Ji-Shawn/Bird-detection-classification-tracking/board/evidence/readme.md

# 当前版本上板证据

当前 SSD95 集成固件的整机实测日志尚待采集和核对。本目录保留采集要求；随包的离线测试、构建报告及模型资产哈希不能代替冷启动、实时采集、机械跟随和 SD 存图实测。本轮没有连接板卡或写入物理 SD 卡。

使用 [board/firmware/](../firmware/) 中的发布固件时，记录这套文件的指纹；使用自己重建的固件时，单独标识新版本。上板操作见[运行说明](../readme.md)，记录步骤见[复现第 9 节](../../reproduce.md)。

## 需要一起保存的记录

补交当前版本证据时，需要一起保存：

1. 测试时间、板卡型号、摄像头转接板版本、电源和 SD 卡信息；设备序列号可脱敏。
2. 实际使用的 BOOT、两核 ELF、bitstream、模型及输入文件的 SHA256。不要仅写“最新版”。
3. 运行命令、冷启动次数、每次运行时长、完整日志和异常记录。
4. 同一输入的实际输出与参考输出，包括比较口径、容差和未通过项；实际输出不能直接复制期望值。
5. 识别、实时预览、声音寻向、按键、SD 写图分别采用什么成功标准。没有编码器时，不把 PWM 指令变化写成实际机械速度。

运行时的临时日志通常位于 `build/out/board/`，默认不进入 Git。用于交付的结果应审核后选入本目录，以小写文件名保存，并在说明中注明它对应的固件版本和测试条件。
