Ji-Shawn/Bird-detection-classification-tracking/report/skill_extraction.md

# 技能包提炼过程与验证边界

**技能包提炼过程：从哪些失败或观察中总结、如何验证有效、边界如何确定。**

本技能包把历史排障记录整理为另一支团队可以使用的检查方法、提示词、记录模板和报告检查脚本。提炼的结果不是一份“所有项目必须照做”的硬件口诀：同一条历史经验必须先拆成观察、解释和适用条件，再决定保留、改写或不采纳。当前技能入口为 [skill/readme.md](../skill/readme.md)，使用入口为 [skill.md](../skill/zynq_pl_accel/skill.md)。

本次整理日期为 2026-11-03。报告审查脚本的 **16 项行为测试已实际通过**；随包历史实现报告重新检查后仍为 **`review_required`，30 项待审查**。这两项结果验证了已覆盖的报告检查行为，没有重新验证历史 HLS、RTL、DMA、计时器或板卡实验。本文不把旧文中的“数百次”“全部通过”“分钟级定位”等叙述改写为本轮统计结果。

当前随包证据包括用户补充材料、发布回执、发布版实现报告及最终检查结果。旧模型板测和独立 CRC 原型只保留方法回顾，不提供旧实验工程或重跑入口，也不计入当前系统验收。

## 1. 先说明材料来自哪里，以及能证明什么

### 1.1 历史材料与当前材料

| 代号 | 材料 | 本文如何使用 |
| --- | --- | --- |
| H1 | [历史技能提炼原文](../data/collaboration_sources/agent_skill_extraction.md)，原文件《技能包提炼过程.md》 | 保留当时提出的规则、失败描述和适用边界；逐条检查是否存在过度概括。引用章节号对应原文。 |
| H2 | [历史协作原文](../data/collaboration_sources/agent_collaboration.md)，原文件《大模型协作记录.md》 | 核对提示词摘要、模型动作、自我纠错和路线变化。原文自述协作期为 2026-09-24 至 09-27，并注明后续延续。 |
| H3 | [Word 补充材料提取正文](../data/collaboration_sources/docx_text.md)，P001–P066 | 与两份 Markdown 分别核对，不能视为同一稿。P040–P041 明确分层验证；P042 新增 CRC 原型的方法复用；P058–P060 明确反对过强结论，并区分历史 HLS 与现役实现。P 编号是提取定位符，不是 Word 页码。 |
| H4 | [历史交接摘录](../data/collaboration_sources/handover_excerpts.md)及[来源清单](../data/collaboration_sources/provenance.json) | 继续追查早期摘要是否遗漏撤回、特判和未完成项。摘录带原文件行号；交接中的叙述仍按叙述证据处理，不能自动升级为独立实测。 |
| A1 | [2026-10-27 timing 报告](../build/reports/pl_timing.rpt)、[CDC 报告](../build/reports/pl_cdc.rpt)及同目录 utilization、methodology、DRC | 直接核对报告里的数值、覆盖和告警；不能证明这些问题已经完成对象级处置。 |
| A2 | [协作报告](llm_collaboration.md)第 5 章的历史模型案例 | 回顾当时模型支线的比较口径；原运行日志不随最终包提供，按历史叙述使用，不能代替当前整机、冷启动或实时融合实测。 |
| A3 | [SSD95 发布修订回执](../build/receipts/release_validation.json)及[设计说明](../src/design.md) | 确认 0.95 是照片记录资格的 SSD 分数门槛，区别于准确率和追踪门槛。这是较晚需求，不属于 H1/H2 的早期实验。 |
| V1 | [技能自检回执](../sim/results/skill_selftest_20261103.json)和[完整自检输出](../sim/results/skill_selftest_20261103.txt) | 核对 Python 版本、命令、脚本哈希、16 项测试结果、零跳过以及未访问硬件的范围声明。 |
| V2 | [对历史报告的实际检查结果](../skill/zynq_pl_accel/examples/published_report_review.json) | 包含五份输入报告的路径、SHA256、元数据、指标和 30 项 findings；不是新的 Vivado 实现结果。 |
| V3 | [本轮完整离线检查回执](../sim/results/offline_checks_runner_new_full_20261103.json)、[37 项原生测试回执](../sim/results/native_gcc13_new_full_20261103.json) | 核对本轮已运行的交付检查和存图逻辑验证；其中确定性模型输入、模拟板卡接口、主机文件系统不能证明现场模型准确率或物理设备表现。 |

H1/H2 是当时的总结文档，包含对提示词和实验的转述，并非逐轮原始会话、全部波形和所有实验日志。两份文档出现相同数字，不能按两次独立实验累计。原文保留的错误结论属于历史记录，现行使用时以本报告的取舍和技能正文为准。

H3 的措辞更审慎，本文采纳其“现象—证据—措施—验证—边界”结构、分层验收和原型范围说明。H3 P063 中的黄金文件、DDR 地址、位宽和版本自动检查是完善方向；当前技能并未因此拥有这些全部自动化能力。H3 P066 所说“未修改原技能手册”描述该 Word 材料自身的范围；本轮则确实重写了比赛包中的技能，二者不能混为一份操作记录。

HLS 经验在本文作为早期开发历史出现。当前交付的神经网络计算引擎源码位于 `src/pl/capture_and_inference/hardware/`，参见[现役硬件导览](../src/pl/readme.md)；正式系统构建读取 `src/pl/structural/`。不能据历史 HLS 的循环限制断言当前全部部署模块采用 HLS，也不能将旧阶段号当作当前仓库必须恢复的根目录。

### 1.2 证据等级的使用方法

| 等级 | 定义 | 本文允许的表述 |
| --- | --- | --- |
| E0：待验证建议 | 只有新的检查方案或解释，尚无对应运行证据 | “应检查”“需要补测”，不写“已证明有效”。 |
| E1：历史叙述 | H1/H2 记载了实验和结论，本轮未获得足以复核该因果判断的完整原始材料 | “历史文档记载”，不写“本轮复现”。 |
| E2：可核对原始制品 | 可读取原始报告、日志或回执，并说明来源、对象和时间 | 可以复核其中明确记录的事实；不能扩大到未覆盖的版本、输入或环境。 |
| E3：本轮离线可重复验证 | 有本轮命令、输入身份、退出码和结果，可在对应环境再次执行 | 可报告所覆盖的软件、解析器或构建行为；必须写清是否涉及仿真、实现或硬件。 |
| E4：本轮对应对象的物理实测 | 当前待验版本与实际板卡、输入、输出和运行条件形成完整记录 | 本文的技能提炼与自检没有此项证据；不能用 E1/E2 历史材料补成 E4。 |

等级用于避免混淆来源，并非“等级越高就能证明任何事情”。例如，E3 的解析器测试不能解决 E2 报告里的 CDC 拓扑问题；带来源的历史板测日志仍然只支持其当时版本。

## 2. 18 项经验的选择、改写与不采纳

为便于定位，表内采用以下实际技能文件缩写：

- **C**：[历史案例与边界](../skill/zynq_pl_accel/references/casebook.md)。
- **N**：[数值与数据通路排障](../skill/zynq_pl_accel/references/numerical_debug.md)。
- **R**：[报告检查工作流](../skill/zynq_pl_accel/references/report_review.md)。
- **I**：[报告检查脚本](../skill/zynq_pl_accel/scripts/inspect_reports.py)；**S**：[行为测试脚本](../skill/zynq_pl_accel/scripts/test_inspect_reports.py)。
- **T**：[模型任务提示词](../skill/zynq_pl_accel/assets/task_prompt.md)；**V**：[验证记录模板](../skill/zynq_pl_accel/assets/validation_record.md)；**F**：[告警处置模板](../skill/zynq_pl_accel/assets/finding_disposition.md)。

表中的“落点”表示已经交付的通用方法所在文件，不表示这些文件包含完整的历史实验或自动检查了该行的一切风险。明确不采纳的专门断言没有另做成自动执行规则。

| 编号、历史来源与取舍 | 形成的现行规则 | 历史验证及等级 | 本轮实际核对或验证 | 适用范围与失效条件 | 实际技能落点 |
| --- | --- | --- | --- | --- | --- |
| 01 黄金对拍与零比较假绿。H1 §1、§3；C §4 保留旧手册的读取失败案例。**保留验证纪律，改写“任何情况只认逐字节零差异”。** | 先确认输入/参考成功读入、长度和比较数量正确，再按预先确定的数值契约比较。整数位精确目标可要求逐字节一致；其他目标必须明确误差规则，不能看到结果后放宽。 | H1 叙述单层及回归零差异；旧手册记载路径、文件读取和计数器问题，属 E1，不能仅凭总结确证所有历史比较器正确。 | 已交付 N 的读取、数量和参考独立性检查；V3 的比较器自检可核对。没有重跑旧 RTL 黄金文件读取故障。 | 适用于有独立参考的数值验证；参考与 actual 是同一份拷贝、比较数为零、参考来源不明时不得通过。 | N 步骤 1–3、6–7；T、V。 |
| 02 量化与延迟契约。H1 §2.3。**保留契约核对，不照搬舍入、零点或“201 拍”。** | 分别说明 dtype、布局、scale/zp、padding、舍入、饱和、尾块和流式延迟；用最小边界输入定位偏移。 | 原文记载 409600 B 对拍、逐层修正和特定 DW 延迟契约，属 E1；本文没有新增该组原始波形。 | 逐项纳入 N 和 V；本轮没有重做当时的 DW/PW 实验，也没有把这些常量用于报告解析器。 | 只适用于契约相同的算子和参考；更换量化域、stride、布局或流式结构必须重定契约。 | N 步骤 3、5–6；V。 |
| 03 “结构三定律”“流循环不许 PIPELINE”。H1 §2.2；H2 自我纠错 2、3。**撤回普遍禁令。** | 对当前工具与控制协议检查握手、状态保存、帧初始化和反压；纯计算或含流操作都不能仅凭类别宣布安全或不安全。检查实际综合行为，而非只看 pragma 文本。 | 原文先有流水失败，后有 B2' 通过，且承认环境污染归因；属 E1。它已足以要求收窄旧规则，但不足以推出所有流循环必失败。 | C §5 与技能入口明确删除统一禁用策略；N 给出单帧、连续帧、随机反压和尾块用例。未启动 HLS。 | 适用于流式模块排障；单帧恒定 TREADY 通过不能支持停顿/跨帧结论，换工具版本须重验。 | C §5；N 步骤 5、症状实验；T。 |
| 04 “cosim 绿就排除引擎”。H1 §2.4；H2 自我纠错 2；H3 P058。**不采纳二分判官。** | 记录仿真实际覆盖的输入、初始化、握手和运行长度；通过说明这些用例下的行为，既不能排除其他引擎问题，也不能直接归罪 harness。 | H1 已记录判官结论被推翻；H4 v2 原行 260–261 又撤回了板状态异常时的 S2MM 结构归因。均为 E1，不能选取早期 ILA 解释作已定根因。 | N 明确要求先验证测试平台有效性，再比对仿真与板卡条件；本轮无新的 cosim。 | 适用于仿真与实物不一致的排障；缺测试平台或覆盖信息时只能列待确认项。 | N“RTL 仿真全通过而板上不对”；V 的验证层级。 |
| 05 “WHS<0.05 ns 确定性错误”。H1 §2.4；H2 自我纠错 4。**不采纳固定物理失效阈值。** | 报告中的负余量/失败端点按实际结果判定；附加裕量策略须有任务依据。正余量不替代覆盖、环境与功能检查。 | “+0.017 ns 与错误同时出现”是 E1 的相关性叙述，缺少能排除其他变量的完整证据，不能写成已证明根因。 | A1 为 WHS=+0.005 ns；I 不按 0.05 判失败，S 明确测试该行为；报告仍因独立待审查项为 `review_required`。E2+E3。 | 适用于报告判读；不能反向声称该 +0.005 ns 构建已证实板上稳定，也不能跳过器件/接口约束审查。 | C §6；R 第二层；I、S。 |
| 06 “未约束表空就全绿”“单钟域免查 CDC”。H1 §2.4，结合 C §7 的旧手册表述。**改写。** | 从当前实现建立时钟和覆盖清单；区分内部未约束端点、I/O delay、例外与跨域对象，逐项处置。 | H1 记载早期未约束表为空，属 E1；A1 直接显示当前多时钟和实际 CDC 条目，属 E2。 | I 提取 no_input_delay=7、no_output_delay=11、partial_input_delay=4，以及 CDC Unsafe=1、Unknown=1；S 覆盖缺字段和 Unsafe。 | 当前实现报告有效时适用；只有摘要不能批准同步器拓扑或路径豁免。新时钟/接口/约束需新报告。 | C §1、§7；R；I、S、F。 |
| 07 “批处理自动连线绝无 stub”。H1 §2.1。**不采纳无风险保证。** | 不以 GUI 或脚本来源替代结果审查；对怀疑的连接检查当前生成 HDL、实际位宽、常量连接与设计预期。 | 原文记载手工断线生成常量连接、清理后捕获问题，属 E1；没有覆盖所有批处理路径的实验。 | 仅把“核对实际对象而非相信操作方式”纳入通用排障；未生成新 BD，也未声称当前工程存在 stub。 | 适用于连接或集成异常；缺生成产物时不能定位某条桩网，更不能只靠 GUI 截图放行。 | N 步骤 1、4；V；具体 stub 自动检查未交付。 |
| 08 DMA 寄存器与 64 位流。H1 §2.1、§2.5；H2 自我纠错 5。**保留实例核对，去掉通用常量与“永远”。** | 核对当前实例的存储器接口、流口位宽、长度、TLAST、状态和驱动契约；参数文本还须与生成连接一致。 | 原文记载只改 MM 宽后的补零及修正，属 E1；其中寄存器值和模式结论不能当作所有实例的通行证。 | C §8、N 步骤 4 提供检查清单；本轮没有写 DMA 寄存器或运行当时的 64 位改造。 | 适用于已明确模式、IP 版本和地址映射的实例；迁移 SG/simple、位宽或 IP 版本时须重新核对。 | C §8；N 步骤 4；V。 |
| 09 timer“永久禁区”与固定 tick。H1 §2.4、§2.5。**不采纳永久禁令，也不授予任意访问许可。** | 计时器的访问和标定按当前软件、配置及已验证入口处理；记录时钟、分频、计数回绕、测量区段和标定依据。 | 原文将寄存器写入与后续异常联系，称 POR 恢复；又记载本板 PMCCNTR 标定。属 E1，不能证明寄存器本身对所有用途永久有害，也不能把历史 tick 换算值直接用于新配置。 | C §6、§8 删除永久禁区迁移规则，N 要求计时方法和标定；本轮未访问计时器。 | 当前任务已明确计时配置时适用；换时钟、计数配置或计时范围后不能沿用旧换算值。 | C §6、§8；N“如何报告效果”；V。 |
| 10 JTAG 启动、DAP 恢复、收尾停 A9。H1 §2.1、§2.4。**保留状态管理，限制操作序列。** | 先识别当前固件/PS 初始化配对和运行状态，再使用当前验证入口；故障状态应先保存。文档不自动授权复位、下载或写外设。 | 原文声称固定顺序减少 wedge、某恢复链可救回，属 E1；没有本轮重复次数或通用成功率。 | C §8 和技能入口将具体步骤交还当前 board 工具；本轮技能脚本仅读文件，V1 明确未访问板卡。 | 仅对已确认的板卡、启动方式和脚本适用；SD/QSPI、不同软件或正在运行的应用不能照抄旧 JTAG 顺序。 | C §8；skill.md 执行约束；T、V。 |
| 11 “旧 bit 也错”与 DDR 数据污染。H2 排障 1–2、自我纠错 1；H1 §2.4。**保留判别实验，去掉“干净流程就可信”。** | 新旧版本对照前，同时确认输入、权重、缓存可见性、地址生命周期与初始化。失败位置随机不等于已经排除逻辑问题。 | 原文记载旧 bit 同错、DDR 字节异常、重灌后 62/62，通过情况属 E1；不能仅据摘要证明唯一根因。 | N 把“新旧固件都错”转成首个核对实验，V 记录环境；没有重新灌 DDR，也未复演历史事故。 | 适用于输入驻留内存或复用状态的流程；只有磁盘文件哈希不能证明运行时 DDR 内容相同。 | N 步骤 1、4、症状实验；C §8；V。 |
| 12 “ILA 只能作线索，不能作证据”。H1 §2.4；H2 自我纠错 2。**改写证据范围。** | 保存带 ILA 构建身份、探针、触发条件、波形及运行上下文；波形可作为该构建实际观测的证据。不能未经验证推到另一份不带 ILA 的构建。 | H1 记载“加 ILA 病就好”，H2 又引用 ILA 分析停收，均属 E1；二者说明需要记录观测条件，不支持否定所有 ILA 证据。 | 本轮没有采集波形；仅通过 V 的对象/环境/原始日志字段约束跨构建推断。不存在已交付的 ILA 自动诊断器。 | 能获得可追溯波形时适用；缺 bit/探针/触发信息时只能保留不完整观察，不能完成无 ILA 发布版验收。 | V；T；N 步骤 1、7。 |
| 13 “多维数组绝对不能推断存储”“1R1W 唯一安全”。H1 §2.5；H2 自我纠错 6。**不采纳语言级绝对结论。** | 对当前数组写法、访问端口、同步方式和工具设置做小规模综合对照，检查实际推断与资源；不只根据维数定论。 | 704K/1037/22K LUT 目前为两份摘要的 E1 叙述，未附对应原始综合报告。H4 v3 原行 91–94 对 339 DSP 的早期归因另有修正，不能沿用原说法。 | I 能读取当前完整顶层资源并检查显式预算，但没有综合任何数组变体；预算/顶层测试属 E3，不证明存储推断规则。 | 适用于资源异常定位；换访问模式、器件或工具后需重新综合。预算通过不等于 RAM 结构和功能正确。 | R 第二层；I 的显式预算；V 的单变量对照。 |
| 14 旧 IP、错误路径与“本机能跑”。H1 §2.2 export 陈旧产物；C §2–3。**保留身份与迁移检查，不照抄删除目录命令。** | 记录来源与输出身份，确认构建消费的是预期文件；从干净导出目录执行声明的检查，并记录编译器版本。 | H1 记载测到旧 IP，属 E1；C 记载 2026-11-02 缺协议向量/旧路径和 GCC 声明差异发现。 | V3 可核对当前修复后的检查；技能固定报告测试新增 SHA256 条件，复制到其他项目不会强套本工程资源数字。没有重新运行历史 HLS 导出。 | 适用于重构、打包、升级工具；只有时间戳或开发目录成功不够。危险清理操作须先确认具体对象。 | C §2–3；N 步骤 1；S 的发布样本身份判断；V。 |
| 15 “62/62 是唯一门禁”。H1 §3；H2 §3。**不采纳固定数量与唯一门禁。** | 根据任务分别列功能、数值、资源/时序、接口、启动与物理运行标准；历史 62 项仅证明其当时定义的用例。top1 相同与全输出相同必须分开。 | H4 v3 原行 73–74 记载 L24 允许 1 字节 tie；v5 原行 544 明示跳过 stem 和该特例。H1/H2 的“零差异”不能覆盖这些限定。A2 的非零差异及 SSD 比较仅作历史案例叙述，不是当前可复跑结果。 | V1 的 16 项与 V3 的原生/主机/比较器检查分开计数和解释；没有把离线通过作为整机发布签核。 | 适用于所有验收记录；测试数量不说明覆盖充分，跳过或零比较不能充成功项，特判须披露并说明依据。 | skill.md 证据层级；N；R 第四层；V。 |
| 16 固定“FSM 税”、性能预估与跨模型复用。H1 §2.5；H2 性能 7–10、工程组织 17–18。**保留实测驱动决策，拒绝迁移固定速度。** | 先记录测量区段、输入、预热、次数、统计和标定；预估写预估。结构相似或为复用而设计，不等于当前实现已经复用。 | ~17 拍/拍、~2.6 拍/拍、338→40–70 ms 等来自 E1 观察或预估。H2 本身曾明确否定“当前已复用”。A2 仅回顾特定历史分段计时，按 E1 使用。 | N、T、V 要求性能定义；本轮没有测新的时延、吞吐或复用效果，不将历史分段计时写成端到端帧率。 | 同一计时定义和环境下才可比较；模型、时钟、输入、传输或统计方法变更须重新标注。 | N“如何报告效果”；T 性能示例；V。 |
| 17 “95% 分数就是 95% 准确率”。来源为较晚的 A3，而非 H1/H2。**明确不采纳。** | 将判定门槛、单次模型分数、数据集准确率和物理表现分别报告；拍照资格以对应生产逻辑为准。 | A3 记载 SSD 分数≥0.95、追踪分数>0.5，且明示未板测，属 E2；不是准确率测量。 | V3 的 37 项原生测试含 5 项 FatFs 集成，证明给定确定性输入下的已测规则与写入流程，未使用标注测试集测准确率。 | 适用于模型结果和门槛展示；固定参考样本通过、高分或 top1 一致都不能推导总体准确率。 | N 使用前提；R 第四层；V 的指标与结论范围。 |
| 18 报告检查器也会假绿。来源为本轮独立审阅，见第 4 节。**新增并实际验证。** | 缺证据与未知格式返回 `incomplete`；表内不能只挑能识别的行。成功用例、破坏用例、真实样本与迁移用例分别验证。 | 无对应早期硬件实验；本轮先观察到真实解析缺陷，再形成规则，不伪装为历史经验。 | 合法 Info 后附未知 `Critical Warning` 原被忽略；修复后独立反例退出 3，新增 1 项含 3 个子例；16 项全通过，真实示例仍 30 项且 JSON 一致。E3。 | 仅对已支持的英文摘要格式；未知版本、空 CDC 摘要和未覆盖格式仍需人工适配，不自动放行。 | I、S；R 已验证效果；skill/readme.md 状态表。 |

## 3. 关键案例：如何把一次事故变成有边界的方法

### 3.1 流水失败：先撤回错误归因，再形成验证流程

H2 同时保留了“流水化后挂起”和后来的 B2' 通过记录。这是有价值的自我纠错材料，因为它没有把失败历史删掉。但“纯计算循环可流水、流操作不可流水”仍然超出这些有限实验所能证明的范围：原文没有给出所有流循环结构、初始化方式、连续帧和反压条件的穷举证据。本文因此没有把更窄的绝对禁令当作最后答案。

还需继续追到 H4：v2 原行 253–259 曾根据 ILA 将 S2MM 永久停收解释为结构问题，但原行 260–261 明确说明这些观测发生在板状态异常期，并撤回了当时归因。本文保留“观察到停收”和“后来撤回解释”两部分，不将前者包装为本轮已经确认的 DMA 或流流水根因；其后续“边际时序”解释也仍按第 3.2 节的证据边界处理。

提炼后的任务从“把 PIPELINE 都删掉”改成“明确一次握手接受了什么、哪些状态随之推进、停顿和帧切换如何保持契约”。对应的验证设计是单帧、连续帧、随机反压和末块用例，分别记录比较数量、次序和数值。它们是后续硬件任务需要执行的方案，不是本次已经执行的实验。方法已进入 N，旧错误归因仍保留在 H1/H2 和 C §5，便于后来者看到边界如何形成。

同理，原文“失败位置随机漂移，所以不是结构性 bug”的推断也应收窄。随机现象可以提高环境、状态或输入问题的调查优先级，不能仅凭随机性排除逻辑错误。合适的结果是一个区分假设的实验，而不是立刻确定唯一根因。

### 3.2 WHS=+0.017 ns：将因果结论降回待验证假设

H2 自我纠错 4 将确定性错误归因为边际 hold，并进一步提出 0.05 ns 门槛。现有原文没有提供足以独立复核的完整配对构建、路径、约束、运行条件和控制变量记录。因此本文只保留“应调查时序及实现变化”的动机，不接受“已排除逻辑、一定由 hold 导致”的结论。

当前可读的 A1 报告给出了另一组事实：WNS=+0.128 ns、WHS=+0.005 ns，内部未约束端点为 0，但仍有 7 个 no_input_delay、11 个 no_output_delay 和 4 个 partial_input_delay；CDC 仍有 Unsafe/Unknown 项。由这些事实可以得出“摘要数值为正，覆盖与跨域仍待审查”，不能得出“硬件一定错”，也不能得出“整机已经稳健”。

这一修正已经落成可运行反例：S 中 `test_positive_small_hold_is_not_an_invented_failure` 使用人工最小摘要，确认 +0.005 ns 不会仅因旧经验阈值被判失败；`test_positive_wns_does_not_hide_missing_constraints` 确认正 WNS 不掩盖缺失输入约束。人工摘要用于验证软件判定，A1 用于说明真实待办，两者不混用。

### 3.3 ILA、cosim 与数组推断：工具结果要绑定具体对象

三类旧结论的共同问题是把某个工具结果推广到工具本身：cosim 通过就排除引擎、加 ILA 后行为变化就否定 ILA 证据、某组数组推断失败就否定所有多维数组。这些结论均不进入现行技能的自动执行规则。

可复用的方法是绑定对象。仿真结果绑定测试平台和覆盖输入；ILA 波形绑定实际下载的带探针构建、触发和运行条件；综合结果绑定具体写法、访问模式、器件和工具设置。随后用对照实验判断差异。本次没有补做这三类硬件实验，所以其工程效果仍属于 E1 的历史记载，现行交付是 T/V 中要求记录对象、条件、原始输出及反例的方法。

### 3.4 62/62、top1 和 95%：三个数字回答不同问题

“62/62”描述一组历史测试的数量及其结果；“top1=11”描述一个输入的最高分索引；“0.95”是照片记录逻辑使用的 SSD 分数门槛。这些数字不能相互替代。

H4 v3 原行 73–74 披露 L24 存在 1 字节 tie，并由当时程序作 `bad<=1` 特判；v5 原行 544 又明确 62/62 沿用包含“跳过 stem”和该舍入特例的历史判定。这类结果应表述为“按当时判据通过”，不能重新整理成“所有层都执行、所有字节零差异”。本报告没有审定该特判适用于当前所有模型，迁移时必须重新定义并验证。

例如，A2 回顾的旧音频实验同时出现相同的 top1 和非零的逐字节比较差异。它用于说明两类判据的区别，旧日志不随最终包提供，不能把这个历史案例当作当前模型的数值验收。实际使用时，应保存完整输出及比较程序的判据，而不是只摘取分类索引。

SSD95 则是生产规则验证：当前 37 项原生测试包含阈值边界、资格状态和文件写入相关场景，其中 5 项执行 FatFs 集成。回执明确是确定性输入且未访问物理板卡；它们不能报告鸟类识别准确率。要回答准确率，需要另行定义有标签的评估数据、统计口径和真实评估结果；本文没有这份新增实测。

### 3.5 资源异常：检查后续更正，不能停在第一份总结

H2 性能主线第 10 项保留了 339 DSP 超编和共享 MAC 池的阶段性记录。H4 v2 原行 223–226 曾把额外 DSP 归因于组合加法链；v3 原行 91–94 改为记录操作数被扩为 32 位、每个相应乘法使用两个 DSP48，并记载窄位宽共享池后为 DSP 35、LUT 23K、BRAM 50。本文以此说明归因发生过变化，不将早期解释写入最终规则。

这些资源数字仍来自交接叙述，本轮没有重新获得并运行那几套原始综合对照。704K/1037/22K LUT 的数组案例也不能因为出现在 H1 和 H2 两处就变成独立复核。可迁移的规则是先检查实际操作数位宽、访问模式和综合映射，再设计对照；“多维数组不能推断”“整字 1R1W 是唯一安全形态”均不作为通用结论。

### 3.6 用户材料中的 CRC 方法迁移案例

[H3 的 P042](../data/collaboration_sources/docx_text.md)记载：后续 CRC 原型复用了黄金数据对拍、随机反压和独立资源评估方法，完成 3042 个数据包校验。本文按 **E1 历史叙述**引用这项材料；3042 是供稿中的包数，不是本轮仿真次数、视频帧数或板卡运行次数。最终包不包含该独立原型的实验工程、日志或向量重建入口，因此不把它列作当前随包可重跑的 E2/E3 实证。

这个案例保留的价值是说明“方法可以跨模块迁移”，而不是把原工程的参数和结论直接搬到新模块。结合 H3 P040–P041，可以形成下列后续验证要求：

| 可迁移的方法 | 新模块使用时需要补齐的验证 |
| --- | --- |
| 黄金数据对拍 | 说明参考算法、输入身份与比较范围，保留错误数及不匹配位置；不能以被测输出自行生成期望值 |
| 随机反压 | 检查停顿期间数据和状态是否保持，记录握手接受数量与结束条件；持续就绪场景不能代替反压测试 |
| 独立资源评估 | 将原型资源与整机接口、缓存、跨域及控制开销分别核算；综合通过不能代替完整实现和板测 |
| 分层验收 | 软件参考、RTL 仿真、综合、时序和物理运行分别出结论；某一层通过不补足其他层的缺项 |

这些是从供稿提炼的使用要求，不是对该 CRC 原型新增的测试结果。本轮没有把它集成到当前系统，也没有据此确认网络稳定性、帧率或板上性能。当前可直接执行、具有最终回执的技能验证是下一节的报告检查器与反例测试。

## 4. 本轮技能自身的验证：从 15 项通过到发现漏行

### 4.1 第一轮通过并不意味着检查器没有缺陷

最初的报告检查器已有 15 项测试，包括正余量、负余量、缺报告、缺覆盖、截断、非有限值、零检查端点、资源预算、设计名混用、CDC Unsafe、退出码和真实报告等情况。独立审阅随后构造了更具体的反例：同一 CDC 表先放一行合法 Info，再附一行不支持的严重级别。

```text
Info  clk_a  clk_b  Safely Timed  None  1  1  0  0  0
Critical Warning  clk_a  clk_b  User Ignored  False Path  1  0  1  0  0
```

旧实现只选择以已知 `Critical`、`Warning`、`Info` 加连续空格开头的行。第二行的 `Critical Warning` 没有命中这个筛选条件，整行被跳过；第一行又足以满足“至少解析到一行”。于是存在问题的输入得到 `screen_pass`。这个缺陷说明，“已经有反例测试”仍不等于“所有假绿路径已覆盖”。

### 4.2 修复并验证没有改变原有真实结果

修复后的 I 先匹配完整 CDC 表头，再读取数据区域；空行和分隔线可以略过，其余行必须符合已支持的列结构、严重级别和数字格式。任何未知行均产生带行号的 `incomplete`，不再通过“只读认识的行”得到绿色结论。对未知 `Critical Warning` 返回未完成，而不是擅自映射为另一个已支持严重级别。

新增的 `test_unknown_cdc_row_after_valid_info_is_incomplete` 含三个子例：未知组合严重级别、带缩进的未知严重级别和截断数据行。三个子例均在一行合法 Info 后追加异常，检查状态为 `incomplete`、退出码为 3、CDC 指标未被当作完整结果保留，并检查有明确 CDC 错误。它是 **1 个 unittest 测试方法、3 个子例**，因此总计为 **16 项**，不把子例混算为 18 项。

独立构造的原反例也用修复后脚本重新执行，结果为 `incomplete`，退出码 3，错误为 `Unsupported CDC row at line 8`。该次临时输出仅用于现场定位；持久交付的回归入口是 S 中的上述测试，不能依赖临时目录才能重现。

随后对 A1 的五份真实历史报告重新检查，输出与 V2 的 JSON 完全一致，仍为 `review_required`、30 项 findings。这个回归证明该修复保留了已知真实样本的原有提取结果；它没有关闭这 30 项审查任务。

### 4.3 迁移到另一项目时，不把旧工程资源数当成门槛

独立审阅还指出：如果另一支团队复制技能，目标项目也有 `build/reports/`，固定样本测试不应强制新项目等于 LUT 43722、DSP 164。当前 S 会先根据 V2 记录的各报告 SHA256 识别是否是原始发布样本。缺失或身份不同则明确跳过该固定样本断言，通用人工反例继续运行；新项目的报告应另用 I 审查。

这里“跳过”不是新项目通过，也不是本项目回归通过。当前原项目的 V1 记录为 16 项、0 跳过；迁移项目若跳过固定样本，测试输出必须如实保留 skip，不能把原项目数字用于新项目宣传。

### 4.4 可复制的验证命令与已归档结果

在仓库根目录、已安装 Python 的终端执行：

```powershell
python -B -X utf8 skill/zynq_pl_accel/scripts/test_inspect_reports.py
python -B -X utf8 skill/zynq_pl_accel/scripts/inspect_reports.py --reports build/reports --prefix pl_ --output build/out/skill_review.json
```

若按根目录复现文档创建了虚拟环境，可把命令开头的 `python` 替换为 `.\.venv\Scripts\python.exe`。第一条预期为 16 项测试通过、退出码 0；第二条对当前随包历史报告预期为 `review_required`、30 项、退出码 2。后者表示保留人工审查事项，并非要求使用者删除告警后再试。

V1 实际记录 Python 3.12.5、16 项、0 跳过、返回码 0，并保存 I/S 的 SHA256。时间为 UTC 2026-11-02 17:19，对应北京时间 2026-11-03 01:19；文件名中的日期按本地整理日期理解。回执同时明确 `board_accessed=false`、`physical_sd_card_accessed=false`、`vivado_started=false`。本报告引用这一回执，不另造硬件测试次数。

## 5. 提炼生命周期：如何让下一次反例进入技能

| 阶段 | 具体工作与产物 | 进入下一阶段的条件 |
| --- | --- | --- |
| 1. 收集 | 保存原失败输入、实际输出、命令、版本和操作者记录；原总结只作来源索引 | 能区分原始观察与作者解释；缺项先标明。 |
| 2. 拆分 | 将一句结论拆为“看到什么、怀疑什么、已经排除什么、还缺什么” | 不再用通过字样、单次 top1 或数值阈值代替因果证据。 |
| 3. 分级 | 标 E0–E4，标日期和对象；相同摘要不重复计作独立实验 | 每个声称的效果都能指到相应材料；不足的结论降级。 |
| 4. 选择 | 保留有用观察；改写可迁移方法；不采纳没有依据的普遍禁令 | 规则包含前提、成功判据、失效条件，不迁移未确认常量。 |
| 5. 最小验证 | 先跑原失败用例，再加最接近的通过例与破坏例；改变一个关键因素 | 缺文件、零比较、未知格式和错误值能按预期失败，不因放宽门槛获得通过。 |
| 6. 固化 | 简短入口放 skill.md；步骤放 references；重复机械工作进 scripts；记录结构进 assets | 新团队不依赖原开发机私有路径、未随包脚本或旧会话才能开始。 |
| 7. 独立审阅 | 让未参与实现的人按文档使用，尝试未知输入和新目录 | 实际反馈进入缺陷记录。本轮未知 CDC 行与固定样本迁移问题来自此环节。 |
| 8. 发布与再修订 | 更新测试、示例、文档和回执，保留旧误判及反例，不篡改旧实验日期 | 已知样本回归一致；新规则的边界和未覆盖项公开。发现新反例后回到第 2 阶段。 |

这种生命周期的有效性以实际缺陷闭环评价。本轮可以证明的是：独立审阅发现了一条原测试遗漏的假绿路径，修复后反例失败、已知样本不变、测试和说明同步更新。至于“节省几小时”“陌生团队必然一次成功”，目前没有对照记录或独立团队统计，不给出量化收益。

## 6. 当前交付的可复用能力与未测边界

已经可以直接使用的部分包括：以五份报告为输入的确定性摘要检查；有状态和退出码的结果 JSON；包含破坏输入的自检；数值排障检查顺序；给模型的具体任务模板；实验和告警的记录模板。这些文件不依赖安装某个智能体，普通读者也能按 [复现文档](../reproduce.md) 使用。文件保持小写英文；如果代理框架要求大写技能入口，只在仓库外的个人副本适配名称，不改变比赛包命名规则。

仍需明确保留以下边界：

1. **未知报告格式不放行。** 当前解析器主要验证随包英文 Vivado 2023.2 摘要。其他语言、版本、选项或没有 crossing 行的 CDC 摘要需要适配；`incomplete` 不能当作零问题。
2. **摘要无法证明来源完全配套。** 设计名一致和哈希稳定不等于五份报告必然来自同一 checkpoint。还需构建来源、源码、约束、bit/ELF 和实验记录配对。
3. **报告待办没有被模板关闭。** Unsafe、Unknown、I/O delay、方法学和 DRC 条目需要对象级证据；脚本没有全局忽略告警开关，也不能批准豁免。
4. **未新增旧硬件案例的复测。** 本次没有重跑 HLS、cosim、DDR/DAP 故障、计时器标定、ILA、数组综合或历史 62 项板测。相关经验保留其 E1/E2 身份。
5. **离线通过不推出整机效果。** 没有新增当前版本物理冷启动、长期稳定性、传感器融合、机械运动、物理 SD 卡时延或现场模型准确率结论。
6. **模板效果仍需按任务积累。** T/V/F 规定如何记录事实，未预置 PASS，也没有证明任何模型仅凭提示词即可稳定完成全部硬件任务。
7. **复用数字需重新定条件。** 0.05 ns、95.72 ns/tick、201 拍、62 项、某组资源数和性能预测都不能当作新项目默认验收常量。规则应复用检查方法和证据结构。

新团队提交一个后续案例时，至少附上原失败、原始材料、对象版本、唯一关键改动、复跑命令、实际结果、反例和适用边界。证据不足的案例可以进入历史观察区，但不能因为写成技能文档就自动升级为已验证规律。
