Ji-Shawn/Bird-detection-classification-tracking/report/compliance_review.md

# 交付规范复核与整改记录

复核日期：2026-11-03。依据为用户提供的目录、工程包、技能包及评分要求截图。复核对象是本目录中的交付内容；运行时工具缓存、`.git`、虚拟环境及 `build/out` 不属于导出的交付包。

## 1. 对照规范的结论

| 要求 | 本包提供的内容 | 复核结论与边界 |
| --- | --- | --- |
| 固定顶层框架 | `src/sim/build/board/data/skill/report`，根目录两份导航文档 | 框架保持，内部按功能而非 Mxx 阶段组织；历史代号仅用于追溯 |
| 英文小写路径 | 全包相对路径检查、清单库存核对、清单导出 ZIP | 文件名小写英文、数字、下划线/连字符，扩展名点号；`readme.md` 按小写规则处理；SD 卡上的固件要求文件名另行说明 |
| 完整设计输入 | 实际 ARM 源码及生成器、BSP/静态库、RTL/ROM、精确 IP 配置、板级约束 | 双核重编译和 PL 完整实现已实际执行；外部 Vivado/Vitis 安装不随包分发；模型训练数据/完整训练流水线不在本交付范围 |
| 仿真或验证结果 | 存图/FatFs、协议/上位机、上板工具模拟、比较器自测和原始日志 | 具体通过项见 [离线回执](../sim/results/offline_checks_20261103.json)；这些不是本轮完整 RTL 功能仿真，也不是新整机板测 |
| 可复现构建脚本 | `build_firmware.py`、`build_boot.py`、`build/pl/build_pl.tcl` | ARM/FSBL/BOOT 和 PL 已从源码构建；成功策略已进入交付脚本；生成物不自动覆盖发布固件 |
| 综合/实现与资源、时钟报告 | 原发布报告、10 月 31 日历史重建、11 月 3 日新构建 | [本轮完整报告](../build/reports/rebuild_20261103/readme.md)有综合及布局布线结果；时序门槛通过，CDC/I/O/方法学处置未全部关闭 |
| 上板运行和实测对照 | 发布固件、写卡/连接入口、10 月 2 日真实历史模型证据及 222 行逐层比较 | 历史证据有原始指纹且保留误差；**当前 SSD95 集成版的日志待用户提供并核对，不能宣称当前整机验收已完成** |
| 可复用技能包 | 范围/用法/失效条件、提示词、实验与告警模板、报告审查脚本 | [技能入口](../skill/readme.md)可独立使用；[16 项解析/反例测试](../sim/results/skill_selftest_20261103.json)和独立试用已执行；缺失/未知报告不会假绿 |
| 新手复现文档 | [reproduce.md](../reproduce.md) | 从安装、路径、环境、测试到写卡/连接/源码构建，每节给成功判据；已在新目录解压并用新 Python 环境跑通离线步骤，见[迁移回执](../sim/results/relocation_20261103.json)；硬件接法仍需与实际匹配，不猜接线 |
| 大模型协作记录 | [llm_collaboration.md](llm_collaboration.md) | 人机分工、关键决策、失败与纠正、实际验证、复用沉淀均附证据；不是完整聊天原文或虚构效率统计 |

## 2. 本轮已修复的问题

1. **缺少测试输入**：恢复原 7 个协议向量并补充 2 个 CRC 正确的异常分片，修正测试路径和库存断言；保留来源与 SHA256。
2. **新编译器声明冲突**：统一两个函数定义与头文件中的数组参数声明，原生 GCC 8.1/13.1 均通过 37 项存图测试。
3. **测试等待竞态**：等待真实组帧状态后再设置短过期窗口，避免“报文已计数但尚未组帧”导致偶发失败；针对性连续 5 次回归。
4. **只跑一部分却误读为全部通过**：增加完整离线检查入口，显式开发跳过模式标记为 `pass_partial`；最终完整运行标记为 `pass`。
5. **工具路径与链接回执**：统一 ARM/Vivado 工具查找，支持环境变量；识别链接器 map 中 `LOAD linker stubs` 的合成记录，其他输入仍严格核对。两核、FSBL 和 BOOT 实际构建并逐输入留证。
6. **成功 PL 策略藏在缓存目录**：将历史成功的 Explore/AggressiveExplore 指令加入正式构建；新增综合报告输出；在普通 Tcl 中核对按键同步器端点。
7. **生成文件污染根目录**：让 IP 生成过程在输出工作区运行；包检查忽略明确的工具缓存，ZIP 按完整清单导出，另拒绝未登记交付文件。
8. **技能陈旧和假绿边界**：移除“单钟域免查 CDC”等过度概括；未知 CDC 行返回 `incomplete`；移植自测只对哈希一致的固定样本作固定资源断言。
9. **参考值没有实际值比较入口**：增加带输入哈希和独立原始证据要求的数值比较器，检查完整 logits/检测框、缺失项和非法值。观察模板留空，避免伪装成实测。
10. **新手命令不完整**：统一虚拟环境用法，明确环境变量作用范围，修正 PowerShell 5.1 空参数传递，补齐解压后重建环境、写卡回读和版本选择说明。

## 3. 尚未关闭的事实缺口

- 当前集成版本的冷启动、持续运行、实际摄像头/HDMI/音频、机械跟随和 SD 存图日志待核验。用户已说明有日志、稍后提供路径。接收后应记录文件指纹、时间、固件与输入身份、测试条件和失败项。
- 新 PL 时序为正不等于完成工程签核。CDC 中的 1 个 Unknown、1 个 Unsafe，I/O 延时覆盖及方法学告警仍需按端点分析。没有足够板级条件时，不通过添加任意延时或 false path 使报告表面通过。
- 包内三个固定样本尚无本轮完整独立 logits/检测框输出。旧历史输入不同，不能改名复用成当前对拍。比较器自身通过不关闭此项。
- 本轮新编译 ELF/BOOT/bit 没有混入 `board/firmware`，也没有被写卡或下载；它们的硬件配对与现场验证另需完成。当前发布镜像哈希保持不变。

因此，本次交付结论是：文档、技能、构建可复现性和离线验证已显著补齐，当前版本整机实测与完整工程签核仍有明确待办。不能仅以材料存在或测试数量替代功能正确性证明。
