Ji-Shawn/Bird-detection-classification-tracking/data/collaboration_sources/agent_collaboration.md

# 大模型协作记录:提示词、模型回答、自我纠错轨迹

> 项目:音视双模态鸟类识别系统(Zynq-7020 PL 加速,MobileNetV2 int8)
> 协作期:2026-09-24 ~ 09-27(后续 session 延续,另见 v5.0 交接)
> 角色分工:**用户** = 方向决策、板子/电源等物理操作、GUI 配置、评审;
> **大模型(Kimi Code)** = 实验设计、排障、代码编写(HLS/RTL/C/Tcl)、构建执行、文档沉淀。
> 基本协议:对黄金向量逐字节对拍是铁律;每个阶段有可复现检查点;失败原地记录不删除。

## 1. 关键提示词 → 模型回答/动作对照

### 1.1 排障主线

| # | 用户提示词 | 模型动作与产出 | 结果与证据 |
|---|---|---|---|
| 1 | "读 HANDOVER_vivado_v2.0.md,继续完成项目" | 读交接与 SKILL 手册,从 §5e 未决问题 1(多瓦片 PW 挂)接手;给 main.c 加诊断快照(锁定失败瓦片/阶段/DMA 寄存器),建带 DAP 自愈的快速驱动 | 发现失败位置/瓦片**随机漂移** → 判定非确定性;L02 单瓦片 ×5 出现"挂/全错/过"混合 → 不是多瓦片特有 |
| 2 | (同上 语境) | A/B 对照:09-22 已知好 bit(m54ila)跑同层 → **同样失败** → 转向环境嫌疑;抽查 DDR 发现单字节被改(数据腐烂) | **证伪"多瓦片 bug"**:全量重灌后旧 bit 62/62 全绿。真凶 = DDR 数据腐烂 + DAP wedge 伪装 |
| 3 | "可以修改当前策略" / "修改完成策略就执行" | 授权后决定:放弃逐案排查,把引擎像素阶段回退到保守融合结构(读写算一体、全顺序、无 PIPELINE) | **62/62 零差异 + 链式 top1=11 正确**,基线 1020ms |
| 4 | "继续排查 M5.5 问题" | 逐步恢复流水化(B2':仅 MAC 循环 II=1),先建 L02 判别实验,再做 100MHz vs 降频 25MHz 的边际时序判别开关(SLCR 改分频,免重出 bit) | B2' 62/62 全绿 @100MHz,**"流水即毒"被证伪**(此前失败全是板子劣化),提速至 464ms |
| 5 | "我重新配置了 PS 端外设配置,之前配错了" | 从 GUI journal 还原修改内容(ENET/QSPI/USB MIO 引脚),确认与 PL 数据通路无关;发现 `ps7_init.tcl` 自 09-20 起是旧版,重新导出 XSA 并同步 4 处 | 新配置下回归 62/62;用户修改不涉及此前的排障结论 |

### 1.2 性能优化主线

| # | 用户提示词 | 模型动作与产出 | 结果与证据 |
|---|---|---|---|
| 6 | "继续"(性能收口) | 64 位流加宽(HWC8):引擎/驱动/BD/main.c 成套改 | 发现并修复 **DMA 流口位宽是独立参数**(只改 MM 宽 → 引擎被静默补零)——查 system.v 线宽抓到;64 位版 62/62 + top1,**345.8ms** |
| 7 | "继续" | 瓶颈分解:逐层计时 → L03 占 17.8%;requant 挪入流水(perf2) | 仅 +2%(338ms) → **真瓶颈定位 = HLS 顺序循环每像素 ~400 拍 FSM 开销**,性能墙在语言层 |
| 8 | "为什么不用 HDL 语言写 DW 和 PW 卷积层" | 分析利弊:HLS 的税(FSM 开销/流水化毒性/不可读)vs 手写 RTL 的成本(契约风险/验证平移);给出"只重写两个数据通路、契约不变"的方案与预估(338→~40-70ms) | 用户拍板 |
| 9 | "开工" | 手写 PW RTL + xsim 对拍(全部 34 层)→ DW RTL(17 层)→ 双模式 wrapper | **PW 34/34、DW 17/17 全部零差异** |
| 10 | "继续" | 集成进 BD:连拆三雷(module ref 不许 .sv / 1Mbit 单变量上限 / 异步读大数组 mux 爆炸 704K LUT) | 确立"宽字整字访问 + 1R1W"存储纪律;LUT 降到 22K 达标,**剩 DSP 超编 339>220**(两核重复布局,需共享 MAC 池) |

### 1.3 工程组织类

| # | 用户提示词 | 模型动作与产出 |
|---|---|---|
| 11 | "将相关 md 和 skill 复制到工作目录" | 复制三本交接 + SKILL.md 到 D:\Xilinx\workspace,并说明"以仓库为准还是工作区为准"的双向同步建议 |
| 12 | "是否可以删除 LED/PLL/birds_detection" | 先查证(无引用、LED 936MB 几乎全是可重建构建产物、birds_detection 是空壳),给出分级删除建议,不擅动 |
| 13 | 三篇 FPGA 实战文链接 | 提炼:未约束路径检查(当场验证本工程干净)、ILA 改变布局的读数修正、HWC8 数据格式佐证、片上乒乓特征缓存方向 |
| 14 | 三个 GitHub 链接(装 MCP/skill) | 装 vivado-mcp / vitis_mcp / xilinx-suite;处理 mcp<2 依赖隔离(独立 venv);写入用户级 mcp.json 并冒烟验证 |
| 15 | "我要新开一个会话,写好交接文档,目标是尽可能不用 HLS,全部用 HDL" | 写 HANDOVER v3.0(全 HDL 路线、资产清单、DSP 卡点与方案、上板前自查清单),更新 AGENTS.md 索引并双向同步 |
| 16 | "将 AGENTS.md 等关键 md 转移到 D:\Xilinx\workspace" | 转移 + 加迁移说明头;skill 另存到 `.kimi-code/skills/`(自动扫描位) |
| 17 | "音频网络与视觉网络部署到 fpga 是否可以复用" | 读视觉网结构(SmallBirdCNN)后给出算子对照表:基建/引擎框架 100% 可复用,缺一个 STD 3×3(恰好音频 L00 也欠);指出检测器 SSDLite 骨干 MobileNetV3 同样是 PW/DW 为主 |
| 18 | "当前状态是否是复用的" | 如实否定:demo 三模型全在 PC(torch),视觉网连量化都没做;目前是"为复用而设计、实现上未复用" |
| 19 | "总结技能包的提炼过程"(设计报告) | 按"来源失败 → 规则 → 验证方式 → 边界"四维整理全部 21+ 条,落盘 `技能包提炼过程.md` |

## 2. 自我纠错轨迹(按时间序,含原始误判与翻盘证据)

**纠错 1:"多瓦片 PW 第 2 帧挂"——误判为引擎 bug,实为环境伪装**
- 初始假设(交接文档):引擎多瓦片帧重启缺陷。
- 纠错动作:诊断快照 → 失败位置随机漂移;单瓦片 L02 连跑 5 次出现"挂/全错/过"三种结局 → 排除结构性 bug;A/B 对照旧 bit 同样失败;**抽查 DDR 抓到单字节篡改**。
- 修正结论:非引擎问题 = DDR 数据腐烂 + DAP wedge。**经验:判案第一实验永远是"已知好 bit + 新灌数据"。**

**纠错 2:"装载循环 PIPELINE off 是元凶"——抓了真凶的替身**
- 证据链:撤除 PIPELINE off 后 HLS 自动流水化 6 循环(214-376),装回仍挂 → 自首条判断正确但非主因。
- ILA 波形:引擎寄存器全对、守协议背压,**S2MM 中途永久停收**(DMASR 无错) → 引擎是受害者。
- 好/坏引擎对照捕获:beat 稀疏模式相同 → 排除 beat 稀疏;最终靠**结构回退(保守融合)通过全部回归**。**经验:cosim 绿不等于上板能跑;流时序类 bug 只有 ILA 和上板能判。**

**纠错 3:"流水化循环有毒"——被板子劣化污染的错误归因**
- Step B/B2(流水化 MAC)挂 → 暂定"流水即毒"。
- 用户断电 POR 后重测:B2' **62/62 全绿 @100MHz** → 证伪。真实规则收窄为:**流操作不可入流水循环,纯计算循环可流水**。
- **经验:环境(板子健康度)本身是变量;劣化期的所有失败归因都要 POR 后复测。**

**纠错 4:"perf 版确定性错数据是逻辑 bug"——实为边际 hold 时序**
- 现象:全流水版不挂了,但同位置确定性错(maxd=255,L01 DW 也错——而 DW 源没动)。
- 排除逻辑后查构建:该版 **WHS=+0.017ns** → 判为边际保持时间问题,与逻辑无关。
- **经验:WHS <0.05ns 的构建不可信;先看时序报告再怀疑代码。**

**纠错 5:64 位化"改 MM 宽就够"——被静默补零打脸**
- 只设 `c_m_axi_*_data_width=64`,集成后引擎 TDATA 被自动补零(`{32{1'b0},...}`),HDL 自检照不到。
- 补设流口位宽参数后,检查 system.v 线宽 [63:0] 才放行。
- **经验:集成后必须查生成网表的实际线宽,不查会死得无声无息。**

**纠错 6:手写 RTL "异步读大数组无所谓"——704K LUT 学费**
- 组合块 72 个异步读口 → 读 mux 爆炸(超编 13 倍)。
- 独立综合三个变体对照:2D 数组(1037 LUT mux)/ 1D+distributed(RAMD64E ✓)/ 宽字整字访问(最终形态)。
- **经验:每拍整字读写、1R1W 是唯一安全形态;多维 unpacked 数组不推断存储。**

## 3. 智能体工作流设计(模型侧)

```
读交接 → 恢复现场(bit/ELF/板状态核验)→ TodoList 阶段化
→ 判别实验优先(最小可复现、单变量对照)→ 后台长任务(构建/回归并行)
→ 证据链写入交接(含被推翻结论的原文与反例)→ SKILL.md 沉淀通用规则
```

关键设计点:
- **黄金回归作为唯一门禁**:62 项零差异 + 链式 top1,任何中间结论以它为准;
- **对照纪律**:A/B bit、单瓦片 vs 多瓦片、100MHz vs 降频、带不带 ILA——每次只动一个变量;
- **长任务后台化**:Vivado/HLS 构建挂后台,期间做分析、写 TB、改文档,时间并轨;
- **诊断先行**:给 main.c 加诊断快照(失败时锁定瓦片/阶段/寄存器),再开始改任何东西;
- **反例保留**:被推翻的结论不删除,标注"已被 §5g 推翻"——技能的边界靠反例划出来;
- **交接即产品**:每次 session 结束更新 HANDOVER + SKILL + 备份锚点(ELF/bit/源),下一位可直接续跑。

## 4. 协作效率观察(给后来者)

1. **用户拍板节点精准**:"可以修改策略"出现在模型连撞三面墙之后,避免了继续在错误归因上空耗——方向级授权比逐条指令高效。
2. **物理操作不可替代**:POR、GUI 配置由用户完成,模型负责把"为什么、做完后跑什么验证"说清楚,衔接顺畅。
3. **模型的弱点也在暴露**:对寄存器级细节(AXI DMA 流口位宽、SLCR 分频字段)要靠试错补齐——用户评审过一遍的方案里仍有被工具"静默行为"打脸的情况,全部靠生成网表/ILA/对拍兜底才没酿成事故。
4. **文档是协作的复利**:SKILL.md 的每条规则都来自当日事故,后续同类问题(如 DAP wedge、数据腐烂)的定位时间从数小时降到分钟级。
