Ji-Shawn/Bird-detection-classification-tracking/data/collaboration_sources/docx_text.md

# 用户提供的 Word 补充材料正文提取

原文件保留在用户桌面。本页按 document.xml 的正文顺序提取全部非空段落，包括表格单元格文字；P 编号为本次提取定位符，不是原 Word 页码。本文属于来源材料，当前采纳与修正结论见上级报告。

**P001**

技能包的提炼过程

**P002**

鸟类声视识别与双轴云台追踪系统  设计报告补充材料

**P003**

整理日期  2026年11月3日

**P004**

本项目以 Zynq PL 加速开发实战手册为技能包的主要载体，将 AX7020 开发中的失败案例、修复方法和验证步骤整理为可复用知识。提炼过程强调证据与适用边界：已验证经验用于指导后续任务，特定环境下的判断不能直接推广为通用规律。

**P005**

一 从失败和观察中提取经验

**P006**

技能包最初围绕 M1 数据通路和 M5 算子开发阶段的排障形成，随后补充 M6 手写 RTL 阶段的经验。每条经验按“现象—排查证据—原因—修复措施—验证方法—适用范围”组织，避免只保留结论而丢失判断依据。

**P007**

失败或观察

**P008**

提炼出的规则

**P009**

验证方法

**P010**

仿真显示通过，但黄金文件未正确读入，未完成有效比较。

**P011**

先验证测试平台本身，不能只看 PASS 字样。

**P012**

检查文件打开、读取数量、未知值和实际比较次数。

**P013**

DMA 内存侧改为64位，流接口仍为32位。

**P014**

内存侧与流接口位宽必须分别核对。

**P015**

检查IP参数、生成HDL与实际数据通路。

**P016**

多层测试交替出错，最终发现权重与期望数据地址重叠。

**P017**

排查时同时检查测试程序和DDR地址布局。

**P018**

检查地址区间，重灌数据，用已知正确版本对照。

**P019**

持续就绪时通过，输出停顿后出现跳字。

**P020**

反压期间必须保持流水数据和控制状态。

**P021**

加入随机反压，检查输出稳定性、顺序和数量。

**P022**

修改RTL后，构建仍可能复用旧缓存。

**P023**

源码修改不等于新逻辑已进入bit。

**P024**

核对源码特征、网表、缓存产物与构建记录。

**P025**

时序报告看似通过，但可能存在未约束路径。

**P026**

时序验收必须包含约束覆盖检查。

**P027**

同时检查setup、hold和未约束内部端点。

**P028**

这些案例将排查范围从算法和RTL扩展到测试平台、接口配置、DDR内容、构建缓存和板上状态，减少因症状相似造成的错误归因。

**P029**

二 将调试经验转化为可执行流程

**P030**

技能提炼不仅记录问题，还要说明何时使用、需要哪些输入、按什么顺序检查，以及如何判定成功。项目将重复出现的工作整理为以下流程。

**P031**

数值验证流程

**P032**

准备黄金输入、权重、偏置和期望输出；核对量化零点、符号位、舍入与字节序；逐层比较结果，记录错误数量、最大偏差和首个错误位置。避免仅凭输出“看起来合理”判断正确。

**P033**

接口与集成检查流程

**P034**

核对AXI位宽、地址映射、传输长度和包尾标志，检查生成HDL中的异常常量连接。接口参数改变后，重新确认驱动寄存器偏移和数据布局，不能默认旧软件仍兼容。

**P035**

流水线验证流程

**P036**

覆盖连续输入、随机停顿、尾部不足一组、多帧连续运行和复位。对数据与控制信号进行同步检查，确认停顿恢复后不丢字、不重复、不乱序。

**P037**

构建追溯与故障恢复流程

**P038**

将关键源码、生成网表、bit、软件与测试报告关联。故障后按当前工程已验证的恢复脚本恢复环境，重新加载数据，再用已知正确基线对照。初始化顺序和外设配置不能由早期命令片段随意拼接。

**P039**

三 技能有效性的验证方法

**P040**

有效性首先体现在能否复现原故障。修复流水线丢字后，必须保留反压场景验证；不能只运行持续就绪的简单测试。其次，需要在相同输入和配置下比较修改前后结果，尽量避免同时改变多个因素。

**P041**

验证按层级推进：先确认软件模型和黄金数据，再检查RTL仿真、综合结构与资源，随后验收整机时序，最后进行重复板测。各层测试的结论不能相互替代，局部通过不等于端到端可靠。

**P042**

后续CRC原型复用了黄金数据对拍、随机反压和独立资源评估方法，完成3042个数据包校验。这是验证方法被再次使用的实例，但只支持原型层面的结论，不能替代整机集成、网络稳定性和帧率测试。

**P043**

四 适用边界的确定

**P044**

技能包应区分可迁移原则、平台配置和特定故障经验。迁移到新板卡、工具版本或模块时，先核对成立条件，再决定哪些条目可以直接复用。

**P045**

类型

**P046**

示例

**P047**

使用边界

**P048**

可迁移的验证原则

**P049**

黄金数据对拍、随机反压、版本追溯。

**P050**

可用于其他工程，但需要适配接口、数据格式和测试覆盖。

**P051**

平台相关规则

**P052**

AX7020的PS初始化、DDR、UART和DMA配置。

**P053**

更换板卡、工具版本或外设配置后重新核验。

**P054**

特定故障经验

**P055**

某种HLS循环结构异常，或特定时序余量下发生错误。

**P056**

保留工具版本、结构和实验条件，不推广为普遍定律。

**P057**

对历史表述进行再审查

**P058**

现有手册中“cosim通过就能证明RTL无辜”一类表述过强。更准确的结论是：已覆盖的仿真场景通过，但仍不能排除真实硬件中的时序、复位和接口问题。“禁止某类循环流水化”也应限定为当时工具版本及设计结构下的规避措施，而非HLS的通用禁令。

**P059**

区分历史探索与现役实现

**P060**

手册保留早期HLS探索经验，不代表当前部署模块全部采用HLS。报告中应分别说明历史开发路线和现役实现，避免把探索阶段的工具或限制误写成当前工程事实。

**P061**

五 提炼结果与后续完善方向

**P062**

目前已形成以SKILL.md为入口的项目实战手册，覆盖数据通路、数值契约、验证方法、资源优化及故障排查。它为大模型和开发人员提供共同的检查依据，使新任务能够优先复用已知经验，减少重复试错。

**P063**

后续可将仍依赖人工执行的条目转化为黄金文件有效性检查、DDR地址重叠检查、AXI位宽核对和构建版本校验脚本，并为经验条目补充适用版本、原始证据及失效条件。这些属于完善方向，不能视为已经全部自动化。

**P064**

技能包的价值不在于规则数量，而在于每条规则都有可追溯来源、可执行检查和明确边界。新实验否定原判断时，应修订经验，避免将阶段性结论固化为不可质疑的规则。

**P065**

材料依据

**P066**

项目文件：D:/Xilinx/workspace/skills/zynq-pl-accel/SKILL.md；本次对话中的故障排查、板测反馈与CRC原型验证记录。本文为经验总结，不代表整理日重新完成整机复测，也未修改原技能手册。
