Ji-Shawn/Bird-detection-classification-tracking/skill/zynq_pl_accel/assets/finding_disposition.md

# 告警或缺项处置模板

状态：未关闭。本模板不自动批准豁免。

| 字段 | 实际记录 |
| --- | --- |
| 规则/问题编号、严重性 | 待填写 |
| 原报告路径、SHA256、日期、工具版本 | 待填写 |
| 当前源码、实现、bit/ELF 对应关系 | 待填写 |
| 起点/终点、源/目的时钟、相关端口或模块 | 待填写 |
| 原始报告内容与可定位行号 | 待填写 |
| 对象级原因分析 | 待填写；只有汇总时写“证据不足” |
| 处置选择 | 修复 / 有依据的豁免 / 继续调查 |
| 修改内容或豁免依据 | 待填写 |
| 新报告/功能验证结果 | 未执行 |
| 剩余风险和失效条件 | 待填写 |
| 审核者与日期 | 待填写 |
| 最终状态 | 未关闭 |

关闭前检查：对象与版本一致；证据足以支持具体处置；没有通过删除告警、清空测试或统一放宽约束制造通过；涉及修改时已运行必要的回归；结论限定在实际验证范围内。
