Ji-Shawn/Bird-detection-classification-tracking/skill/zynq_pl_accel/references/casebook.md

# 案例与适用边界

本文件保留项目协作中能迁移的方法，同时纠正旧手册中把局部观察写成普遍规律的表述。“历史记录”表示原开发笔记记载的观察，本次没有凭该笔记补造原始日志，也没有把这些观察当作现役整机复测。

## 1. “时序全绿”与约束覆盖是两个问题

- **来源与已观察事实**：随包 `build/reports/pl_timing.rpt` 为 2026-10-27 的发布实现报告。WNS=0.128 ns、WHS=0.005 ns；no_input_delay=7、no_output_delay=11、partial_input_delay=4。`pl_cdc.rpt` 同时存在 Unsafe/Unknown 项。
- **适用场景**：报告摘要说约束满足，但需要判断签核范围。
- **方法**：先检查报告时间、设计和分析状态，再检查 coverage、CDC、methodology、DRC，保留对象级待办。运行报告检查脚本可机械提取这些字段。
- **成功判据**：所有检查对象、例外、待审查项有据可查；结论明确区分“摘要指标满足”和“问题已处置”。
- **失效边界**：没有实际路径/网表时不能仅凭汇总给出 CDC 根因或豁免。

## 2. 目录改名后，应用能启动但完整测试仍会失败

- **来源与已观察事实**：2026-11-02 干净导出审查中，上位机帮助入口可运行，但完整 pytest 结果为 376 项通过、1 项失败；`src/pc/tests/test_protocol.py` 仍从旧相对位置找协议黄金向量，所需向量也未随包提交。
- **适用场景**：重构目录、打包交付、把开发环境迁到新机器。
- **方法**：从实际提交内容导出到全新目录，安装声明的依赖，再执行完整受影响测试。同时核对测试数据文件和路径；只修路径而不补数据不会完成修复。
- **成功判据**：新目录中的目标测试通过，且没有借用原工作区中的未提交文件。
- **失效边界**：在开发目录已有缓存或数据时通过的结果，不能单独证明交付包自包含。
- **本轮修复结果**：以本包后续 `sim/results/` 中的运行记录为准；本条保留的是发现问题时的失败结果，不把它改写为一直通过。

## 3. 新编译器暴露的接口声明差异

- **来源与已观察事实**：2026-11-02 存图测试在 MinGW GCC 8.1 下通过；GCC 13.1 在 `-Werror` 下因 `ssd_fast.c` 中指针参数与头文件数组形参写法不一致而失败。
- **适用场景**：验证脚本声称支持一般 GCC，实际仅在一个旧版本运行过。
- **方法**：保存编译器版本和完整命令，统一声明与定义，再复跑原编译器和发现问题的编译器。不要为通过而直接移除全局 `-Werror`。
- **成功判据**：目标工具版本均可编译且测试通过；说明文件写出实际验证过的版本。
- **失效边界**：两个版本通过不等于所有平台、所有版本都得到支持。

## 4. 黄金读取失败造成“零比较通过”

- **历史来源**：整理前手册记录过字符串路径带前导 NUL、黄金文件打开失败、比较计数器未初始化等测试平台问题；原始完整实验不在本技能附件中，本轮不把旧通过次数作为验收证据。
- **适用场景**：RTL 仿真异常快速结束，或更换为明显错误输入仍显示通过。
- **方法**：文件打开失败立即失败；检查读入数量和已知样本；检查输出 X/Z；结束时要求比较数量等于预期。增加一组故意损坏的参考数据，确认比较器会失败。
- **成功判据**：有效输入按预期比较；无效或缺失输入明确失败。
- **失效边界**：比较器正确不等于待测算法正确，参考结果仍需独立来源。

## 5. 流水与反压必须按实际协议验证

- **历史来源**：旧手册曾把局部失败总结为“流操作不许进 PIPELINE 循环”，也记载了停顿时计数器冻结而数据管线继续推进导致跳字的观察。
- **现行修正**：不再采用统一禁用 PIPELINE 的规则。需要查看当前控制协议、状态保存、握手、初始化、工具版本及跨帧行为，用单帧、连续帧和随机反压分别验证。
- **成功判据**：每个已接收输入与应输出结果数量、次序和数值一致，跨帧无污染；必要资源/时序指标有相应报告。
- **失效边界**：只在恒定 TREADY 或单帧用例上通过，无法支持跨帧与停顿结论；HLS 工具升级后应重跑相关用例。

## 6. 经验阈值不能代替器件约束

- **历史来源**：旧手册出现“WHS<0.05 ns 会确定性出错”表述，以及某些特定构建的计时器偏差观察。
- **现行修正**：没有将该阈值作为自动失败条件。当前随包报告 WHS=0.005 ns，只能说明当前报告的 hold 摘要值为正；板卡是否稳健需要相应实验。计时器也需按当前配置标定。
- **成功判据**：阈值来自任务要求或明确的工程裕量策略，且记录其依据；性能数字附计时方法和测试条件。
- **失效边界**：不能把一次板卡异常与某个余量值的相关性写成所有设计的因果定律。

## 7. 单时钟案例不能直接套到音视频整机

- **历史来源**：旧手册的早期 DMA/算子案例采用简化时钟结构，后来仍沿用了“本工程单钟域，免查 CDC”。
- **现行证据**：本包 `build/reports/pl_clocks.tsv` 包含摄像头、音频和多路 HDMI 时钟。`pl_cdc.rpt` 列出实际跨域关系。
- **方法与成功判据**：从本次实现报告建立时钟关系表，并逐条审查跨域结构和对应约束。写明同步器、FIFO、握手或静态信号的证据。
- **失效边界**：端口名、注释或旧框图不能证明当前实现为单时钟。

## 8. 复位、地址和 DMA 参数只按当前实例使用

- **历史来源**：旧手册包含 DAP 卡死、DDR 邮箱污染、地址区间覆盖、DMA 长度和位宽不匹配等观察。
- **方法**：复用当前已验证的 `board/tools/` 入口；实验前列出固件配对关系、活动地址区间和硬件实例配置。异常后重新确认输入与权重实际内容，并保存错误状态。
- **成功判据**：按当前实例的数据宽度、长度、TLAST、超时与缓存契约完成指定实验，记录实际输出。
- **失效边界**：不得把案例中的地址、DMA 长度上限、具体复位/下载序列或“永远禁止某寄存器”的绝对说法迁移到未确认的新系统。手册本身不授权操作板卡。

## 尚需由实际任务提供的内容

新团队应提供自己的参考生成器、数据格式、工具版本、构建/上板权限、实测环境和验收阈值。本技能不再依赖旧文中未随包提供的 `scripts/extract_golden_layers_v1.0.py`；需要抽层时应先交付并验证真实的参考生成工具，缺少时将该验证项标为未完成。
