Ji-Shawn/Bird-detection-classification-tracking/build/reports/pl_clocks.tsv

av_system_i/clk_audio/inst/clk_in1 | 10.000 | 0.000 5.000 | 1 | clk_fpga_0
av_system_i/clk_hdmi/inst/clk_in1 | 10.000 | 0.000 5.000 | 1 | clk_fpga_0
cam_pclk | 11.904 | 0.000 5.952 | 0
clk_fpga_0 | 10.000 | 0.000 5.000 | 0
clk_out1_av_system_clk_audio_0 | 10.172 | 0.000 5.086 | 1 | av_system_i/clk_audio/inst/clk_in1
clk_out1_av_system_clk_hdmi_0_1 | 8.696 | 0.000 4.348 | 1 | av_system_i/clk_hdmi/inst/clk_in1
clk_out2_av_system_clk_hdmi_0_1 | 1.739 | 0.000 0.870 | 1 | av_system_i/clk_hdmi/inst/clk_in1
clk_out3_av_system_clk_hdmi_0_1 | 6.957 | 0.000 3.478 | 1 | av_system_i/clk_hdmi/inst/clk_in1
clkfbout_av_system_clk_audio_0 | 10.000 | 0.000 5.000 | 1 | av_system_i/clk_audio/inst/clk_in1
clkfbout_av_system_clk_hdmi_0_1 | 10.000 | 0.000 5.000 | 1 | av_system_i/clk_hdmi/inst/clk_in1
