Ji-Shawn/Bird-detection-classification-tracking/build/reports/pl_pins.tsv

DDR_addr[0] | INOUT | N2 | SSTL15
DDR_addr[10] | INOUT | F5 | SSTL15
DDR_addr[11] | INOUT | G4 | SSTL15
DDR_addr[12] | INOUT | E4 | SSTL15
DDR_addr[13] | INOUT | D4 | SSTL15
DDR_addr[14] | INOUT | F4 | SSTL15
DDR_addr[1] | INOUT | K2 | SSTL15
DDR_addr[2] | INOUT | M3 | SSTL15
DDR_addr[3] | INOUT | K3 | SSTL15
DDR_addr[4] | INOUT | M4 | SSTL15
DDR_addr[5] | INOUT | L1 | SSTL15
DDR_addr[6] | INOUT | L4 | SSTL15
DDR_addr[7] | INOUT | K4 | SSTL15
DDR_addr[8] | INOUT | K1 | SSTL15
DDR_addr[9] | INOUT | J4 | SSTL15
DDR_ba[0] | INOUT | L5 | SSTL15
DDR_ba[1] | INOUT | R4 | SSTL15
DDR_ba[2] | INOUT | J5 | SSTL15
DDR_cas_n | INOUT | P5 | SSTL15
DDR_ck_n | INOUT | M2 | DIFF_SSTL15
DDR_ck_p | INOUT | L2 | DIFF_SSTL15
DDR_cke | INOUT | N3 | SSTL15
DDR_cs_n | INOUT | N1 | SSTL15
DDR_dm[0] | INOUT | A1 | SSTL15_T_DCI
DDR_dm[1] | INOUT | F1 | SSTL15_T_DCI
DDR_dm[2] | INOUT | T1 | SSTL15_T_DCI
DDR_dm[3] | INOUT | Y1 | SSTL15_T_DCI
DDR_dq[0] | INOUT | C3 | SSTL15_T_DCI
DDR_dq[10] | INOUT | G3 | SSTL15_T_DCI
DDR_dq[11] | INOUT | H3 | SSTL15_T_DCI
DDR_dq[12] | INOUT | J3 | SSTL15_T_DCI
DDR_dq[13] | INOUT | H2 | SSTL15_T_DCI
DDR_dq[14] | INOUT | H1 | SSTL15_T_DCI
DDR_dq[15] | INOUT | J1 | SSTL15_T_DCI
DDR_dq[16] | INOUT | P1 | SSTL15_T_DCI
DDR_dq[17] | INOUT | P3 | SSTL15_T_DCI
DDR_dq[18] | INOUT | R3 | SSTL15_T_DCI
DDR_dq[19] | INOUT | R1 | SSTL15_T_DCI
DDR_dq[1] | INOUT | B3 | SSTL15_T_DCI
DDR_dq[20] | INOUT | T4 | SSTL15_T_DCI
DDR_dq[21] | INOUT | U4 | SSTL15_T_DCI
DDR_dq[22] | INOUT | U2 | SSTL15_T_DCI
DDR_dq[23] | INOUT | U3 | SSTL15_T_DCI
DDR_dq[24] | INOUT | V1 | SSTL15_T_DCI
DDR_dq[25] | INOUT | Y3 | SSTL15_T_DCI
DDR_dq[26] | INOUT | W1 | SSTL15_T_DCI
DDR_dq[27] | INOUT | Y4 | SSTL15_T_DCI
DDR_dq[28] | INOUT | Y2 | SSTL15_T_DCI
DDR_dq[29] | INOUT | W3 | SSTL15_T_DCI
DDR_dq[2] | INOUT | A2 | SSTL15_T_DCI
DDR_dq[30] | INOUT | V2 | SSTL15_T_DCI
DDR_dq[31] | INOUT | V3 | SSTL15_T_DCI
DDR_dq[3] | INOUT | A4 | SSTL15_T_DCI
DDR_dq[4] | INOUT | D3 | SSTL15_T_DCI
DDR_dq[5] | INOUT | D1 | SSTL15_T_DCI
DDR_dq[6] | INOUT | C1 | SSTL15_T_DCI
DDR_dq[7] | INOUT | E1 | SSTL15_T_DCI
DDR_dq[8] | INOUT | E2 | SSTL15_T_DCI
DDR_dq[9] | INOUT | E3 | SSTL15_T_DCI
DDR_dqs_n[0] | INOUT | B2 | DIFF_SSTL15_T_DCI
DDR_dqs_n[1] | INOUT | F2 | DIFF_SSTL15_T_DCI
DDR_dqs_n[2] | INOUT | T2 | DIFF_SSTL15_T_DCI
DDR_dqs_n[3] | INOUT | W4 | DIFF_SSTL15_T_DCI
DDR_dqs_p[0] | INOUT | C2 | DIFF_SSTL15_T_DCI
DDR_dqs_p[1] | INOUT | G2 | DIFF_SSTL15_T_DCI
DDR_dqs_p[2] | INOUT | R2 | DIFF_SSTL15_T_DCI
DDR_dqs_p[3] | INOUT | W5 | DIFF_SSTL15_T_DCI
DDR_odt | INOUT | N5 | SSTL15
DDR_ras_n | INOUT | P4 | SSTL15
DDR_reset_n | INOUT | B4 | SSTL15
DDR_we_n | INOUT | M5 | SSTL15
FIXED_IO_ddr_vrn | INOUT | G5 | SSTL15_T_DCI
FIXED_IO_ddr_vrp | INOUT | H5 | SSTL15_T_DCI
FIXED_IO_mio[0] | INOUT | E6 | LVCMOS33
FIXED_IO_mio[10] | INOUT | E9 | LVCMOS33
FIXED_IO_mio[11] | INOUT | C6 | LVCMOS33
FIXED_IO_mio[12] | INOUT | D9 | LVCMOS33
FIXED_IO_mio[13] | INOUT | E8 | LVCMOS33
FIXED_IO_mio[14] | INOUT | C5 | LVCMOS33
FIXED_IO_mio[15] | INOUT | C8 | LVCMOS33
FIXED_IO_mio[16] | INOUT | A19 | HSTL_I_18
FIXED_IO_mio[17] | INOUT | E14 | HSTL_I_18
FIXED_IO_mio[18] | INOUT | B18 | HSTL_I_18
FIXED_IO_mio[19] | INOUT | D10 | HSTL_I_18
FIXED_IO_mio[1] | INOUT | A7 | LVCMOS33
FIXED_IO_mio[20] | INOUT | A17 | HSTL_I_18
FIXED_IO_mio[21] | INOUT | F14 | HSTL_I_18
FIXED_IO_mio[22] | INOUT | B17 | HSTL_I_18
FIXED_IO_mio[23] | INOUT | D11 | HSTL_I_18
FIXED_IO_mio[24] | INOUT | A16 | HSTL_I_18
FIXED_IO_mio[25] | INOUT | F15 | HSTL_I_18
FIXED_IO_mio[26] | INOUT | A15 | HSTL_I_18
FIXED_IO_mio[27] | INOUT | D13 | HSTL_I_18
FIXED_IO_mio[28] | INOUT | C16 | LVCMOS18
FIXED_IO_mio[29] | INOUT | C13 | LVCMOS18
FIXED_IO_mio[2] | INOUT | B8 | LVCMOS33
FIXED_IO_mio[30] | INOUT | C15 | LVCMOS18
FIXED_IO_mio[31] | INOUT | E16 | LVCMOS18
FIXED_IO_mio[32] | INOUT | A14 | LVCMOS18
FIXED_IO_mio[33] | INOUT | D15 | LVCMOS18
FIXED_IO_mio[34] | INOUT | A12 | LVCMOS18
FIXED_IO_mio[35] | INOUT | F12 | LVCMOS18
FIXED_IO_mio[36] | INOUT | A11 | LVCMOS18
FIXED_IO_mio[37] | INOUT | A10 | LVCMOS18
FIXED_IO_mio[38] | INOUT | E13 | LVCMOS18
FIXED_IO_mio[39] | INOUT | C18 | LVCMOS18
FIXED_IO_mio[3] | INOUT | D6 | LVCMOS33
FIXED_IO_mio[40] | INOUT | D14 | LVCMOS18
FIXED_IO_mio[41] | INOUT | C17 | LVCMOS18
FIXED_IO_mio[42] | INOUT | E12 | LVCMOS18
FIXED_IO_mio[43] | INOUT | A9 | LVCMOS18
FIXED_IO_mio[44] | INOUT | F13 | LVCMOS18
FIXED_IO_mio[45] | INOUT | B15 | LVCMOS18
FIXED_IO_mio[46] | INOUT | D16 | LVCMOS18
FIXED_IO_mio[47] | INOUT | B14 | LVCMOS18
FIXED_IO_mio[48] | INOUT | B12 | LVCMOS18
FIXED_IO_mio[49] | INOUT | C12 | LVCMOS18
FIXED_IO_mio[4] | INOUT | B7 | LVCMOS33
FIXED_IO_mio[50] | INOUT | B13 | LVCMOS18
FIXED_IO_mio[51] | INOUT | B9 | LVCMOS18
FIXED_IO_mio[52] | INOUT | C10 | HSTL_I_18
FIXED_IO_mio[53] | INOUT | C11 | HSTL_I_18
FIXED_IO_mio[5] | INOUT | A6 | LVCMOS33
FIXED_IO_mio[6] | INOUT | A5 | LVCMOS33
FIXED_IO_mio[7] | INOUT | D8 | LVCMOS33
FIXED_IO_mio[8] | INOUT | D5 | LVCMOS33
FIXED_IO_mio[9] | INOUT | B5 | LVCMOS33
FIXED_IO_ps_clk | INOUT | E7 | LVCMOS33
FIXED_IO_ps_porb | INOUT | C7 | LVCMOS33
FIXED_IO_ps_srstb | INOUT | B10 | LVCMOS18
board_keys_n[0] | IN | N15 | LVCMOS33
board_keys_n[1] | IN | N16 | LVCMOS33
board_keys_n[2] | IN | T17 | LVCMOS33
board_keys_n[3] | IN | R17 | LVCMOS33
cam_d[0] | IN | F17 | LVCMOS33
cam_d[1] | IN | F16 | LVCMOS33
cam_d[2] | IN | F20 | LVCMOS33
cam_d[3] | IN | F19 | LVCMOS33
cam_d[4] | IN | G20 | LVCMOS33
cam_d[5] | IN | G19 | LVCMOS33
cam_d[6] | IN | H18 | LVCMOS33
cam_d[7] | IN | J18 | LVCMOS33
cam_href | IN | K18 | LVCMOS33
cam_pclk | IN | K17 | LVCMOS33
cam_pwdn | OUT | M19 | LVCMOS33
cam_reset_n | OUT | J19 | LVCMOS33
cam_scl | INOUT | L20 | LVCMOS33
cam_sda | INOUT | L19 | LVCMOS33
cam_vsync | IN | M20 | LVCMOS33
enhance_led_n | OUT | M14 | LVCMOS33
hdmi_clk_n | OUT | P19 | TMDS_33
hdmi_clk_p | OUT | N18 | TMDS_33
hdmi_data_n[0] | OUT | W20 | TMDS_33
hdmi_data_n[1] | OUT | U20 | TMDS_33
hdmi_data_n[2] | OUT | P20 | TMDS_33
hdmi_data_p[0] | OUT | V20 | TMDS_33
hdmi_data_p[1] | OUT | T20 | TMDS_33
hdmi_data_p[2] | OUT | N20 | TMDS_33
hdmi_hpd | IN | Y19 | LVCMOS33
hdmi_out_en | OUT | V16 | LVCMOS33
mic_sck | OUT | W19 | LVCMOS33
mic_sd_0 | IN | R14 | LVCMOS33
mic_sd_1 | IN | P14 | LVCMOS33
mic_sd_2 | IN | Y17 | LVCMOS33
mic_sd_3 | IN | Y16 | LVCMOS33
mic_ws | OUT | W18 | LVCMOS33
servo_pan | OUT | Y14 | LVCMOS33
servo_tilt | OUT | W14 | LVCMOS33
