Ji-Shawn/Bird-detection-classification-tracking/build/readme.md

# 构建导览

本目录提供模型、ARM 双核程序、BOOT 启动镜像和 FPGA 固件的构建入口。所有命令从仓库根目录执行；安装、环境变量、成功输出和排错详见[从零复现](../reproduce.md)。模型构建使用[模型说明](../src/modeling/readme.md)中的独立环境，其余命令使用复现文档建立的环境。

```text
build/
├── readme.md              # 构建入口与输入输出
├── verify_package.py     # 校验随包文件
├── doctor.py             # 检查本机 Python/编译器/工具路径
├── run_checks.py         # 完整离线检查与结果汇总
├── export_package.py     # 按清单导出干净 ZIP
├── build_models.py       # 模型构建、数据准备、训练与评估
├── build_firmware.py     # 构建 ARM 双核程序
├── build_boot.py         # 打包 BOOT 启动镜像
├── verify_boot.py        # 启动镜像检查工具
├── boot/                 # 启动镜像打包辅助代码
├── pl/                   # FPGA 工程创建、展开与实现脚本
├── metadata/             # 当前包校验清单与来源映射
├── receipts/             # 当前发布验证、双核来源与最新 ARM/BOOT 重建回执
├── reports/              # 当前发布 PL 报告与最新源码重建报告
└── out/                  # 运行时生成的工作区与结果，不提交 Git
```

| 目标 | 命令或入口 | 输出 |
| --- | --- | --- |
| 查看模型构建用法 | `python -B build/build_models.py --help` | 三套模型的操作入口 |
| 检查模型结构与前向计算 | `python -B build/build_models.py selftest` | 离线自检结果；不下载预训练权重 |
| 校验当前包 | `python -B build/verify_package.py` | 终端中的校验结果 |
| 完整离线检查 | `python -B build/run_checks.py --host-cc <native_gcc_path>` | `build/out/checks/` |
| 重建两个 ARM 核 | `python -B build/build_firmware.py --core both` | `build/out/firmware/` |
| 用随包固件重新打包 BOOT | `python -B build/build_boot.py` | `build/out/boot/boot.bin` |
| 用刚重建的双核程序打包 BOOT | `python -B build/build_boot.py --rebuilt` | `build/out/boot/boot.bin` |
| 重建 FPGA | [pl/readme.md](pl/readme.md) | `build/out/pl/` |

ARM 构建从 `src/application/`、`src/services/`、`src/platform/` 及两个预处理驱动目录读取输入，先在 `build/out/work/` 中生成最终源码。修改源文件和功能生成器，不要只修改输出工作区中的文件。

构建入口不会自动覆盖 `board/firmware/` 中的发布固件或写 SD 卡。报告按当前发布文件和最新源码重建分别保存；使用哪套产物，就核对哪套报告和指纹。

模型源码在 `src/modeling/`，新数据处理结果、检查点和评估结果默认在 `build/out/modeling/`。训练新的 FP32 权重与生成板端 INT8 资产是不同步骤，具体配套关系见[模型部署说明](../src/modeling/deployment.md)。

## 当前清单与验证证据

| 要核对的内容 | 文件或目录 | 如何理解 |
| --- | --- | --- |
| 当前包的文件身份 | [metadata/package_manifest.json](metadata/package_manifest.json) | `verify_package.py` 使用的当前相对路径与 SHA256 清单；校验通过说明文件与清单一致。 |
| 原始源码与当前路径对应 | [metadata/source_mapping.json](metadata/source_mapping.json) | 用于追溯来源；查找现役源码仍按 `src/` 功能目录。 |
| 当前发布版本的验证与身份 | [receipts/release_validation.json](receipts/release_validation.json)、[release_manifest.json](receipts/release_manifest.json)、[release_tests.json](receipts/release_tests.json) | 对应随包 SSD95 发布固件；发布记录的 `PASS_OFFLINE_READY` 不表示完成整机板测，发布清单也不能替代当前包清单。 |
| 当前发布双核的来源 | [receipts/core0_original.json](receipts/core0_original.json)、[core1_original.json](receipts/core1_original.json) | 保留当前发布 ELF 的构建来源，文件名中的 original 表示来源对象。 |
| 当前发布 PL 的配套报告 | `reports/pl_*.rpt`、`reports/pl_pins.tsv`、`reports/pl_clocks.tsv` | 对应 `board/firmware/` 中的发布 PL；时序 WNS=+0.128 ns、WHS=+0.005 ns，仍有 CDC、I/O 覆盖等待审查项。 |
| 最新源码 PL 重建 | [reports/rebuild_20261103/readme.md](reports/rebuild_20261103/readme.md) | 本轮完整综合实现及后续 IP 生成检查；新 bitstream 未替换发布固件。 |
| 最新 ARM/BOOT 重建 | [receipts/arm_rebuild_20261103.json](receipts/arm_rebuild_20261103.json) | 双核、FSBL 与 BOOT 的构建及配套校验；使用发布 PL，没有新上板验收。 |
| 完整离线及迁移验证 | [sim/readme.md](../sim/readme.md) | 汇总当前保留的完整运行、迁移复现和专项测试范围。 |

最终设计报告见 [report/report.pdf](../report/report.pdf)，协作报告的来源材料在 [data/collaboration_sources/](../data/collaboration_sources/readme.md)，系统设计和第三方说明在 [src/design.md](../src/design.md)与[src/third_party_notices.md](../src/third_party_notices.md)。本轮测试日志位于 `sim/results/`；自行运行的新输出仍位于 `build/out/`。

2026-11-03 已用 ARM GCC 12.2.0 完整编译双核、FSBL 并重打包 BOOT，8 个分区和 388 项模型资产配对验证通过，见 [本轮 ARM 回执](receipts/arm_rebuild_20261103.json)。此结果属于构建与镜像校验，不是上板验证。

本轮亦已重新完成 PL 综合与实现，时序 WNS=+0.062 ns、WHS=+0.012 ns，记录见 [2026-11-03 PL 证据](reports/rebuild_20261103/readme.md)。新 ARM/BOOT 使用原发布 bitstream；新 PL bit 单独保存，二者没有自动组成已验收的整机新版本。
