Ji-Shawn/Bird-detection-classification-tracking/build/receipts/arm_rebuild_20261103/compiler_version.txt

arm-xilinx-eabi-gcc.exe (GCC) 12.2.0
Copyright (C) 2022 Free Software Foundation, Inc.
This is free software; see the source for copying conditions.  There is NO
warranty; not even for MERCHANTABILITY or FITNESS FOR A PARTICULAR PURPOSE.
