Ji-Shawn/Bird-detection-classification-tracking/build/receipts/arm_rebuild_20261103/core0_link_map.txt

Archive member included to satisfy reference by file (symbol)

${package_root}\build\out\work\platform\bsp_core0\lib\liblwip4.a(etharp.o)
                              ${package_root}\build\out\work\application\build\software\9.o (etharp_tmr)
${package_root}\build\out\work\platform\bsp_core0\lib\liblwip4.a(ethernet.o)
                              ${package_root}\build\out\work\platform\bsp_core0\lib\liblwip4.a(etharp.o) (ethernet_output)
${package_root}\build\out\work\platform\bsp_core0\lib\liblwip4.a(init.o)
                              ${package_root}\build\out\work\application\build\software\7.o (lwip_init)
${package_root}\build\out\work\platform\bsp_core0\lib\liblwip4.a(ip4.o)
                              ${package_root}\build\out\work\platform\bsp_core0\lib\liblwip4.a(ethernet.o) (ip4_input)
${package_root}\build\out\work\platform\bsp_core0\lib\liblwip4.a(ip4_addr.o)
                              ${package_root}\build\out\work\platform\bsp_core0\lib\liblwip4.a(etharp.o) (ip4_addr_isbroadcast_u32)
${package_root}\build\out\work\platform\bsp_core0\lib\liblwip4.a(ip4_frag.o)
                              ${package_root}\build\out\work\platform\bsp_core0\lib\liblwip4.a(ip4.o) (ip4_reass)
${package_root}\build\out\work\platform\bsp_core0\lib\liblwip4.a(memp.o)
                              ${package_root}\build\out\work\platform\bsp_core0\lib\liblwip4.a(init.o) (memp_init)
${package_root}\build\out\work\platform\bsp_core0\lib\liblwip4.a(netif.o)
                              ${package_root}\build\out\work\platform\bsp_core0\lib\liblwip4.a(init.o) (netif_init)
${package_root}\build\out\work\platform\bsp_core0\lib\liblwip4.a(pbuf.o)
                              ${package_root}\build\out\work\application\build\software\9.o (pbuf_alloc)
${package_root}\build\out\work\platform\bsp_core0\lib\liblwip4.a(stats.o)
                              ${package_root}\build\out\work\platform\bsp_core0\lib\liblwip4.a(init.o) (stats_init)
${package_root}\build\out\work\platform\bsp_core0\lib\liblwip4.a(sys_arch_raw.o)
                              ${package_root}\build\out\work\application\build\software\22.o (sys_arch_protect)
${package_root}\build\out\work\platform\bsp_core0\lib\liblwip4.a(tcp.o)
                              ${package_root}\build\out\work\platform\bsp_core0\lib\liblwip4.a(init.o) (tcp_init)
${package_root}\build\out\work\platform\bsp_core0\lib\liblwip4.a(tcp_in.o)
                              ${package_root}\build\out\work\platform\bsp_core0\lib\liblwip4.a(ip4.o) (tcp_input)
${package_root}\build\out\work\platform\bsp_core0\lib\liblwip4.a(tcp_out.o)
                              ${package_root}\build\out\work\platform\bsp_core0\lib\liblwip4.a(tcp.o) (tcp_enqueue_flags)
${package_root}\build\out\work\platform\bsp_core0\lib\liblwip4.a(timeouts.o)
                              ${package_root}\build\out\work\platform\bsp_core0\lib\liblwip4.a(tcp.o) (tcp_timer_needed)
${package_root}\build\out\work\platform\bsp_core0\lib\liblwip4.a(udp.o)
                              ${package_root}\build\out\work\platform\bsp_core0\lib\liblwip4.a(init.o) (udp_init)
${package_root}\build\out\work\platform\bsp_core0\lib\liblwip4.a(xadapter.o)
                              ${package_root}\build\out\work\application\build\software\9.o (xemac_add)
${package_root}\build\out\work\platform\bsp_core0\lib\liblwip4.a(xemacpsif.o)
                              ${package_root}\build\out\work\platform\bsp_core0\lib\liblwip4.a(xadapter.o) (xemacpsif_input)
${package_root}\build\out\work\platform\bsp_core0\lib\liblwip4.a(xemacpsif_dma.o)
                              ${package_root}\build\out\work\platform\bsp_core0\lib\liblwip4.a(xemacpsif.o) (is_tx_space_available)
${package_root}\build\out\work\platform\bsp_core0\lib\liblwip4.a(xemacpsif_hw.o)
                              ${package_root}\build\out\work\platform\bsp_core0\lib\liblwip4.a(xemacpsif.o) (xemacps_lookup_config)
${package_root}\build\out\work\platform\bsp_core0\lib\liblwip4.a(xpqueue.o)
                              ${package_root}\build\out\work\platform\bsp_core0\lib\liblwip4.a(xemacpsif.o) (pq_create_queue)
${package_root}\build\out\work\platform\bsp_core0\lib\liblwip4.a(xtopology_g.o)
                              ${package_root}\build\out\work\platform\bsp_core0\lib\liblwip4.a(xadapter.o) (xtopology_n_emacs)
${package_root}\build\out\work\platform\bsp_core0\lib\liblwip4.a(def.o)
                              ${package_root}\build\out\work\platform\bsp_core0\lib\liblwip4.a(etharp.o) (lwip_htons)
${package_root}\build\out\work\platform\bsp_core0\lib\liblwip4.a(icmp.o)
                              ${package_root}\build\out\work\platform\bsp_core0\lib\liblwip4.a(ip4.o) (icmp_input)
${package_root}\build\out\work\platform\bsp_core0\lib\liblwip4.a(inet_chksum.o)
                              ${package_root}\build\out\work\platform\bsp_core0\lib\liblwip4.a(icmp.o) (inet_chksum)
${package_root}\build\out\work\platform\bsp_core0\lib\liblwip4.a(ip.o)
                              ${package_root}\build\out\work\platform\bsp_core0\lib\liblwip4.a(ip4.o) (ip_data)
${package_root}\build\out\work\platform\bsp_core0\lib\libxil.a(xaxidma.o)
                              ${package_root}\build\out\work\application\build\software\6.o (XAxiDma_Reset)
${package_root}\build\out\work\platform\bsp_core0\lib\libxil.a(xaxidma_bdring.o)
                              ${package_root}\build\out\work\platform\bsp_core0\lib\libxil.a(xaxidma.o) (XAxiDma_BdRingStart)
${package_root}\build\out\work\platform\bsp_core0\lib\libxil.a(xaxidma_sinit.o)
                              ${package_root}\build\out\work\application\build\software\6.o (XAxiDma_LookupConfig)
${package_root}\build\out\work\platform\bsp_core0\lib\libxil.a(xaxivdma.o)
                              ${package_root}\build\out\work\application\build\software\6.o (XAxiVdma_CfgInitialize)
${package_root}\build\out\work\platform\bsp_core0\lib\libxil.a(xaxivdma_channel.o)
                              ${package_root}\build\out\work\platform\bsp_core0\lib\libxil.a(xaxivdma.o) (XAxiVdma_ChannelInit)
${package_root}\build\out\work\platform\bsp_core0\lib\libxil.a(xaxivdma_intr.o)
                              ${package_root}\build\out\work\application\build\software\6.o (XAxiVdma_IntrClear)
${package_root}\build\out\work\platform\bsp_core0\lib\libxil.a(xaxivdma_sinit.o)
                              ${package_root}\build\out\work\application\build\software\6.o (XAxiVdma_LookupConfig)
${package_root}\build\out\work\platform\bsp_core0\lib\libxil.a(xemacps_g.o)
                              ${package_root}\build\out\work\platform\bsp_core0\lib\liblwip4.a(xemacpsif_hw.o) (XEmacPs_ConfigTable)
${package_root}\build\out\work\platform\bsp_core0\lib\libxil.a(xemacps.o)
                              ${package_root}\build\out\work\platform\bsp_core0\lib\liblwip4.a(xemacpsif_hw.o) (XEmacPs_Start)
${package_root}\build\out\work\platform\bsp_core0\lib\libxil.a(xemacps_intr.o)
                              ${package_root}\build\out\work\platform\bsp_core0\lib\liblwip4.a(xemacpsif_hw.o) (XEmacPs_SetHandler)
${package_root}\build\out\work\platform\bsp_core0\lib\libxil.a(xemacps_control.o)
                              ${package_root}\build\out\work\platform\bsp_core0\lib\liblwip4.a(xemacpsif_hw.o) (XEmacPs_SetMacAddress)
${package_root}\build\out\work\platform\bsp_core0\lib\libxil.a(xemacps_bdring.o)
                              ${package_root}\build\out\work\platform\bsp_core0\lib\liblwip4.a(xemacpsif_dma.o) (XEmacPs_BdRingCreate)
${package_root}\build\out\work\platform\bsp_core0\lib\libxil.a(xgpio.o)
                              ${package_root}\build\out\work\application\build\software\8.o (XGpio_CfgInitialize)
${package_root}\build\out\work\platform\bsp_core0\lib\libxil.a(xgpio_sinit.o)
                              ${package_root}\build\out\work\application\build\software\8.o (XGpio_LookupConfig)
${package_root}\build\out\work\platform\bsp_core0\lib\libxil.a(xscugic_hw.o)
                              ${package_root}\build\out\work\application\build\software\9.o (XScuGic_DeviceInitialize)
${package_root}\build\out\work\platform\bsp_core0\lib\libxil.a(xscugic_g.o)
                              ${package_root}\build\out\work\platform\bsp_core0\lib\libxil.a(xscugic_hw.o) (XScuGic_ConfigTable)
${package_root}\build\out\work\platform\bsp_core0\lib\libxil.a(xscugic.o)
                              ${package_root}\build\out\work\platform\bsp_core0\lib\libxil.a(xscugic_hw.o) (XScuGic_GetCpuID)
${package_root}\build\out\work\platform\bsp_core0\lib\libxil.a(asm_vectors.o)
                              (_vector_table)
${package_root}\build\out\work\platform\bsp_core0\lib\libxil.a(boot.o)
                              ${package_root}\build\out\work\platform\bsp_core0\lib\libxil.a(asm_vectors.o) (_boot)
${package_root}\build\out\work\platform\bsp_core0\lib\libxil.a(outbyte.o)
                              ${package_root}\build\out\work\application\build\software\3.o (outbyte)
${package_root}\build\out\work\platform\bsp_core0\lib\libxil.a(print.o)
                              ${package_root}\build\out\work\platform\bsp_core0\lib\liblwip4.a(xadapter.o) (print)
${package_root}\build\out\work\platform\bsp_core0\lib\libxil.a(translation_table.o)
                              ${package_root}\build\out\work\platform\bsp_core0\lib\libxil.a(boot.o) (MMUTable)
${package_root}\build\out\work\platform\bsp_core0\lib\libxil.a(vectors.o)
                              ${package_root}\build\out\work\platform\bsp_core0\lib\libxil.a(asm_vectors.o) (FIQInterrupt)
${package_root}\build\out\work\platform\bsp_core0\lib\libxil.a(xil-crt0.o)
                              ${package_root}\build\out\work\platform\bsp_core0\lib\libxil.a(boot.o) (_start)
${package_root}\build\out\work\platform\bsp_core0\lib\libxil.a(xil_assert.o)
                              ${package_root}\build\out\work\platform\bsp_core0\lib\libxil.a(xaxivdma.o) (Xil_Assert)
${package_root}\build\out\work\platform\bsp_core0\lib\libxil.a(xil_cache.o)
                              ${package_root}\build\out\work\application\build\software\1.o (Xil_DCacheInvalidateRange)
${package_root}\build\out\work\platform\bsp_core0\lib\libxil.a(xil_exception.o)
                              ${package_root}\build\out\work\application\build\software\9.o (Xil_ExceptionInit)
${package_root}\build\out\work\platform\bsp_core0\lib\libxil.a(xil_mmu.o)
                              ${package_root}\build\out\work\application\build\software\7.o (Xil_SetTlbAttributes)
${package_root}\build\out\work\platform\bsp_core0\lib\libxil.a(xil_sleepcommon.o)
                              ${package_root}\build\out\work\application\build\software\8.o (usleep)
${package_root}\build\out\work\platform\bsp_core0\lib\libxil.a(xtime_l.o)
                              ${package_root}\build\out\work\platform\bsp_core0\lib\libxil.a(xil-crt0.o) (XTime_SetTime)
${package_root}\build\out\work\platform\bsp_core0\lib\libxil.a(xuartps_hw.o)
                              ${package_root}\build\out\work\platform\bsp_core0\lib\libxil.a(outbyte.o) (XUartPs_SendByte)
${package_root}\build\out\work\platform\bsp_core0\lib\libxil.a(xaxidma_g.o)
                              ${package_root}\build\out\work\platform\bsp_core0\lib\libxil.a(xaxidma_sinit.o) (XAxiDma_ConfigTable)
${package_root}\build\out\work\platform\bsp_core0\lib\libxil.a(xaxivdma_g.o)
                              ${package_root}\build\out\work\platform\bsp_core0\lib\libxil.a(xaxivdma_sinit.o) (XAxiVdma_ConfigTable)
${package_root}\build\out\work\platform\bsp_core0\lib\libxil.a(xgpio_g.o)
                              ${package_root}\build\out\work\platform\bsp_core0\lib\libxil.a(xgpio_sinit.o) (XGpio_ConfigTable)
${package_root}\build\out\work\platform\bsp_core0\lib\libxil.a(cpu_init.o)
                              ${package_root}\build\out\work\platform\bsp_core0\lib\libxil.a(xil-crt0.o) (__cpu_init)
${package_root}\build\out\work\platform\bsp_core0\lib\libxil.a(sleep.o)
                              ${package_root}\build\out\work\platform\bsp_core0\lib\libxil.a(xil_sleepcommon.o) (sleep_A9)
${package_root}\build\out\work\platform\bsp_core0\lib\libxil.a(usleep.o)
                              ${package_root}\build\out\work\platform\bsp_core0\lib\libxil.a(xil_sleepcommon.o) (usleep_A9)
${vitis_install}/gnu/aarch32/nt/gcc-arm-none-eabi/bin//../aarch32-xilinx-eabi/usr/lib/thumb/v7-a+fp/hard\libm.a(lib_a-sf_ceil.o)
                              ${package_root}\build\out\work\application\build\software\0.o (ceilf)
${vitis_install}/gnu/aarch32/nt/gcc-arm-none-eabi/bin//../aarch32-xilinx-eabi/usr/lib/thumb/v7-a+fp/hard\libm.a(lib_a-sf_exp.o)
                              ${package_root}\build\out\work\application\build\software\0.o (expf)
${vitis_install}/gnu/aarch32/nt/gcc-arm-none-eabi/bin//../aarch32-xilinx-eabi/usr/lib/thumb/v7-a+fp/hard\libm.a(lib_a-sf_floor.o)
                              ${package_root}\build\out\work\application\build\software\0.o (floorf)
${vitis_install}/gnu/aarch32/nt/gcc-arm-none-eabi/bin//../aarch32-xilinx-eabi/usr/lib/thumb/v7-a+fp/hard\libm.a(lib_a-sf_fmax.o)
                              ${package_root}\build\out\work\application\build\software\0.o (fmaxf)
${vitis_install}/gnu/aarch32/nt/gcc-arm-none-eabi/bin//../aarch32-xilinx-eabi/usr/lib/thumb/v7-a+fp/hard\libm.a(lib_a-sf_fmin.o)
                              ${package_root}\build\out\work\application\build\software\0.o (fminf)
${vitis_install}/gnu/aarch32/nt/gcc-arm-none-eabi/bin//../aarch32-xilinx-eabi/usr/lib/thumb/v7-a+fp/hard\libm.a(lib_a-sf_fpclassify.o)
                              ${vitis_install}/gnu/aarch32/nt/gcc-arm-none-eabi/bin//../aarch32-xilinx-eabi/usr/lib/thumb/v7-a+fp/hard\libm.a(lib_a-sf_fmax.o) (__fpclassifyf)
${vitis_install}/gnu/aarch32/nt/gcc-arm-none-eabi/bin//../aarch32-xilinx-eabi/usr/lib/thumb/v7-a+fp/hard\libm.a(lib_a-sf_round.o)
                              ${package_root}\build\out\work\application\build\software\15.o (roundf)
${vitis_install}/gnu/aarch32/nt/gcc-arm-none-eabi/bin//../aarch32-xilinx-eabi/usr/lib/thumb/v7-a+fp/hard\libm.a(lib_a-wf_sqrt.o)
                              ${package_root}\build\out\work\application\build\software\15.o (sqrtf)
${vitis_install}/gnu/aarch32/nt/gcc-arm-none-eabi/bin//../aarch32-xilinx-eabi/usr/lib/thumb/v7-a+fp/hard\libm.a(lib_a-ef_sqrt.o)
                              ${vitis_install}/gnu/aarch32/nt/gcc-arm-none-eabi/bin//../aarch32-xilinx-eabi/usr/lib/thumb/v7-a+fp/hard\libm.a(lib_a-wf_sqrt.o) (__ieee754_sqrtf)
${vitis_install}/gnu/aarch32/nt/gcc-arm-none-eabi/bin//../aarch32-xilinx-eabi/usr/lib/thumb/v7-a+fp/hard\libm.a(lib_a-math_errf.o)
                              ${vitis_install}/gnu/aarch32/nt/gcc-arm-none-eabi/bin//../aarch32-xilinx-eabi/usr/lib/thumb/v7-a+fp/hard\libm.a(lib_a-sf_exp.o) (__math_uflowf)
${vitis_install}/gnu/aarch32/nt/gcc-arm-none-eabi/bin//../aarch32-xilinx-eabi/usr/lib/thumb/v7-a+fp/hard\libm.a(lib_a-sf_exp2_data.o)
                              ${vitis_install}/gnu/aarch32/nt/gcc-arm-none-eabi/bin//../aarch32-xilinx-eabi/usr/lib/thumb/v7-a+fp/hard\libm.a(lib_a-sf_exp.o) (__exp2f_data)
${vitis_install}/gnu/aarch32/nt/gcc-arm-none-eabi/bin//../aarch32-xilinx-eabi/usr/lib/thumb/v7-a+fp/hard\libgcc.a(_udivsi3.o)
                              ${package_root}\build\out\work\application\build\software\10.o (__aeabi_uidiv)
${vitis_install}/gnu/aarch32/nt/gcc-arm-none-eabi/bin//../aarch32-xilinx-eabi/usr/lib/thumb/v7-a+fp/hard\libgcc.a(_divsi3.o)
                              ${package_root}\build\out\work\application\build\software\0.o (__aeabi_idiv)
${vitis_install}/gnu/aarch32/nt/gcc-arm-none-eabi/bin//../aarch32-xilinx-eabi/usr/lib/thumb/v7-a+fp/hard\libgcc.a(_dvmd_tls.o)
                              ${vitis_install}/gnu/aarch32/nt/gcc-arm-none-eabi/bin//../aarch32-xilinx-eabi/usr/lib/thumb/v7-a+fp/hard\libgcc.a(_udivsi3.o) (__aeabi_idiv0)
${vitis_install}/gnu/aarch32/nt/gcc-arm-none-eabi/bin//../aarch32-xilinx-eabi/usr/lib/thumb/v7-a+fp/hard\libgcc.a(_arm_addsubsf3.o)
                              ${package_root}\build\out\work\application\build\software\10.o (__aeabi_ul2f)
${vitis_install}/gnu/aarch32/nt/gcc-arm-none-eabi/bin//../aarch32-xilinx-eabi/usr/lib/thumb/v7-a+fp/hard\libgcc.a(_aeabi_ldivmod.o)
                              ${package_root}\build\out\work\application\build\software\10.o (__aeabi_ldivmod)
${vitis_install}/gnu/aarch32/nt/gcc-arm-none-eabi/bin//../aarch32-xilinx-eabi/usr/lib/thumb/v7-a+fp/hard\libgcc.a(_aeabi_uldivmod.o)
                              ${package_root}\build\out\work\application\build\software\4.o (__aeabi_uldivmod)
${vitis_install}/gnu/aarch32/nt/gcc-arm-none-eabi/bin//../aarch32-xilinx-eabi/usr/lib/thumb/v7-a+fp/hard\libgcc.a(_udivmoddi4.o)
                              ${vitis_install}/gnu/aarch32/nt/gcc-arm-none-eabi/bin//../aarch32-xilinx-eabi/usr/lib/thumb/v7-a+fp/hard\libgcc.a(_aeabi_ldivmod.o) (__udivmoddi4)
${vitis_install}/gnu/aarch32/nt/gcc-arm-none-eabi/bin//../aarch32-xilinx-eabi/usr/lib/thumb/v7-a+fp/hard\libc.a(lib_a-ctype_.o)
                              ${package_root}\build\out\work\application\build\software\3.o (_ctype_)
${vitis_install}/gnu/aarch32/nt/gcc-arm-none-eabi/bin//../aarch32-xilinx-eabi/usr/lib/thumb/v7-a+fp/hard\libc.a(lib_a-errno.o)
                              ${vitis_install}/gnu/aarch32/nt/gcc-arm-none-eabi/bin//../aarch32-xilinx-eabi/usr/lib/thumb/v7-a+fp/hard\libm.a(lib_a-wf_sqrt.o) (__errno)
${vitis_install}/gnu/aarch32/nt/gcc-arm-none-eabi/bin//../aarch32-xilinx-eabi/usr/lib/thumb/v7-a+fp/hard\libc.a(lib_a-exit.o)
                              ${package_root}\build\out\work\platform\bsp_core0\lib\libxil.a(xil-crt0.o) (exit)
${vitis_install}/gnu/aarch32/nt/gcc-arm-none-eabi/bin//../aarch32-xilinx-eabi/usr/lib/thumb/v7-a+fp/hard\libc.a(lib_a-fini.o)
                              ${package_root}\build\out\work\platform\bsp_core0\lib\libxil.a(xil-crt0.o) (__libc_fini_array)
${vitis_install}/gnu/aarch32/nt/gcc-arm-none-eabi/bin//../aarch32-xilinx-eabi/usr/lib/thumb/v7-a+fp/hard\libc.a(lib_a-impure.o)
                              ${vitis_install}/gnu/aarch32/nt/gcc-arm-none-eabi/bin//../aarch32-xilinx-eabi/usr/lib/thumb/v7-a+fp/hard\libc.a(lib_a-exit.o) (_global_impure_ptr)
${vitis_install}/gnu/aarch32/nt/gcc-arm-none-eabi/bin//../aarch32-xilinx-eabi/usr/lib/thumb/v7-a+fp/hard\libc.a(lib_a-init.o)
                              ${package_root}\build\out\work\platform\bsp_core0\lib\libxil.a(xil-crt0.o) (__libc_init_array)
${vitis_install}/gnu/aarch32/nt/gcc-arm-none-eabi/bin//../aarch32-xilinx-eabi/usr/lib/thumb/v7-a+fp/hard\libc.a(lib_a-malloc.o)
                              ${package_root}\build\out\work\application\build\software\0.o (malloc)
${vitis_install}/gnu/aarch32/nt/gcc-arm-none-eabi/bin//../aarch32-xilinx-eabi/usr/lib/thumb/v7-a+fp/hard\libc.a(lib_a-mallocr.o)
                              ${vitis_install}/gnu/aarch32/nt/gcc-arm-none-eabi/bin//../aarch32-xilinx-eabi/usr/lib/thumb/v7-a+fp/hard\libc.a(lib_a-malloc.o) (_malloc_r)
${vitis_install}/gnu/aarch32/nt/gcc-arm-none-eabi/bin//../aarch32-xilinx-eabi/usr/lib/thumb/v7-a+fp/hard\libc.a(lib_a-memcmp.o)
                              ${package_root}\build\out\work\application\build\software\10.o (memcmp)
${vitis_install}/gnu/aarch32/nt/gcc-arm-none-eabi/bin//../aarch32-xilinx-eabi/usr/lib/thumb/v7-a+fp/hard\libc.a(lib_a-memcpy.o)
                              ${package_root}\build\out\work\application\build\software\0.o (memcpy)
${vitis_install}/gnu/aarch32/nt/gcc-arm-none-eabi/bin//../aarch32-xilinx-eabi/usr/lib/thumb/v7-a+fp/hard\libc.a(lib_a-memmove.o)
                              ${package_root}\build\out\work\application\build\software\10.o (memmove)
${vitis_install}/gnu/aarch32/nt/gcc-arm-none-eabi/bin//../aarch32-xilinx-eabi/usr/lib/thumb/v7-a+fp/hard\libc.a(lib_a-memset.o)
                              ${package_root}\build\out\work\application\build\software\3.o (memset)
${vitis_install}/gnu/aarch32/nt/gcc-arm-none-eabi/bin//../aarch32-xilinx-eabi/usr/lib/thumb/v7-a+fp/hard\libc.a(lib_a-mlock.o)
                              ${vitis_install}/gnu/aarch32/nt/gcc-arm-none-eabi/bin//../aarch32-xilinx-eabi/usr/lib/thumb/v7-a+fp/hard\libc.a(lib_a-mallocr.o) (__malloc_lock)
${vitis_install}/gnu/aarch32/nt/gcc-arm-none-eabi/bin//../aarch32-xilinx-eabi/usr/lib/thumb/v7-a+fp/hard\libc.a(lib_a-puts.o)
                              ${package_root}\build\out\work\platform\bsp_core0\lib\liblwip4.a(xemacpsif.o) (puts)
${vitis_install}/gnu/aarch32/nt/gcc-arm-none-eabi/bin//../aarch32-xilinx-eabi/usr/lib/thumb/v7-a+fp/hard\libc.a(lib_a-qsort.o)
                              ${package_root}\build\out\work\application\build\software\18.o (qsort)
${vitis_install}/gnu/aarch32/nt/gcc-arm-none-eabi/bin//../aarch32-xilinx-eabi/usr/lib/thumb/v7-a+fp/hard\libc.a(lib_a-sbrkr.o)
                              ${vitis_install}/gnu/aarch32/nt/gcc-arm-none-eabi/bin//../aarch32-xilinx-eabi/usr/lib/thumb/v7-a+fp/hard\libc.a(lib_a-mallocr.o) (_sbrk_r)
${vitis_install}/gnu/aarch32/nt/gcc-arm-none-eabi/bin//../aarch32-xilinx-eabi/usr/lib/thumb/v7-a+fp/hard\libc.a(lib_a-snprintf.o)
                              ${package_root}\build\out\work\application\build\software\33.o (snprintf)
${vitis_install}/gnu/aarch32/nt/gcc-arm-none-eabi/bin//../aarch32-xilinx-eabi/usr/lib/thumb/v7-a+fp/hard\libc.a(lib_a-strcmp.o)
                              ${package_root}\build\out\work\application\build\software\26.o (strcmp)
${vitis_install}/gnu/aarch32/nt/gcc-arm-none-eabi/bin//../aarch32-xilinx-eabi/usr/lib/thumb/v7-a+fp/hard\libc.a(lib_a-strlen.o)
                              ${package_root}\build\out\work\application\build\software\3.o (strlen)
${vitis_install}/gnu/aarch32/nt/gcc-arm-none-eabi/bin//../aarch32-xilinx-eabi/usr/lib/thumb/v7-a+fp/hard\libc.a(lib_a-strncmp.o)
                              ${package_root}\build\out\work\platform\bsp_core0\lib\liblwip4.a(def.o) (strncmp)
${vitis_install}/gnu/aarch32/nt/gcc-arm-none-eabi/bin//../aarch32-xilinx-eabi/usr/lib/thumb/v7-a+fp/hard\libc.a(lib_a-svfprintf.o)
                              ${vitis_install}/gnu/aarch32/nt/gcc-arm-none-eabi/bin//../aarch32-xilinx-eabi/usr/lib/thumb/v7-a+fp/hard\libc.a(lib_a-snprintf.o) (_svfprintf_r)
${vitis_install}/gnu/aarch32/nt/gcc-arm-none-eabi/bin//../aarch32-xilinx-eabi/usr/lib/thumb/v7-a+fp/hard\libc.a(lib_a-__call_atexit.o)
                              ${vitis_install}/gnu/aarch32/nt/gcc-arm-none-eabi/bin//../aarch32-xilinx-eabi/usr/lib/thumb/v7-a+fp/hard\libc.a(lib_a-exit.o) (__call_exitprocs)
${vitis_install}/gnu/aarch32/nt/gcc-arm-none-eabi/bin//../aarch32-xilinx-eabi/usr/lib/thumb/v7-a+fp/hard\libc.a(lib_a-dtoa.o)
                              ${vitis_install}/gnu/aarch32/nt/gcc-arm-none-eabi/bin//../aarch32-xilinx-eabi/usr/lib/thumb/v7-a+fp/hard\libc.a(lib_a-svfprintf.o) (_dtoa_r)
${vitis_install}/gnu/aarch32/nt/gcc-arm-none-eabi/bin//../aarch32-xilinx-eabi/usr/lib/thumb/v7-a+fp/hard\libc.a(lib_a-findfp.o)
                              ${vitis_install}/gnu/aarch32/nt/gcc-arm-none-eabi/bin//../aarch32-xilinx-eabi/usr/lib/thumb/v7-a+fp/hard\libc.a(lib_a-puts.o) (__sinit)
${vitis_install}/gnu/aarch32/nt/gcc-arm-none-eabi/bin//../aarch32-xilinx-eabi/usr/lib/thumb/v7-a+fp/hard\libc.a(lib_a-freer.o)
                              ${vitis_install}/gnu/aarch32/nt/gcc-arm-none-eabi/bin//../aarch32-xilinx-eabi/usr/lib/thumb/v7-a+fp/hard\libc.a(lib_a-malloc.o) (_free_r)
${vitis_install}/gnu/aarch32/nt/gcc-arm-none-eabi/bin//../aarch32-xilinx-eabi/usr/lib/thumb/v7-a+fp/hard\libc.a(lib_a-fvwrite.o)
                              ${vitis_install}/gnu/aarch32/nt/gcc-arm-none-eabi/bin//../aarch32-xilinx-eabi/usr/lib/thumb/v7-a+fp/hard\libc.a(lib_a-puts.o) (__sfvwrite_r)
${vitis_install}/gnu/aarch32/nt/gcc-arm-none-eabi/bin//../aarch32-xilinx-eabi/usr/lib/thumb/v7-a+fp/hard\libc.a(lib_a-fwalk.o)
                              ${vitis_install}/gnu/aarch32/nt/gcc-arm-none-eabi/bin//../aarch32-xilinx-eabi/usr/lib/thumb/v7-a+fp/hard\libc.a(lib_a-findfp.o) (_fwalk)
${vitis_install}/gnu/aarch32/nt/gcc-arm-none-eabi/bin//../aarch32-xilinx-eabi/usr/lib/thumb/v7-a+fp/hard\libc.a(lib_a-localeconv.o)
                              ${vitis_install}/gnu/aarch32/nt/gcc-arm-none-eabi/bin//../aarch32-xilinx-eabi/usr/lib/thumb/v7-a+fp/hard\libc.a(lib_a-svfprintf.o) (_localeconv_r)
${vitis_install}/gnu/aarch32/nt/gcc-arm-none-eabi/bin//../aarch32-xilinx-eabi/usr/lib/thumb/v7-a+fp/hard\libc.a(lib_a-locale.o)
                              ${vitis_install}/gnu/aarch32/nt/gcc-arm-none-eabi/bin//../aarch32-xilinx-eabi/usr/lib/thumb/v7-a+fp/hard\libc.a(lib_a-localeconv.o) (__global_locale)
${vitis_install}/gnu/aarch32/nt/gcc-arm-none-eabi/bin//../aarch32-xilinx-eabi/usr/lib/thumb/v7-a+fp/hard\libc.a(lib_a-mbtowc_r.o)
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
                              ${vitis_install}/gnu/aarch32/nt/gcc-arm-none-eabi/bin//../aarch32-xilinx-eabi/usr/lib/thumb/v7-a+fp/hard\libc.a(lib_a-makebuf.o) (_isatty_r)
${vitis_install}/gnu/aarch32/nt/gcc-arm-none-eabi/bin//../aarch32-xilinx-eabi/usr/lib/thumb/v7-a+fp/hard\libc.a(lib_a-signal.o)
                              ${vitis_install}/gnu/aarch32/nt/gcc-arm-none-eabi/bin//../aarch32-xilinx-eabi/usr/lib/thumb/v7-a+fp/hard\libc.a(lib_a-abort.o) (raise)
${vitis_install}/gnu/aarch32/nt/gcc-arm-none-eabi/bin//../aarch32-xilinx-eabi/usr/lib/thumb/v7-a+fp/hard\libc.a(lib_a-signalr.o)
                              ${vitis_install}/gnu/aarch32/nt/gcc-arm-none-eabi/bin//../aarch32-xilinx-eabi/usr/lib/thumb/v7-a+fp/hard\libc.a(lib_a-signal.o) (_kill_r)
${vitis_install}/gnu/aarch32/nt/gcc-arm-none-eabi/bin//../aarch32-xilinx-eabi/usr/lib/thumb/v7-a+fp/hard\libc.a(lib_a-wbuf.o)
                              ${vitis_install}/gnu/aarch32/nt/gcc-arm-none-eabi/bin//../aarch32-xilinx-eabi/usr/lib/thumb/v7-a+fp/hard\libc.a(lib_a-fputwc.o) (__swbuf_r)
${vitis_install}/gnu/aarch32/nt/gcc-arm-none-eabi/bin//../aarch32-xilinx-eabi/usr/lib/thumb/v7-a+fp/hard\libc.a(lib_a-wcrtomb.o)
                              ${vitis_install}/gnu/aarch32/nt/gcc-arm-none-eabi/bin//../aarch32-xilinx-eabi/usr/lib/thumb/v7-a+fp/hard\libc.a(lib_a-fputwc.o) (_wcrtomb_r)
${package_root}\build\out\work\platform\bsp_core0\lib\libxil.a(_exit.o)
                              ${vitis_install}/gnu/aarch32/nt/gcc-arm-none-eabi/bin//../aarch32-xilinx-eabi/usr/lib/thumb/v7-a+fp/hard\libc.a(lib_a-exit.o) (_exit)
${package_root}\build\out\work\platform\bsp_core0\lib\libxil.a(_sbrk.o)
                              ${vitis_install}/gnu/aarch32/nt/gcc-arm-none-eabi/bin//../aarch32-xilinx-eabi/usr/lib/thumb/v7-a+fp/hard\libc.a(lib_a-sbrkr.o) (_sbrk)
${package_root}\build\out\work\platform\bsp_core0\lib\libxil.a(close.o)
                              ${vitis_install}/gnu/aarch32/nt/gcc-arm-none-eabi/bin//../aarch32-xilinx-eabi/usr/lib/thumb/v7-a+fp/hard\libc.a(lib_a-closer.o) (_close)
${package_root}\build\out\work\platform\bsp_core0\lib\libxil.a(fstat.o)
                              ${vitis_install}/gnu/aarch32/nt/gcc-arm-none-eabi/bin//../aarch32-xilinx-eabi/usr/lib/thumb/v7-a+fp/hard\libc.a(lib_a-fstatr.o) (_fstat)
${package_root}\build\out\work\platform\bsp_core0\lib\libxil.a(getpid.o)
                              ${vitis_install}/gnu/aarch32/nt/gcc-arm-none-eabi/bin//../aarch32-xilinx-eabi/usr/lib/thumb/v7-a+fp/hard\libc.a(lib_a-signalr.o) (_getpid)
${package_root}\build\out\work\platform\bsp_core0\lib\libxil.a(isatty.o)
                              ${vitis_install}/gnu/aarch32/nt/gcc-arm-none-eabi/bin//../aarch32-xilinx-eabi/usr/lib/thumb/v7-a+fp/hard\libc.a(lib_a-isattyr.o) (_isatty)
${package_root}\build\out\work\platform\bsp_core0\lib\libxil.a(kill.o)
                              ${vitis_install}/gnu/aarch32/nt/gcc-arm-none-eabi/bin//../aarch32-xilinx-eabi/usr/lib/thumb/v7-a+fp/hard\libc.a(lib_a-signalr.o) (_kill)
${package_root}\build\out\work\platform\bsp_core0\lib\libxil.a(lseek.o)
                              ${vitis_install}/gnu/aarch32/nt/gcc-arm-none-eabi/bin//../aarch32-xilinx-eabi/usr/lib/thumb/v7-a+fp/hard\libc.a(lib_a-lseekr.o) (_lseek)
${package_root}\build\out\work\platform\bsp_core0\lib\libxil.a(read.o)
                              ${vitis_install}/gnu/aarch32/nt/gcc-arm-none-eabi/bin//../aarch32-xilinx-eabi/usr/lib/thumb/v7-a+fp/hard\libc.a(lib_a-readr.o) (_read)
${package_root}\build\out\work\platform\bsp_core0\lib\libxil.a(write.o)
                              ${vitis_install}/gnu/aarch32/nt/gcc-arm-none-eabi/bin//../aarch32-xilinx-eabi/usr/lib/thumb/v7-a+fp/hard\libc.a(lib_a-writer.o) (_write)
${package_root}\build\out\work\platform\bsp_core0\lib\libxil.a(inbyte.o)
                              ${package_root}\build\out\work\platform\bsp_core0\lib\libxil.a(read.o) (inbyte)

Allocating common symbols
Common symbol       size              file

netif_list          0x4               ${package_root}\build\out\work\platform\bsp_core0\lib\liblwip4.a(netif.o)
ip_data             0x18              ${package_root}\build\out\work\platform\bsp_core0\lib\liblwip4.a(ip.o)
tcp_active_pcbs_changed
                    0x1               ${package_root}\build\out\work\platform\bsp_core0\lib\liblwip4.a(tcp.o)
tcp_active_pcbs     0x4               ${package_root}\build\out\work\platform\bsp_core0\lib\liblwip4.a(tcp.o)
udp_pcbs            0x4               ${package_root}\build\out\work\platform\bsp_core0\lib\liblwip4.a(udp.o)
memp_memory_ARP_QUEUE_base
                    0x7bf             ${package_root}\build\out\work\platform\bsp_core0\lib\liblwip4.a(memp.o)
tcp_ticks           0x4               ${package_root}\build\out\work\platform\bsp_core0\lib\liblwip4.a(tcp.o)
tcp_listen_pcbs     0x4               ${package_root}\build\out\work\platform\bsp_core0\lib\liblwip4.a(tcp.o)
memp_memory_TCP_SEG_base
                    0x403f            ${package_root}\build\out\work\platform\bsp_core0\lib\liblwip4.a(memp.o)
bd_space            0x100000          ${package_root}\build\out\work\platform\bsp_core0\lib\liblwip4.a(xemacpsif_dma.o)
UndefinedExceptionAddr
                    0x4               ${package_root}\build\out\work\platform\bsp_core0\lib\libxil.a(xil_exception.o)
memp_memory_PBUF_POOL_base
                    0x7003f           ${package_root}\build\out\work\platform\bsp_core0\lib\liblwip4.a(memp.o)
mac_config          0x4               ${package_root}\build\out\work\platform\bsp_core0\lib\liblwip4.a(xemacpsif.o)
memp_memory_FRAG_PBUF_base
                    0x403f            ${package_root}\build\out\work\platform\bsp_core0\lib\liblwip4.a(memp.o)
NetIf               0x4               ${package_root}\build\out\work\platform\bsp_core0\lib\liblwip4.a(xemacpsif.o)
tcp_input_pcb       0x4               ${package_root}\build\out\work\platform\bsp_core0\lib\liblwip4.a(tcp_in.o)
PrefetchAbortAddr   0x4               ${package_root}\build\out\work\platform\bsp_core0\lib\libxil.a(xil_exception.o)
memp_memory_PBUF_base
                    0x43f             ${package_root}\build\out\work\platform\bsp_core0\lib\liblwip4.a(memp.o)
tcp_bound_pcbs      0x4               ${package_root}\build\out\work\platform\bsp_core0\lib\liblwip4.a(tcp.o)
pq_queue            0x8018            ${package_root}\build\out\work\platform\bsp_core0\lib\liblwip4.a(xpqueue.o)
memp_memory_TCP_PCB_LISTEN_base
                    0x23f             ${package_root}\build\out\work\platform\bsp_core0\lib\liblwip4.a(memp.o)
DataAbortAddr       0x4               ${package_root}\build\out\work\platform\bsp_core0\lib\libxil.a(xil_exception.o)
memp_memory_REASSDATA_base
                    0x17f             ${package_root}\build\out\work\platform\bsp_core0\lib\liblwip4.a(memp.o)
Xil_AssertStatus    0x4               ${package_root}\build\out\work\platform\bsp_core0\lib\libxil.a(xil_assert.o)
memp_memory_UDP_PCB_base
                    0x13f             ${package_root}\build\out\work\platform\bsp_core0\lib\liblwip4.a(memp.o)
pbuf_free_ooseq_pending
                    0x1               ${package_root}\build\out\work\platform\bsp_core0\lib\liblwip4.a(pbuf.o)
tcp_tw_pcbs         0x4               ${package_root}\build\out\work\platform\bsp_core0\lib\liblwip4.a(tcp.o)
lwip_stats          0xe0              ${package_root}\build\out\work\platform\bsp_core0\lib\liblwip4.a(stats.o)
netif_default       0x4               ${package_root}\build\out\work\platform\bsp_core0\lib\liblwip4.a(netif.o)
memp_memory_TCP_PCB_base
                    0x183f            ${package_root}\build\out\work\platform\bsp_core0\lib\liblwip4.a(memp.o)
phyaddrforemac      0x4               ${package_root}\build\out\work\platform\bsp_core0\lib\liblwip4.a(xadapter.o)

Discarded input sections

 .text          0x0000000000000000        0x0 ${vitis_install}/gnu/aarch32/nt/gcc-arm-none-eabi/bin//../aarch32-xilinx-eabi/usr/lib/thumb/v7-a+fp/hard/crti.o
 .data          0x0000000000000000        0x0 ${vitis_install}/gnu/aarch32/nt/gcc-arm-none-eabi/bin//../aarch32-xilinx-eabi/usr/lib/thumb/v7-a+fp/hard/crti.o
 .bss           0x0000000000000000        0x0 ${vitis_install}/gnu/aarch32/nt/gcc-arm-none-eabi/bin//../aarch32-xilinx-eabi/usr/lib/thumb/v7-a+fp/hard/crti.o
 .data          0x0000000000000000        0x4 ${vitis_install}/gnu/aarch32/nt/gcc-arm-none-eabi/bin//../aarch32-xilinx-eabi/usr/lib/thumb/v7-a+fp/hard/crtbegin.o
 .rodata        0x0000000000000000       0x24 ${vitis_install}/gnu/aarch32/nt/gcc-arm-none-eabi/bin//../aarch32-xilinx-eabi/usr/lib/thumb/v7-a+fp/hard/crtbegin.o
 .text          0x0000000000000000        0x0 ${package_root}\build\out\work\application\build\software\0.o
 .data          0x0000000000000000        0x0 ${package_root}\build\out\work\application\build\software\0.o
 .bss           0x0000000000000000        0x0 ${package_root}\build\out\work\application\build\software\0.o
 .text.fusion_quant_audio
                0x0000000000000000       0xa8 ${package_root}\build\out\work\application\build\software\0.o
 .text.fusion_image_inputs
                0x0000000000000000       0x70 ${package_root}\build\out\work\application\build\software\0.o
 .text          0x0000000000000000        0x0 ${package_root}\build\out\work\application\build\software\1.o
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
 .data          0x0000000000000000        0x0 ${vitis_install}/gnu/aarch32/nt/gcc-arm-none-eabi/bin//../aarch32-xilinx-eabi/usr/lib/thumb/v7-a+fp/hard/crtend.o
 .bss           0x0000000000000000        0x0 ${vitis_install}/gnu/aarch32/nt/gcc-arm-none-eabi/bin//../aarch32-xilinx-eabi/usr/lib/thumb/v7-a+fp/hard/crtend.o
 .rodata        0x0000000000000000       0x24 ${vitis_install}/gnu/aarch32/nt/gcc-arm-none-eabi/bin//../aarch32-xilinx-eabi/usr/lib/thumb/v7-a+fp/hard/crtend.o
 .eh_frame      0x0000000000000000        0x4 ${vitis_install}/gnu/aarch32/nt/gcc-arm-none-eabi/bin//../aarch32-xilinx-eabi/usr/lib/thumb/v7-a+fp/hard/crtend.o
 .text          0x0000000000000000        0x0 ${vitis_install}/gnu/aarch32/nt/gcc-arm-none-eabi/bin//../aarch32-xilinx-eabi/usr/lib/thumb/v7-a+fp/hard/crtn.o
 .data          0x0000000000000000        0x0 ${vitis_install}/gnu/aarch32/nt/gcc-arm-none-eabi/bin//../aarch32-xilinx-eabi/usr/lib/thumb/v7-a+fp/hard/crtn.o
 .bss           0x0000000000000000        0x0 ${vitis_install}/gnu/aarch32/nt/gcc-arm-none-eabi/bin//../aarch32-xilinx-eabi/usr/lib/thumb/v7-a+fp/hard/crtn.o

Memory Configuration

Name             Origin             Length             Attributes
ps7_ddr_0        0x0000000000100000 0x0000000007f00000
ps7_ram_0        0x0000000000000000 0x0000000000030000
ps7_ram_1        0x00000000ffff0000 0x000000000000fe00
*default*        0x0000000000000000 0xffffffffffffffff

Linker script and memory map

LOAD ${vitis_install}/gnu/aarch32/nt/gcc-arm-none-eabi/bin//../aarch32-xilinx-eabi/usr/lib/thumb/v7-a+fp/hard/crti.o
LOAD ${vitis_install}/gnu/aarch32/nt/gcc-arm-none-eabi/bin//../aarch32-xilinx-eabi/usr/lib/thumb/v7-a+fp/hard/crtbegin.o
LOAD ${package_root}\build\out\work\application\build\software\0.o
LOAD ${package_root}\build\out\work\application\build\software\1.o
LOAD ${package_root}\build\out\work\application\build\software\2.o
LOAD ${package_root}\build\out\work\application\build\software\3.o
LOAD ${package_root}\build\out\work\application\build\software\4.o
LOAD ${package_root}\build\out\work\application\build\software\5.o
LOAD ${package_root}\build\out\work\application\build\software\6.o
LOAD ${package_root}\build\out\work\application\build\software\7.o
LOAD ${package_root}\build\out\work\application\build\software\8.o
LOAD ${package_root}\build\out\work\application\build\software\9.o
LOAD ${package_root}\build\out\work\application\build\software\10.o
LOAD ${package_root}\build\out\work\application\build\software\11.o
LOAD ${package_root}\build\out\work\application\build\software\12.o
LOAD ${package_root}\build\out\work\application\build\software\13.o
LOAD ${package_root}\build\out\work\application\build\software\14.o
LOAD ${package_root}\build\out\work\application\build\software\15.o
LOAD ${package_root}\build\out\work\application\build\software\16.o
LOAD ${package_root}\build\out\work\application\build\software\17.o
LOAD ${package_root}\build\out\work\application\build\software\18.o
LOAD ${package_root}\build\out\work\application\build\software\19.o
LOAD ${package_root}\build\out\work\application\build\software\20.o
LOAD ${package_root}\build\out\work\application\build\software\21.o
LOAD ${package_root}\build\out\work\application\build\software\22.o
LOAD ${package_root}\build\out\work\application\build\software\23.o
LOAD ${package_root}\build\out\work\application\build\software\24.o
LOAD ${package_root}\build\out\work\application\build\software\25.o
LOAD ${package_root}\build\out\work\application\build\software\26.o
LOAD ${package_root}\build\out\work\application\build\software\27.o
LOAD ${package_root}\build\out\work\application\build\software\28.o
LOAD ${package_root}\build\out\work\application\build\software\29.o
LOAD ${package_root}\build\out\work\application\build\software\30.o
LOAD ${package_root}\build\out\work\application\build\software\31.o
LOAD ${package_root}\build\out\work\application\build\software\32.o
LOAD ${package_root}\build\out\work\application\build\software\33.o
LOAD ${package_root}\build\out\work\application\build\software\34.o
                0x0000000000020000                _STACK_SIZE = 0x20000
                0x0000000000200000                _HEAP_SIZE = 0x200000
                0x0000000000020000                _STACK_SIZE = DEFINED (_STACK_SIZE)?_STACK_SIZE:0x2000
                0x0000000000200000                _HEAP_SIZE = DEFINED (_HEAP_SIZE)?_HEAP_SIZE:0x2000
                0x0000000000000400                _ABORT_STACK_SIZE = DEFINED (_ABORT_STACK_SIZE)?_ABORT_STACK_SIZE:0x400
                0x0000000000000800                _SUPERVISOR_STACK_SIZE = DEFINED (_SUPERVISOR_STACK_SIZE)?_SUPERVISOR_STACK_SIZE:0x800
                0x0000000000000400                _IRQ_STACK_SIZE = DEFINED (_IRQ_STACK_SIZE)?_IRQ_STACK_SIZE:0x400
                0x0000000000000400                _FIQ_STACK_SIZE = DEFINED (_FIQ_STACK_SIZE)?_FIQ_STACK_SIZE:0x400
                0x0000000000000400                _UNDEF_STACK_SIZE = DEFINED (_UNDEF_STACK_SIZE)?_UNDEF_STACK_SIZE:0x400

.text           0x0000000000100000    0x4a5aa
 *(.vectors)
 .vectors       0x0000000000100000      0x12c ${package_root}\build\out\work\platform\bsp_core0\lib\libxil.a(asm_vectors.o)
                0x0000000000100000                _vector_table
 *(.boot)
 .boot          0x000000000010012c      0x3b0 ${package_root}\build\out\work\platform\bsp_core0\lib\libxil.a(boot.o)
                0x000000000010012c                _prestart
                0x000000000010012c                _boot
 *(.text)
 .text          0x00000000001004dc       0xa8 ${vitis_install}/gnu/aarch32/nt/gcc-arm-none-eabi/bin//../aarch32-xilinx-eabi/usr/lib/thumb/v7-a+fp/hard/crtbegin.o
 .text          0x0000000000100584      0xca4 ${package_root}\build\out\work\platform\bsp_core0\lib\liblwip4.a(etharp.o)
                0x0000000000100958                etharp_tmr
                0x0000000000100a5c                etharp_cleanup_netif
                0x0000000000100ab8                etharp_find_addr
                0x0000000000100b24                etharp_get_entry
                0x0000000000100b8c                etharp_input
                0x0000000000100d98                etharp_query
                0x0000000000101050                etharp_output
                0x00000000001011e4                etharp_request
 .text          0x0000000000101228      0x1cc ${package_root}\build\out\work\platform\bsp_core0\lib\liblwip4.a(ethernet.o)
                0x0000000000101228                ethernet_input
                0x0000000000101368                ethernet_output
 .text          0x00000000001013f4       0x20 ${package_root}\build\out\work\platform\bsp_core0\lib\liblwip4.a(init.o)
                0x00000000001013f4                lwip_init
 .text          0x0000000000101414      0x628 ${package_root}\build\out\work\platform\bsp_core0\lib\liblwip4.a(ip4.o)
                0x0000000000101414                ip4_route
                0x00000000001014cc                ip4_input
                0x0000000000101820                ip4_output_if_src
                0x0000000000101964                ip4_output_if
                0x00000000001019a8                ip4_output
 .text          0x0000000000101a3c      0x40c ${package_root}\build\out\work\platform\bsp_core0\lib\liblwip4.a(ip4_addr.o)
                0x0000000000101a3c                ip4_addr_isbroadcast_u32
                0x0000000000101a94                ip4_addr_netmask_valid
                0x0000000000101ae4                ip4addr_aton
                0x0000000000101cf0                ipaddr_addr
                0x0000000000101d14                ip4addr_ntoa_r
                0x0000000000101e38                ip4addr_ntoa
 .text          0x0000000000101e48      0xa20 ${package_root}\build\out\work\platform\bsp_core0\lib\liblwip4.a(ip4_frag.o)
                0x0000000000102040                ip_reass_tmr
                0x0000000000102098                ip4_reass
                0x00000000001025e4                ip4_frag
 .text          0x0000000000102868      0x244 ${package_root}\build\out\work\platform\bsp_core0\lib\liblwip4.a(memp.o)
                0x00000000001028d8                memp_init_pool
                0x0000000000102934                memp_init
                0x00000000001029d4                memp_malloc_pool
                0x00000000001029e4                memp_malloc
                0x0000000000102a0c                memp_free_pool
                0x0000000000102a50                memp_free
 .text          0x0000000000102aac      0x3b0 ${package_root}\build\out\work\platform\bsp_core0\lib\liblwip4.a(netif.o)
                0x0000000000102ac0                netif_init
                0x0000000000102ac4                netif_input
                0x0000000000102ad8                netif_find
                0x0000000000102b48                netif_set_ipaddr
                0x0000000000102bec                netif_set_addr
                0x0000000000102c54                netif_add
                0x0000000000102cd4                netif_set_gw
                0x0000000000102ce4                netif_set_netmask
                0x0000000000102cf4                netif_set_default
                0x0000000000102d04                netif_set_up
                0x0000000000102d30                netif_set_down
                0x0000000000102d50                netif_remove
                0x0000000000102e1c                netif_set_link_up
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
                0x0000000000108e40                eth_link_detect
 .text          0x0000000000108f84      0x38c ${package_root}\build\out\work\platform\bsp_core0\lib\liblwip4.a(xemacpsif.o)
                0x000000000010903c                xemacpsif_input
                0x00000000001090fc                HandleEmacPsError
                0x0000000000109194                HandleTxErrors
                0x00000000001091e4                xemacpsif_init
                0x0000000000109304                xemacpsif_resetrx_on_no_rxdata
 .text          0x0000000000109310      0xb88 ${package_root}\build\out\work\platform\bsp_core0\lib\liblwip4.a(xemacpsif_dma.o)
                0x0000000000109310                is_tx_space_available
                0x0000000000109318                process_sent_bds
                0x00000000001093ec                emacps_send_handler
                0x0000000000109404                emacps_sgsend
                0x0000000000109640                setup_rx_bds
                0x000000000010978c                clean_dma_txdescs
                0x00000000001097e0                init_dma
                0x0000000000109bc0                resetrx_on_no_rxdata
                0x0000000000109c0c                emacps_recv_handler
                0x0000000000109d3c                free_txrx_pbufs
                0x0000000000109d98                free_onlytx_pbufs
                0x0000000000109dd8                reset_dma
                0x0000000000109e38                emac_disable_intr
                0x0000000000109e68                emac_enable_intr
 .text          0x0000000000109e98      0x3d0 ${package_root}\build\out\work\platform\bsp_core0\lib\liblwip4.a(xemacpsif_hw.o)
                0x0000000000109e98                emacps_error_handler
                0x0000000000109f74                xemacps_lookup_config
                0x0000000000109f90                init_emacps
                0x000000000010a168                init_emacps_on_error
                0x000000000010a1ec                setup_isr
                0x000000000010a244                start_emacps
                0x000000000010a248                restart_emacps_transmitter
 .text          0x000000000010a268      0x104 ${package_root}\build\out\work\platform\bsp_core0\lib\liblwip4.a(xpqueue.o)
                0x000000000010a268                pq_create_queue
                0x000000000010a2cc                pq_enqueue
                0x000000000010a31c                pq_dequeue
                0x000000000010a360                pq_qlength
 .text          0x000000000010a36c      0x204 ${package_root}\build\out\work\platform\bsp_core0\lib\liblwip4.a(def.o)
                0x000000000010a36c                lwip_htons
                0x000000000010a378                lwip_htonl
                0x000000000010a380                lwip_strnstr
                0x000000000010a40c                lwip_stricmp
                0x000000000010a484                lwip_strnicmp
                0x000000000010a4e0                lwip_itoa
 .text          0x000000000010a570      0x388 ${package_root}\build\out\work\platform\bsp_core0\lib\liblwip4.a(icmp.o)
                0x000000000010a674                icmp_input
                0x000000000010a8d8                icmp_dest_unreach
                0x000000000010a8e8                icmp_time_exceeded
 .text          0x000000000010a8f8      0x3b8 ${package_root}\build\out\work\platform\bsp_core0\lib\liblwip4.a(inet_chksum.o)
                0x000000000010a8f8                lwip_standard_chksum
                0x000000000010aa3c                inet_chksum_pseudo
                0x000000000010ab14                ip_chksum_pseudo
                0x000000000010ab18                inet_chksum_pseudo_partial
                0x000000000010ac18                ip_chksum_pseudo_partial
                0x000000000010ac1c                inet_chksum
                0x000000000010ac30                inet_chksum_pbuf
 .text          0x000000000010acb0      0x830 ${package_root}\build\out\work\platform\bsp_core0\lib\libxil.a(xaxidma.o)
                0x000000000010acb0                XAxiDma_Reset
                0x000000000010adb0                XAxiDma_ResetIsDone
                0x000000000010adfc                XAxiDma_CfgInitialize
                0x000000000010b030                XAxiDma_Pause
                0x000000000010b0dc                XAxiDma_Resume
                0x000000000010b304                XAxiDma_Busy
                0x000000000010b320                XAxiDma_SelectKeyHole
                0x000000000010b348                XAxiDma_SelectCyclicMode
                0x000000000010b370                XAxiDma_SimpleTransfer
 .text          0x000000000010b4e0      0xd10 ${package_root}\build\out\work\platform\bsp_core0\lib\libxil.a(xaxidma_bdring.o)
                0x000000000010b4e0                XAxiDma_UpdateBdRingCDesc
                0x000000000010b654                XAxiDma_BdRingCreate
                0x000000000010b7ec                XAxiDma_BdRingClone
                0x000000000010b8f0                XAxiDma_StartBdRingHw
                0x000000000010ba1c                XAxiDma_BdRingStart
                0x000000000010ba3c                XAxiDma_BdRingSetCoalesce
                0x000000000010ba88                XAxiDma_BdRingGetCoalesce
                0x000000000010baa4                XAxiDma_BdRingAlloc
                0x000000000010bb28                XAxiDma_BdRingUnAlloc
                0x000000000010bbdc                XAxiDma_BdRingToHw
                0x000000000010be04                XAxiDma_BdRingFromHw
                0x000000000010bf20                XAxiDma_BdRingFree
                0x000000000010bfb4                XAxiDma_BdRingCheck
                0x000000000010c138                XAxiDma_BdRingDumpRegs
 .text          0x000000000010c1f0       0x38 ${package_root}\build\out\work\platform\bsp_core0\lib\libxil.a(xaxidma_sinit.o)
                0x000000000010c1f0                XAxiDma_LookupConfig
                0x000000000010c20c                XAxiDma_LookupConfigBaseAddr
 .text          0x000000000010c228      0xc74 ${package_root}\build\out\work\platform\bsp_core0\lib\libxil.a(xaxivdma.o)
                0x000000000010c228                XAxiVdma_GetChannel
                0x000000000010c248                XAxiVdma_CfgInitialize
                0x000000000010c5a0                XAxiVdma_Reset
                0x000000000010c5d0                XAxiVdma_ResetNotDone
                0x000000000010c5fc                XAxiVdma_IsBusy
                0x000000000010c634                XAxiVdma_CurrFrameStore
                0x000000000010c65c                XAxiVdma_GetVersion
                0x000000000010c668                XAxiVdma_GetStatus
                0x000000000010c6a0                XAxiVdma_SetLineBufThreshold
                0x000000000010c720                XAxiVdma_FsyncSrcSelect
                0x000000000010c7bc                XAxiVdma_GenLockSourceSelect
                0x000000000010c890                XAxiVdma_StartParking
                0x000000000010c914                XAxiVdma_StopParking
                0x000000000010c944                XAxiVdma_StartFrmCntEnable
                0x000000000010c978                XAxiVdma_SetBdAddrs
                0x000000000010c9d8                XAxiVdma_StartWriteFrame
                0x000000000010c9f4                XAxiVdma_StartReadFrame
                0x000000000010ca10                XAxiVdma_DmaConfig
                0x000000000010ca54                XAxiVdma_DmaSetBufferAddr
                0x000000000010ca9c                XAxiVdma_DmaStart
                0x000000000010cadc                XAxiVdma_DmaStop
                0x000000000010cb0c                XAxiVdma_DmaRegisterDump
                0x000000000010cb3c                XAxiVdma_SetFrameCounter
                0x000000000010cc44                XAxiVdma_GetFrameCounter
                0x000000000010cd5c                XAxiVdma_SetFrmStore
                0x000000000010cdd0                XAxiVdma_GetFrmStore
                0x000000000010ce0c                XAxiVdma_GetDmaChannelErrors
                0x000000000010ce4c                XAxiVdma_ClearDmaChannelErrors
 .text          0x000000000010ce9c      0xa18 ${package_root}\build\out\work\platform\bsp_core0\lib\libxil.a(xaxivdma_channel.o)
                0x000000000010d2b8                XAxiVdma_ChannelInit
                0x000000000010d350                XAxiVdma_ChannelResetNotDone
                0x000000000010d360                XAxiVdma_ChannelReset
                0x000000000010d370                XAxiVdma_ChannelIsRunning
                0x000000000010d38c                XAxiVdma_ChannelIsBusy
                0x000000000010d3ac                XAxiVdma_ChannelErrors
                0x000000000010d3bc                XAxiVdma_ClearChannelErrors
                0x000000000010d3d0                XAxiVdma_ChannelGetStatus
                0x000000000010d3dc                XAxiVdma_ChannelStartParking
                0x000000000010d410                XAxiVdma_ChannelStopParking
                0x000000000010d424                XAxiVdma_ChannelStartFrmCntEnable
                0x000000000010d438                XAxiVdma_ChannelSetBdAddrs
                0x000000000010d4f8                XAxiVdma_ChannelConfig
                0x000000000010d510                XAxiVdma_ChannelSetBufferAddr
                0x000000000010d660                XAxiVdma_ChannelStartTransfer
                0x000000000010d6f4                XAxiVdma_ChannelStart
                0x000000000010d70c                XAxiVdma_ChannelStop
                0x000000000010d734                XAxiVdma_ChannelRegisterDump
                0x000000000010d7a0                XAxiVdma_ChannelSetFrmCnt
                0x000000000010d800                XAxiVdma_ChannelGetFrmCnt
                0x000000000010d840                XAxiVdma_ChannelEnableIntr
                0x000000000010d85c                XAxiVdma_ChannelDisableIntr
                0x000000000010d884                XAxiVdma_ChannelGetPendingIntr
                0x000000000010d894                XAxiVdma_ChannelIntrClear
                0x000000000010d8a4                XAxiVdma_ChannelGetEnabledIntr
 .text          0x000000000010d8b4      0x2c4 ${package_root}\build\out\work\platform\bsp_core0\lib\libxil.a(xaxivdma_intr.o)
                0x000000000010d8b4                XAxiVdma_IntrEnable
                0x000000000010d8dc                XAxiVdma_IntrDisable
                0x000000000010d904                XAxiVdma_IntrGetPending
                0x000000000010d930                XAxiVdma_IntrClear
                0x000000000010d958                XAxiVdma_MaskS2MMErrIntr
                0x000000000010d9a8                XAxiVdma_ReadIntrHandler
                0x000000000010da34                XAxiVdma_WriteIntrHandler
                0x000000000010dabc                XAxiVdma_SetCallBack
 .text          0x000000000010db78       0x1c ${package_root}\build\out\work\platform\bsp_core0\lib\libxil.a(xaxivdma_sinit.o)
                0x000000000010db78                XAxiVdma_LookupConfig
 .text          0x000000000010db94      0x558 ${package_root}\build\out\work\platform\bsp_core0\lib\libxil.a(xemacps.o)
                0x000000000010db94                XEmacPs_StubHandler
                0x000000000010dbbc                XEmacPs_Start
                0x000000000010dd04                XEmacPs_Stop
                0x000000000010dd94                XEmacPs_SetQueuePtr
                0x000000000010de3c                XEmacPs_Reset
                0x000000000010e040                XEmacPs_CfgInitialize
 .text          0x000000000010e0ec      0x2b0 ${package_root}\build\out\work\platform\bsp_core0\lib\libxil.a(xemacps_intr.o)
                0x000000000010e0ec                XEmacPs_SetHandler
                0x000000000010e1ec                XEmacPs_IntrHandler
 .text          0x000000000010e39c      0xf60 ${package_root}\build\out\work\platform\bsp_core0\lib\libxil.a(xemacps_control.o)
                0x000000000010e39c                XEmacPs_SetMacAddress
                0x000000000010e4b4                XEmacPs_GetMacAddress
                0x000000000010e5c0                XEmacPs_SetHash
                0x000000000010e72c                XEmacPs_DeleteHash
                0x000000000010e898                XEmacPs_ClearHash
                0x000000000010e918                XEmacPs_GetHash
                0x000000000010e9c4                XEmacPs_SetTypeIdCheck
                0x000000000010ea88                XEmacPs_SetOptions
                0x000000000010ec20                XEmacPs_ClearOptions
                0x000000000010edb4                XEmacPs_GetOptions
                0x000000000010ee34                XEmacPs_SendPausePacket
                0x000000000010eee0                XEmacPs_GetOperatingSpeed
                0x000000000010ef80                XEmacPs_SetOperatingSpeed
                0x000000000010f058                XEmacPs_SetMdioDivisor
                0x000000000010f104                XEmacPs_PhyRead
                0x000000000010f1ac                XEmacPs_PhyWrite
                0x000000000010f24c                XEmacPs_DMABLengthUpdate
 .text          0x000000000010f2fc      0x83c ${package_root}\build\out\work\platform\bsp_core0\lib\libxil.a(xemacps_bdring.o)
                0x000000000010f2fc                XEmacPs_BdRingCreate
                0x000000000010f41c                XEmacPs_BdRingClone
                0x000000000010f4f4                XEmacPs_BdRingAlloc
                0x000000000010f56c                XEmacPs_BdRingUnAlloc
                0x000000000010f65c                XEmacPs_BdRingToHw
                0x000000000010f708                XEmacPs_BdRingFromHwTx
                0x000000000010f814                XEmacPs_BdRingFromHwRx
                0x000000000010f8fc                XEmacPs_BdRingFree
                0x000000000010f984                XEmacPs_BdRingCheck
                0x000000000010fb20                XEmacPs_BdRingPtrReset
 .text          0x000000000010fb38      0x36c ${package_root}\build\out\work\platform\bsp_core0\lib\libxil.a(xgpio.o)
                0x000000000010fb38                XGpio_CfgInitialize
                0x000000000010fba4                XGpio_SetDataDirection
                0x000000000010fc60                XGpio_GetDataDirection
                0x000000000010fd28                XGpio_DiscreteRead
                0x000000000010fdec                XGpio_DiscreteWrite
 .text          0x000000000010fea4       0x94 ${package_root}\build\out\work\platform\bsp_core0\lib\libxil.a(xgpio_sinit.o)
                0x000000000010fea4                XGpio_LookupConfig
                0x000000000010fec0                XGpio_Initialize
 .text          0x000000000010ff38      0x398 ${package_root}\build\out\work\platform\bsp_core0\lib\libxil.a(xscugic_hw.o)
                0x000000000010ff38                XScuGic_DeviceInitialize
                0x0000000000110018                XScuGic_DeviceInterruptHandler
                0x0000000000110068                XScuGic_RegisterHandler
                0x000000000011009c                XScuGic_SetPriTrigTypeByDistAddr
                0x0000000000110174                XScuGic_GetPriTrigTypeByDistAddr
                0x000000000011023c                XScuGic_InterruptUnmapFromCpuByDistAddr
                0x00000000001102a4                XScuGic_UnmapAllInterruptsFromCpuByDistAddr
 .text          0x00000000001102d0      0xafc ${package_root}\build\out\work\platform\bsp_core0\lib\libxil.a(xscugic.o)
                0x0000000000110320                XScuGic_Connect
                0x00000000001103f8                XScuGic_Disconnect
                0x00000000001104c4                XScuGic_Enable
                0x000000000011057c                XScuGic_Disable
                0x0000000000110634                XScuGic_SoftwareIntr
                0x0000000000110720                XScuGic_SetPriorityTriggerType
                0x0000000000110858                XScuGic_GetPriorityTriggerType
                0x0000000000110984                XScuGic_InterruptMaptoCpu
                0x00000000001109c4                XScuGic_InterruptUnmapFromCpu
                0x0000000000110a34                XScuGic_UnmapAllInterruptsFromCpu
                0x0000000000110ab0                XScuGic_Stop
                0x0000000000110b8c                XScuGic_CfgInitialize
                0x0000000000110d6c                XScuGic_SetCpuID
                0x0000000000110dbc                XScuGic_GetCpuID
 .text          0x0000000000110dcc       0x10 ${package_root}\build\out\work\platform\bsp_core0\lib\libxil.a(outbyte.o)
                0x0000000000110dcc                outbyte
 .text          0x0000000000110ddc       0x28 ${package_root}\build\out\work\platform\bsp_core0\lib\libxil.a(print.o)
                0x0000000000110ddc                print
 .text          0x0000000000110e04       0x78 ${package_root}\build\out\work\platform\bsp_core0\lib\libxil.a(vectors.o)
                0x0000000000110e04                FIQInterrupt
                0x0000000000110e18                IRQInterrupt
                0x0000000000110e2c                UndefinedException
                0x0000000000110e40                SWInterrupt
                0x0000000000110e54                DataAbortInterrupt
                0x0000000000110e68                PrefetchAbortInterrupt
 .text          0x0000000000110e7c       0x78 ${package_root}\build\out\work\platform\bsp_core0\lib\libxil.a(xil-crt0.o)
                0x0000000000110e90                _start
 .text          0x0000000000110ef4       0x70 ${package_root}\build\out\work\platform\bsp_core0\lib\libxil.a(xil_assert.o)
                0x0000000000110ef4                Xil_Assert
                0x0000000000110f50                Xil_AssertSetCallback
                0x0000000000110f60                XNullHandler
 .text          0x0000000000110f64      0x994 ${package_root}\build\out\work\platform\bsp_core0\lib\libxil.a(xil_cache.o)
                0x0000000000110fb8                Xil_DCacheInvalidateLine
                0x0000000000110ff0                Xil_DCacheInvalidateRange
                0x00000000001110d8                Xil_DCacheFlushLine
                0x0000000000111124                Xil_DCacheFlushRange
                0x0000000000111178                Xil_DCacheStoreLine
                0x00000000001111b0                Xil_ICacheDisable
                0x00000000001111e8                Xil_ICacheInvalidateLine
                0x0000000000111220                Xil_ICacheInvalidateRange
                0x0000000000111278                Xil_L1DCacheInvalidate
                0x0000000000111330                Xil_L1DCacheEnable
                0x0000000000111350                Xil_L1DCacheInvalidateLine
                0x0000000000111368                Xil_L1DCacheInvalidateRange
                0x00000000001113b0                Xil_L1DCacheFlush
                0x0000000000111440                Xil_L1DCacheDisable
                0x0000000000111458                Xil_DCacheFlush
                0x00000000001114b4                Xil_DCacheDisable
                0x00000000001114e4                Xil_L1DCacheFlushLine
                0x00000000001114fc                Xil_L1DCacheFlushRange
                0x0000000000111544                Xil_L1DCacheStoreLine
                0x000000000011155c                Xil_L1ICacheEnable
                0x0000000000111578                Xil_L1ICacheDisable
                0x0000000000111594                Xil_L1ICacheInvalidate
                0x00000000001115ac                Xil_L1ICacheInvalidateLine
                0x00000000001115c4                Xil_L1ICacheInvalidateRange
                0x000000000011160c                Xil_L2CacheDisable
                0x0000000000111624                Xil_L2CacheInvalidate
                0x0000000000111690                Xil_DCacheInvalidate
                0x00000000001116b0                Xil_ICacheInvalidate
                0x0000000000111738                Xil_L2CacheEnable
                0x0000000000111750                Xil_DCacheEnable
                0x0000000000111774                Xil_ICacheEnable
                0x00000000001117a4                Xil_L2CacheInvalidateLine
                0x00000000001117b8                Xil_L2CacheInvalidateRange
                0x0000000000111820                Xil_L2CacheFlush
                0x0000000000111864                Xil_L2CacheFlushLine
                0x000000000011187c                Xil_L2CacheFlushRange
                0x00000000001118e4                Xil_L2CacheStoreLine
 .text          0x00000000001118f8       0x70 ${package_root}\build\out\work\platform\bsp_core0\lib\libxil.a(xil_exception.o)
                0x00000000001118fc                Xil_DataAbortHandler
                0x0000000000111900                Xil_PrefetchAbortHandler
                0x0000000000111904                Xil_UndefinedExceptionHandler
                0x0000000000111908                Xil_ExceptionInit
                0x000000000011190c                Xil_ExceptionRegisterHandler
                0x0000000000111924                Xil_GetExceptionRegisterHandler
                0x0000000000111944                Xil_ExceptionRemoveHandler
 .text          0x0000000000111968       0xd4 ${package_root}\build\out\work\platform\bsp_core0\lib\libxil.a(xil_mmu.o)
                0x0000000000111968                Xil_SetTlbAttributes
                0x00000000001119ac                Xil_EnableMMU
                0x00000000001119d0                Xil_DisableMMU
                0x00000000001119f8                Xil_MemMap
 .text          0x0000000000111a3c        0x8 ${package_root}\build\out\work\platform\bsp_core0\lib\libxil.a(xil_sleepcommon.o)
                0x0000000000111a3c                sleep
                0x0000000000111a40                usleep
 .text          0x0000000000111a44       0x4c ${package_root}\build\out\work\platform\bsp_core0\lib\libxil.a(xtime_l.o)
                0x0000000000111a44                XTime_SetTime
                0x0000000000111a68                XTime_GetTime
 .text          0x0000000000111a90       0x88 ${package_root}\build\out\work\platform\bsp_core0\lib\libxil.a(xuartps_hw.o)
                0x0000000000111a90                XUartPs_SendByte
                0x0000000000111aa8                XUartPs_RecvByte
                0x0000000000111ac4                XUartPs_ResetHw
 .text          0x0000000000111b18       0x3c ${package_root}\build\out\work\platform\bsp_core0\lib\libxil.a(cpu_init.o)
                0x0000000000111b18                __cpu_init
 .text          0x0000000000111b54       0x48 ${package_root}\build\out\work\platform\bsp_core0\lib\libxil.a(sleep.o)
                0x0000000000111b54                sleep_A9
 .text          0x0000000000111b9c       0x44 ${package_root}\build\out\work\platform\bsp_core0\lib\libxil.a(usleep.o)
                0x0000000000111b9c                usleep_A9
 .text          0x0000000000111be0       0x8c ${vitis_install}/gnu/aarch32/nt/gcc-arm-none-eabi/bin//../aarch32-xilinx-eabi/usr/lib/thumb/v7-a+fp/hard\libm.a(lib_a-sf_ceil.o)
                0x0000000000111be0                ceilf
 .text          0x0000000000111c6c       0xe8 ${vitis_install}/gnu/aarch32/nt/gcc-arm-none-eabi/bin//../aarch32-xilinx-eabi/usr/lib/thumb/v7-a+fp/hard\libm.a(lib_a-sf_exp.o)
                0x0000000000111c6c                expf
 .text          0x0000000000111d54       0x98 ${vitis_install}/gnu/aarch32/nt/gcc-arm-none-eabi/bin//../aarch32-xilinx-eabi/usr/lib/thumb/v7-a+fp/hard\libm.a(lib_a-sf_floor.o)
                0x0000000000111d54                floorf
 .text          0x0000000000111dec       0x3c ${vitis_install}/gnu/aarch32/nt/gcc-arm-none-eabi/bin//../aarch32-xilinx-eabi/usr/lib/thumb/v7-a+fp/hard\libm.a(lib_a-sf_fmax.o)
                0x0000000000111dec                fmaxf
 .text          0x0000000000111e28       0x3c ${vitis_install}/gnu/aarch32/nt/gcc-arm-none-eabi/bin//../aarch32-xilinx-eabi/usr/lib/thumb/v7-a+fp/hard\libm.a(lib_a-sf_fmin.o)
                0x0000000000111e28                fminf
 .text          0x0000000000111e64       0x3c ${vitis_install}/gnu/aarch32/nt/gcc-arm-none-eabi/bin//../aarch32-xilinx-eabi/usr/lib/thumb/v7-a+fp/hard\libm.a(lib_a-sf_fpclassify.o)
                0x0000000000111e64                __fpclassifyf
 .text          0x0000000000111ea0       0x50 ${vitis_install}/gnu/aarch32/nt/gcc-arm-none-eabi/bin//../aarch32-xilinx-eabi/usr/lib/thumb/v7-a+fp/hard\libm.a(lib_a-sf_round.o)
                0x0000000000111ea0                roundf
 .text          0x0000000000111ef0       0x44 ${vitis_install}/gnu/aarch32/nt/gcc-arm-none-eabi/bin//../aarch32-xilinx-eabi/usr/lib/thumb/v7-a+fp/hard\libm.a(lib_a-wf_sqrt.o)
                0x0000000000111ef0                sqrtf
 .text          0x0000000000111f34        0x8 ${vitis_install}/gnu/aarch32/nt/gcc-arm-none-eabi/bin//../aarch32-xilinx-eabi/usr/lib/thumb/v7-a+fp/hard\libm.a(lib_a-ef_sqrt.o)
                0x0000000000111f34                __ieee754_sqrtf
 .text          0x0000000000111f3c       0x94 ${vitis_install}/gnu/aarch32/nt/gcc-arm-none-eabi/bin//../aarch32-xilinx-eabi/usr/lib/thumb/v7-a+fp/hard\libm.a(lib_a-math_errf.o)
                0x0000000000111f6c                __math_uflowf
                0x0000000000111f78                __math_may_uflowf
                0x0000000000111f84                __math_oflowf
                0x0000000000111f90                __math_divzerof
                0x0000000000111fb4                __math_invalidf
 .text          0x0000000000111fd0      0x278 ${vitis_install}/gnu/aarch32/nt/gcc-arm-none-eabi/bin//../aarch32-xilinx-eabi/usr/lib/thumb/v7-a+fp/hard\libgcc.a(_udivsi3.o)
                0x0000000000111fd0                __aeabi_uidiv
                0x0000000000111fd0                __udivsi3
                0x000000000011222c                __aeabi_uidivmod
 .text          0x0000000000112248      0x2b0 ${vitis_install}/gnu/aarch32/nt/gcc-arm-none-eabi/bin//../aarch32-xilinx-eabi/usr/lib/thumb/v7-a+fp/hard\libgcc.a(_divsi3.o)
                0x0000000000112248                __divsi3
                0x0000000000112248                __aeabi_idiv
                0x00000000001124dc                __aeabi_idivmod
 .text          0x00000000001124f8        0x4 ${vitis_install}/gnu/aarch32/nt/gcc-arm-none-eabi/bin//../aarch32-xilinx-eabi/usr/lib/thumb/v7-a+fp/hard\libgcc.a(_dvmd_tls.o)
                0x00000000001124f8                __aeabi_idiv0
                0x00000000001124f8                __aeabi_ldiv0
 .text          0x00000000001124fc      0x21c ${vitis_install}/gnu/aarch32/nt/gcc-arm-none-eabi/bin//../aarch32-xilinx-eabi/usr/lib/thumb/v7-a+fp/hard\libgcc.a(_arm_addsubsf3.o)
                0x00000000001124fc                __aeabi_frsub
                0x0000000000112504                __subsf3
                0x0000000000112504                __aeabi_fsub
                0x0000000000112508                __aeabi_fadd
                0x0000000000112508                __addsf3
                0x0000000000112668                __aeabi_ui2f
                0x0000000000112668                __floatunsisf
                0x0000000000112670                __aeabi_i2f
                0x0000000000112670                __floatsisf
                0x000000000011268c                __aeabi_ul2f
                0x000000000011268c                __floatundisf
                0x000000000011269c                __aeabi_l2f
                0x000000000011269c                __floatdisf
 .text          0x0000000000112718       0xa0 ${vitis_install}/gnu/aarch32/nt/gcc-arm-none-eabi/bin//../aarch32-xilinx-eabi/usr/lib/thumb/v7-a+fp/hard\libgcc.a(_aeabi_ldivmod.o)
                0x0000000000112718                __aeabi_ldivmod
 .text          0x00000000001127b8       0x30 ${vitis_install}/gnu/aarch32/nt/gcc-arm-none-eabi/bin//../aarch32-xilinx-eabi/usr/lib/thumb/v7-a+fp/hard\libgcc.a(_aeabi_uldivmod.o)
                0x00000000001127b8                __aeabi_uldivmod
 .text          0x00000000001127e8      0x108 ${vitis_install}/gnu/aarch32/nt/gcc-arm-none-eabi/bin//../aarch32-xilinx-eabi/usr/lib/thumb/v7-a+fp/hard\libgcc.a(_udivmoddi4.o)
                0x00000000001127e8                __udivmoddi4
 .text          0x00000000001128f0        0xc ${vitis_install}/gnu/aarch32/nt/gcc-arm-none-eabi/bin//../aarch32-xilinx-eabi/usr/lib/thumb/v7-a+fp/hard\libc.a(lib_a-errno.o)
                0x00000000001128f0                __errno
 .text          0x00000000001128fc       0x20 ${vitis_install}/gnu/aarch32/nt/gcc-arm-none-eabi/bin//../aarch32-xilinx-eabi/usr/lib/thumb/v7-a+fp/hard\libc.a(lib_a-exit.o)
                0x00000000001128fc                exit
 .text          0x000000000011291c       0x2c ${vitis_install}/gnu/aarch32/nt/gcc-arm-none-eabi/bin//../aarch32-xilinx-eabi/usr/lib/thumb/v7-a+fp/hard\libc.a(lib_a-fini.o)
                0x000000000011291c                __libc_fini_array
 .text          0x0000000000112948       0x58 ${vitis_install}/gnu/aarch32/nt/gcc-arm-none-eabi/bin//../aarch32-xilinx-eabi/usr/lib/thumb/v7-a+fp/hard\libc.a(lib_a-init.o)
                0x0000000000112948                __libc_init_array
 .text          0x00000000001129a0       0x20 ${vitis_install}/gnu/aarch32/nt/gcc-arm-none-eabi/bin//../aarch32-xilinx-eabi/usr/lib/thumb/v7-a+fp/hard\libc.a(lib_a-malloc.o)
                0x00000000001129a0                malloc
                0x00000000001129b0                free
 .text          0x00000000001129c0      0x584 ${vitis_install}/gnu/aarch32/nt/gcc-arm-none-eabi/bin//../aarch32-xilinx-eabi/usr/lib/thumb/v7-a+fp/hard\libc.a(lib_a-mallocr.o)
                0x00000000001129c0                _malloc_r
 .text          0x0000000000112f44       0x68 ${vitis_install}/gnu/aarch32/nt/gcc-arm-none-eabi/bin//../aarch32-xilinx-eabi/usr/lib/thumb/v7-a+fp/hard\libc.a(lib_a-memcmp.o)
                0x0000000000112f44                memcmp
 *fill*         0x0000000000112fac       0x14 
 .text          0x0000000000112fc0      0x5e0 ${vitis_install}/gnu/aarch32/nt/gcc-arm-none-eabi/bin//../aarch32-xilinx-eabi/usr/lib/thumb/v7-a+fp/hard\libc.a(lib_a-memcpy.o)
                0x0000000000112fc0                memcpy
 .text          0x00000000001135a0       0xfc ${vitis_install}/gnu/aarch32/nt/gcc-arm-none-eabi/bin//../aarch32-xilinx-eabi/usr/lib/thumb/v7-a+fp/hard\libc.a(lib_a-memmove.o)
                0x00000000001135a0                memmove
 .text          0x000000000011369c       0xa8 ${vitis_install}/gnu/aarch32/nt/gcc-arm-none-eabi/bin//../aarch32-xilinx-eabi/usr/lib/thumb/v7-a+fp/hard\libc.a(lib_a-memset.o)
                0x000000000011369c                memset
 .text          0x0000000000113744        0x8 ${vitis_install}/gnu/aarch32/nt/gcc-arm-none-eabi/bin//../aarch32-xilinx-eabi/usr/lib/thumb/v7-a+fp/hard\libc.a(lib_a-mlock.o)
                0x0000000000113744                __malloc_lock
                0x0000000000113748                __malloc_unlock
 .text          0x000000000011374c       0x78 ${vitis_install}/gnu/aarch32/nt/gcc-arm-none-eabi/bin//../aarch32-xilinx-eabi/usr/lib/thumb/v7-a+fp/hard\libc.a(lib_a-puts.o)
                0x000000000011374c                _puts_r
                0x00000000001137b4                puts
 .text          0x00000000001137c4      0x660 ${vitis_install}/gnu/aarch32/nt/gcc-arm-none-eabi/bin//../aarch32-xilinx-eabi/usr/lib/thumb/v7-a+fp/hard\libc.a(lib_a-qsort.o)
                0x00000000001137c4                qsort
 .text          0x0000000000113e24       0x28 ${vitis_install}/gnu/aarch32/nt/gcc-arm-none-eabi/bin//../aarch32-xilinx-eabi/usr/lib/thumb/v7-a+fp/hard\libc.a(lib_a-sbrkr.o)
                0x0000000000113e24                _sbrk_r
 .text          0x0000000000113e4c      0x110 ${vitis_install}/gnu/aarch32/nt/gcc-arm-none-eabi/bin//../aarch32-xilinx-eabi/usr/lib/thumb/v7-a+fp/hard\libc.a(lib_a-snprintf.o)
                0x0000000000113e4c                _snprintf_r
                0x0000000000113ed0                snprintf
 *fill*         0x0000000000113f5c        0x4 
 .text          0x0000000000113f60      0x2dc ${vitis_install}/gnu/aarch32/nt/gcc-arm-none-eabi/bin//../aarch32-xilinx-eabi/usr/lib/thumb/v7-a+fp/hard\libc.a(lib_a-strcmp.o)
                0x0000000000113f68                strcmp
 *fill*         0x000000000011423c        0x4 
 .text          0x0000000000114240       0xdc ${vitis_install}/gnu/aarch32/nt/gcc-arm-none-eabi/bin//../aarch32-xilinx-eabi/usr/lib/thumb/v7-a+fp/hard\libc.a(lib_a-strlen.o)
                0x0000000000114240                strlen
 .text          0x000000000011431c       0x84 ${vitis_install}/gnu/aarch32/nt/gcc-arm-none-eabi/bin//../aarch32-xilinx-eabi/usr/lib/thumb/v7-a+fp/hard\libc.a(lib_a-strncmp.o)
                0x000000000011431c                strncmp
 .text          0x00000000001143a0     0x1900 ${vitis_install}/gnu/aarch32/nt/gcc-arm-none-eabi/bin//../aarch32-xilinx-eabi/usr/lib/thumb/v7-a+fp/hard\libc.a(lib_a-svfprintf.o)
                0x00000000001143a0                _svfprintf_r
 .text          0x0000000000115ca0       0xa4 ${vitis_install}/gnu/aarch32/nt/gcc-arm-none-eabi/bin//../aarch32-xilinx-eabi/usr/lib/thumb/v7-a+fp/hard\libc.a(lib_a-__call_atexit.o)
                0x0000000000115ca0                __call_exitprocs
 *fill*         0x0000000000115d44        0x4 
 .text          0x0000000000115d48      0xe04 ${vitis_install}/gnu/aarch32/nt/gcc-arm-none-eabi/bin//../aarch32-xilinx-eabi/usr/lib/thumb/v7-a+fp/hard\libc.a(lib_a-dtoa.o)
                0x0000000000115e80                _dtoa_r
 .text          0x0000000000116b4c      0x224 ${vitis_install}/gnu/aarch32/nt/gcc-arm-none-eabi/bin//../aarch32-xilinx-eabi/usr/lib/thumb/v7-a+fp/hard\libc.a(lib_a-findfp.o)
                0x0000000000116b50                _cleanup_r
                0x0000000000116c3c                __sfmoreglue
                0x0000000000116c6c                __sfp
                0x0000000000116d10                _cleanup
                0x0000000000116d28                __sinit
                0x0000000000116d30                __sfp_lock_acquire
                0x0000000000116d34                __sfp_lock_release
                0x0000000000116d38                __sinit_lock_acquire
                0x0000000000116d3c                __sinit_lock_release
                0x0000000000116d40                __fp_lock_all
                0x0000000000116d58                __fp_unlock_all
 .text          0x0000000000116d70      0x2ac ${vitis_install}/gnu/aarch32/nt/gcc-arm-none-eabi/bin//../aarch32-xilinx-eabi/usr/lib/thumb/v7-a+fp/hard\libc.a(lib_a-freer.o)
                0x0000000000116d70                _malloc_trim_r
                0x0000000000116e18                _free_r
 .text          0x000000000011701c      0x30c ${vitis_install}/gnu/aarch32/nt/gcc-arm-none-eabi/bin//../aarch32-xilinx-eabi/usr/lib/thumb/v7-a+fp/hard\libc.a(lib_a-fvwrite.o)
                0x000000000011701c                __sfvwrite_r
 .text          0x0000000000117328       0x80 ${vitis_install}/gnu/aarch32/nt/gcc-arm-none-eabi/bin//../aarch32-xilinx-eabi/usr/lib/thumb/v7-a+fp/hard\libc.a(lib_a-fwalk.o)
                0x0000000000117328                _fwalk
                0x0000000000117364                _fwalk_reent
 .text          0x00000000001173a8       0x14 ${vitis_install}/gnu/aarch32/nt/gcc-arm-none-eabi/bin//../aarch32-xilinx-eabi/usr/lib/thumb/v7-a+fp/hard\libc.a(lib_a-localeconv.o)
                0x00000000001173a8                __localeconv_l
                0x00000000001173ac                _localeconv_r
                0x00000000001173b4                localeconv
 .text          0x00000000001173bc       0xb8 ${vitis_install}/gnu/aarch32/nt/gcc-arm-none-eabi/bin//../aarch32-xilinx-eabi/usr/lib/thumb/v7-a+fp/hard\libc.a(lib_a-locale.o)
                0x00000000001173bc                _setlocale_r
                0x0000000000117410                __locale_mb_cur_max
                0x0000000000117420                setlocale
 .text          0x0000000000117474       0x3c ${vitis_install}/gnu/aarch32/nt/gcc-arm-none-eabi/bin//../aarch32-xilinx-eabi/usr/lib/thumb/v7-a+fp/hard\libc.a(lib_a-mbtowc_r.o)
                0x0000000000117474                _mbtowc_r
                0x000000000011748c                __ascii_mbtowc
 .text          0x00000000001174b0       0xa0 ${vitis_install}/gnu/aarch32/nt/gcc-arm-none-eabi/bin//../aarch32-xilinx-eabi/usr/lib/thumb/v7-a+fp/hard\libc.a(lib_a-memchr.o)
                0x00000000001174b0                memchr
 .text          0x0000000000117550      0xaa4 ${vitis_install}/gnu/aarch32/nt/gcc-arm-none-eabi/bin//../aarch32-xilinx-eabi/usr/lib/thumb/v7-a+fp/hard\libc.a(lib_a-mprec.o)
                0x0000000000117550                _Balloc
                0x000000000011759c                _Bfree
                0x00000000001175b0                __multadd
                0x0000000000117658                __s2b
                0x0000000000117710                __hi0bits
                0x0000000000117758                __lo0bits
                0x00000000001177b0                __i2b
                0x0000000000117810                __multiply
                0x0000000000117984                __pow5mult
                0x0000000000117a40                __lshift
                0x0000000000117b2c                __mcmp
                0x0000000000117b6c                __mdiff
                0x0000000000117ce8                __ulp
                0x0000000000117d4c                __b2d
                0x0000000000117e10                __d2b
                0x0000000000117ed0                __ratio
                0x0000000000117f30                _mprec_log10
                0x0000000000117f58                __copybits
                0x0000000000117fb4                __any_on
 .text          0x0000000000117ff4      0x37c ${vitis_install}/gnu/aarch32/nt/gcc-arm-none-eabi/bin//../aarch32-xilinx-eabi/usr/lib/thumb/v7-a+fp/hard\libc.a(lib_a-reallocr.o)
                0x0000000000117ff4                _realloc_r
 .text          0x0000000000118370       0x78 ${vitis_install}/gnu/aarch32/nt/gcc-arm-none-eabi/bin//../aarch32-xilinx-eabi/usr/lib/thumb/v7-a+fp/hard\libc.a(lib_a-s_frexp.o)
                0x0000000000118370                frexp
 .text          0x00000000001183e8       0x94 ${vitis_install}/gnu/aarch32/nt/gcc-arm-none-eabi/bin//../aarch32-xilinx-eabi/usr/lib/thumb/v7-a+fp/hard\libc.a(lib_a-stdio.o)
                0x00000000001183e8                __sread
                0x000000000011840c                __seofread
                0x0000000000118410                __swrite
                0x0000000000118450                __sseek
                0x0000000000118474                __sclose
 .text          0x000000000011847c       0x74 ${vitis_install}/gnu/aarch32/nt/gcc-arm-none-eabi/bin//../aarch32-xilinx-eabi/usr/lib/thumb/v7-a+fp/hard\libc.a(lib_a-strncpy.o)
                0x000000000011847c                strncpy
 .text          0x00000000001184f0      0xc78 ${vitis_install}/gnu/aarch32/nt/gcc-arm-none-eabi/bin//../aarch32-xilinx-eabi/usr/lib/thumb/v7-a+fp/hard\libc.a(lib_a-svfiprintf.o)
                0x00000000001184f0                __ssprint_r
                0x0000000000118600                _svfiprintf_r
 .text          0x0000000000119168       0x34 ${vitis_install}/gnu/aarch32/nt/gcc-arm-none-eabi/bin//../aarch32-xilinx-eabi/usr/lib/thumb/v7-a+fp/hard\libc.a(lib_a-wctomb_r.o)
                0x0000000000119168                _wctomb_r
                0x0000000000119180                __ascii_wctomb
 .text          0x000000000011919c       0x30 ${vitis_install}/gnu/aarch32/nt/gcc-arm-none-eabi/bin//../aarch32-xilinx-eabi/usr/lib/thumb/v7-a+fp/hard\libc.a(lib_a-writer.o)
                0x000000000011919c                _write_r
 .text          0x00000000001191cc       0xc4 ${vitis_install}/gnu/aarch32/nt/gcc-arm-none-eabi/bin//../aarch32-xilinx-eabi/usr/lib/thumb/v7-a+fp/hard\libc.a(lib_a-wsetup.o)
                0x00000000001191cc                __swsetup_r
 .text          0x0000000000119290       0x50 ${vitis_install}/gnu/aarch32/nt/gcc-arm-none-eabi/bin//../aarch32-xilinx-eabi/usr/lib/thumb/v7-a+fp/hard\libc.a(lib_a-assert.o)
                0x0000000000119290                __assert_func
                0x00000000001192d4                __assert
 .text          0x00000000001192e0       0x7c ${vitis_install}/gnu/aarch32/nt/gcc-arm-none-eabi/bin//../aarch32-xilinx-eabi/usr/lib/thumb/v7-a+fp/hard\libc.a(lib_a-callocr.o)
                0x00000000001192e0                _calloc_r
 .text          0x000000000011935c       0x28 ${vitis_install}/gnu/aarch32/nt/gcc-arm-none-eabi/bin//../aarch32-xilinx-eabi/usr/lib/thumb/v7-a+fp/hard\libc.a(lib_a-closer.o)
                0x000000000011935c                _close_r
 .text          0x0000000000119384       0x98 ${vitis_install}/gnu/aarch32/nt/gcc-arm-none-eabi/bin//../aarch32-xilinx-eabi/usr/lib/thumb/v7-a+fp/hard\libc.a(lib_a-fclose.o)
                0x0000000000119384                _fclose_r
                0x000000000011940c                fclose
 .text          0x000000000011941c      0x1bc ${vitis_install}/gnu/aarch32/nt/gcc-arm-none-eabi/bin//../aarch32-xilinx-eabi/usr/lib/thumb/v7-a+fp/hard\libc.a(lib_a-fflush.o)
                0x000000000011941c                __sflush_r
                0x0000000000119558                _fflush_r
                0x0000000000119584                fflush
 .text          0x00000000001195d8       0x48 ${vitis_install}/gnu/aarch32/nt/gcc-arm-none-eabi/bin//../aarch32-xilinx-eabi/usr/lib/thumb/v7-a+fp/hard\libc.a(lib_a-fiprintf.o)
                0x00000000001195d8                _fiprintf_r
                0x00000000001195f4                fiprintf
 .text          0x0000000000119620       0x30 ${vitis_install}/gnu/aarch32/nt/gcc-arm-none-eabi/bin//../aarch32-xilinx-eabi/usr/lib/thumb/v7-a+fp/hard\libc.a(lib_a-lseekr.o)
                0x0000000000119620                _lseek_r
 .text          0x0000000000119650      0x144 ${vitis_install}/gnu/aarch32/nt/gcc-arm-none-eabi/bin//../aarch32-xilinx-eabi/usr/lib/thumb/v7-a+fp/hard\libc.a(lib_a-makebuf.o)
                0x0000000000119650                __smakebuf_r
                0x0000000000119738                __swhatbuf_r
 .text          0x0000000000119794       0x30 ${vitis_install}/gnu/aarch32/nt/gcc-arm-none-eabi/bin//../aarch32-xilinx-eabi/usr/lib/thumb/v7-a+fp/hard\libc.a(lib_a-readr.o)
                0x0000000000119794                _read_r
 .text          0x00000000001197c4      0xe74 ${vitis_install}/gnu/aarch32/nt/gcc-arm-none-eabi/bin//../aarch32-xilinx-eabi/usr/lib/thumb/v7-a+fp/hard\libc.a(lib_a-vfiprintf.o)
                0x000000000011983c                __sprint_r
                0x0000000000119854                _vfiprintf_r
                0x000000000011a5ac                vfiprintf
 .text          0x000000000011a638       0x10 ${vitis_install}/gnu/aarch32/nt/gcc-arm-none-eabi/bin//../aarch32-xilinx-eabi/usr/lib/thumb/v7-a+fp/hard\libc.a(lib_a-abort.o)
                0x000000000011a638                abort
 .text          0x000000000011a648       0xe4 ${vitis_install}/gnu/aarch32/nt/gcc-arm-none-eabi/bin//../aarch32-xilinx-eabi/usr/lib/thumb/v7-a+fp/hard\libc.a(lib_a-fputwc.o)
                0x000000000011a648                __fputwc
                0x000000000011a6cc                _fputwc_r
                0x000000000011a6e8                fputwc
 .text          0x000000000011a72c       0x2c ${vitis_install}/gnu/aarch32/nt/gcc-arm-none-eabi/bin//../aarch32-xilinx-eabi/usr/lib/thumb/v7-a+fp/hard\libc.a(lib_a-fstatr.o)
                0x000000000011a72c                _fstat_r
 .text          0x000000000011a758       0x28 ${vitis_install}/gnu/aarch32/nt/gcc-arm-none-eabi/bin//../aarch32-xilinx-eabi/usr/lib/thumb/v7-a+fp/hard\libc.a(lib_a-isattyr.o)
                0x000000000011a758                _isatty_r
 .text          0x000000000011a780      0x288 ${vitis_install}/gnu/aarch32/nt/gcc-arm-none-eabi/bin//../aarch32-xilinx-eabi/usr/lib/thumb/v7-a+fp/hard\libc.a(lib_a-signal.o)
                0x000000000011a780                _init_signal_r
                0x000000000011a7b0                _signal_r
                0x000000000011a800                _raise_r
                0x000000000011a854                __sigtramp_r
                0x000000000011a8b8                raise
                0x000000000011a914                signal
                0x000000000011a964                _init_signal
                0x000000000011a9a0                __sigtramp
 .text          0x000000000011aa08       0x30 ${vitis_install}/gnu/aarch32/nt/gcc-arm-none-eabi/bin//../aarch32-xilinx-eabi/usr/lib/thumb/v7-a+fp/hard\libc.a(lib_a-signalr.o)
                0x000000000011aa08                _kill_r
                0x000000000011aa34                _getpid_r
 .text          0x000000000011aa38       0xc0 ${vitis_install}/gnu/aarch32/nt/gcc-arm-none-eabi/bin//../aarch32-xilinx-eabi/usr/lib/thumb/v7-a+fp/hard\libc.a(lib_a-wbuf.o)
                0x000000000011aa38                __swbuf_r
                0x000000000011aae4                __swbuf
 .text          0x000000000011aaf8       0x78 ${vitis_install}/gnu/aarch32/nt/gcc-arm-none-eabi/bin//../aarch32-xilinx-eabi/usr/lib/thumb/v7-a+fp/hard\libc.a(lib_a-wcrtomb.o)
                0x000000000011aaf8                _wcrtomb_r
                0x000000000011ab28                wcrtomb
 .text          0x000000000011ab70        0x4 ${package_root}\build\out\work\platform\bsp_core0\lib\libxil.a(_exit.o)
                0x000000000011ab70                _exit
 .text          0x000000000011ab74       0x40 ${package_root}\build\out\work\platform\bsp_core0\lib\libxil.a(_sbrk.o)
                0x000000000011ab74                _sbrk
 .text          0x000000000011abb4        0x8 ${package_root}\build\out\work\platform\bsp_core0\lib\libxil.a(close.o)
                0x000000000011abb4                _close
 .text          0x000000000011abbc       0x10 ${package_root}\build\out\work\platform\bsp_core0\lib\libxil.a(fstat.o)
                0x000000000011abbc                _fstat
 .text          0x000000000011abcc       0x10 ${package_root}\build\out\work\platform\bsp_core0\lib\libxil.a(getpid.o)
                0x000000000011abcc                getpid
                0x000000000011abd4                _getpid
 .text          0x000000000011abdc       0x10 ${package_root}\build\out\work\platform\bsp_core0\lib\libxil.a(isatty.o)
                0x000000000011abdc                isatty
                0x000000000011abe4                _isatty
 .text          0x000000000011abec       0x38 ${package_root}\build\out\work\platform\bsp_core0\lib\libxil.a(kill.o)
                0x000000000011abec                kill
                0x000000000011ac08                _kill
 .text          0x000000000011ac24       0x30 ${package_root}\build\out\work\platform\bsp_core0\lib\libxil.a(lseek.o)
                0x000000000011ac24                lseek
                0x000000000011ac3c                _lseek
 .text          0x000000000011ac54       0x58 ${package_root}\build\out\work\platform\bsp_core0\lib\libxil.a(read.o)
                0x000000000011ac54                read
                0x000000000011aca8                _read
 .text          0x000000000011acac       0x70 ${package_root}\build\out\work\platform\bsp_core0\lib\libxil.a(write.o)
                0x000000000011acac                write
                0x000000000011ad18                _write
 .text          0x000000000011ad1c        0xc ${package_root}\build\out\work\platform\bsp_core0\lib\libxil.a(inbyte.o)
                0x000000000011ad1c                inbyte
 *(.text.*)
 .text.coeff    0x000000000011ad28      0x148 ${package_root}\build\out\work\application\build\software\0.o
 .text.probabilities
                0x000000000011ae70       0x94 ${package_root}\build\out\work\application\build\software\0.o
 .text.prepare_rgb_tables.part.0
                0x000000000011af04      0x15c ${package_root}\build\out\work\application\build\software\0.o
 .text.classify_input
                0x000000000011b060      0x64c ${package_root}\build\out\work\application\build\software\0.o
 .text.fusion_ssd_input_reference
                0x000000000011b6ac      0x42c ${package_root}\build\out\work\application\build\software\0.o
                0x000000000011b6ac                fusion_ssd_input_reference
 .text.fusion_classify_input
                0x000000000011bad8       0x70 ${package_root}\build\out\work\application\build\software\0.o
                0x000000000011bad8                fusion_classify_input
 .text.fusion_make_roi
                0x000000000011bb48      0x1a8 ${package_root}\build\out\work\application\build\software\0.o
                0x000000000011bb48                fusion_make_roi
 .text.fusion_image_roi
                0x000000000011bcf0       0xe4 ${package_root}\build\out\work\application\build\software\0.o
                0x000000000011bcf0                fusion_image_roi
 .text.fusion_scores
                0x000000000011bdd4       0xf8 ${package_root}\build\out\work\application\build\software\0.o
                0x000000000011bdd4                fusion_scores
 .text.fusion_ssd_input
                0x000000000011becc       0x40 ${package_root}\build\out\work\application\build\software\0.o
                0x000000000011becc                fusion_ssd_input
 .text.failed   0x000000000011bf0c       0xc0 ${package_root}\build\out\work\application\build\software\1.o
 .text.ssd_preprocess_pl
                0x000000000011bfcc      0x254 ${package_root}\build\out\work\application\build\software\1.o
                0x000000000011bfcc                ssd_preprocess_pl
 .text.ssd_repair_rounding
                0x000000000011c220      0x1f4 ${package_root}\build\out\work\application\build\software\2.o
                0x000000000011c220                ssd_repair_rounding
 .text.getnum   0x000000000011c414       0x64 ${package_root}\build\out\work\application\build\software\3.o
 .text.outnum   0x000000000011c478      0x19c ${package_root}\build\out\work\application\build\software\3.o
 *fill*         0x000000000011c614        0x4 
 .text.xil_printf
                0x000000000011c618      0x4b4 ${package_root}\build\out\work\application\build\software\3.o
                0x000000000011c618                xil_printf
 *fill*         0x000000000011cacc        0x4 
 .text.forget_detection
                0x000000000011cad0       0xc0 ${package_root}\build\out\work\application\build\software\4.o
 .text.bird_focus_forget
                0x000000000011cb90       0x78 ${package_root}\build\out\work\application\build\software\4.o
                0x000000000011cb90                bird_focus_forget
 .text.bird_focus_init
                0x000000000011cc08      0x1c0 ${package_root}\build\out\work\application\build\software\4.o
                0x000000000011cc08                bird_focus_init
 .text.bird_focus_control
                0x000000000011cdc8      0x348 ${package_root}\build\out\work\application\build\software\4.o
                0x000000000011cdc8                bird_focus_control
 .text.bird_focus_manual
                0x000000000011d110      0x1a8 ${package_root}\build\out\work\application\build\software\4.o
                0x000000000011d110                bird_focus_manual
 .text.bird_focus_contrast_move
                0x000000000011d2b8      0x1a0 ${package_root}\build\out\work\application\build\software\4.o
                0x000000000011d2b8                bird_focus_contrast_move
 .text.bird_focus_manual_status
                0x000000000011d458       0x70 ${package_root}\build\out\work\application\build\software\4.o
                0x000000000011d458                bird_focus_manual_status
 .text.bird_focus_observe
                0x000000000011d4c8      0x4ec ${package_root}\build\out\work\application\build\software\4.o
                0x000000000011d4c8                bird_focus_observe
 .text.bird_focus_poll
                0x000000000011d9b4     0x16ec ${package_root}\build\out\work\application\build\software\4.o
                0x000000000011d9b4                bird_focus_poll
 .text.bird_focus_status
                0x000000000011f0a0      0x16c ${package_root}\build\out\work\application\build\software\4.o
                0x000000000011f0a0                bird_focus_status
 .text.control_handle
                0x000000000011f20c      0x6c4 ${package_root}\build\out\work\application\build\software\5.o
                0x000000000011f20c                control_handle
 .text.vh_success
                0x000000000011f8d0       0xf4 ${package_root}\build\out\work\application\build\software\6.o
 *fill*         0x000000000011f9c4        0x4 
 .text.start_audio_transfer
                0x000000000011f9c8      0x128 ${package_root}\build\out\work\application\build\software\6.o
 .text.recover_audio_dma
                0x000000000011faf0       0xa8 ${package_root}\build\out\work\application\build\software\6.o
 .text.vh_abort_copy
                0x000000000011fb98       0xe4 ${package_root}\build\out\work\application\build\software\6.o
 .text.vh_start_dma
                0x000000000011fc7c      0x13c ${package_root}\build\out\work\application\build\software\6.o
 .text.network_audio_dma_complete.part.0
                0x000000000011fdb8       0x70 ${package_root}\build\out\work\application\build\software\6.o
 .text.video_health_words
                0x000000000011fe28       0x10 ${package_root}\build\out\work\application\build\software\6.o
                0x000000000011fe28                video_health_words
 .text.network_video_complete
                0x000000000011fe38      0x178 ${package_root}\build\out\work\application\build\software\6.o
                0x000000000011fe38                network_video_complete
 .text.dma_service_init
                0x000000000011ffb0      0x554 ${package_root}\build\out\work\application\build\software\6.o
                0x000000000011ffb0                dma_service_init
 *fill*         0x0000000000120504        0x4 
 .text.dma_service_poll
                0x0000000000120508     0x2248 ${package_root}\build\out\work\application\build\software\6.o
                0x0000000000120508                dma_service_poll
 .text.startup.main
                0x0000000000122750      0x330 ${package_root}\build\out\work\application\build\software\7.o
                0x0000000000122750                main
 .text.line_drive
                0x0000000000122a80       0x68 ${package_root}\build\out\work\application\build\software\8.o
 .text.recovery_finish
                0x0000000000122ae8      0x118 ${package_root}\build\out\work\application\build\software\8.o
 .text.write_byte
                0x0000000000122c00      0x160 ${package_root}\build\out\work\application\build\software\8.o
 .text.reg_write
                0x0000000000122d60      0x140 ${package_root}\build\out\work\application\build\software\8.o
 .text.reg_read
                0x0000000000122ea0      0x2fc ${package_root}\build\out\work\application\build\software\8.o
 .text.ov5640_af_read
                0x000000000012319c       0x34 ${package_root}\build\out\work\application\build\software\8.o
                0x000000000012319c                ov5640_af_read
 .text.ov5640_af_write
                0x00000000001231d0       0x34 ${package_root}\build\out\work\application\build\software\8.o
                0x00000000001231d0                ov5640_af_write
 .text.ov5640_diagnostic_pattern
                0x0000000000123204       0xdc ${package_root}\build\out\work\application\build\software\8.o
                0x0000000000123204                ov5640_diagnostic_pattern
 .text.ov5640_diagnostic_phase
                0x00000000001232e0      0x144 ${package_root}\build\out\work\application\build\software\8.o
                0x00000000001232e0                ov5640_diagnostic_phase
 .text.ov5640_camera_prepare
                0x0000000000123424      0x514 ${package_root}\build\out\work\application\build\software\8.o
                0x0000000000123424                ov5640_camera_prepare
 .text.ov5640_camera_start
                0x0000000000123938       0x84 ${package_root}\build\out\work\application\build\software\8.o
                0x0000000000123938                ov5640_camera_start
 .text.ov5640_recovery_busy
                0x00000000001239bc       0x18 ${package_root}\build\out\work\application\build\software\8.o
                0x00000000001239bc                ov5640_recovery_busy
 .text.ov5640_recovery_generation
                0x00000000001239d4       0x10 ${package_root}\build\out\work\application\build\software\8.o
                0x00000000001239d4                ov5640_recovery_generation
 .text.ov5640_recovery_reset_generation
                0x00000000001239e4       0x10 ${package_root}\build\out\work\application\build\software\8.o
                0x00000000001239e4                ov5640_recovery_reset_generation
 .text.ov5640_recovery_saved_focus
                0x00000000001239f4       0x34 ${package_root}\build\out\work\application\build\software\8.o
                0x00000000001239f4                ov5640_recovery_saved_focus
 .text.ov5640_recovery_confirm_frame
                0x0000000000123a28       0x4c ${package_root}\build\out\work\application\build\software\8.o
                0x0000000000123a28                ov5640_recovery_confirm_frame
 .text.ov5640_recovery_begin
                0x0000000000123a74      0x1ac ${package_root}\build\out\work\application\build\software\8.o
                0x0000000000123a74                ov5640_recovery_begin
 .text.ov5640_recovery_poll
                0x0000000000123c20      0x7d8 ${package_root}\build\out\work\application\build\software\8.o
                0x0000000000123c20                ov5640_recovery_poll
 .text.control_receive
                0x00000000001243f8      0x190 ${package_root}\build\out\work\application\build\software\9.o
 .text.network_platform_init
                0x0000000000124588      0x1f4 ${package_root}\build\out\work\application\build\software\9.o
                0x0000000000124588                network_platform_init
 *fill*         0x000000000012477c        0x4 
 .text.network_platform_poll
                0x0000000000124780       0xe8 ${package_root}\build\out\work\application\build\software\9.o
                0x0000000000124780                network_platform_poll
 .text.platform_udp_send_parts
                0x0000000000124868      0x1e4 ${package_root}\build\out\work\application\build\software\9.o
                0x0000000000124868                platform_udp_send_parts
 .text.platform_udp_send
                0x0000000000124a4c       0x1c ${package_root}\build\out\work\application\build\software\9.o
                0x0000000000124a4c                platform_udp_send
 .text.platform_time_us
                0x0000000000124a68       0x78 ${package_root}\build\out\work\application\build\software\9.o
                0x0000000000124a68                platform_time_us
 .text.platform_cache_flush
                0x0000000000124ae0        0x4 ${package_root}\build\out\work\application\build\software\9.o
                0x0000000000124ae0                platform_cache_flush
 .text.platform_cache_invalidate
                0x0000000000124ae4        0x4 ${package_root}\build\out\work\application\build\software\9.o
                0x0000000000124ae4                platform_cache_invalidate
 .text.platform_mmio_write
                0x0000000000124ae8        0x8 ${package_root}\build\out\work\application\build\software\9.o
                0x0000000000124ae8                platform_mmio_write
 .text.platform_mmio_read
                0x0000000000124af0        0x8 ${package_root}\build\out\work\application\build\software\9.o
                0x0000000000124af0                platform_mmio_read
 .text.recovery_reset
                0x0000000000124af8       0x8c ${package_root}\build\out\work\application\build\software\10.o
 *fill*         0x0000000000124b84        0x4 
 .text.candidate_hold_active
                0x0000000000124b88       0xf0 ${package_root}\build\out\work\application\build\software\10.o
 .text.pose     0x0000000000124c78       0x94 ${package_root}\build\out\work\application\build\software\10.o
 .text.continuous_reset
                0x0000000000124d0c       0x60 ${package_root}\build\out\work\application\build\software\10.o
 .text.move_pan
                0x0000000000124d6c      0x1b8 ${package_root}\build\out\work\application\build\software\10.o
 *fill*         0x0000000000124f24        0x4 
 .text.tilt     0x0000000000124f28      0x188 ${package_root}\build\out\work\application\build\software\10.o
 .text.formal_direction_time_guard
                0x00000000001250b0       0xb0 ${package_root}\build\out\work\application\build\software\10.o
 .text.pulse_for_pose
                0x0000000000125160       0xb8 ${package_root}\build\out\work\application\build\software\10.o
 .text.shaft_for_pulse.part.0
                0x0000000000125218       0x94 ${package_root}\build\out\work\application\build\software\10.o
 .text.recovery_start.part.0
                0x00000000001252ac      0x30c ${package_root}\build\out\work\application\build\software\10.o
 .text.scan_poll
                0x00000000001255b8      0x288 ${package_root}\build\out\work\application\build\software\10.o
 .text.auto_tilt.isra.0
                0x0000000000125840       0x90 ${package_root}\build\out\work\application\build\software\10.o
 .text.sound_advance.part.0
                0x00000000001258d0      0x2e4 ${package_root}\build\out\work\application\build\software\10.o
 .text.sound_seek_confirm_push_config.constprop.0
                0x0000000000125bb4      0x404 ${package_root}\build\out\work\application\build\software\10.o
 .text.visual_location_lost
                0x0000000000125fb8       0x58 ${package_root}\build\out\work\application\build\software\10.o
 .text.servo_tracking_configure_scan_rate
                0x0000000000126010       0xc8 ${package_root}\build\out\work\application\build\software\10.o
                0x0000000000126010                servo_tracking_configure_scan_rate
 .text.servo_tracking_scan_rate
                0x00000000001260d8       0x10 ${package_root}\build\out\work\application\build\software\10.o
                0x00000000001260d8                servo_tracking_scan_rate
 .text.servo_tracking_scan_timing
                0x00000000001260e8       0x20 ${package_root}\build\out\work\application\build\software\10.o
                0x00000000001260e8                servo_tracking_scan_timing
 .text.servo_tracking_recovery_active
                0x0000000000126108       0x18 ${package_root}\build\out\work\application\build\software\10.o
                0x0000000000126108                servo_tracking_recovery_active
 .text.servo_tracking_reacquire_active
                0x0000000000126120       0xb0 ${package_root}\build\out\work\application\build\software\10.o
                0x0000000000126120                servo_tracking_reacquire_active
 .text.servo_tracking_poll.part.0
                0x00000000001261d0     0x14a0 ${package_root}\build\out\work\application\build\software\10.o
 .text.servo_tracking_reacquire
                0x0000000000127670      0x174 ${package_root}\build\out\work\application\build\software\10.o
                0x0000000000127670                servo_tracking_reacquire
 .text.servo_tracking_sound_accept_sequence
                0x00000000001277e4       0x10 ${package_root}\build\out\work\application\build\software\10.o
                0x00000000001277e4                servo_tracking_sound_accept_sequence
 .text.servo_tracking_sound_timing_forget
                0x00000000001277f4       0x48 ${package_root}\build\out\work\application\build\software\10.o
                0x00000000001277f4                servo_tracking_sound_timing_forget
 .text.servo_tracking_audio_value
                0x000000000012783c       0x20 ${package_root}\build\out\work\application\build\software\10.o
                0x000000000012783c                servo_tracking_audio_value
 .text.servo_tracking_audio_revision
                0x000000000012785c       0x10 ${package_root}\build\out\work\application\build\software\10.o
                0x000000000012785c                servo_tracking_audio_revision
 .text.servo_tracking_audio_evidence_after
                0x000000000012786c       0x10 ${package_root}\build\out\work\application\build\software\10.o
                0x000000000012786c                servo_tracking_audio_evidence_after
 *fill*         0x000000000012787c        0x4 
 .text.servo_tracking_audio_threshold
                0x0000000000127880       0xb8 ${package_root}\build\out\work\application\build\software\10.o
                0x0000000000127880                servo_tracking_audio_threshold
 .text.servo_tracking_audio_command
                0x0000000000127938      0x474 ${package_root}\build\out\work\application\build\software\10.o
                0x0000000000127938                servo_tracking_audio_command
 .text.servo_tracking_audio_status
                0x0000000000127dac       0x98 ${package_root}\build\out\work\application\build\software\10.o
                0x0000000000127dac                servo_tracking_audio_status
 .text.servo_tracking_visual_acquired
                0x0000000000127e44      0x10c ${package_root}\build\out\work\application\build\software\10.o
                0x0000000000127e44                servo_tracking_visual_acquired
 .text.servo_tracking_sound_candidate
                0x0000000000127f50      0x120 ${package_root}\build\out\work\application\build\software\10.o
                0x0000000000127f50                servo_tracking_sound_candidate
 .text.servo_tracking_tuning_command
                0x0000000000128070      0x4bc ${package_root}\build\out\work\application\build\software\10.o
                0x0000000000128070                servo_tracking_tuning_command
 .text.servo_tracking_tuning_status
                0x000000000012852c       0x98 ${package_root}\build\out\work\application\build\software\10.o
                0x000000000012852c                servo_tracking_tuning_status
 .text.servo_tracking_feedforward_command
                0x00000000001285c4      0x380 ${package_root}\build\out\work\application\build\software\10.o
                0x00000000001285c4                servo_tracking_feedforward_command
 .text.servo_tracking_feedforward_status
                0x0000000000128944      0x604 ${package_root}\build\out\work\application\build\software\10.o
                0x0000000000128944                servo_tracking_feedforward_status
 .text.servo_tracking_init
                0x0000000000128f48      0x720 ${package_root}\build\out\work\application\build\software\10.o
                0x0000000000128f48                servo_tracking_init
 .text.servo_tracking_visual_present
                0x0000000000129668       0xac ${package_root}\build\out\work\application\build\software\10.o
                0x0000000000129668                servo_tracking_visual_present
 .text.servo_tracking_visual_priority
                0x0000000000129714       0xf4 ${package_root}\build\out\work\application\build\software\10.o
                0x0000000000129714                servo_tracking_visual_priority
 .text.servo_tracking_stop
                0x0000000000129808      0x120 ${package_root}\build\out\work\application\build\software\10.o
                0x0000000000129808                servo_tracking_stop
 .text.servo_tracking_tick
                0x0000000000129928      0x1fc ${package_root}\build\out\work\application\build\software\10.o
                0x0000000000129928                servo_tracking_tick
 *fill*         0x0000000000129b24        0x4 
 .text.servo_tracking_track
                0x0000000000129b28      0xc7c ${package_root}\build\out\work\application\build\software\10.o
                0x0000000000129b28                servo_tracking_track
 .text.servo_tracking_poll
                0x000000000012a7a4       0x4c ${package_root}\build\out\work\application\build\software\10.o
                0x000000000012a7a4                servo_tracking_poll
 .text.servo_tracking_clear_detection
                0x000000000012a7f0       0xb8 ${package_root}\build\out\work\application\build\software\10.o
                0x000000000012a7f0                servo_tracking_clear_detection
 .text.servo_tracking_pan
                0x000000000012a8a8       0x90 ${package_root}\build\out\work\application\build\software\10.o
                0x000000000012a8a8                servo_tracking_pan
 .text.servo_tracking_configure
                0x000000000012a938        0x8 ${package_root}\build\out\work\application\build\software\10.o
                0x000000000012a938                servo_tracking_configure
 .text.servo_tracking_configure_visual
                0x000000000012a940        0x8 ${package_root}\build\out\work\application\build\software\10.o
                0x000000000012a940                servo_tracking_configure_visual
 .text.servo_tracking_config_status
                0x000000000012a948       0x3c ${package_root}\build\out\work\application\build\software\10.o
                0x000000000012a948                servo_tracking_config_status
 .text.servo_tracking_visual_config_status
                0x000000000012a984       0x28 ${package_root}\build\out\work\application\build\software\10.o
                0x000000000012a984                servo_tracking_visual_config_status
 .text.servo_tracking_pan_limit
                0x000000000012a9ac        0x8 ${package_root}\build\out\work\application\build\software\10.o
                0x000000000012a9ac                servo_tracking_pan_limit
 .text.servo_tracking_tilt
                0x000000000012a9b4       0x24 ${package_root}\build\out\work\application\build\software\10.o
                0x000000000012a9b4                servo_tracking_tilt
 .text.servo_tracking_auto
                0x000000000012a9d8      0x148 ${package_root}\build\out\work\application\build\software\10.o
                0x000000000012a9d8                servo_tracking_auto
 .text.servo_tracking_keepalive
                0x000000000012ab20       0x7c ${package_root}\build\out\work\application\build\software\10.o
                0x000000000012ab20                servo_tracking_keepalive
 .text.servo_tracking_sound_search_active
                0x000000000012ab9c       0x70 ${package_root}\build\out\work\application\build\software\10.o
                0x000000000012ab9c                servo_tracking_sound_search_active
 .text.servo_tracking_sound_observe
                0x000000000012ac0c      0x6cc ${package_root}\build\out\work\application\build\software\10.o
                0x000000000012ac0c                servo_tracking_sound_observe
 .text.servo_tracking_observe
                0x000000000012b2d8      0x7ec ${package_root}\build\out\work\application\build\software\10.o
                0x000000000012b2d8                servo_tracking_observe
 .text.servo_tracking_status
                0x000000000012bac4       0xb0 ${package_root}\build\out\work\application\build\software\10.o
                0x000000000012bac4                servo_tracking_status
 .text.servo_tracking_diagnostic
                0x000000000012bb74       0x98 ${package_root}\build\out\work\application\build\software\10.o
                0x000000000012bb74                servo_tracking_diagnostic
 .text.servo_tracking_guard_status
                0x000000000012bc0c       0x40 ${package_root}\build\out\work\application\build\software\10.o
                0x000000000012bc0c                servo_tracking_guard_status
 .text.servo_tracking_limit_status
                0x000000000012bc4c       0x58 ${package_root}\build\out\work\application\build\software\10.o
                0x000000000012bc4c                servo_tracking_limit_status
 .text.servo_tracking_limit_switch_status
                0x000000000012bca4       0x24 ${package_root}\build\out\work\application\build\software\10.o
                0x000000000012bca4                servo_tracking_limit_switch_status
 .text.servo_tracking_detection
                0x000000000012bcc8      0x120 ${package_root}\build\out\work\application\build\software\10.o
                0x000000000012bcc8                servo_tracking_detection
 .text.servo_tracking_sound_status
                0x000000000012bde8       0xe4 ${package_root}\build\out\work\application\build\software\10.o
                0x000000000012bde8                servo_tracking_sound_status
 .text.servo_tracking_position_status
                0x000000000012becc       0x8c ${package_root}\build\out\work\application\build\software\10.o
                0x000000000012becc                servo_tracking_position_status
 .text.network_service_init
                0x000000000012bf58       0x54 ${package_root}\build\out\work\application\build\software\11.o
                0x000000000012bf58                network_service_init
 .text.network_scheduler_poll
                0x000000000012bfac      0x394 ${package_root}\build\out\work\application\build\software\11.o
                0x000000000012bfac                network_scheduler_poll
 .text.network_scheduler_burst
                0x000000000012c340       0x68 ${package_root}\build\out\work\application\build\software\11.o
                0x000000000012c340                network_scheduler_burst
 .text.telemetry_send
                0x000000000012c3a8      0x87c ${package_root}\build\out\work\application\build\software\12.o
                0x000000000012c3a8                telemetry_send
 .text.make_header
                0x000000000012cc24      0x12c ${package_root}\build\out\work\application\build\software\13.o
 .text.udp_send_video_fragment
                0x000000000012cd50      0x160 ${package_root}\build\out\work\application\build\software\13.o
                0x000000000012cd50                udp_send_video_fragment
 .text.udp_send_audio_result
                0x000000000012ceb0      0x210 ${package_root}\build\out\work\application\build\software\13.o
                0x000000000012ceb0                udp_send_audio_result
 .text.udp_send_status_payload
                0x000000000012d0c0       0xc0 ${package_root}\build\out\work\application\build\software\13.o
                0x000000000012d0c0                udp_send_status_payload
 .text.udp_send_control_reply
                0x000000000012d180       0xa4 ${package_root}\build\out\work\application\build\software\13.o
                0x000000000012d180                udp_send_control_reply
 .text.valid_candidate
                0x000000000012d224       0xe4 ${package_root}\build\out\work\application\build\software\15.o
 .text.motion_candidate
                0x000000000012d308      0x138 ${package_root}\build\out\work\application\build\software\15.o
 .text.stable_template_adapt
                0x000000000012d440      0x100 ${package_root}\build\out\work\application\build\software\15.o
 .text.roi_hint_note
                0x000000000012d540      0x224 ${package_root}\build\out\work\application\build\software\15.o
 *fill*         0x000000000012d764        0x4 
 .text.sampled_luma
                0x000000000012d768       0x78 ${package_root}\build\out\work\application\build\software\15.o
 .text.intersection
                0x000000000012d7e0       0xc4 ${package_root}\build\out\work\application\build\software\15.o
 .text.motion_sample_geometry
                0x000000000012d8a4      0x1fc ${package_root}\build\out\work\application\build\software\15.o
 .text.candidate_appearance.part.0
                0x000000000012daa0      0x2c0 ${package_root}\build\out\work\application\build\software\15.o
 .text.motion_revalidate
                0x000000000012dd60      0x618 ${package_root}\build\out\work\application\build\software\15.o
 .text.reset_track
                0x000000000012e378      0x174 ${package_root}\build\out\work\application\build\software\15.o
 .text.missed   0x000000000012e4ec      0x148 ${package_root}\build\out\work\application\build\software\15.o
 .text.visual_tracker_set_work_clock
                0x000000000012e634       0x3c ${package_root}\build\out\work\application\build\software\15.o
                0x000000000012e634                visual_tracker_set_work_clock
 .text.visual_tracker_roi_forget
                0x000000000012e670       0x50 ${package_root}\build\out\work\application\build\software\15.o
                0x000000000012e670                visual_tracker_roi_forget
 .text.visual_tracker_roi_hint
                0x000000000012e6c0      0x13c ${package_root}\build\out\work\application\build\software\15.o
                0x000000000012e6c0                visual_tracker_roi_hint
 .text.visual_tracker_reset
                0x000000000012e7fc      0x108 ${package_root}\build\out\work\application\build\software\15.o
                0x000000000012e7fc                visual_tracker_reset
 *fill*         0x000000000012e904        0x4 
 .text.visual_tracker_init
                0x000000000012e908      0x240 ${package_root}\build\out\work\application\build\software\15.o
                0x000000000012e908                visual_tracker_init
 .text.visual_tracker_frame_abort
                0x000000000012eb48       0x14 ${package_root}\build\out\work\application\build\software\15.o
                0x000000000012eb48                visual_tracker_frame_abort
 .text.visual_tracker_frame_begin
                0x000000000012eb5c       0xc0 ${package_root}\build\out\work\application\build\software\15.o
                0x000000000012eb5c                visual_tracker_frame_begin
 .text.visual_tracker_frame_chunk
                0x000000000012ec1c      0x45c ${package_root}\build\out\work\application\build\software\15.o
                0x000000000012ec1c                visual_tracker_frame_chunk
 .text.visual_tracker_frame_end
                0x000000000012f078      0x2f0 ${package_root}\build\out\work\application\build\software\15.o
                0x000000000012f078                visual_tracker_frame_end
 .text.visual_tracker_select_ssd
                0x000000000012f368      0xb80 ${package_root}\build\out\work\application\build\software\15.o
                0x000000000012f368                visual_tracker_select_ssd
 .text.visual_tracker_selection_status
                0x000000000012fee8       0xc0 ${package_root}\build\out\work\application\build\software\15.o
                0x000000000012fee8                visual_tracker_selection_status
 .text.visual_tracker_observe_ssd
                0x000000000012ffa8      0xf48 ${package_root}\build\out\work\application\build\software\15.o
                0x000000000012ffa8                visual_tracker_observe_ssd
 .text.visual_tracker_poll
                0x0000000000130ef0     0x2620 ${package_root}\build\out\work\application\build\software\15.o
                0x0000000000130ef0                visual_tracker_poll
 .text.visual_tracker_status
                0x0000000000133510      0x260 ${package_root}\build\out\work\application\build\software\15.o
                0x0000000000133510                visual_tracker_status
 .text.visual_tracker_diagnostic
                0x0000000000133770      0x1d0 ${package_root}\build\out\work\application\build\software\15.o
                0x0000000000133770                visual_tracker_diagnostic
 .text.ssd_history_exact
                0x0000000000133940       0x78 ${package_root}\build\out\work\application\build\software\15.o
                0x0000000000133940                ssd_history_exact
 .text.ssd_history_next
                0x00000000001339b8       0xa8 ${package_root}\build\out\work\application\build\software\15.o
                0x00000000001339b8                ssd_history_next
 .text.visual_tracker_focus_snapshot
                0x0000000000133a60      0x214 ${package_root}\build\out\work\application\build\software\15.o
                0x0000000000133a60                visual_tracker_focus_snapshot
 .text.visual_tracker_video_active
                0x0000000000133c74       0x10 ${package_root}\build\out\work\application\build\software\15.o
                0x0000000000133c74                visual_tracker_video_active
 .text.visual_tracker_video_pause
                0x0000000000133c84      0x154 ${package_root}\build\out\work\application\build\software\15.o
                0x0000000000133c84                visual_tracker_video_pause
 .text.visual_tracker_video_break
                0x0000000000133dd8       0x74 ${package_root}\build\out\work\application\build\software\15.o
                0x0000000000133dd8                visual_tracker_video_break
 .text.roi_owner_poll
                0x0000000000133e4c      0x234 ${package_root}\build\out\work\application\build\software\16.o
 .text.run      0x0000000000134080       0xe8 ${package_root}\build\out\work\application\build\software\16.o
 .text.visual_present.constprop.0
                0x0000000000134168       0x88 ${package_root}\build\out\work\application\build\software\16.o
 .text.sound_round_current
                0x00000000001341f0       0xc0 ${package_root}\build\out\work\application\build\software\16.o
 .text.publish  0x00000000001342b0      0x3dc ${package_root}\build\out\work\application\build\software\16.o
 .text.direction_stream_poll
                0x000000000013468c      0x7f8 ${package_root}\build\out\work\application\build\software\16.o
 .text.fusion_mode
                0x0000000000134e84       0x10 ${package_root}\build\out\work\application\build\software\16.o
                0x0000000000134e84                fusion_mode
 .text.fusion_capture_state
                0x0000000000134e94       0x10 ${package_root}\build\out\work\application\build\software\16.o
                0x0000000000134e94                fusion_capture_state
 *fill*         0x0000000000134ea4        0x4 
 .text.fusion_set_mode
                0x0000000000134ea8      0x248 ${package_root}\build\out\work\application\build\software\16.o
                0x0000000000134ea8                fusion_set_mode
 .text.fusion_set_image_policy
                0x00000000001350f0       0xb0 ${package_root}\build\out\work\application\build\software\16.o
                0x00000000001350f0                fusion_set_image_policy
 .text.fusion_capture_control
                0x00000000001351a0      0x258 ${package_root}\build\out\work\application\build\software\16.o
                0x00000000001351a0                fusion_capture_control
 .text.fusion_set_direction_threshold
                0x00000000001353f8       0x98 ${package_root}\build\out\work\application\build\software\16.o
                0x00000000001353f8                fusion_set_direction_threshold
 .text.fusion_audio_tuning_command
                0x0000000000135490       0xb8 ${package_root}\build\out\work\application\build\software\16.o
                0x0000000000135490                fusion_audio_tuning_command
 .text.fusion_sound_round_tuning_command
                0x0000000000135548      0x158 ${package_root}\build\out\work\application\build\software\16.o
                0x0000000000135548                fusion_sound_round_tuning_command
 .text.fusion_direction_read
                0x00000000001356a0      0x42c ${package_root}\build\out\work\application\build\software\16.o
                0x00000000001356a0                fusion_direction_read
 *fill*         0x0000000000135acc        0x4 
 .text.service_io.part.0
                0x0000000000135ad0      0xf68 ${package_root}\build\out\work\application\build\software\16.o
 .text.fusion_direction_status
                0x0000000000136a38       0xe8 ${package_root}\build\out\work\application\build\software\16.o
                0x0000000000136a38                fusion_direction_status
 .text.fusion_dma_config
                0x0000000000136b20        0xc ${package_root}\build\out\work\application\build\software\16.o
                0x0000000000136b20                fusion_dma_config
 .text.fusion_yield
                0x0000000000136b2c       0x2c ${package_root}\build\out\work\application\build\software\16.o
                0x0000000000136b2c                fusion_yield
 .text.fusion_service_idle
                0x0000000000136b58       0x30 ${package_root}\build\out\work\application\build\software\16.o
                0x0000000000136b58                fusion_service_idle
 .text.fusion_init
                0x0000000000136b88      0x564 ${package_root}\build\out\work\application\build\software\16.o
                0x0000000000136b88                fusion_init
 .text.fusion_video_recovery_suppressed
                0x00000000001370ec       0x30 ${package_root}\build\out\work\application\build\software\16.o
                0x00000000001370ec                fusion_video_recovery_suppressed
 .text.fusion_video_invalidate
                0x000000000013711c       0x80 ${package_root}\build\out\work\application\build\software\16.o
                0x000000000013711c                fusion_video_invalidate
 .text.fusion_video_hard_invalidate
                0x000000000013719c       0x10 ${package_root}\build\out\work\application\build\software\16.o
                0x000000000013719c                fusion_video_hard_invalidate
 .text.fusion_video_begin
                0x00000000001371ac       0x78 ${package_root}\build\out\work\application\build\software\16.o
                0x00000000001371ac                fusion_video_begin
 .text.fusion_video_chunk
                0x0000000000137224       0x48 ${package_root}\build\out\work\application\build\software\16.o
                0x0000000000137224                fusion_video_chunk
 .text.fusion_video_abort
                0x000000000013726c       0x1c ${package_root}\build\out\work\application\build\software\16.o
                0x000000000013726c                fusion_video_abort
 .text.fusion_video_end
                0x0000000000137288       0x1c ${package_root}\build\out\work\application\build\software\16.o
                0x0000000000137288                fusion_video_end
 *fill*         0x00000000001372a4        0x4 
 .text.fusion_poll
                0x00000000001372a8     0x3a98 ${package_root}\build\out\work\application\build\software\16.o
                0x00000000001372a8                fusion_poll
 .text.av_crc32
                0x000000000013ad40      0x150 ${package_root}\build\out\work\application\build\software\17.o
                0x000000000013ad40                av_crc32
 .text.av_decode_packet
                0x000000000013ae90      0x1b4 ${package_root}\build\out\work\application\build\software\17.o
                0x000000000013ae90                av_decode_packet
 .text.descending
                0x000000000013b044       0x38 ${package_root}\build\out\work\application\build\software\18.o
 .text.requant4_28
                0x000000000013b07c       0x54 ${package_root}\build\out\work\application\build\software\18.o
 .text.ps_conv_reference
                0x000000000013b0d0      0x33c ${package_root}\build\out\work\application\build\software\18.o
                0x000000000013b0d0                ps_conv_reference
 .text.ssd_postprocess
                0x000000000013b40c      0x494 ${package_root}\build\out\work\application\build\software\18.o
                0x000000000013b40c                ssd_postprocess
 .text.ps_requant_selftest
                0x000000000013b8a0      0x1c0 ${package_root}\build\out\work\application\build\software\18.o
                0x000000000013b8a0                ps_requant_selftest
 .text.ps_add   0x000000000013ba60      0x288 ${package_root}\build\out\work\application\build\software\18.o
                0x000000000013ba60                ps_add
 .text.ps_conv  0x000000000013bce8      0x5d4 ${package_root}\build\out\work\application\build\software\18.o
                0x000000000013bce8                ps_conv
 .text.run_pixels
                0x000000000013c2bc      0x304 ${package_root}\build\out\work\application\build\software\19.o
 .text.push_hdr
                0x000000000013c5c0      0x164 ${package_root}\build\out\work\application\build\software\19.o
 *fill*         0x000000000013c724        0x4 
 .text.audio_run
                0x000000000013c728     0x1d98 ${package_root}\build\out\work\application\build\software\19.o
                0x000000000013c728                audio_run
 .text.run_pixels
                0x000000000013e4c0      0x304 ${package_root}\build\out\work\application\build\software\20.o
 .text.push_hdr
                0x000000000013e7c4      0x164 ${package_root}\build\out\work\application\build\software\20.o
 .text.image_run
                0x000000000013e928     0x1b24 ${package_root}\build\out\work\application\build\software\20.o
                0x000000000013e928                image_run
 .text.push_hdr
                0x000000000014044c      0x164 ${package_root}\build\out\work\application\build\software\21.o
 .text.ssd_run  0x00000000001405b0     0x12e0 ${package_root}\build\out\work\application\build\software\21.o
                0x00000000001405b0                ssd_run
 .text.mem_init
                0x0000000000141890       0x74 ${package_root}\build\out\work\application\build\software\22.o
                0x0000000000141890                mem_init
 .text.mem_free
                0x0000000000141904      0x12c ${package_root}\build\out\work\application\build\software\22.o
                0x0000000000141904                mem_free
 .text.mem_trim
                0x0000000000141a30      0x1a8 ${package_root}\build\out\work\application\build\software\22.o
                0x0000000000141a30                mem_trim
 .text.mem_malloc
                0x0000000000141bd8      0x220 ${package_root}\build\out\work\application\build\software\22.o
                0x0000000000141bd8                mem_malloc
 .text.update_diag
                0x0000000000141df8       0x70 ${package_root}\build\out\work\application\build\software\23.o
 .text.write_mode
                0x0000000000141e68       0xb0 ${package_root}\build\out\work\application\build\software\23.o
 .text.board_keys_init
                0x0000000000141f18      0x18c ${package_root}\build\out\work\application\build\software\23.o
                0x0000000000141f18                board_keys_init
 .text.board_keys_poll
                0x00000000001420a4      0x5a4 ${package_root}\build\out\work\application\build\software\23.o
                0x00000000001420a4                board_keys_poll
 .text.network_standalone_poll
                0x0000000000142648      0x29c ${package_root}\build\out\work\application\build\software\24.o
                0x0000000000142648                network_standalone_poll
 .text.network_standalone_init
                0x00000000001428e4       0x4c ${package_root}\build\out\work\application\build\software\24.o
                0x00000000001428e4                network_standalone_init
 .text.SetUpSLCRDivisors
                0x0000000000142930      0x128 ${package_root}\build\out\work\application\build\software\25.o
 .text.detect_phy
                0x0000000000142a58       0xd8 ${package_root}\build\out\work\application\build\software\25.o
                0x0000000000142a58                detect_phy
 .text.phy_setup_emacps
                0x0000000000142b30      0x7d8 ${package_root}\build\out\work\application\build\software\25.o
                0x0000000000142b30                phy_setup_emacps
 .text.network_standalone_clock
                0x0000000000143308       0x24 ${package_root}\build\out\work\application\build\software\25.o
                0x0000000000143308                network_standalone_clock
 .text.sd_record_species_code
                0x000000000014332c       0x18 ${package_root}\build\out\work\application\build\software\26.o
                0x000000000014332c                sd_record_species_code
 .text.sd_record_label
                0x0000000000143344      0x1bc ${package_root}\build\out\work\application\build\software\26.o
                0x0000000000143344                sd_record_label
 .text.sd_record_frame_abort
                0x0000000000143500       0x48 ${package_root}\build\out\work\application\build\software\26.o
                0x0000000000143500                sd_record_frame_abort
 .text.sd_record_init
                0x0000000000143548       0xc4 ${package_root}\build\out\work\application\build\software\26.o
                0x0000000000143548                sd_record_init
 .text.sd_record_target
                0x000000000014360c      0x1cc ${package_root}\build\out\work\application\build\software\26.o
                0x000000000014360c                sd_record_target
 .text.sd_record_frame_begin
                0x00000000001437d8      0x400 ${package_root}\build\out\work\application\build\software\26.o
                0x00000000001437d8                sd_record_frame_begin
 .text.sd_record_frame_chunk
                0x0000000000143bd8      0x1bc ${package_root}\build\out\work\application\build\software\26.o
                0x0000000000143bd8                sd_record_frame_chunk
 .text.sd_record_frame_end
                0x0000000000143d94      0x160 ${package_root}\build\out\work\application\build\software\26.o
                0x0000000000143d94                sd_record_frame_end
 .text.sd_record_status
                0x0000000000143ef4      0x148 ${package_root}\build\out\work\application\build\software\26.o
                0x0000000000143ef4                sd_record_status
 .text.standalone_fusion_start
                0x000000000014403c       0xf4 ${package_root}\build\out\work\application\build\software\27.o
                0x000000000014403c                standalone_fusion_start
 .text.standalone_fusion_poll
                0x0000000000144130       0x2c ${package_root}\build\out\work\application\build\software\27.o
                0x0000000000144130                standalone_fusion_poll
 .text.standalone_fusion_command
                0x000000000014415c       0xa8 ${package_root}\build\out\work\application\build\software\27.o
                0x000000000014415c                standalone_fusion_command
 .text.valid_roi
                0x0000000000144204       0x94 ${package_root}\build\out\work\application\build\software\28.o
 .text.ssd_roi_from_box
                0x0000000000144298      0x250 ${package_root}\build\out\work\application\build\software\28.o
                0x0000000000144298                ssd_roi_from_box
 .text.ssd_roi_map
                0x00000000001444e8      0x1a0 ${package_root}\build\out\work\application\build\software\28.o
                0x00000000001444e8                ssd_roi_map
 .text.ssd_roi_input
                0x0000000000144688      0x568 ${package_root}\build\out\work\application\build\software\28.o
                0x0000000000144688                ssd_roi_input
 .text.sound_round_tuning_init
                0x0000000000144bf0       0xd4 ${package_root}\build\out\work\application\build\software\29.o
                0x0000000000144bf0                sound_round_tuning_init
 .text.sound_round_tuning_revision
                0x0000000000144cc4       0x10 ${package_root}\build\out\work\application\build\software\29.o
                0x0000000000144cc4                sound_round_tuning_revision
 *fill*         0x0000000000144cd4        0x4 
 .text.sound_round_tuning_command
                0x0000000000144cd8      0x3a0 ${package_root}\build\out\work\application\build\software\29.o
                0x0000000000144cd8                sound_round_tuning_command
 .text.sound_round_tuning_status
                0x0000000000145078      0x1dc ${package_root}\build\out\work\application\build\software\29.o
                0x0000000000145078                sound_round_tuning_status
 .text.stream_tuning_init
                0x0000000000145254       0x68 ${package_root}\build\out\work\application\build\software\30.o
                0x0000000000145254                stream_tuning_init
 .text.stream_preview_interval_us
                0x00000000001452bc       0x2c ${package_root}\build\out\work\application\build\software\30.o
                0x00000000001452bc                stream_preview_interval_us
 .text.stream_tuning_command
                0x00000000001452e8      0x2c4 ${package_root}\build\out\work\application\build\software\30.o
                0x00000000001452e8                stream_tuning_command
 .text.stream_tuning_status
                0x00000000001455ac       0xb8 ${package_root}\build\out\work\application\build\software\30.o
                0x00000000001455ac                stream_tuning_status
 .text.valid_box
                0x0000000000145664       0xe8 ${package_root}\build\out\work\application\build\software\31.o
 .text.ssd_fast_reset
                0x000000000014574c       0xdc ${package_root}\build\out\work\application\build\software\31.o
                0x000000000014574c                ssd_fast_reset
 .text.ssd_fast_init
                0x0000000000145828      0x10c ${package_root}\build\out\work\application\build\software\31.o
                0x0000000000145828                ssd_fast_init
 .text.ssd_fast_selection
                0x0000000000145934      0xaa4 ${package_root}\build\out\work\application\build\software\31.o
                0x0000000000145934                ssd_fast_selection
 .text.ssd_fast_poll
                0x00000000001463d8      0x6fc ${package_root}\build\out\work\application\build\software\31.o
                0x00000000001463d8                ssd_fast_poll
 .text.ssd_fast_handoff
                0x0000000000146ad4      0x15c ${package_root}\build\out\work\application\build\software\31.o
                0x0000000000146ad4                ssd_fast_handoff
 .text.ssd_fast_view
                0x0000000000146c30       0xd0 ${package_root}\build\out\work\application\build\software\31.o
                0x0000000000146c30                ssd_fast_view
 .text.ssd_fast_send
                0x0000000000146d00      0x1b0 ${package_root}\build\out\work\application\build\software\31.o
                0x0000000000146d00                ssd_fast_send
 .text.ssd_fast_hold_scan
                0x0000000000146eb0       0xa4 ${package_root}\build\out\work\application\build\software\31.o
                0x0000000000146eb0                ssd_fast_hold_scan
 .text.ssd_fast_class_reuse
                0x0000000000146f54      0x148 ${package_root}\build\out\work\application\build\software\31.o
                0x0000000000146f54                ssd_fast_class_reuse
 .text.ssd_fast_class_store
                0x000000000014709c      0x1b8 ${package_root}\build\out\work\application\build\software\31.o
                0x000000000014709c                ssd_fast_class_store
 *fill*         0x0000000000147254        0x4 
 .text.ssd_fast_class_report
                0x0000000000147258      0x150 ${package_root}\build\out\work\application\build\software\31.o
                0x0000000000147258                ssd_fast_class_report
 .text.ssd_fast_archive_identity
                0x00000000001473a8       0x84 ${package_root}\build\out\work\application\build\software\31.o
                0x00000000001473a8                ssd_fast_archive_identity
 .text.ssd_fast_archive_store
                0x000000000014742c      0x1d0 ${package_root}\build\out\work\application\build\software\31.o
                0x000000000014742c                ssd_fast_archive_store
 .text.ssd_fast_archive_snapshot
                0x00000000001475fc      0x128 ${package_root}\build\out\work\application\build\software\31.o
                0x00000000001475fc                ssd_fast_archive_snapshot
 .text.hdmi_output_restart
                0x0000000000147724       0x38 ${package_root}\build\out\work\application\build\software\32.o
                0x0000000000147724                hdmi_output_restart
 .text.hdmi_vdma_config
                0x000000000014775c       0xac ${package_root}\build\out\work\application\build\software\32.o
                0x000000000014775c                hdmi_vdma_config
 .text.hdmi_capture_genlock
                0x0000000000147808        0xc ${package_root}\build\out\work\application\build\software\32.o
                0x0000000000147808                hdmi_capture_genlock
 *fill*         0x0000000000147814        0x4 
 .text.hdmi_output_poll
                0x0000000000147818      0x150 ${package_root}\build\out\work\application\build\software\32.o
                0x0000000000147818                hdmi_output_poll
 .text.board_display_result
                0x0000000000147968       0x48 ${package_root}\build\out\work\application\build\software\33.o
                0x0000000000147968                board_display_result
 .text.board_display_poll
                0x00000000001479b0      0x574 ${package_root}\build\out\work\application\build\software\33.o
                0x00000000001479b0                board_display_poll
 .text.finish_scan
                0x0000000000147f24      0x10c ${package_root}\build\out\work\application\build\software\34.o
 .text.move_lens
                0x0000000000148030       0x98 ${package_root}\build\out\work\application\build\software\34.o
 .text.next_search_position
                0x00000000001480c8      0x274 ${package_root}\build\out\work\application\build\software\34.o
 .text.board_focus_searching
                0x000000000014833c       0x18 ${package_root}\build\out\work\application\build\software\34.o
                0x000000000014833c                board_focus_searching
 .text.board_focus_frame_begin
                0x0000000000148354       0x88 ${package_root}\build\out\work\application\build\software\34.o
                0x0000000000148354                board_focus_frame_begin
 .text.board_focus_frame_chunk
                0x00000000001483dc      0x3d8 ${package_root}\build\out\work\application\build\software\34.o
                0x00000000001483dc                board_focus_frame_chunk
 .text.board_focus_frame_end
                0x00000000001487b4      0x6ac ${package_root}\build\out\work\application\build\software\34.o
                0x00000000001487b4                board_focus_frame_end
 .text.board_focus_observe
                0x0000000000148e60      0x2b4 ${package_root}\build\out\work\application\build\software\34.o
                0x0000000000148e60                board_focus_observe
 .text.board_focus_track
                0x0000000000149114      0x1e8 ${package_root}\build\out\work\application\build\software\34.o
                0x0000000000149114                board_focus_track
 .text.board_focus_policy_poll
                0x00000000001492fc     0x1294 ${package_root}\build\out\work\application\build\software\34.o
                0x00000000001492fc                board_focus_policy_poll
 .text.board_focus_policy_poll.__stub
                0x000000000014a590       0x1a linker stubs
 *(.gnu.linkonce.t.*)
 *(.plt)
 *(.gnu_warning)
 *(.gcc_execpt_table)
 *(.glue_7)
 .glue_7        0x000000000014a5aa        0x0 linker stubs
 *(.glue_7t)
 .glue_7t       0x000000000014a5aa        0x0 linker stubs
 *(.vfp11_veneer)
 .vfp11_veneer  0x000000000014a5aa        0x0 linker stubs
 *(.ARM.extab)
 *(.gnu.linkonce.armextab.*)

.v4_bx          0x000000000014a5ac        0x0
 .v4_bx         0x000000000014a5ac        0x0 linker stubs

.iplt           0x000000000014a5ac        0x0
 .iplt          0x000000000014a5ac        0x0 ${vitis_install}/gnu/aarch32/nt/gcc-arm-none-eabi/bin//../aarch32-xilinx-eabi/usr/lib/thumb/v7-a+fp/hard/crtbegin.o

.init           0x000000000014a5ac        0xc
 *(.init)
 .init          0x000000000014a5ac        0x4 ${vitis_install}/gnu/aarch32/nt/gcc-arm-none-eabi/bin//../aarch32-xilinx-eabi/usr/lib/thumb/v7-a+fp/hard/crti.o
                0x000000000014a5ac                _init
 .init          0x000000000014a5b0        0x8 ${vitis_install}/gnu/aarch32/nt/gcc-arm-none-eabi/bin//../aarch32-xilinx-eabi/usr/lib/thumb/v7-a+fp/hard/crtn.o

.fini           0x000000000014a5b8        0xc
 *(.fini)
 .fini          0x000000000014a5b8        0x4 ${vitis_install}/gnu/aarch32/nt/gcc-arm-none-eabi/bin//../aarch32-xilinx-eabi/usr/lib/thumb/v7-a+fp/hard/crti.o
                0x000000000014a5b8                _fini
 .fini          0x000000000014a5bc        0x8 ${vitis_install}/gnu/aarch32/nt/gcc-arm-none-eabi/bin//../aarch32-xilinx-eabi/usr/lib/thumb/v7-a+fp/hard/crtn.o

.rodata         0x000000000014a5c8    0x16a53
                0x000000000014a5c8                __rodata_start = .
 *(.rodata)
 .rodata        0x000000000014a5c8       0x18 ${package_root}\build\out\work\application\build\software\0.o
 .rodata        0x000000000014a5e0        0x6 ${package_root}\build\out\work\application\build\software\9.o
 *fill*         0x000000000014a5e6        0x2 
 .rodata        0x000000000014a5e8       0x40 ${package_root}\build\out\work\application\build\software\10.o
 .rodata        0x000000000014a628       0x14 ${package_root}\build\out\work\application\build\software\16.o
 .rodata        0x000000000014a63c       0x18 ${package_root}\build\out\work\application\build\software\28.o
 .rodata        0x000000000014a654        0xe ${package_root}\build\out\work\platform\bsp_core0\lib\liblwip4.a(ethernet.o)
                0x000000000014a654                ethbroadcast
                0x000000000014a65c                ethzero
 *fill*         0x000000000014a662        0x2 
 .rodata        0x000000000014a664        0x8 ${package_root}\build\out\work\platform\bsp_core0\lib\liblwip4.a(ip4_addr.o)
                0x000000000014a664                ip_addr_broadcast
                0x000000000014a668                ip_addr_any
 .rodata        0x000000000014a66c       0xb4 ${package_root}\build\out\work\platform\bsp_core0\lib\liblwip4.a(memp.o)
                0x000000000014a66c                memp_UDP_PCB
                0x000000000014a67c                memp_pools
                0x000000000014a6a0                memp_PBUF_POOL
                0x000000000014a6b0                memp_PBUF
                0x000000000014a6c0                memp_ARP_QUEUE
                0x000000000014a6d0                memp_FRAG_PBUF
                0x000000000014a6e0                memp_REASSDATA
                0x000000000014a6f0                memp_TCP_SEG
                0x000000000014a700                memp_TCP_PCB_LISTEN
                0x000000000014a710                memp_TCP_PCB
 .rodata        0x000000000014a720       0x54 ${package_root}\build\out\work\platform\bsp_core0\lib\liblwip4.a(tcp.o)
                0x000000000014a720                tcp_pcb_lists
 .rodata        0x000000000014a774       0x23 ${package_root}\build\out\work\platform\bsp_core0\lib\liblwip4.a(xemacpsif.o)
 *fill*         0x000000000014a797        0x1 
 .rodata        0x000000000014a798       0x21 ${package_root}\build\out\work\platform\bsp_core0\lib\liblwip4.a(xemacpsif_hw.o)
 *fill*         0x000000000014a7b9        0x3 
 .rodata        0x000000000014a7bc       0x40 ${package_root}\build\out\work\platform\bsp_core0\lib\libxil.a(xemacps_control.o)
 *fill*         0x000000000014a7fc        0x4 
 .rodata        0x000000000014a800      0x148 ${vitis_install}/gnu/aarch32/nt/gcc-arm-none-eabi/bin//../aarch32-xilinx-eabi/usr/lib/thumb/v7-a+fp/hard\libm.a(lib_a-sf_exp2_data.o)
                0x000000000014a800                __exp2f_data
 .rodata        0x000000000014a948      0x101 ${vitis_install}/gnu/aarch32/nt/gcc-arm-none-eabi/bin//../aarch32-xilinx-eabi/usr/lib/thumb/v7-a+fp/hard\libc.a(lib_a-ctype_.o)
                0x000000000014a948                _ctype_
 *fill*         0x000000000014aa49        0x3 
 .rodata        0x000000000014aa4c        0x4 ${vitis_install}/gnu/aarch32/nt/gcc-arm-none-eabi/bin//../aarch32-xilinx-eabi/usr/lib/thumb/v7-a+fp/hard\libc.a(lib_a-impure.o)
                0x000000000014aa4c                _global_impure_ptr
 .rodata        0x000000000014aa50       0x20 ${vitis_install}/gnu/aarch32/nt/gcc-arm-none-eabi/bin//../aarch32-xilinx-eabi/usr/lib/thumb/v7-a+fp/hard\libc.a(lib_a-svfprintf.o)
 .rodata        0x000000000014aa70      0x128 ${vitis_install}/gnu/aarch32/nt/gcc-arm-none-eabi/bin//../aarch32-xilinx-eabi/usr/lib/thumb/v7-a+fp/hard\libc.a(lib_a-mprec.o)
                0x000000000014aa80                __mprec_tens
                0x000000000014ab48                __mprec_tinytens
                0x000000000014ab70                __mprec_bigtens
 .rodata        0x000000000014ab98       0x20 ${vitis_install}/gnu/aarch32/nt/gcc-arm-none-eabi/bin//../aarch32-xilinx-eabi/usr/lib/thumb/v7-a+fp/hard\libc.a(lib_a-svfiprintf.o)
 .rodata        0x000000000014abb8       0x20 ${vitis_install}/gnu/aarch32/nt/gcc-arm-none-eabi/bin//../aarch32-xilinx-eabi/usr/lib/thumb/v7-a+fp/hard\libc.a(lib_a-vfiprintf.o)
 *(.rodata.*)
 .rodata.outnum.str1.4
                0x000000000014abd8       0x11 ${package_root}\build\out\work\application\build\software\3.o
 *fill*         0x000000000014abe9        0x3 
 .rodata.ov5640_af_firmware
                0x000000000014abec      0xfed ${package_root}\build\out\work\application\build\software\4.o
 *fill*         0x000000000014bbd9        0x3 
 .rodata.main.str1.4
                0x000000000014bbdc       0x86 ${package_root}\build\out\work\application\build\software\7.o
 *fill*         0x000000000014bc62        0x2 
 .rodata.recovery_verify
                0x000000000014bc64       0x44 ${package_root}\build\out\work\application\build\software\8.o
 .rodata.recovery_contract
                0x000000000014bca8       0x20 ${package_root}\build\out\work\application\build\software\8.o
 .rodata.ov5640_1080p15_regs
                0x000000000014bcc8       0xd4 ${package_root}\build\out\work\application\build\software\8.o
 .rodata.ov5640_init_regs
                0x000000000014bd9c      0x33c ${package_root}\build\out\work\application\build\software\8.o
 .rodata.upper.0
                0x000000000014c0d8       0x20 ${package_root}\build\out\work\application\build\software\10.o
 .rodata.lower.1
                0x000000000014c0f8       0x20 ${package_root}\build\out\work\application\build\software\10.o
 .rodata.angle_table
                0x000000000014c118       0x54 ${package_root}\build\out\work\application\build\software\10.o
 .rodata.pulse_table
                0x000000000014c16c       0x54 ${package_root}\build\out\work\application\build\software\10.o
 .rodata.ff_defaults
                0x000000000014c1c0       0x20 ${package_root}\build\out\work\application\build\software\10.o
 .rodata.tuning_defaults
                0x000000000014c1e0       0x20 ${package_root}\build\out\work\application\build\software\10.o
 .rodata.audio_defaults
                0x000000000014c200       0x20 ${package_root}\build\out\work\application\build\software\10.o
 .rodata.make_header.str1.4
                0x000000000014c220        0x5 ${package_root}\build\out\work\application\build\software\13.o
 *fill*         0x000000000014c225        0x3 
 .rodata.publish.str1.4
                0x000000000014c228       0x42 ${package_root}\build\out\work\application\build\software\16.o
 *fill*         0x000000000014c26a        0x2 
 .rodata.defaults.1
                0x000000000014c26c       0x14 ${package_root}\build\out\work\application\build\software\16.o
 .rodata.crc_table
                0x000000000014c280     0x2000 ${package_root}\build\out\work\application\build\software\17.o
 .rodata.edge.0
                0x000000000014e280       0x34 ${package_root}\build\out\work\application\build\software\18.o
 *fill*         0x000000000014e2b4        0x4 
 .rodata.muls.1
                0x000000000014e2b8       0x10 ${package_root}\build\out\work\application\build\software\18.o
 .rodata.audio_run.str1.4
                0x000000000014e2c8       0x31 ${package_root}\build\out\work\application\build\software\19.o
 *fill*         0x000000000014e2f9        0x3 
 .rodata.add_after.2
                0x000000000014e2fc       0x28 ${package_root}\build\out\work\application\build\software\19.o
 .rodata.blk_start.3
                0x000000000014e324       0x28 ${package_root}\build\out\work\application\build\software\19.o
 .rodata.ADDS   0x000000000014e34c      0x118 ${package_root}\build\out\work\application\build\software\19.o
 .rodata.str1.4
                0x000000000014e464      0x410 ${package_root}\build\out\work\application\build\software\19.o
 .rodata.LAYERS
                0x000000000014e874      0x9c0 ${package_root}\build\out\work\application\build\software\19.o
 .rodata.MAP_ADDE
                0x000000000014f234       0x28 ${package_root}\build\out\work\application\build\software\19.o
 .rodata.MAP_ADDB
                0x000000000014f25c       0x28 ${package_root}\build\out\work\application\build\software\19.o
 .rodata.MAP_ADDA
                0x000000000014f284       0x28 ${package_root}\build\out\work\application\build\software\19.o
 .rodata.MAP_BIASL
                0x000000000014f2ac       0xd0 ${package_root}\build\out\work\application\build\software\19.o
 .rodata.MAP_WGHT
                0x000000000014f37c       0xd0 ${package_root}\build\out\work\application\build\software\19.o
 .rodata.MAP_EXPCT
                0x000000000014f44c       0xd0 ${package_root}\build\out\work\application\build\software\19.o
 .rodata.MAP_GOLDIN
                0x000000000014f51c       0xd0 ${package_root}\build\out\work\application\build\software\19.o
 .rodata.image_run.str1.4
                0x000000000014f5ec       0x31 ${package_root}\build\out\work\application\build\software\20.o
 .rodata.add_after.2
                0x000000000014f5ec       0x28 ${package_root}\build\out\work\application\build\software\20.o
 .rodata.blk_start.3
                0x000000000014f614       0x28 ${package_root}\build\out\work\application\build\software\20.o
 .rodata.IMAGE_ADDS
                0x000000000014f63c      0x118 ${package_root}\build\out\work\application\build\software\20.o
 .rodata.str1.4
                0x000000000014f754      0x410 ${package_root}\build\out\work\application\build\software\20.o
 .rodata.IMAGE_LAYERS
                0x000000000014f754      0x9c0 ${package_root}\build\out\work\application\build\software\20.o
 .rodata.MAP_ADDE
                0x0000000000150114       0x28 ${package_root}\build\out\work\application\build\software\20.o
 .rodata.MAP_ADDB
                0x000000000015013c       0x28 ${package_root}\build\out\work\application\build\software\20.o
 .rodata.MAP_ADDA
                0x0000000000150164       0x28 ${package_root}\build\out\work\application\build\software\20.o
 .rodata.MAP_BIASL
                0x000000000015018c       0xd0 ${package_root}\build\out\work\application\build\software\20.o
 .rodata.MAP_WGHT
                0x000000000015025c       0xd0 ${package_root}\build\out\work\application\build\software\20.o
 .rodata.MAP_EXPCT
                0x000000000015032c       0xd0 ${package_root}\build\out\work\application\build\software\20.o
 .rodata.MAP_GOLDIN
                0x00000000001503fc       0xd0 ${package_root}\build\out\work\application\build\software\20.o
 .rodata.SSD_ANCHORS
                0x00000000001504cc     0xca20 ${package_root}\build\out\work\application\build\software\21.o
 .rodata.SSD_HEADS
                0x000000000015ceec       0xc0 ${package_root}\build\out\work\application\build\software\21.o
 .rodata.SSD_LAYERS
                0x000000000015cfac     0x3288 ${package_root}\build\out\work\application\build\software\21.o
 .rodata.SetUpSLCRDivisors.str1.4
                0x0000000000160234       0x2a ${package_root}\build\out\work\application\build\software\25.o
 *fill*         0x000000000016025e        0x2 
 .rodata.detect_phy.str1.4
                0x0000000000160260       0x62 ${package_root}\build\out\work\application\build\software\25.o
 *fill*         0x00000000001602c2        0x2 
 .rodata.phy_setup_emacps.str1.4
                0x00000000001602c4       0xf0 ${package_root}\build\out\work\application\build\software\25.o
 .rodata.str1.4
                0x00000000001603b4      0x1df ${package_root}\build\out\work\application\build\software\26.o
 *fill*         0x0000000000160593        0x1 
 .rodata.sd_species_codes
                0x0000000000160594       0xf0 ${package_root}\build\out\work\application\build\software\26.o
 .rodata.defaults.1
                0x0000000000160684       0x14 ${package_root}\build\out\work\application\build\software\29.o
 .rodata.board_display_poll.str1.4
                0x0000000000160698       0xb5 ${package_root}\build\out\work\application\build\software\33.o
 *fill*         0x000000000016074d        0x3 
 .rodata.str1.4
                0x0000000000160750      0x1df ${package_root}\build\out\work\application\build\software\33.o
 *fill*         0x000000000016092f        0x1 
 .rodata.labels
                0x0000000000160930       0xf0 ${package_root}\build\out\work\application\build\software\33.o
 .rodata.coarse
                0x0000000000160a20       0x24 ${package_root}\build\out\work\application\build\software\34.o
 .rodata.str1.4
                0x0000000000160a44       0x76 ${package_root}\build\out\work\platform\bsp_core0\lib\liblwip4.a(tcp.o)
 *fill*         0x0000000000160aba        0x2 
 .rodata.str1.4
                0x0000000000160abc      0x10f ${package_root}\build\out\work\platform\bsp_core0\lib\liblwip4.a(xadapter.o)
 *fill*         0x0000000000160bcb        0x1 
 .rodata.str1.4
                0x0000000000160bcc       0x40 ${package_root}\build\out\work\platform\bsp_core0\lib\liblwip4.a(xemacpsif.o)
 .rodata.str1.4
                0x0000000000160c0c       0xbe ${package_root}\build\out\work\platform\bsp_core0\lib\liblwip4.a(xemacpsif_dma.o)
 *fill*         0x0000000000160cca        0x2 
 .rodata.str1.4
                0x0000000000160ccc       0x4b ${package_root}\build\out\work\platform\bsp_core0\lib\liblwip4.a(xemacpsif_hw.o)
 *fill*         0x0000000000160d17        0x1 
 .rodata.str1.4
                0x0000000000160d18       0x1c ${package_root}\build\out\work\platform\bsp_core0\lib\liblwip4.a(xpqueue.o)
 .rodata.str1.4
                0x0000000000160d34       0x48 ${package_root}\build\out\work\platform\bsp_core0\lib\liblwip4.a(def.o)
 .rodata.str1.4
                0x0000000000160d7c       0x68 ${package_root}\build\out\work\platform\bsp_core0\lib\libxil.a(xaxidma_bdring.o)
                                         0x6b (size before relaxing)
 .rodata.str1.4
                0x0000000000160de4        0xb ${package_root}\build\out\work\platform\bsp_core0\lib\libxil.a(xaxivdma.o)
 *fill*         0x0000000000160def        0x1 
 .rodata.str1.4
                0x0000000000160df0       0x6d ${package_root}\build\out\work\platform\bsp_core0\lib\libxil.a(xaxivdma_channel.o)
 *fill*         0x0000000000160e5d        0x3 
 .rodata.str1.4
                0x0000000000160e60       0x10 ${package_root}\build\out\work\platform\bsp_core0\lib\libxil.a(xaxivdma_intr.o)
 .rodata.str1.4
                0x0000000000160e70        0xa ${package_root}\build\out\work\platform\bsp_core0\lib\libxil.a(xemacps.o)
 *fill*         0x0000000000160e7a        0x2 
 .rodata.str1.4
                0x0000000000160e7c        0xf ${package_root}\build\out\work\platform\bsp_core0\lib\libxil.a(xemacps_intr.o)
 *fill*         0x0000000000160e8b        0x1 
 .rodata.str1.4
                0x0000000000160e8c       0x12 ${package_root}\build\out\work\platform\bsp_core0\lib\libxil.a(xemacps_control.o)
 *fill*         0x0000000000160e9e        0x2 
 .rodata.str1.4
                0x0000000000160ea0       0x11 ${package_root}\build\out\work\platform\bsp_core0\lib\libxil.a(xemacps_bdring.o)
 *fill*         0x0000000000160eb1        0x3 
 .rodata.str1.4
                0x0000000000160eb4        0x8 ${package_root}\build\out\work\platform\bsp_core0\lib\libxil.a(xgpio.o)
 .rodata.str1.4
                0x0000000000160ebc        0xe ${package_root}\build\out\work\platform\bsp_core0\lib\libxil.a(xgpio_sinit.o)
 *fill*         0x0000000000160eca        0x2 
 .rodata.str1.4
                0x0000000000160ecc        0xd ${package_root}\build\out\work\platform\bsp_core0\lib\libxil.a(xscugic_hw.o)
 *fill*         0x0000000000160ed9        0x3 
 .rodata.str1.4
                0x0000000000160edc        0xa ${package_root}\build\out\work\platform\bsp_core0\lib\libxil.a(xscugic.o)
 .rodata.str1.4
                0x0000000000160ee6        0xa ${vitis_install}/gnu/aarch32/nt/gcc-arm-none-eabi/bin//../aarch32-xilinx-eabi/usr/lib/thumb/v7-a+fp/hard\libc.a(lib_a-puts.o)
                                          0x2 (size before relaxing)
 *fill*         0x0000000000160ee6        0x2 
 .rodata.str1.4
                0x0000000000160ee8       0x2e ${vitis_install}/gnu/aarch32/nt/gcc-arm-none-eabi/bin//../aarch32-xilinx-eabi/usr/lib/thumb/v7-a+fp/hard\libc.a(lib_a-svfprintf.o)
                                         0x42 (size before relaxing)
 *fill*         0x0000000000160f16        0x2 
 .rodata.str1.4
                0x0000000000160f18       0x69 ${vitis_install}/gnu/aarch32/nt/gcc-arm-none-eabi/bin//../aarch32-xilinx-eabi/usr/lib/thumb/v7-a+fp/hard\libc.a(lib_a-dtoa.o)
                                         0x6d (size before relaxing)
 *fill*         0x0000000000160f81        0x3 
 .rodata.str1.4
                0x0000000000160f84        0xe ${vitis_install}/gnu/aarch32/nt/gcc-arm-none-eabi/bin//../aarch32-xilinx-eabi/usr/lib/thumb/v7-a+fp/hard\libc.a(lib_a-locale.o)
                                         0x12 (size before relaxing)
 *fill*         0x0000000000160f92        0x2 
 .rodata.str1.4
                0x0000000000160f94       0x46 ${vitis_install}/gnu/aarch32/nt/gcc-arm-none-eabi/bin//../aarch32-xilinx-eabi/usr/lib/thumb/v7-a+fp/hard\libc.a(lib_a-mprec.o)
                                         0x5a (size before relaxing)
 .rodata.str1.4
                0x0000000000160fda       0x2f ${vitis_install}/gnu/aarch32/nt/gcc-arm-none-eabi/bin//../aarch32-xilinx-eabi/usr/lib/thumb/v7-a+fp/hard\libc.a(lib_a-svfiprintf.o)
 *fill*         0x0000000000160fda        0x2 
 .rodata.str1.4
                0x0000000000160fdc       0x3f ${vitis_install}/gnu/aarch32/nt/gcc-arm-none-eabi/bin//../aarch32-xilinx-eabi/usr/lib/thumb/v7-a+fp/hard\libc.a(lib_a-assert.o)
                                         0x43 (size before relaxing)
 .rodata.str1.4
                0x000000000016101b       0x2f ${vitis_install}/gnu/aarch32/nt/gcc-arm-none-eabi/bin//../aarch32-xilinx-eabi/usr/lib/thumb/v7-a+fp/hard\libc.a(lib_a-vfiprintf.o)
 *(.gnu.linkonce.r.*)
                0x000000000016101b                __rodata_end = .

.rodata1        0x000000000016101b        0x0
                0x000000000016101b                __rodata1_start = .
 *(.rodata1)
 *(.rodata1.*)
                0x000000000016101b                __rodata1_end = .

.sdata2         0x000000000016101b        0x0
                0x000000000016101b                __sdata2_start = .
 *(.sdata2)
 *(.sdata2.*)
 *(.gnu.linkonce.s2.*)
                0x000000000016101b                __sdata2_end = .

.sbss2          0x000000000016101b        0x0
                0x000000000016101b                __sbss2_start = .
 *(.sbss2)
 *(.sbss2.*)
 *(.gnu.linkonce.sb2.*)
                0x000000000016101b                __sbss2_end = .

.data           0x0000000000161020      0xec0
                0x0000000000161020                __data_start = .
 *(.data)
 .data          0x0000000000161020        0x8 ${package_root}\build\out\work\platform\bsp_core0\lib\liblwip4.a(tcp.o)
 .data          0x0000000000161028        0x2 ${package_root}\build\out\work\platform\bsp_core0\lib\liblwip4.a(udp.o)
 *fill*         0x000000000016102a        0x2 
 .data          0x000000000016102c        0x4 ${package_root}\build\out\work\platform\bsp_core0\lib\liblwip4.a(xemacpsif_hw.o)
                0x000000000016102c                link_speed
 .data          0x0000000000161030       0x1c ${package_root}\build\out\work\platform\bsp_core0\lib\liblwip4.a(xtopology_g.o)
                0x0000000000161030                xtopology_n_emacs
                0x0000000000161034                xtopology
 .data          0x000000000016104c        0xc ${package_root}\build\out\work\platform\bsp_core0\lib\libxil.a(xemacps_g.o)
                0x000000000016104c                XEmacPs_ConfigTable
 .data          0x0000000000161058      0x304 ${package_root}\build\out\work\platform\bsp_core0\lib\libxil.a(xscugic_g.o)
                0x0000000000161058                XScuGic_ConfigTable
 .data          0x000000000016135c        0x4 ${package_root}\build\out\work\platform\bsp_core0\lib\libxil.a(xil_assert.o)
                0x000000000016135c                Xil_AssertWait
 .data          0x0000000000161360       0x38 ${package_root}\build\out\work\platform\bsp_core0\lib\libxil.a(xil_exception.o)
                0x0000000000161360                XExc_VectorTable
 .data          0x0000000000161398       0x44 ${package_root}\build\out\work\platform\bsp_core0\lib\libxil.a(xaxidma_g.o)
                0x0000000000161398                XAxiDma_ConfigTable
 .data          0x00000000001613dc       0x80 ${package_root}\build\out\work\platform\bsp_core0\lib\libxil.a(xaxivdma_g.o)
                0x00000000001613dc                XAxiVdma_ConfigTable
 .data          0x000000000016145c       0x10 ${package_root}\build\out\work\platform\bsp_core0\lib\libxil.a(xgpio_g.o)
                0x000000000016145c                XGpio_ConfigTable
 *fill*         0x000000000016146c        0x4 
 .data          0x0000000000161470      0x430 ${vitis_install}/gnu/aarch32/nt/gcc-arm-none-eabi/bin//../aarch32-xilinx-eabi/usr/lib/thumb/v7-a+fp/hard\libc.a(lib_a-impure.o)
                0x0000000000161470                _impure_ptr
 .data          0x00000000001618a0      0x410 ${vitis_install}/gnu/aarch32/nt/gcc-arm-none-eabi/bin//../aarch32-xilinx-eabi/usr/lib/thumb/v7-a+fp/hard\libc.a(lib_a-mallocr.o)
                0x00000000001618a0                __malloc_av_
                0x0000000000161ca8                __malloc_sbrk_base
                0x0000000000161cac                __malloc_trim_threshold
 .data          0x0000000000161cb0      0x16c ${vitis_install}/gnu/aarch32/nt/gcc-arm-none-eabi/bin//../aarch32-xilinx-eabi/usr/lib/thumb/v7-a+fp/hard\libc.a(lib_a-locale.o)
                0x0000000000161cb0                __global_locale
 *(.data.*)
 .data.audio_revision
                0x0000000000161e1c        0x4 ${package_root}\build\out\work\application\build\software\10.o
 .data.audio_values
                0x0000000000161e20       0x20 ${package_root}\build\out\work\application\build\software\10.o
 .data.scan_interval_us
                0x0000000000161e40        0x4 ${package_root}\build\out\work\application\build\software\10.o
 .data.scan_step_us
                0x0000000000161e44        0x4 ${package_root}\build\out\work\application\build\software\10.o
 .data.scan_rate_dps
                0x0000000000161e48        0x4 ${package_root}\build\out\work\application\build\software\10.o
 .data.network_video_gap_us
                0x0000000000161e4c        0x4 ${package_root}\build\out\work\application\build\software\11.o
                0x0000000000161e4c                network_video_gap_us
 .data.video_fast_tracker
                0x0000000000161e50        0x4 ${package_root}\build\out\work\application\build\software\15.o
                0x0000000000161e50                video_fast_tracker
 .data.motion_scale
                0x0000000000161e54        0x4 ${package_root}\build\out\work\application\build\software\15.o
 .data.cfg.2    0x0000000000161e58       0x44 ${package_root}\build\out\work\application\build\software\16.o
 .data.fusion_image_weight
                0x0000000000161e9c        0x4 ${package_root}\build\out\work\application\build\software\16.o
                0x0000000000161e9c                fusion_image_weight
 .data.fusion_detection_threshold
                0x0000000000161ea0        0x4 ${package_root}\build\out\work\application\build\software\16.o
                0x0000000000161ea0                fusion_detection_threshold
 .data.fusion_audio_threshold
                0x0000000000161ea4        0x4 ${package_root}\build\out\work\application\build\software\16.o
                0x0000000000161ea4                fusion_audio_threshold
 .data.filling  0x0000000000161ea8        0x4 ${package_root}\build\out\work\application\build\software\26.o
 .data.settings
                0x0000000000161eac       0x14 ${package_root}\build\out\work\application\build\software\29.o
 .data.revision
                0x0000000000161ec0        0x4 ${package_root}\build\out\work\application\build\software\30.o
 .data.preview_fps
                0x0000000000161ec4        0x4 ${package_root}\build\out\work\application\build\software\30.o
 .data.board_network_preview
                0x0000000000161ec8        0x4 ${package_root}\build\out\work\application\build\software\33.o
                0x0000000000161ec8                board_network_preview
 .data.pending  0x0000000000161ecc        0x4 ${package_root}\build\out\work\application\build\software\34.o
 .data.roi      0x0000000000161ed0       0x10 ${package_root}\build\out\work\application\build\software\34.o
 *(.gnu.linkonce.d.*)
 *(.jcr)
 *(.got)
 *(.got.plt)
                0x0000000000161ee0                __data_end = .

.tm_clone_table
                0x0000000000161ee0        0x0
 .tm_clone_table
                0x0000000000161ee0        0x0 ${vitis_install}/gnu/aarch32/nt/gcc-arm-none-eabi/bin//../aarch32-xilinx-eabi/usr/lib/thumb/v7-a+fp/hard/crtbegin.o
 .tm_clone_table
                0x0000000000161ee0        0x0 ${vitis_install}/gnu/aarch32/nt/gcc-arm-none-eabi/bin//../aarch32-xilinx-eabi/usr/lib/thumb/v7-a+fp/hard/crtend.o

.igot.plt       0x0000000000161ee0        0x0
 .igot.plt      0x0000000000161ee0        0x0 ${vitis_install}/gnu/aarch32/nt/gcc-arm-none-eabi/bin//../aarch32-xilinx-eabi/usr/lib/thumb/v7-a+fp/hard/crtbegin.o

.data1          0x0000000000161ee0        0x0
                0x0000000000161ee0                __data1_start = .
 *(.data1)
 *(.data1.*)
                0x0000000000161ee0                __data1_end = .

.got
 *(.got)

.ctors          0x0000000000161ee0        0x0
                0x0000000000161ee0                __CTOR_LIST__ = .
                0x0000000000161ee0                ___CTORS_LIST___ = .
 *crtbegin.o(.ctors)
 *(EXCLUDE_FILE(*crtend.o) .ctors)
 *(SORT_BY_NAME(.ctors.*))
 *(.ctors)
                0x0000000000161ee0                __CTOR_END__ = .
                0x0000000000161ee0                ___CTORS_END___ = .

.dtors          0x0000000000161ee0        0x0
                0x0000000000161ee0                __DTOR_LIST__ = .
                0x0000000000161ee0                ___DTORS_LIST___ = .
 *crtbegin.o(.dtors)
 *(EXCLUDE_FILE(*crtend.o) .dtors)
 *(SORT_BY_NAME(.dtors.*))
 *(.dtors)
                0x0000000000161ee0                __DTOR_END__ = .
                0x0000000000161ee0                ___DTORS_END___ = .

.fixup          0x0000000000161ee0        0x0
                0x0000000000161ee0                __fixup_start = .
 *(.fixup)
                0x0000000000161ee0                __fixup_end = .

.eh_frame       0x0000000000161ee0        0x0
 *(.eh_frame)
 .eh_frame      0x0000000000161ee0        0x0 ${vitis_install}/gnu/aarch32/nt/gcc-arm-none-eabi/bin//../aarch32-xilinx-eabi/usr/lib/thumb/v7-a+fp/hard/crtbegin.o

.eh_framehdr    0x0000000000161ee0        0x0
                0x0000000000161ee0                __eh_framehdr_start = .
 *(.eh_framehdr)
                0x0000000000161ee0                __eh_framehdr_end = .

.gcc_except_table
 *(.gcc_except_table)

.mmu_tbl        0x0000000000164000     0x4000
                0x0000000000164000                __mmu_tbl_start = .
 *(.mmu_tbl)
 .mmu_tbl       0x0000000000164000     0x4000 ${package_root}\build\out\work\platform\bsp_core0\lib\libxil.a(translation_table.o)
                0x0000000000164000                MMUTable
                0x0000000000168000                __mmu_tbl_end = .

.ARM.exidx      0x0000000000168000        0x8
                0x0000000000168000                __exidx_start = .
 *(.ARM.exidx*)
 .ARM.exidx     0x0000000000168000        0x8 ${vitis_install}/gnu/aarch32/nt/gcc-arm-none-eabi/bin//../aarch32-xilinx-eabi/usr/lib/thumb/v7-a+fp/hard\libgcc.a(_udivmoddi4.o)
 *(.gnu.linkonce.armexidix.*.*)
                0x0000000000168008                __exidx_end = .

.rel.dyn        0x0000000000168008        0x0
 .rel.iplt      0x0000000000168008        0x0 ${vitis_install}/gnu/aarch32/nt/gcc-arm-none-eabi/bin//../aarch32-xilinx-eabi/usr/lib/thumb/v7-a+fp/hard/crtbegin.o

.preinit_array  0x0000000000168008        0x0
                0x0000000000168008                __preinit_array_start = .
 *(SORT_BY_NAME(.preinit_array.*))
 *(.preinit_array)
                0x0000000000168008                __preinit_array_end = .

.init_array     0x0000000000168008        0x4
                0x0000000000168008                __init_array_start = .
 *(SORT_BY_NAME(.init_array.*))
 *(.init_array)
 .init_array    0x0000000000168008        0x4 ${vitis_install}/gnu/aarch32/nt/gcc-arm-none-eabi/bin//../aarch32-xilinx-eabi/usr/lib/thumb/v7-a+fp/hard/crtbegin.o
                0x000000000016800c                __init_array_end = .

.fini_array     0x000000000016800c        0x4
                0x000000000016800c                __fini_array_start = .
 *(SORT_BY_NAME(.fini_array.*))
 *(.fini_array)
 .fini_array    0x000000000016800c        0x4 ${vitis_install}/gnu/aarch32/nt/gcc-arm-none-eabi/bin//../aarch32-xilinx-eabi/usr/lib/thumb/v7-a+fp/hard/crtbegin.o
                0x0000000000168010                __fini_array_end = .

.ARM.attributes
                0x0000000000168010       0x35
                0x0000000000168010                __ARM.attributes_start = .
 *(.ARM.attributes)
 .ARM.attributes
                0x0000000000168010       0x21 ${vitis_install}/gnu/aarch32/nt/gcc-arm-none-eabi/bin//../aarch32-xilinx-eabi/usr/lib/thumb/v7-a+fp/hard/crti.o
 .ARM.attributes
                0x0000000000168031       0x33 ${vitis_install}/gnu/aarch32/nt/gcc-arm-none-eabi/bin//../aarch32-xilinx-eabi/usr/lib/thumb/v7-a+fp/hard/crtbegin.o
 .ARM.attributes
                0x0000000000168064       0x37 ${package_root}\build\out\work\application\build\software\0.o
 .ARM.attributes
                0x000000000016809b       0x37 ${package_root}\build\out\work\application\build\software\1.o
 .ARM.attributes
                0x00000000001680d2       0x37 ${package_root}\build\out\work\application\build\software\2.o
 .ARM.attributes
                0x0000000000168109       0x37 ${package_root}\build\out\work\application\build\software\3.o
 .ARM.attributes
                0x0000000000168140       0x37 ${package_root}\build\out\work\application\build\software\4.o
 .ARM.attributes
                0x0000000000168177       0x37 ${package_root}\build\out\work\application\build\software\5.o
 .ARM.attributes
                0x00000000001681ae       0x37 ${package_root}\build\out\work\application\build\software\6.o
 .ARM.attributes
                0x00000000001681e5       0x37 ${package_root}\build\out\work\application\build\software\7.o
 .ARM.attributes
                0x000000000016821c       0x37 ${package_root}\build\out\work\application\build\software\8.o
 .ARM.attributes
                0x0000000000168253       0x37 ${package_root}\build\out\work\application\build\software\9.o
 .ARM.attributes
                0x000000000016828a       0x37 ${package_root}\build\out\work\application\build\software\10.o
 .ARM.attributes
                0x00000000001682c1       0x37 ${package_root}\build\out\work\application\build\software\11.o
 .ARM.attributes
                0x00000000001682f8       0x37 ${package_root}\build\out\work\application\build\software\12.o
 .ARM.attributes
                0x000000000016832f       0x37 ${package_root}\build\out\work\application\build\software\13.o
 .ARM.attributes
                0x0000000000168366       0x39 ${package_root}\build\out\work\application\build\software\15.o
 .ARM.attributes
                0x000000000016839f       0x37 ${package_root}\build\out\work\application\build\software\16.o
 .ARM.attributes
                0x00000000001683d6       0x37 ${package_root}\build\out\work\application\build\software\17.o
 .ARM.attributes
                0x000000000016840d       0x39 ${package_root}\build\out\work\application\build\software\18.o
 .ARM.attributes
                0x0000000000168446       0x37 ${package_root}\build\out\work\application\build\software\19.o
 .ARM.attributes
                0x000000000016847d       0x37 ${package_root}\build\out\work\application\build\software\20.o
 .ARM.attributes
                0x00000000001684b4       0x37 ${package_root}\build\out\work\application\build\software\21.o
 .ARM.attributes
                0x00000000001684eb       0x37 ${package_root}\build\out\work\application\build\software\22.o
 .ARM.attributes
                0x0000000000168522       0x37 ${package_root}\build\out\work\application\build\software\23.o
 .ARM.attributes
                0x0000000000168559       0x37 ${package_root}\build\out\work\application\build\software\24.o
 .ARM.attributes
                0x0000000000168590       0x37 ${package_root}\build\out\work\application\build\software\25.o
 .ARM.attributes
                0x00000000001685c7       0x37 ${package_root}\build\out\work\application\build\software\26.o
 .ARM.attributes
                0x00000000001685fe       0x37 ${package_root}\build\out\work\application\build\software\27.o
 .ARM.attributes
                0x0000000000168635       0x37 ${package_root}\build\out\work\application\build\software\28.o
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
 .ARM.attributes
                0x000000000016925b       0x3d ${package_root}\build\out\work\platform\bsp_core0\lib\libxil.a(print.o)
 .ARM.attributes
                0x0000000000169298       0x29 ${package_root}\build\out\work\platform\bsp_core0\lib\libxil.a(translation_table.o)
 .ARM.attributes
                0x00000000001692c1       0x3d ${package_root}\build\out\work\platform\bsp_core0\lib\libxil.a(vectors.o)
 .ARM.attributes
                0x00000000001692fe       0x29 ${package_root}\build\out\work\platform\bsp_core0\lib\libxil.a(xil-crt0.o)
 .ARM.attributes
                0x0000000000169327       0x3d ${package_root}\build\out\work\platform\bsp_core0\lib\libxil.a(xil_assert.o)
 .ARM.attributes
                0x0000000000169364       0x3d ${package_root}\build\out\work\platform\bsp_core0\lib\libxil.a(xil_cache.o)
 .ARM.attributes
                0x00000000001693a1       0x3d ${package_root}\build\out\work\platform\bsp_core0\lib\libxil.a(xil_exception.o)
 .ARM.attributes
                0x00000000001693de       0x3d ${package_root}\build\out\work\platform\bsp_core0\lib\libxil.a(xil_mmu.o)
 .ARM.attributes
                0x000000000016941b       0x3d ${package_root}\build\out\work\platform\bsp_core0\lib\libxil.a(xil_sleepcommon.o)
 .ARM.attributes
                0x0000000000169458       0x3d ${package_root}\build\out\work\platform\bsp_core0\lib\libxil.a(xtime_l.o)
 .ARM.attributes
                0x0000000000169495       0x3d ${package_root}\build\out\work\platform\bsp_core0\lib\libxil.a(xuartps_hw.o)
 .ARM.attributes
                0x00000000001694d2       0x3d ${package_root}\build\out\work\platform\bsp_core0\lib\libxil.a(xaxidma_g.o)
 .ARM.attributes
                0x000000000016950f       0x3d ${package_root}\build\out\work\platform\bsp_core0\lib\libxil.a(xaxivdma_g.o)
 .ARM.attributes
                0x000000000016954c       0x3d ${package_root}\build\out\work\platform\bsp_core0\lib\libxil.a(xgpio_g.o)
 .ARM.attributes
                0x0000000000169589       0x29 ${package_root}\build\out\work\platform\bsp_core0\lib\libxil.a(cpu_init.o)
 .ARM.attributes
                0x00000000001695b2       0x3d ${package_root}\build\out\work\platform\bsp_core0\lib\libxil.a(sleep.o)
 .ARM.attributes
                0x00000000001695ef       0x3d ${package_root}\build\out\work\platform\bsp_core0\lib\libxil.a(usleep.o)
 .ARM.attributes
                0x000000000016962c       0x33 ${vitis_install}/gnu/aarch32/nt/gcc-arm-none-eabi/bin//../aarch32-xilinx-eabi/usr/lib/thumb/v7-a+fp/hard\libm.a(lib_a-sf_ceil.o)
 .ARM.attributes
                0x000000000016965f       0x33 ${vitis_install}/gnu/aarch32/nt/gcc-arm-none-eabi/bin//../aarch32-xilinx-eabi/usr/lib/thumb/v7-a+fp/hard\libm.a(lib_a-sf_exp.o)
 .ARM.attributes
                0x0000000000169692       0x33 ${vitis_install}/gnu/aarch32/nt/gcc-arm-none-eabi/bin//../aarch32-xilinx-eabi/usr/lib/thumb/v7-a+fp/hard\libm.a(lib_a-sf_floor.o)
 .ARM.attributes
                0x00000000001696c5       0x33 ${vitis_install}/gnu/aarch32/nt/gcc-arm-none-eabi/bin//../aarch32-xilinx-eabi/usr/lib/thumb/v7-a+fp/hard\libm.a(lib_a-sf_fmax.o)
 .ARM.attributes
                0x00000000001696f8       0x33 ${vitis_install}/gnu/aarch32/nt/gcc-arm-none-eabi/bin//../aarch32-xilinx-eabi/usr/lib/thumb/v7-a+fp/hard\libm.a(lib_a-sf_fmin.o)
 .ARM.attributes
                0x000000000016972b       0x33 ${vitis_install}/gnu/aarch32/nt/gcc-arm-none-eabi/bin//../aarch32-xilinx-eabi/usr/lib/thumb/v7-a+fp/hard\libm.a(lib_a-sf_fpclassify.o)
 .ARM.attributes
                0x000000000016975e       0x33 ${vitis_install}/gnu/aarch32/nt/gcc-arm-none-eabi/bin//../aarch32-xilinx-eabi/usr/lib/thumb/v7-a+fp/hard\libm.a(lib_a-sf_round.o)
 .ARM.attributes
                0x0000000000169791       0x33 ${vitis_install}/gnu/aarch32/nt/gcc-arm-none-eabi/bin//../aarch32-xilinx-eabi/usr/lib/thumb/v7-a+fp/hard\libm.a(lib_a-wf_sqrt.o)
 .ARM.attributes
                0x00000000001697c4       0x33 ${vitis_install}/gnu/aarch32/nt/gcc-arm-none-eabi/bin//../aarch32-xilinx-eabi/usr/lib/thumb/v7-a+fp/hard\libm.a(lib_a-ef_sqrt.o)
 .ARM.attributes
                0x00000000001697f7       0x33 ${vitis_install}/gnu/aarch32/nt/gcc-arm-none-eabi/bin//../aarch32-xilinx-eabi/usr/lib/thumb/v7-a+fp/hard\libm.a(lib_a-math_errf.o)
 .ARM.attributes
                0x000000000016982a       0x33 ${vitis_install}/gnu/aarch32/nt/gcc-arm-none-eabi/bin//../aarch32-xilinx-eabi/usr/lib/thumb/v7-a+fp/hard\libm.a(lib_a-sf_exp2_data.o)
 .ARM.attributes
                0x000000000016985d       0x21 ${vitis_install}/gnu/aarch32/nt/gcc-arm-none-eabi/bin//../aarch32-xilinx-eabi/usr/lib/thumb/v7-a+fp/hard\libgcc.a(_udivsi3.o)
 .ARM.attributes
                0x000000000016987e       0x21 ${vitis_install}/gnu/aarch32/nt/gcc-arm-none-eabi/bin//../aarch32-xilinx-eabi/usr/lib/thumb/v7-a+fp/hard\libgcc.a(_divsi3.o)
 .ARM.attributes
                0x000000000016989f       0x21 ${vitis_install}/gnu/aarch32/nt/gcc-arm-none-eabi/bin//../aarch32-xilinx-eabi/usr/lib/thumb/v7-a+fp/hard\libgcc.a(_dvmd_tls.o)
 .ARM.attributes
                0x00000000001698c0       0x21 ${vitis_install}/gnu/aarch32/nt/gcc-arm-none-eabi/bin//../aarch32-xilinx-eabi/usr/lib/thumb/v7-a+fp/hard\libgcc.a(_arm_addsubsf3.o)
 .ARM.attributes
                0x00000000001698e1       0x21 ${vitis_install}/gnu/aarch32/nt/gcc-arm-none-eabi/bin//../aarch32-xilinx-eabi/usr/lib/thumb/v7-a+fp/hard\libgcc.a(_aeabi_ldivmod.o)
 .ARM.attributes
                0x0000000000169902       0x21 ${vitis_install}/gnu/aarch32/nt/gcc-arm-none-eabi/bin//../aarch32-xilinx-eabi/usr/lib/thumb/v7-a+fp/hard\libgcc.a(_aeabi_uldivmod.o)
 .ARM.attributes
                0x0000000000169923       0x33 ${vitis_install}/gnu/aarch32/nt/gcc-arm-none-eabi/bin//../aarch32-xilinx-eabi/usr/lib/thumb/v7-a+fp/hard\libgcc.a(_udivmoddi4.o)
 .ARM.attributes
                0x0000000000169956       0x33 ${vitis_install}/gnu/aarch32/nt/gcc-arm-none-eabi/bin//../aarch32-xilinx-eabi/usr/lib/thumb/v7-a+fp/hard\libc.a(lib_a-ctype_.o)
 .ARM.attributes
                0x0000000000169989       0x33 ${vitis_install}/gnu/aarch32/nt/gcc-arm-none-eabi/bin//../aarch32-xilinx-eabi/usr/lib/thumb/v7-a+fp/hard\libc.a(lib_a-errno.o)
 .ARM.attributes
                0x00000000001699bc       0x33 ${vitis_install}/gnu/aarch32/nt/gcc-arm-none-eabi/bin//../aarch32-xilinx-eabi/usr/lib/thumb/v7-a+fp/hard\libc.a(lib_a-exit.o)
 .ARM.attributes
                0x00000000001699ef       0x33 ${vitis_install}/gnu/aarch32/nt/gcc-arm-none-eabi/bin//../aarch32-xilinx-eabi/usr/lib/thumb/v7-a+fp/hard\libc.a(lib_a-fini.o)
 .ARM.attributes
                0x0000000000169a22       0x33 ${vitis_install}/gnu/aarch32/nt/gcc-arm-none-eabi/bin//../aarch32-xilinx-eabi/usr/lib/thumb/v7-a+fp/hard\libc.a(lib_a-impure.o)
 .ARM.attributes
                0x0000000000169a55       0x33 ${vitis_install}/gnu/aarch32/nt/gcc-arm-none-eabi/bin//../aarch32-xilinx-eabi/usr/lib/thumb/v7-a+fp/hard\libc.a(lib_a-init.o)
 .ARM.attributes
                0x0000000000169a88       0x33 ${vitis_install}/gnu/aarch32/nt/gcc-arm-none-eabi/bin//../aarch32-xilinx-eabi/usr/lib/thumb/v7-a+fp/hard\libc.a(lib_a-malloc.o)
 .ARM.attributes
                0x0000000000169abb       0x33 ${vitis_install}/gnu/aarch32/nt/gcc-arm-none-eabi/bin//../aarch32-xilinx-eabi/usr/lib/thumb/v7-a+fp/hard\libc.a(lib_a-mallocr.o)
 .ARM.attributes
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
 .ARM.attributes
                0x000000000016a1ef       0x33 ${vitis_install}/gnu/aarch32/nt/gcc-arm-none-eabi/bin//../aarch32-xilinx-eabi/usr/lib/thumb/v7-a+fp/hard\libc.a(lib_a-fflush.o)
 .ARM.attributes
                0x000000000016a222       0x33 ${vitis_install}/gnu/aarch32/nt/gcc-arm-none-eabi/bin//../aarch32-xilinx-eabi/usr/lib/thumb/v7-a+fp/hard\libc.a(lib_a-fiprintf.o)
 .ARM.attributes
                0x000000000016a255       0x33 ${vitis_install}/gnu/aarch32/nt/gcc-arm-none-eabi/bin//../aarch32-xilinx-eabi/usr/lib/thumb/v7-a+fp/hard\libc.a(lib_a-lseekr.o)
 .ARM.attributes
                0x000000000016a288       0x33 ${vitis_install}/gnu/aarch32/nt/gcc-arm-none-eabi/bin//../aarch32-xilinx-eabi/usr/lib/thumb/v7-a+fp/hard\libc.a(lib_a-makebuf.o)
 .ARM.attributes
                0x000000000016a2bb       0x33 ${vitis_install}/gnu/aarch32/nt/gcc-arm-none-eabi/bin//../aarch32-xilinx-eabi/usr/lib/thumb/v7-a+fp/hard\libc.a(lib_a-readr.o)
 .ARM.attributes
                0x000000000016a2ee       0x33 ${vitis_install}/gnu/aarch32/nt/gcc-arm-none-eabi/bin//../aarch32-xilinx-eabi/usr/lib/thumb/v7-a+fp/hard\libc.a(lib_a-vfiprintf.o)
 .ARM.attributes
                0x000000000016a321       0x33 ${vitis_install}/gnu/aarch32/nt/gcc-arm-none-eabi/bin//../aarch32-xilinx-eabi/usr/lib/thumb/v7-a+fp/hard\libc.a(lib_a-abort.o)
 .ARM.attributes
                0x000000000016a354       0x33 ${vitis_install}/gnu/aarch32/nt/gcc-arm-none-eabi/bin//../aarch32-xilinx-eabi/usr/lib/thumb/v7-a+fp/hard\libc.a(lib_a-fputwc.o)
 .ARM.attributes
                0x000000000016a387       0x33 ${vitis_install}/gnu/aarch32/nt/gcc-arm-none-eabi/bin//../aarch32-xilinx-eabi/usr/lib/thumb/v7-a+fp/hard\libc.a(lib_a-fstatr.o)
 .ARM.attributes
                0x000000000016a3ba       0x33 ${vitis_install}/gnu/aarch32/nt/gcc-arm-none-eabi/bin//../aarch32-xilinx-eabi/usr/lib/thumb/v7-a+fp/hard\libc.a(lib_a-isattyr.o)
 .ARM.attributes
                0x000000000016a3ed       0x33 ${vitis_install}/gnu/aarch32/nt/gcc-arm-none-eabi/bin//../aarch32-xilinx-eabi/usr/lib/thumb/v7-a+fp/hard\libc.a(lib_a-signal.o)
 .ARM.attributes
                0x000000000016a420       0x33 ${vitis_install}/gnu/aarch32/nt/gcc-arm-none-eabi/bin//../aarch32-xilinx-eabi/usr/lib/thumb/v7-a+fp/hard\libc.a(lib_a-signalr.o)
 .ARM.attributes
                0x000000000016a453       0x33 ${vitis_install}/gnu/aarch32/nt/gcc-arm-none-eabi/bin//../aarch32-xilinx-eabi/usr/lib/thumb/v7-a+fp/hard\libc.a(lib_a-wbuf.o)
 .ARM.attributes
                0x000000000016a486       0x33 ${vitis_install}/gnu/aarch32/nt/gcc-arm-none-eabi/bin//../aarch32-xilinx-eabi/usr/lib/thumb/v7-a+fp/hard\libc.a(lib_a-wcrtomb.o)
 .ARM.attributes
                0x000000000016a4b9       0x3d ${package_root}\build\out\work\platform\bsp_core0\lib\libxil.a(_exit.o)
 .ARM.attributes
                0x000000000016a4f6       0x3d ${package_root}\build\out\work\platform\bsp_core0\lib\libxil.a(_sbrk.o)
 .ARM.attributes
                0x000000000016a533       0x3d ${package_root}\build\out\work\platform\bsp_core0\lib\libxil.a(close.o)
 .ARM.attributes
                0x000000000016a570       0x3d ${package_root}\build\out\work\platform\bsp_core0\lib\libxil.a(fstat.o)
 .ARM.attributes
                0x000000000016a5ad       0x3d ${package_root}\build\out\work\platform\bsp_core0\lib\libxil.a(getpid.o)
 .ARM.attributes
                0x000000000016a5ea       0x3d ${package_root}\build\out\work\platform\bsp_core0\lib\libxil.a(isatty.o)
 .ARM.attributes
                0x000000000016a627       0x3d ${package_root}\build\out\work\platform\bsp_core0\lib\libxil.a(kill.o)
 .ARM.attributes
                0x000000000016a664       0x3d ${package_root}\build\out\work\platform\bsp_core0\lib\libxil.a(lseek.o)
 .ARM.attributes
                0x000000000016a6a1       0x3d ${package_root}\build\out\work\platform\bsp_core0\lib\libxil.a(read.o)
 .ARM.attributes
                0x000000000016a6de       0x3d ${package_root}\build\out\work\platform\bsp_core0\lib\libxil.a(write.o)
 .ARM.attributes
                0x000000000016a71b       0x3d ${package_root}\build\out\work\platform\bsp_core0\lib\libxil.a(inbyte.o)
 .ARM.attributes
                0x000000000016a758       0x33 ${vitis_install}/gnu/aarch32/nt/gcc-arm-none-eabi/bin//../aarch32-xilinx-eabi/usr/lib/thumb/v7-a+fp/hard/crtend.o
 .ARM.attributes
                0x000000000016a78b       0x21 ${vitis_install}/gnu/aarch32/nt/gcc-arm-none-eabi/bin//../aarch32-xilinx-eabi/usr/lib/thumb/v7-a+fp/hard/crtn.o
                0x000000000016a7ac                __ARM.attributes_end = .

.sdata          0x0000000000168010        0x0
                0x0000000000168010                __sdata_start = .
 *(.sdata)
 *(.sdata.*)
 *(.gnu.linkonce.s.*)
                0x0000000000168010                __sdata_end = .

.sbss           0x0000000000168010        0x0
                0x0000000000168010                __sbss_start = .
 *(.sbss)
 *(.sbss.*)
 *(.gnu.linkonce.sb.*)
                0x0000000000168010                __sbss_end = .

.tdata          0x0000000000168010        0x0
                0x0000000000168010                __tdata_start = .
 *(.tdata)
 *(.tdata.*)
 *(.gnu.linkonce.td.*)
                0x0000000000168010                __tdata_end = .

.tbss           0x0000000000168010        0x0
                0x0000000000168010                __tbss_start = .
 *(.tbss)
 *(.tbss.*)
 *(.gnu.linkonce.tb.*)
                0x0000000000168010                __tbss_end = .

.bss            0x0000000000200000   0x608040
                0x0000000000200000                __bss_start = .
 *(.bss)
 .bss           0x0000000000200000       0x1c ${vitis_install}/gnu/aarch32/nt/gcc-arm-none-eabi/bin//../aarch32-xilinx-eabi/usr/lib/thumb/v7-a+fp/hard/crtbegin.o
 .bss           0x000000000020001c       0xf1 ${package_root}\build\out\work\platform\bsp_core0\lib\liblwip4.a(etharp.o)
 *fill*         0x000000000020010d        0x1 
 .bss           0x000000000020010e        0x2 ${package_root}\build\out\work\platform\bsp_core0\lib\liblwip4.a(ip4.o)
 .bss           0x0000000000200110       0x10 ${package_root}\build\out\work\platform\bsp_core0\lib\liblwip4.a(ip4_addr.o)
 .bss           0x0000000000200120        0x6 ${package_root}\build\out\work\platform\bsp_core0\lib\liblwip4.a(ip4_frag.o)
 *fill*         0x0000000000200126        0x2 
 .bss           0x0000000000200128       0xd8 ${package_root}\build\out\work\platform\bsp_core0\lib\liblwip4.a(memp.o)
 .bss           0x0000000000200200        0x1 ${package_root}\build\out\work\platform\bsp_core0\lib\liblwip4.a(netif.o)
 .bss           0x0000000000200201        0x2 ${package_root}\build\out\work\platform\bsp_core0\lib\liblwip4.a(tcp.o)
 *fill*         0x0000000000200203        0x1 
 .bss           0x0000000000200204       0x36 ${package_root}\build\out\work\platform\bsp_core0\lib\liblwip4.a(tcp_in.o)
 *fill*         0x000000000020023a        0x2 
 .bss           0x000000000020023c        0x8 ${package_root}\build\out\work\platform\bsp_core0\lib\liblwip4.a(xadapter.o)
                0x000000000020023c                eth_link_status
                0x0000000000200240                lwip_runtime_debug
 .bss           0x0000000000200244      0x80c ${package_root}\build\out\work\platform\bsp_core0\lib\liblwip4.a(xemacpsif_dma.o)
 .bss           0x0000000000200a50        0x4 ${package_root}\build\out\work\platform\bsp_core0\lib\liblwip4.a(xpqueue.o)
 .bss           0x0000000000200a54        0x4 ${package_root}\build\out\work\platform\bsp_core0\lib\libxil.a(xscugic.o)
 .bss           0x0000000000200a58        0x4 ${package_root}\build\out\work\platform\bsp_core0\lib\libxil.a(xil_assert.o)
 .bss           0x0000000000200a5c       0x34 ${vitis_install}/gnu/aarch32/nt/gcc-arm-none-eabi/bin//../aarch32-xilinx-eabi/usr/lib/thumb/v7-a+fp/hard\libc.a(lib_a-mallocr.o)
                0x0000000000200a5c                __malloc_top_pad
                0x0000000000200a60                __malloc_current_mallinfo
                0x0000000000200a88                __malloc_max_sbrked_mem
                0x0000000000200a8c                __malloc_max_total_mem
 .bss           0x0000000000200a90        0x4 ${vitis_install}/gnu/aarch32/nt/gcc-arm-none-eabi/bin//../aarch32-xilinx-eabi/usr/lib/thumb/v7-a+fp/hard\libc.a(lib_a-reent.o)
                0x0000000000200a90                errno
 .bss           0x0000000000200a94        0x4 ${package_root}\build\out\work\platform\bsp_core0\lib\libxil.a(_sbrk.o)
 *(.bss.*)
 .bss.rgb_tables_ready
                0x0000000000200a98        0x4 ${package_root}\build\out\work\application\build\software\0.o
 .bss.quantized_rgb
                0x0000000000200a9c      0x300 ${package_root}\build\out\work\application\build\software\0.o
 .bss.normalized_rgb
                0x0000000000200d9c      0xc00 ${package_root}\build\out\work\application\build\software\0.o
 .bss.busy      0x000000000020199c        0x4 ${package_root}\build\out\work\application\build\software\1.o
 .bss.initialized
                0x00000000002019a0        0x4 ${package_root}\build\out\work\application\build\software\1.o
 .bss.ssd_pl_stats
                0x00000000002019a4       0x1c ${package_root}\build\out\work\application\build\software\1.o
                0x00000000002019a4                ssd_pl_stats
 .bss.crop      0x00000000002019c0       0x10 ${package_root}\build\out\work\application\build\software\4.o
 .bss.focused   0x00000000002019d0       0x10 ${package_root}\build\out\work\application\build\software\4.o
 .bss.target    0x00000000002019e0       0x10 ${package_root}\build\out\work\application\build\software\4.o
 .bss.previous  0x00000000002019f0       0x10 ${package_root}\build\out\work\application\build\software\4.o
 .bss.last_attempt
                0x0000000000201a00        0x8 ${package_root}\build\out\work\application\build\software\4.o
 .bss.poll_seen
                0x0000000000201a08        0x8 ${package_root}\build\out\work\application\build\software\4.o
 .bss.last_observed
                0x0000000000201a10        0x8 ${package_root}\build\out\work\application\build\software\4.o
 .bss.last_seen
                0x0000000000201a18        0x8 ${package_root}\build\out\work\application\build\software\4.o
 .bss.deadline  0x0000000000201a20        0x8 ${package_root}\build\out\work\application\build\software\4.o
 .bss.next_poll
                0x0000000000201a28        0x8 ${package_root}\build\out\work\application\build\software\4.o
 .bss.score_q15
                0x0000000000201a30        0x4 ${package_root}\build\out\work\application\build\software\4.o
 .bss.seq       0x0000000000201a34        0x4 ${package_root}\build\out\work\application\build\software\4.o
 .bss.error     0x0000000000201a38        0x4 ${package_root}\build\out\work\application\build\software\4.o
 .bss.result_flag
                0x0000000000201a3c        0x1 ${package_root}\build\out\work\application\build\software\4.o
 .bss.center_y  0x0000000000201a3d        0x1 ${package_root}\build\out\work\application\build\software\4.o
 .bss.center_x  0x0000000000201a3e        0x1 ${package_root}\build\out\work\application\build\software\4.o
 .bss.reset_reg
                0x0000000000201a3f        0x1 ${package_root}\build\out\work\application\build\software\4.o
 .bss.bird_focus_diag
                0x0000000000201a40       0x20 ${package_root}\build\out\work\application\build\software\4.o
                0x0000000000201a40                bird_focus_diag
 .bss.recovery_user_manual
                0x0000000000201a60        0x4 ${package_root}\build\out\work\application\build\software\4.o
 .bss.recovery_target
                0x0000000000201a64        0x4 ${package_root}\build\out\work\application\build\software\4.o
 .bss.recovery_restore
                0x0000000000201a68        0x4 ${package_root}\build\out\work\application\build\software\4.o
 .bss.recovery_wait
                0x0000000000201a6c        0x4 ${package_root}\build\out\work\application\build\software\4.o
 .bss.recovery_reset_seen
                0x0000000000201a70        0x4 ${package_root}\build\out\work\application\build\software\4.o
 .bss.recovery_seen
                0x0000000000201a74        0x4 ${package_root}\build\out\work\application\build\software\4.o
 .bss.active_center
                0x0000000000201a78        0x4 ${package_root}\build\out\work\application\build\software\4.o
 .bss.center_pending
                0x0000000000201a7c        0x4 ${package_root}\build\out\work\application\build\software\4.o
 .bss.target_attempts
                0x0000000000201a80        0x4 ${package_root}\build\out\work\application\build\software\4.o
 .bss.firmware_ready
                0x0000000000201a84        0x4 ${package_root}\build\out\work\application\build\software\4.o
 .bss.io_retries
                0x0000000000201a88        0x4 ${package_root}\build\out\work\application\build\software\4.o
 .bss.successes
                0x0000000000201a8c        0x4 ${package_root}\build\out\work\application\build\software\4.o
 .bss.requests  0x0000000000201a90        0x4 ${package_root}\build\out\work\application\build\software\4.o
 .bss.pending   0x0000000000201a94        0x4 ${package_root}\build\out\work\application\build\software\4.o
 .bss.zoom      0x0000000000201a98        0x4 ${package_root}\build\out\work\application\build\software\4.o
 .bss.misses    0x0000000000201a9c        0x4 ${package_root}\build\out\work\application\build\software\4.o
 .bss.hits      0x0000000000201aa0        0x4 ${package_root}\build\out\work\application\build\software\4.o
 .bss.camera_available
                0x0000000000201aa4        0x4 ${package_root}\build\out\work\application\build\software\4.o
 .bss.index_    0x0000000000201aa8        0x4 ${package_root}\build\out\work\application\build\software\4.o
 .bss.step      0x0000000000201aac        0x4 ${package_root}\build\out\work\application\build\software\4.o
 .bss.state     0x0000000000201ab0        0x4 ${package_root}\build\out\work\application\build\software\4.o
 .bss.enabled   0x0000000000201ab4        0x4 ${package_root}\build\out\work\application\build\software\4.o
 .bss.manual_mcu
                0x0000000000201ab8        0x1 ${package_root}\build\out\work\application\build\software\4.o
 .bss.manual_verify_hi
                0x0000000000201ab9        0x1 ${package_root}\build\out\work\application\build\software\4.o
 .bss.manual_lo
                0x0000000000201aba        0x1 ${package_root}\build\out\work\application\build\software\4.o
 .bss.manual_hi
                0x0000000000201abb        0x1 ${package_root}\build\out\work\application\build\software\4.o
 .bss.contrast_stop
                0x0000000000201abc        0x4 ${package_root}\build\out\work\application\build\software\4.o
 .bss.contrast_mode
                0x0000000000201ac0        0x4 ${package_root}\build\out\work\application\build\software\4.o
 .bss.manual_sequence
                0x0000000000201ac4        0x4 ${package_root}\build\out\work\application\build\software\4.o
 .bss.manual_next
                0x0000000000201ac8        0x4 ${package_root}\build\out\work\application\build\software\4.o
 .bss.manual_current
                0x0000000000201acc        0x4 ${package_root}\build\out\work\application\build\software\4.o
 .bss.manual_target
                0x0000000000201ad0        0x4 ${package_root}\build\out\work\application\build\software\4.o
 .bss.manual_mode
                0x0000000000201ad4        0x4 ${package_root}\build\out\work\application\build\software\4.o
 .bss.network_preview_profile
                0x0000000000201ad8       0x20 ${package_root}\build\out\work\application\build\software\6.o
                0x0000000000201ad8                network_preview_profile
 .bss.preview_have_admit
                0x0000000000201af8        0x4 ${package_root}\build\out\work\application\build\software\6.o
 .bss.preview_have_clock
                0x0000000000201afc        0x4 ${package_root}\build\out\work\application\build\software\6.o
 .bss.preview_last_admit
                0x0000000000201b00        0x8 ${package_root}\build\out\work\application\build\software\6.o
 .bss.preview_last_clock
                0x0000000000201b08        0x8 ${package_root}\build\out\work\application\build\software\6.o
 .bss.vh_suspended_state
                0x0000000000201b10        0x4 ${package_root}\build\out\work\application\build\software\6.o
 .bss.vh_diag_was_active
                0x0000000000201b14        0x4 ${package_root}\build\out\work\application\build\software\6.o
 .bss.vh_fault_latched
                0x0000000000201b18        0x4 ${package_root}\build\out\work\application\build\software\6.o
 .bss.vh_sensor_wait
                0x0000000000201b1c        0x4 ${package_root}\build\out\work\application\build\software\6.o
 .bss.vh_attempts
                0x0000000000201b20        0x4 ${package_root}\build\out\work\application\build\software\6.o
 .bss.vh_have_copy
                0x0000000000201b24        0x4 ${package_root}\build\out\work\application\build\software\6.o
 .bss.vh_have_capture
                0x0000000000201b28        0x4 ${package_root}\build\out\work\application\build\software\6.o
 .bss.vh_have_source
                0x0000000000201b2c        0x4 ${package_root}\build\out\work\application\build\software\6.o
 .bss.vh_sensor_reset_generation
                0x0000000000201b30        0x4 ${package_root}\build\out\work\application\build\software\6.o
 .bss.vh_dma_mask
                0x0000000000201b34        0x4 ${package_root}\build\out\work\application\build\software\6.o
 .bss.vh_clean  0x0000000000201b38        0x4 ${package_root}\build\out\work\application\build\software\6.o
 .bss.vh_capture_store
                0x0000000000201b3c        0x4 ${package_root}\build\out\work\application\build\software\6.o
 .bss.vh_source_count
                0x0000000000201b40        0x4 ${package_root}\build\out\work\application\build\software\6.o
 *fill*         0x0000000000201b44        0x4 
 .bss.vh_last_copy_restart
                0x0000000000201b48        0x8 ${package_root}\build\out\work\application\build\software\6.o
 .bss.vh_state_at
                0x0000000000201b50        0x8 ${package_root}\build\out\work\application\build\software\6.o
 .bss.vh_deadline
                0x0000000000201b58        0x8 ${package_root}\build\out\work\application\build\software\6.o
 .bss.vh_started
                0x0000000000201b60        0x8 ${package_root}\build\out\work\application\build\software\6.o
 .bss.vh_copy_at
                0x0000000000201b68        0x8 ${package_root}\build\out\work\application\build\software\6.o
 .bss.vh_capture_at
                0x0000000000201b70        0x8 ${package_root}\build\out\work\application\build\software\6.o
 .bss.vh_source_at
                0x0000000000201b78        0x8 ${package_root}\build\out\work\application\build\software\6.o
 .bss.vh_now    0x0000000000201b80        0x8 ${package_root}\build\out\work\application\build\software\6.o
 .bss.vh_boot   0x0000000000201b88        0x8 ${package_root}\build\out\work\application\build\software\6.o
 .bss.vh_words  0x0000000000201b90       0x80 ${package_root}\build\out\work\application\build\software\6.o
 .bss.video_last_error_status
                0x0000000000201c10        0x4 ${package_root}\build\out\work\application\build\software\6.o
                0x0000000000201c10                video_last_error_status
 .bss.video_framing_recoveries
                0x0000000000201c14        0x4 ${package_root}\build\out\work\application\build\software\6.o
                0x0000000000201c14                video_framing_recoveries
 .bss.video_quarantine
                0x0000000000201c18        0x1 ${package_root}\build\out\work\application\build\software\6.o
 *fill*         0x0000000000201c19        0x3 
 .bss.video_enhanced_frames
                0x0000000000201c1c        0x4 ${package_root}\build\out\work\application\build\software\6.o
                0x0000000000201c1c                video_enhanced_frames
 .bss.video_raw_frames
                0x0000000000201c20        0x4 ${package_root}\build\out\work\application\build\software\6.o
                0x0000000000201c20                video_raw_frames
 .bss.video_last_gain_q8
                0x0000000000201c24        0x4 ${package_root}\build\out\work\application\build\software\6.o
                0x0000000000201c24                video_last_gain_q8
 .bss.video_last_mean_y
                0x0000000000201c28        0x4 ${package_root}\build\out\work\application\build\software\6.o
                0x0000000000201c28                video_last_mean_y
 .bss.fusion_copy_active
                0x0000000000201c2c        0x4 ${package_root}\build\out\work\application\build\software\6.o
 .bss.video_copy_active
                0x0000000000201c30        0x4 ${package_root}\build\out\work\application\build\software\6.o
 .bss.video_copy_target
                0x0000000000201c34        0x1 ${package_root}\build\out\work\application\build\software\6.o
 .bss.video_copy_dma_index
                0x0000000000201c35        0x1 ${package_root}\build\out\work\application\build\software\6.o
 *fill*         0x0000000000201c36        0x2 
 .bss.video_copy_timestamp
                0x0000000000201c38        0x8 ${package_root}\build\out\work\application\build\software\6.o
 .bss.video_copy_frame_id
                0x0000000000201c40        0x4 ${package_root}\build\out\work\application\build\software\6.o
 .bss.video_copy_offset
                0x0000000000201c44        0x4 ${package_root}\build\out\work\application\build\software\6.o
 .bss.audio_started_us
                0x0000000000201c48        0x8 ${package_root}\build\out\work\application\build\software\6.o
 .bss.audio_active
                0x0000000000201c50        0x4 ${package_root}\build\out\work\application\build\software\6.o
 .bss.last_video_store
                0x0000000000201c54        0x4 ${package_root}\build\out\work\application\build\software\6.o
 .bss.video_sequence
                0x0000000000201c58        0x4 ${package_root}\build\out\work\application\build\software\6.o
 *fill*         0x0000000000201c5c        0x4 
 .bss.audio_clock
                0x0000000000201c60       0x28 ${package_root}\build\out\work\application\build\software\6.o
 .bss.audio_sequence
                0x0000000000201c88        0x4 ${package_root}\build\out\work\application\build\software\6.o
 .bss.audio_slot
                0x0000000000201c8c        0x4 ${package_root}\build\out\work\application\build\software\6.o
 .bss.dma_boot_id
                0x0000000000201c90        0x4 ${package_root}\build\out\work\application\build\software\6.o
 .bss.audio_dma
                0x0000000000201c94      0x750 ${package_root}\build\out\work\application\build\software\6.o
 *fill*         0x00000000002023e4       0x1c 
 .bss.video_dma
                0x0000000000202400      0x980 ${package_root}\build\out\work\application\build\software\6.o
 .bss.camera_recovery_diag
                0x0000000000202d80       0x30 ${package_root}\build\out\work\application\build\software\8.o
                0x0000000000202d80                camera_recovery_diag
 .bss.recovery_started
                0x0000000000202db0        0x8 ${package_root}\build\out\work\application\build\software\8.o
 .bss.recovery_deadline
                0x0000000000202db8        0x8 ${package_root}\build\out\work\application\build\software\8.o
 .bss.recovery_next
                0x0000000000202dc0        0x8 ${package_root}\build\out\work\application\build\software\8.o
 .bss.recovery_last_poll
                0x0000000000202dc8        0x8 ${package_root}\build\out\work\application\build\software\8.o
 .bss.recovery_result
                0x0000000000202dd0        0x4 ${package_root}\build\out\work\application\build\software\8.o
 .bss.recovery_hard
                0x0000000000202dd4        0x4 ${package_root}\build\out\work\application\build\software\8.o
 .bss.recovery_vcm_next
                0x0000000000202dd8        0x4 ${package_root}\build\out\work\application\build\software\8.o
 .bss.recovery_vcm_current
                0x0000000000202ddc        0x4 ${package_root}\build\out\work\application\build\software\8.o
 .bss.recovery_vcm_verify
                0x0000000000202de0        0x1 ${package_root}\build\out\work\application\build\software\8.o
 .bss.recovery_vcm_lo
                0x0000000000202de1        0x1 ${package_root}\build\out\work\application\build\software\8.o
 .bss.recovery_vcm_hi
                0x0000000000202de2        0x1 ${package_root}\build\out\work\application\build\software\8.o
 .bss.recovery_mcu
                0x0000000000202de3        0x1 ${package_root}\build\out\work\application\build\software\8.o
 .bss.recovery_focus_lo
                0x0000000000202de4        0x1 ${package_root}\build\out\work\application\build\software\8.o
 .bss.recovery_focus_hi
                0x0000000000202de5        0x1 ${package_root}\build\out\work\application\build\software\8.o
 *fill*         0x0000000000202de6        0x2 
 .bss.recovery_focus_code
                0x0000000000202de8        0x4 ${package_root}\build\out\work\application\build\software\8.o
 .bss.recovery_focus_valid
                0x0000000000202dec        0x4 ${package_root}\build\out\work\application\build\software\8.o
 .bss.recovery_retries
                0x0000000000202df0        0x4 ${package_root}\build\out\work\application\build\software\8.o
 .bss.recovery_reset_generation
                0x0000000000202df4        0x4 ${package_root}\build\out\work\application\build\software\8.o
 .bss.recovery_generation
                0x0000000000202df8        0x4 ${package_root}\build\out\work\application\build\software\8.o
 .bss.recovery_attempts
                0x0000000000202dfc        0x4 ${package_root}\build\out\work\application\build\software\8.o
 .bss.recovery_index
                0x0000000000202e00        0x4 ${package_root}\build\out\work\application\build\software\8.o
 .bss.recovery_step
                0x0000000000202e04        0x4 ${package_root}\build\out\work\application\build\software\8.o
 .bss.gpio_direction
                0x0000000000202e08        0x4 ${package_root}\build\out\work\application\build\software\8.o
 .bss.gpio_output
                0x0000000000202e0c        0x4 ${package_root}\build\out\work\application\build\software\8.o
 .bss.camera_prepared
                0x0000000000202e10        0x4 ${package_root}\build\out\work\application\build\software\8.o
 .bss.camera_gpio
                0x0000000000202e14       0x10 ${package_root}\build\out\work\application\build\software\8.o
 *fill*         0x0000000000202e24        0x4 
 .bss.last_arp.0
                0x0000000000202e28        0x8 ${package_root}\build\out\work\application\build\software\9.o
 *fill*         0x0000000000202e30       0x10 
 .bss.network_tx_diag
                0x0000000000202e40       0x40 ${package_root}\build\out\work\application\build\software\9.o
                0x0000000000202e40                network_tx_diag
 .bss.control_state
                0x0000000000202e80       0xcc ${package_root}\build\out\work\application\build\software\9.o
 .bss.control_service
                0x0000000000202f4c        0x4 ${package_root}\build\out\work\application\build\software\9.o
 .bss.board_netif
                0x0000000000202f50       0x30 ${package_root}\build\out\work\application\build\software\9.o
 .bss.destination
                0x0000000000202f80        0x4 ${package_root}\build\out\work\application\build\software\9.o
 .bss.control_pcb
                0x0000000000202f84        0x4 ${package_root}\build\out\work\application\build\software\9.o
 .bss.tx_pcb    0x0000000000202f88        0x4 ${package_root}\build\out\work\application\build\software\9.o
 .bss.ff_cache  0x0000000000202f8c      0x3c0 ${package_root}\build\out\work\application\build\software\10.o
 .bss.ff_cache_next
                0x000000000020334c        0x4 ${package_root}\build\out\work\application\build\software\10.o
 .bss.ff_applies
                0x0000000000203350        0x4 ${package_root}\build\out\work\application\build\software\10.o
 .bss.ff_ack_status
                0x0000000000203354        0x4 ${package_root}\build\out\work\application\build\software\10.o
 .bss.ff_ack_request
                0x0000000000203358        0x4 ${package_root}\build\out\work\application\build\software\10.o
 .bss.ff_revision
                0x000000000020335c        0x4 ${package_root}\build\out\work\application\build\software\10.o
 .bss.feedforward
                0x0000000000203360      0x450 ${package_root}\build\out\work\application\build\software\10.o
 .bss.ff_total  0x00000000002037b0        0x8 ${package_root}\build\out\work\application\build\software\10.o
 .bss.ff_p      0x00000000002037b8        0x8 ${package_root}\build\out\work\application\build\software\10.o
 .bss.ff_values
                0x00000000002037c0       0x20 ${package_root}\build\out\work\application\build\software\10.o
 .bss.tuning_cache
                0x00000000002037e0      0x3c0 ${package_root}\build\out\work\application\build\software\10.o
 .bss.tuning_cache_next
                0x0000000000203ba0        0x4 ${package_root}\build\out\work\application\build\software\10.o
 .bss.tuning_applies
                0x0000000000203ba4        0x4 ${package_root}\build\out\work\application\build\software\10.o
 .bss.tuning_ack_status
                0x0000000000203ba8        0x4 ${package_root}\build\out\work\application\build\software\10.o
 .bss.tuning_ack_request
                0x0000000000203bac        0x4 ${package_root}\build\out\work\application\build\software\10.o
 .bss.tuning_revision
                0x0000000000203bb0        0x4 ${package_root}\build\out\work\application\build\software\10.o
 .bss.tuning_values
                0x0000000000203bb4       0x20 ${package_root}\build\out\work\application\build\software\10.o
 *fill*         0x0000000000203bd4        0x4 
 .bss.continuous
                0x0000000000203bd8       0x38 ${package_root}\build\out\work\application\build\software\10.o
 .bss.continuous_time_floor
                0x0000000000203c10        0x8 ${package_root}\build\out\work\application\build\software\10.o
 .bss.ncc_detection
                0x0000000000203c18        0x4 ${package_root}\build\out\work\application\build\software\10.o
 .bss.previous_y
                0x0000000000203c1c        0x4 ${package_root}\build\out\work\application\build\software\10.o
 .bss.previous_x
                0x0000000000203c20        0x4 ${package_root}\build\out\work\application\build\software\10.o
 .bss.sound_target_pan
                0x0000000000203c24        0x4 ${package_root}\build\out\work\application\build\software\10.o
 .bss.sound_angle_mdeg
                0x0000000000203c28        0x4 ${package_root}\build\out\work\application\build\software\10.o
 .bss.detection
                0x0000000000203c2c       0x28 ${package_root}\build\out\work\application\build\software\10.o
 .bss.sound_steps
                0x0000000000203c54        0x4 ${package_root}\build\out\work\application\build\software\10.o
 .bss.last_command
                0x0000000000203c58        0x4 ${package_root}\build\out\work\application\build\software\10.o
 .bss.last_observation
                0x0000000000203c5c        0x4 ${package_root}\build\out\work\application\build\software\10.o
 .bss.candidate_seen
                0x0000000000203c60        0x4 ${package_root}\build\out\work\application\build\software\10.o
 .bss.candidate_live
                0x0000000000203c64        0x4 ${package_root}\build\out\work\application\build\software\10.o
 .bss.formal_acquire_clock
                0x0000000000203c68        0x8 ${package_root}\build\out\work\application\build\software\10.o
 .bss.formal_acquire_capture
                0x0000000000203c70        0x8 ${package_root}\build\out\work\application\build\software\10.o
 .bss.formal_acquire_until
                0x0000000000203c78        0x8 ${package_root}\build\out\work\application\build\software\10.o
 .bss.candidate_hold_until
                0x0000000000203c80        0x8 ${package_root}\build\out\work\application\build\software\10.o
 .bss.audio_cache
                0x0000000000203c88      0x3c0 ${package_root}\build\out\work\application\build\software\10.o
 .bss.audio_cache_next
                0x0000000000204048        0x4 ${package_root}\build\out\work\application\build\software\10.o
 .bss.audio_applies
                0x000000000020404c        0x4 ${package_root}\build\out\work\application\build\software\10.o
 .bss.audio_ack_status
                0x0000000000204050        0x4 ${package_root}\build\out\work\application\build\software\10.o
 .bss.audio_ack_request
                0x0000000000204054        0x4 ${package_root}\build\out\work\application\build\software\10.o
 .bss.audio_adopted_after
                0x0000000000204058        0x8 ${package_root}\build\out\work\application\build\software\10.o
 .bss.sound_accept_sequence
                0x0000000000204060        0x4 ${package_root}\build\out\work\application\build\software\10.o
 *fill*         0x0000000000204064        0x4 
 .bss.sound_confirmation
                0x0000000000204068      0x198 ${package_root}\build\out\work\application\build\software\10.o
 .bss.recovery_directional
                0x0000000000204200        0x4 ${package_root}\build\out\work\application\build\software\10.o
 *fill*         0x0000000000204204        0x4 
 .bss.formal_direction_observed
                0x0000000000204208        0x8 ${package_root}\build\out\work\application\build\software\10.o
 .bss.formal_direction_capture
                0x0000000000204210        0x8 ${package_root}\build\out\work\application\build\software\10.o
 .bss.last_formal_vertical_direction
                0x0000000000204218        0x4 ${package_root}\build\out\work\application\build\software\10.o
 *fill*         0x000000000020421c        0x4 
 .bss.reacquire_hold_until
                0x0000000000204220        0x8 ${package_root}\build\out\work\application\build\software\10.o
 .bss.recovery_visual_hold_until
                0x0000000000204228        0x8 ${package_root}\build\out\work\application\build\software\10.o
 .bss.last_qualified_sound
                0x0000000000204230        0x8 ${package_root}\build\out\work\application\build\software\10.o
 .bss.recovery_sparse_until
                0x0000000000204238        0x8 ${package_root}\build\out\work\application\build\software\10.o
 .bss.recovery_clock
                0x0000000000204240        0x8 ${package_root}\build\out\work\application\build\software\10.o
 .bss.recovery_deadline
                0x0000000000204248        0x8 ${package_root}\build\out\work\application\build\software\10.o
 .bss.recovery_started
                0x0000000000204250        0x8 ${package_root}\build\out\work\application\build\software\10.o
 .bss.boundary_latched
                0x0000000000204258        0x4 ${package_root}\build\out\work\application\build\software\10.o
 .bss.recovery_scanning
                0x000000000020425c        0x4 ${package_root}\build\out\work\application\build\software\10.o
 .bss.scan_last_accepted
                0x0000000000204260        0x8 ${package_root}\build\out\work\application\build\software\10.o
 .bss.scan_active
                0x0000000000204268        0x4 ${package_root}\build\out\work\application\build\software\10.o
 .bss.scan_direction
                0x000000000020426c        0x4 ${package_root}\build\out\work\application\build\software\10.o
 .bss.sound_command_yaw
                0x0000000000204270        0x4 ${package_root}\build\out\work\application\build\software\10.o
 *fill*         0x0000000000204274        0x4 
 .bss.sound_pan_stable_after
                0x0000000000204278        0x8 ${package_root}\build\out\work\application\build\software\10.o
 .bss.sound_target_us
                0x0000000000204280        0x4 ${package_root}\build\out\work\application\build\software\10.o
 .bss.sound_phase
                0x0000000000204284        0x4 ${package_root}\build\out\work\application\build\software\10.o
 .bss.external_visual
                0x0000000000204288        0x4 ${package_root}\build\out\work\application\build\software\10.o
 .bss.reason    0x000000000020428c        0x4 ${package_root}\build\out\work\application\build\software\10.o
 .bss.sound_state
                0x0000000000204290        0x4 ${package_root}\build\out\work\application\build\software\10.o
 .bss.sound_plan_active
                0x0000000000204294        0x4 ${package_root}\build\out\work\application\build\software\10.o
 .bss.homing    0x0000000000204298        0x4 ${package_root}\build\out\work\application\build\software\10.o
 .bss.had_visual
                0x000000000020429c        0x4 ${package_root}\build\out\work\application\build\software\10.o
 .bss.hits      0x00000000002042a0        0x4 ${package_root}\build\out\work\application\build\software\10.o
 .bss.tilt_us   0x00000000002042a4        0x4 ${package_root}\build\out\work\application\build\software\10.o
 .bss.pan_us    0x00000000002042a8        0x4 ${package_root}\build\out\work\application\build\software\10.o
 .bss.sound_automatic
                0x00000000002042ac        0x4 ${package_root}\build\out\work\application\build\software\10.o
 .bss.automatic
                0x00000000002042b0        0x4 ${package_root}\build\out\work\application\build\software\10.o
 .bss.supported
                0x00000000002042b4        0x4 ${package_root}\build\out\work\application\build\software\10.o
 .bss.hz        0x00000000002042b8        0x4 ${package_root}\build\out\work\application\build\software\10.o
 *fill*         0x00000000002042bc        0x4 
 .bss.external_visual_time
                0x00000000002042c0        0x8 ${package_root}\build\out\work\application\build\software\10.o
 .bss.last_sound
                0x00000000002042c8        0x8 ${package_root}\build\out\work\application\build\software\10.o
 .bss.sound_cutoff
                0x00000000002042d0        0x8 ${package_root}\build\out\work\application\build\software\10.o
 .bss.last_capture
                0x00000000002042d8        0x8 ${package_root}\build\out\work\application\build\software\10.o
 .bss.detection_captured
                0x00000000002042e0        0x8 ${package_root}\build\out\work\application\build\software\10.o
 .bss.home_next
                0x00000000002042e8        0x8 ${package_root}\build\out\work\application\build\software\10.o
 .bss.auto_expires
                0x00000000002042f0        0x8 ${package_root}\build\out\work\application\build\software\10.o
 .bss.settled_after
                0x00000000002042f8        0x8 ${package_root}\build\out\work\application\build\software\10.o
 .bss.not_before
                0x0000000000204300        0x8 ${package_root}\build\out\work\application\build\software\10.o
 .bss.clock_now
                0x0000000000204308        0x8 ${package_root}\build\out\work\application\build\software\10.o
 .bss.audio_retry_sequence
                0x0000000000204310        0x4 ${package_root}\build\out\work\application\build\software\11.o
 .bss.audio_retry_index
                0x0000000000204314        0x4 ${package_root}\build\out\work\application\build\software\11.o
 .bss.audio_retry_started
                0x0000000000204318        0x4 ${package_root}\build\out\work\application\build\software\11.o
 .bss.audio_retry_active
                0x000000000020431c        0x4 ${package_root}\build\out\work\application\build\software\11.o
 .bss.video_send_seen
                0x0000000000204320        0x4 ${package_root}\build\out\work\application\build\software\11.o
 .bss.last_video_send_us
                0x0000000000204324        0x4 ${package_root}\build\out\work\application\build\software\11.o
 .bss.fault_probe.0
                0x0000000000204328        0x4 ${package_root}\build\out\work\application\build\software\12.o
 .bss.fault_event.1
                0x000000000020432c        0x4 ${package_root}\build\out\work\application\build\software\12.o
 .bss.packet_buffer
                0x0000000000204330     0x2038 ${package_root}\build\out\work\application\build\software\13.o
 *fill*         0x0000000000206368       0x18 
 .bss.video_packet_profile
                0x0000000000206380       0x40 ${package_root}\build\out\work\application\build\software\13.o
                0x0000000000206380                video_packet_profile
 .bss.roi_hint_valid
                0x00000000002063c0        0x4 ${package_root}\build\out\work\application\build\software\15.o
 *fill*         0x00000000002063c4        0x4 
 .bss.roi_hint_clock
                0x00000000002063c8        0x8 ${package_root}\build\out\work\application\build\software\15.o
 .bss.roi_hint_captured
                0x00000000002063d0        0x8 ${package_root}\build\out\work\application\build\software\15.o
 .bss.roi_hint_sequence
                0x00000000002063d8        0x4 ${package_root}\build\out\work\application\build\software\15.o
 .bss.roi_hint_score
                0x00000000002063dc        0x4 ${package_root}\build\out\work\application\build\software\15.o
 .bss.roi_hint_box
                0x00000000002063e0       0x10 ${package_root}\build\out\work\application\build\software\15.o
 .bss.motion_last_revalidation
                0x00000000002063f0        0x8 ${package_root}\build\out\work\application\build\software\15.o
 .bss.motion_aligned_ssd
                0x00000000002063f8        0x4 ${package_root}\build\out\work\application\build\software\15.o
 .bss.motion_scaled_frames
                0x00000000002063fc        0x4 ${package_root}\build\out\work\application\build\software\15.o
 .bss.motion_retry_frames
                0x0000000000206400        0x4 ${package_root}\build\out\work\application\build\software\15.o
 *fill*         0x0000000000206404        0x4 
 .bss.motion_centers_y
                0x0000000000206408       0x38 ${package_root}\build\out\work\application\build\software\15.o
 .bss.motion_centers_x
                0x0000000000206440       0x38 ${package_root}\build\out\work\application\build\software\15.o
 .bss.motion_max_y
                0x0000000000206478       0x1c ${package_root}\build\out\work\application\build\software\15.o
 *fill*         0x0000000000206494        0x4 
 .bss.motion_min_y
                0x0000000000206498       0x1c ${package_root}\build\out\work\application\build\software\15.o
 *fill*         0x00000000002064b4        0x4 
 .bss.motion_max_x
                0x00000000002064b8       0x1c ${package_root}\build\out\work\application\build\software\15.o
 *fill*         0x00000000002064d4        0x4 
 .bss.motion_min_x
                0x00000000002064d8       0x1c ${package_root}\build\out\work\application\build\software\15.o
 *fill*         0x00000000002064f4        0x4 
 .bss.visual_tracker_cpu_profile
                0x00000000002064f8       0x20 ${package_root}\build\out\work\application\build\software\15.o
                0x00000000002064f8                visual_tracker_cpu_profile
 .bss.tracker_work_clock
                0x0000000000206518        0x4 ${package_root}\build\out\work\application\build\software\15.o
 *fill*         0x000000000020651c        0x4 
 .bss.motion_sample_offset
                0x0000000000206520      0x7e0 ${package_root}\build\out\work\application\build\software\15.o
 .bss.motion_sample_y
                0x0000000000206d00      0x7e0 ${package_root}\build\out\work\application\build\software\15.o
 .bss.motion_sample_x
                0x00000000002074e0      0x7e0 ${package_root}\build\out\work\application\build\software\15.o
 .bss.stable_scale_was_recovery
                0x0000000000207cc0        0x4 ${package_root}\build\out\work\application\build\software\15.o
 .bss.stable_scale_margin
                0x0000000000207cc4        0x4 ${package_root}\build\out\work\application\build\software\15.o
 .bss.stable_scale_reference
                0x0000000000207cc8        0x4 ${package_root}\build\out\work\application\build\software\15.o
 *fill*         0x0000000000207ccc        0x4 
 .bss.stable_last_scale
                0x0000000000207cd0        0x8 ${package_root}\build\out\work\application\build\software\15.o
 .bss.motion_outer_y
                0x0000000000207cd8        0x4 ${package_root}\build\out\work\application\build\software\15.o
 .bss.motion_outer_x
                0x0000000000207cdc        0x4 ${package_root}\build\out\work\application\build\software\15.o
 .bss.motion_known_count
                0x0000000000207ce0        0x4 ${package_root}\build\out\work\application\build\software\15.o
 *fill*         0x0000000000207ce4        0x4 
 .bss.motion_known_at
                0x0000000000207ce8     0x7080 ${package_root}\build\out\work\application\build\software\15.o
 .bss.motion_known
                0x000000000020ed68     0xe100 ${package_root}\build\out\work\application\build\software\15.o
 .bss.motion_search_step
                0x000000000021ce68        0x4 ${package_root}\build\out\work\application\build\software\15.o
 .bss.motion_outer_second
                0x000000000021ce6c        0x4 ${package_root}\build\out\work\application\build\software\15.o
 .bss.motion_scales
                0x000000000021ce70       0x1c ${package_root}\build\out\work\application\build\software\15.o
 .bss.motion_seed_height
                0x000000000021ce8c        0x4 ${package_root}\build\out\work\application\build\software\15.o
 .bss.motion_seed_width
                0x000000000021ce90        0x4 ${package_root}\build\out\work\application\build\software\15.o
 .bss.motion_candidates
                0x000000000021ce94        0x4 ${package_root}\build\out\work\application\build\software\15.o
 .bss.motion_side
                0x000000000021ce98        0x4 ${package_root}\build\out\work\application\build\software\15.o
 .bss.motion_phase
                0x000000000021ce9c        0x4 ${package_root}\build\out\work\application\build\software\15.o
 .bss.reverse_y
                0x000000000021cea0        0x8 ${package_root}\build\out\work\application\build\software\15.o
 .bss.reverse_x
                0x000000000021cea8        0x8 ${package_root}\build\out\work\application\build\software\15.o
 .bss.reverse_scores
                0x000000000021ceb0        0x8 ${package_root}\build\out\work\application\build\software\15.o
 .bss.video_recovery_paused
                0x000000000021ceb8        0x4 ${package_root}\build\out\work\application\build\software\15.o
 .bss.control_last_sequence
                0x000000000021cebc        0x4 ${package_root}\build\out\work\application\build\software\15.o
 .bss.control_last_capture
                0x000000000021cec0        0x8 ${package_root}\build\out\work\application\build\software\15.o
 .bss.control_live_job
                0x000000000021cec8        0x4 ${package_root}\build\out\work\application\build\software\15.o
 .bss.control_ready
                0x000000000021cecc        0x4 ${package_root}\build\out\work\application\build\software\15.o
 .bss.acquire_catchup
                0x000000000021ced0        0x4 ${package_root}\build\out\work\application\build\software\15.o
 *fill*         0x000000000021ced4        0x4 
 .bss.handoff_observed_captured
                0x000000000021ced8        0x8 ${package_root}\build\out\work\application\build\software\15.o
 .bss.handoff_observed_sequence
                0x000000000021cee0        0x4 ${package_root}\build\out\work\application\build\software\15.o
 *fill*         0x000000000021cee4        0x4 
 .bss.motion_dt
                0x000000000021cee8        0x8 ${package_root}\build\out\work\application\build\software\15.o
 .bss.predict_y
                0x000000000021cef0        0x4 ${package_root}\build\out\work\application\build\software\15.o
 .bss.predict_x
                0x000000000021cef4        0x4 ${package_root}\build\out\work\application\build\software\15.o
 .bss.motion_y  0x000000000021cef8        0x4 ${package_root}\build\out\work\application\build\software\15.o
 .bss.motion_x  0x000000000021cefc        0x4 ${package_root}\build\out\work\application\build\software\15.o
 .bss.candidate_box
                0x000000000021cf00       0x10 ${package_root}\build\out\work\application\build\software\15.o
 .bss.candidate_captured
                0x000000000021cf10        0x8 ${package_root}\build\out\work\application\build\software\15.o
 .bss.selection_captured
                0x000000000021cf18        0x8 ${package_root}\build\out\work\application\build\software\15.o
 .bss.rejected_batches
                0x000000000021cf20        0x4 ${package_root}\build\out\work\application\build\software\15.o
 .bss.switch_count
                0x000000000021cf24        0x4 ${package_root}\build\out\work\application\build\software\15.o
 .bss.selection_sequence
                0x000000000021cf28        0x4 ${package_root}\build\out\work\application\build\software\15.o
 .bss.selection_reason
                0x000000000021cf2c        0x4 ${package_root}\build\out\work\application\build\software\15.o
 .bss.selected_index
                0x000000000021cf30        0x4 ${package_root}\build\out\work\application\build\software\15.o
 .bss.unsupported
                0x000000000021cf34        0x4 ${package_root}\build\out\work\application\build\software\15.o
 .bss.candidate_hits
                0x000000000021cf38        0x4 ${package_root}\build\out\work\application\build\software\15.o
 .bss.candidate_count
                0x000000000021cf3c        0x4 ${package_root}\build\out\work\application\build\software\15.o
 .bss.scores    0x000000000021cf40     0x2584 ${package_root}\build\out\work\application\build\software\15.o
 *fill*         0x000000000021f4c4        0x4 
 .bss.template_pixels
                0x000000000021f4c8       0x90 ${package_root}\build\out\work\application\build\software\15.o
 .bss.sample_y  0x000000000021f558       0x90 ${package_root}\build\out\work\application\build\software\15.o
 .bss.sample_x  0x000000000021f5e8       0x90 ${package_root}\build\out\work\application\build\software\15.o
 .bss.max_y     0x000000000021f678        0x4 ${package_root}\build\out\work\application\build\software\15.o
 .bss.min_y     0x000000000021f67c        0x4 ${package_root}\build\out\work\application\build\software\15.o
 .bss.max_x     0x000000000021f680        0x4 ${package_root}\build\out\work\application\build\software\15.o
 .bss.min_x     0x000000000021f684        0x4 ${package_root}\build\out\work\application\build\software\15.o
 .bss.origin_y  0x000000000021f688        0x4 ${package_root}\build\out\work\application\build\software\15.o
 .bss.origin_x  0x000000000021f68c        0x4 ${package_root}\build\out\work\application\build\software\15.o
 .bss.t_variance
                0x000000000021f690        0x4 ${package_root}\build\out\work\application\build\software\15.o
 .bss.t_sum     0x000000000021f694        0x4 ${package_root}\build\out\work\application\build\software\15.o
 .bss.quality   0x000000000021f698        0x4 ${package_root}\build\out\work\application\build\software\15.o
 .bss.bird_score
                0x000000000021f69c        0x4 ${package_root}\build\out\work\application\build\software\15.o
 .bss.box_now   0x000000000021f6a0       0x10 ${package_root}\build\out\work\application\build\software\15.o
 .bss.search_radius
                0x000000000021f6b0        0x4 ${package_root}\build\out\work\application\build\software\15.o
 .bss.recovered
                0x000000000021f6b4        0x4 ${package_root}\build\out\work\application\build\software\15.o
 .bss.last_loss_reason
                0x000000000021f6b8        0x4 ${package_root}\build\out\work\application\build\software\15.o
 .bss.current_reason
                0x000000000021f6bc        0x4 ${package_root}\build\out\work\application\build\software\15.o
 .bss.misses    0x000000000021f6c0        0x4 ${package_root}\build\out\work\application\build\software\15.o
 *fill*         0x000000000021f6c4        0x4 
 .bss.reacquire_started
                0x000000000021f6c8        0x8 ${package_root}\build\out\work\application\build\software\15.o
 .bss.confirmed
                0x000000000021f6d0        0x8 ${package_root}\build\out\work\application\build\software\15.o
 .bss.last_checked
                0x000000000021f6d8        0x8 ${package_root}\build\out\work\application\build\software\15.o
 .bss.last_processed
                0x000000000021f6e0        0x8 ${package_root}\build\out\work\application\build\software\15.o
 .bss.search_timestamp
                0x000000000021f6e8        0x8 ${package_root}\build\out\work\application\build\software\15.o
 .bss.last_sequence
                0x000000000021f6f0        0x4 ${package_root}\build\out\work\application\build\software\15.o
 .bss.losses    0x000000000021f6f4        0x4 ${package_root}\build\out\work\application\build\software\15.o
 .bss.tracked_frames
                0x000000000021f6f8        0x4 ${package_root}\build\out\work\application\build\software\15.o
 .bss.search_sequence
                0x000000000021f6fc        0x4 ${package_root}\build\out\work\application\build\software\15.o
 .bss.search_cursor
                0x000000000021f700        0x4 ${package_root}\build\out\work\application\build\software\15.o
 .bss.search_slot
                0x000000000021f704        0x4 ${package_root}\build\out\work\application\build\software\15.o
 .bss.processing
                0x000000000021f708        0x4 ${package_root}\build\out\work\application\build\software\15.o
 .bss.npoints   0x000000000021f70c        0x4 ${package_root}\build\out\work\application\build\software\15.o
 .bss.active    0x000000000021f710        0x4 ${package_root}\build\out\work\application\build\software\15.o
 *fill*         0x000000000021f714        0x4 
 .bss.gray_sums
                0x000000000021f718     0x7080 ${package_root}\build\out\work\application\build\software\15.o
 .bss.next_offset
                0x0000000000226798        0x4 ${package_root}\build\out\work\application\build\software\15.o
 .bss.pixel_cursor
                0x000000000022679c        0x4 ${package_root}\build\out\work\application\build\software\15.o
 .bss.pending_slot
                0x00000000002267a0        0x4 ${package_root}\build\out\work\application\build\software\15.o
 .bss.pending   0x00000000002267a4        0x4 ${package_root}\build\out\work\application\build\software\15.o
 .bss.head      0x00000000002267a8        0x4 ${package_root}\build\out\work\application\build\software\15.o
 .bss.have_frame
                0x00000000002267ac        0x4 ${package_root}\build\out\work\application\build\software\15.o
 .bss.history   0x00000000002267b0   0x152700 ${package_root}\build\out\work\application\build\software\15.o
 .bss.neon_errors
                0x0000000000378eb0        0x4 ${package_root}\build\out\work\application\build\software\15.o
 .bss.neon_checked
                0x0000000000378eb4        0x4 ${package_root}\build\out\work\application\build\software\15.o
 *fill*         0x0000000000378eb8        0x8 
 .bss.video_profile
                0x0000000000378ec0       0x40 ${package_root}\build\out\work\application\build\software\16.o
                0x0000000000378ec0                video_profile
 .bss.visual_confirmation_retry
                0x0000000000378f00        0x4 ${package_root}\build\out\work\application\build\software\16.o
 .bss.roi_detection_profile
                0x0000000000378f04       0x40 ${package_root}\build\out\work\application\build\software\16.o
                0x0000000000378f04                roi_detection_profile
 *fill*         0x0000000000378f44        0x4 
 .bss.roi_clock
                0x0000000000378f48        0x8 ${package_root}\build\out\work\application\build\software\16.o
 .bss.roi_camera_epoch
                0x0000000000378f50        0x4 ${package_root}\build\out\work\application\build\software\16.o
 .bss.roi_job_owner_epoch
                0x0000000000378f54        0x4 ${package_root}\build\out\work\application\build\software\16.o
 .bss.roi_owner_epoch
                0x0000000000378f58        0x4 ${package_root}\build\out\work\application\build\software\16.o
 .bss.roi_policy
                0x0000000000378f5c        0x4 ${package_root}\build\out\work\application\build\software\16.o
 .bss.roi_mode  0x0000000000378f60        0x4 ${package_root}\build\out\work\application\build\software\16.o
 .bss.roi_owned
                0x0000000000378f64        0x4 ${package_root}\build\out\work\application\build\software\16.o
 .bss.roi_job_active
                0x0000000000378f68        0x4 ${package_root}\build\out\work\application\build\software\16.o
 .bss.roi_last_was_local
                0x0000000000378f6c        0x4 ${package_root}\build\out\work\application\build\software\16.o
 .bss.roi_retry_pending
                0x0000000000378f70        0x4 ${package_root}\build\out\work\application\build\software\16.o
 .bss.roi_job_hint
                0x0000000000378f74       0x10 ${package_root}\build\out\work\application\build\software\16.o
 .bss.roi_job   0x0000000000378f84        0xc ${package_root}\build\out\work\application\build\software\16.o
 .bss.sound_round_noise_until
                0x0000000000378f90        0x8 ${package_root}\build\out\work\application\build\software\16.o
 .bss.sound_round_resume
                0x0000000000378f98        0x8 ${package_root}\build\out\work\application\build\software\16.o
 .bss.sound_last_job_audio
                0x0000000000378fa0        0x4 ${package_root}\build\out\work\application\build\software\16.o
 .bss.classification_priority_profile
                0x0000000000378fa4       0x20 ${package_root}\build\out\work\application\build\software\16.o
                0x0000000000378fa4                classification_priority_profile
 .bss.classification_control_pending
                0x0000000000378fc4        0x4 ${package_root}\build\out\work\application\build\software\16.o
 .bss.classification_formal_accepted
                0x0000000000378fc8        0x4 ${package_root}\build\out\work\application\build\software\16.o
 .bss.classification_busy_epoch
                0x0000000000378fcc        0x4 ${package_root}\build\out\work\application\build\software\16.o
 .bss.classification_control_epoch
                0x0000000000378fd0        0x4 ${package_root}\build\out\work\application\build\software\16.o
 .bss.control_service_epoch
                0x0000000000378fd4        0x4 ${package_root}\build\out\work\application\build\software\16.o
 .bss.classification_busy_until
                0x0000000000378fd8        0x8 ${package_root}\build\out\work\application\build\software\16.o
 .bss.control_service_time
                0x0000000000378fe0        0x8 ${package_root}\build\out\work\application\build\software\16.o
 .bss.classification_control_started
                0x0000000000378fe8        0x8 ${package_root}\build\out\work\application\build\software\16.o
 .bss.request_start
                0x0000000000378ff0        0x8 ${package_root}\build\out\work\application\build\software\16.o
 .bss.next_visual
                0x0000000000378ff8        0x8 ${package_root}\build\out\work\application\build\software\16.o
 .bss.active_box
                0x0000000000379000        0x8 ${package_root}\build\out\work\application\build\software\16.o
 .bss.requested_box
                0x0000000000379008        0x8 ${package_root}\build\out\work\application\build\software\16.o
 .bss.active_policy
                0x0000000000379010        0x4 ${package_root}\build\out\work\application\build\software\16.o
 .bss.requested_policy
                0x0000000000379014        0x4 ${package_root}\build\out\work\application\build\software\16.o
 .bss.job_mode  0x0000000000379018        0x4 ${package_root}\build\out\work\application\build\software\16.o
 .bss.visual_sequence
                0x000000000037901c        0x4 ${package_root}\build\out\work\application\build\software\16.o
 .bss.capture_state
                0x0000000000379020        0x4 ${package_root}\build\out\work\application\build\software\16.o
 .bss.active_mode
                0x0000000000379024        0x4 ${package_root}\build\out\work\application\build\software\16.o
 .bss.requested_mode
                0x0000000000379028        0x4 ${package_root}\build\out\work\application\build\software\16.o
 .bss.direction_debug
                0x000000000037902c       0x40 ${package_root}\build\out\work\application\build\software\16.o
                0x000000000037902c                direction_debug
 *fill*         0x000000000037906c        0x4 
 .bss.motor_bird
                0x0000000000379070       0x28 ${package_root}\build\out\work\application\build\software\16.o
 .bss.motor_noise
                0x0000000000379098      0x130 ${package_root}\build\out\work\application\build\software\16.o
 .bss.doa_gate  0x00000000003791c8       0x50 ${package_root}\build\out\work\application\build\software\16.o
 .bss.result    0x0000000000379218      0x180 ${package_root}\build\out\work\application\build\software\16.o
 .bss.image_logits
                0x0000000000379398       0x3c ${package_root}\build\out\work\application\build\software\16.o
 .bss.audio_logits
                0x00000000003793d4       0x3c ${package_root}\build\out\work\application\build\software\16.o
 .bss.status_sequence
                0x0000000000379410        0x4 ${package_root}\build\out\work\application\build\software\16.o
 *fill*         0x0000000000379414        0x4 
 .bss.last_status
                0x0000000000379418        0x8 ${package_root}\build\out\work\application\build\software\16.o
 .bss.status_start
                0x0000000000379420        0x8 ${package_root}\build\out\work\application\build\software\16.o
 .bss.last_service
                0x0000000000379428        0x8 ${package_root}\build\out\work\application\build\software\16.o
 .bss.wait_start
                0x0000000000379430        0x8 ${package_root}\build\out\work\application\build\software\16.o
 .bss.job_video_epoch
                0x0000000000379438        0x4 ${package_root}\build\out\work\application\build\software\16.o
 .bss.video_recovery_epoch
                0x000000000037943c        0x4 ${package_root}\build\out\work\application\build\software\16.o
 .bss.service_busy
                0x0000000000379440        0x4 ${package_root}\build\out\work\application\build\software\16.o
 .bss.video_state
                0x0000000000379444        0x4 ${package_root}\build\out\work\application\build\software\16.o
 .bss.stage     0x0000000000379448        0x4 ${package_root}\build\out\work\application\build\software\16.o
 .bss.net       0x000000000037944c        0x4 ${package_root}\build\out\work\application\build\software\16.o
 .bss.unified_logits
                0x0000000000379450       0x3c ${package_root}\build\out\work\application\build\software\16.o
                0x0000000000379450                unified_logits
 .bss.unified_validate
                0x000000000037948c        0x4 ${package_root}\build\out\work\application\build\software\16.o
                0x000000000037948c                unified_validate
 .bss.sd_archive_job_identity
                0x0000000000379490        0x4 ${package_root}\build\out\work\application\build\software\16.o
 *fill*         0x0000000000379494        0x4 
 .bss.candidates.2
                0x0000000000379498    0x12f30 ${package_root}\build\out\work\application\build\software\18.o
 .bss.add_next  0x000000000038c3c8        0x4 ${package_root}\build\out\work\application\build\software\18.o
 .bss.add_tables
                0x000000000038c3cc   0x200380 ${package_root}\build\out\work\application\build\software\18.o
 .bss.m17_requant_test_errors
                0x000000000058c74c        0x4 ${package_root}\build\out\work\application\build\software\18.o
                0x000000000058c74c                m17_requant_test_errors
 .bss.m17_requant_test_count
                0x000000000058c750        0x4 ${package_root}\build\out\work\application\build\software\18.o
                0x000000000058c750                m17_requant_test_count
 .bss.view.0    0x000000000058c754      0x500 ${package_root}\build\out\work\application\build\software\19.o
 .bss.gacc.1    0x000000000058cc54     0x1400 ${package_root}\build\out\work\application\build\software\19.o
 .bss.pw_segment_copy
                0x000000000058e054        0x4 ${package_root}\build\out\work\application\build\software\19.o
 .bss.pw_direct_output
                0x000000000058e058        0x4 ${package_root}\build\out\work\application\build\software\19.o
 .bss.pw_dma_overlap
                0x000000000058e05c        0x4 ${package_root}\build\out\work\application\build\software\19.o
 .bss.Dma       0x000000000058e060      0x750 ${package_root}\build\out\work\application\build\software\19.o
 .bss.view.0    0x000000000058e7b0      0x500 ${package_root}\build\out\work\application\build\software\20.o
 .bss.gacc.1    0x000000000058ecb0     0x1400 ${package_root}\build\out\work\application\build\software\20.o
 .bss.pw_segment_copy
                0x00000000005900b0        0x4 ${package_root}\build\out\work\application\build\software\20.o
 .bss.pw_direct_output
                0x00000000005900b4        0x4 ${package_root}\build\out\work\application\build\software\20.o
 .bss.pw_dma_overlap
                0x00000000005900b8        0x4 ${package_root}\build\out\work\application\build\software\20.o
 .bss.Dma       0x00000000005900bc      0x750 ${package_root}\build\out\work\application\build\software\20.o
 .bss.Dma       0x000000000059080c      0x750 ${package_root}\build\out\work\application\build\software\21.o
 .bss.mem_free_count
                0x0000000000590f5c        0x1 ${package_root}\build\out\work\application\build\software\22.o
 *fill*         0x0000000000590f5d        0x3 
 .bss.lfree     0x0000000000590f60        0x4 ${package_root}\build\out\work\application\build\software\22.o
 .bss.ram_end   0x0000000000590f64        0x4 ${package_root}\build\out\work\application\build\software\22.o
 .bss.ram       0x0000000000590f68        0x4 ${package_root}\build\out\work\application\build\software\22.o
 .bss.ram_heap  0x0000000000590f6c    0x200bf ${package_root}\build\out\work\application\build\software\22.o
                0x0000000000590f6c                ram_heap
 *fill*         0x00000000005b102b        0x1 
 .bss.board_keys_diag
                0x00000000005b102c       0xb8 ${package_root}\build\out\work\application\build\software\23.o
                0x00000000005b102c                board_keys_diag
 .bss.recovery_changed_at
                0x00000000005b10e4        0x4 ${package_root}\build\out\work\application\build\software\23.o
 .bss.recovery_guard
                0x00000000005b10e8        0x4 ${package_root}\build\out\work\application\build\software\23.o
 .bss.recovery_seen
                0x00000000005b10ec        0x4 ${package_root}\build\out\work\application\build\software\23.o
 .bss.last_focus
                0x00000000005b10f0        0x4 ${package_root}\build\out\work\application\build\software\23.o
 .bss.last_mode
                0x00000000005b10f4        0x4 ${package_root}\build\out\work\application\build\software\23.o
 .bss.last_poll
                0x00000000005b10f8        0x4 ${package_root}\build\out\work\application\build\software\23.o
 .bss.focus_attempted
                0x00000000005b10fc        0x4 ${package_root}\build\out\work\application\build\software\23.o
 .bss.focus_pending
                0x00000000005b1100        0x4 ${package_root}\build\out\work\application\build\software\23.o
 .bss.enhance_pending
                0x00000000005b1104        0x4 ${package_root}\build\out\work\application\build\software\23.o
 .bss.enhance_used
                0x00000000005b1108        0x4 ${package_root}\build\out\work\application\build\software\23.o
 .bss.enhance_mode
                0x00000000005b110c        0x4 ${package_root}\build\out\work\application\build\software\23.o
 .bss.keys_valid
                0x00000000005b1110        0x4 ${package_root}\build\out\work\application\build\software\23.o
 .bss.initialized
                0x00000000005b1114        0x4 ${package_root}\build\out\work\application\build\software\23.o
 .bss.keys      0x00000000005b1118       0x40 ${package_root}\build\out\work\application\build\software\23.o
 .bss.polled    0x00000000005b1158        0x4 ${package_root}\build\out\work\application\build\software\24.o
 .bss.last_poll
                0x00000000005b115c        0x4 ${package_root}\build\out\work\application\build\software\24.o
 .bss.network_standalone_audio_dropped
                0x00000000005b1160        0x4 ${package_root}\build\out\work\application\build\software\24.o
                0x00000000005b1160                network_standalone_audio_dropped
 .bss.network_standalone_changes
                0x00000000005b1164        0x4 ${package_root}\build\out\work\application\build\software\24.o
                0x00000000005b1164                network_standalone_changes
 .bss.network_standalone_speed
                0x00000000005b1168        0x4 ${package_root}\build\out\work\application\build\software\24.o
                0x00000000005b1168                network_standalone_speed
 .bss.phymapemac1
                0x00000000005b116c       0x80 ${package_root}\build\out\work\application\build\software\25.o
                0x00000000005b116c                phymapemac1
 .bss.phymapemac0
                0x00000000005b11ec       0x80 ${package_root}\build\out\work\application\build\software\25.o
                0x00000000005b11ec                phymapemac0
 *fill*         0x00000000005b126c        0x4 
 .bss.current_classified
                0x00000000005b1270        0x8 ${package_root}\build\out\work\application\build\software\26.o
 .bss.current_identity
                0x00000000005b1278        0x4 ${package_root}\build\out\work\application\build\software\26.o
 .bss.current_code
                0x00000000005b127c        0xc ${package_root}\build\out\work\application\build\software\26.o
 .bss.have_capture
                0x00000000005b1288        0x4 ${package_root}\build\out\work\application\build\software\26.o
 .bss.have_target
                0x00000000005b128c        0x4 ${package_root}\build\out\work\application\build\software\26.o
 .bss.last_capture
                0x00000000005b1290        0x8 ${package_root}\build\out\work\application\build\software\26.o
 .bss.last_target
                0x00000000005b1298        0x8 ${package_root}\build\out\work\application\build\software\26.o
 .bss.current_time
                0x00000000005b12a0        0x8 ${package_root}\build\out\work\application\build\software\26.o
 .bss.last_sequence
                0x00000000005b12a8        0x4 ${package_root}\build\out\work\application\build\software\26.o
 .bss.expected_offset
                0x00000000005b12ac        0x4 ${package_root}\build\out\work\application\build\software\26.o
 .bss.next_pixel
                0x00000000005b12b0        0x4 ${package_root}\build\out\work\application\build\software\26.o
 .bss.boot_id   0x00000000005b12b4        0x4 ${package_root}\build\out\work\application\build\software\26.o
 .bss.standalone_fusion_last_command
                0x00000000005b12b8        0x4 ${package_root}\build\out\work\application\build\software\27.o
                0x00000000005b12b8                standalone_fusion_last_command
 .bss.standalone_fusion_state
                0x00000000005b12bc        0x4 ${package_root}\build\out\work\application\build\software\27.o
                0x00000000005b12bc                standalone_fusion_state
 .bss.roi_tables_ready
                0x00000000005b12c0        0x4 ${package_root}\build\out\work\application\build\software\28.o
 .bss.roi_normalized
                0x00000000005b12c4      0xc00 ${package_root}\build\out\work\application\build\software\28.o
 .bss.cache     0x00000000005b1ec4      0x2c0 ${package_root}\build\out\work\application\build\software\29.o
 .bss.next_cache
                0x00000000005b2184        0x4 ${package_root}\build\out\work\application\build\software\29.o
 .bss.applies   0x00000000005b2188        0x4 ${package_root}\build\out\work\application\build\software\29.o
 .bss.ack_status
                0x00000000005b218c        0x4 ${package_root}\build\out\work\application\build\software\29.o
 .bss.ack_request
                0x00000000005b2190        0x4 ${package_root}\build\out\work\application\build\software\29.o
 .bss.cache     0x00000000005b2194      0x240 ${package_root}\build\out\work\application\build\software\30.o
 .bss.next_cache
                0x00000000005b23d4        0x4 ${package_root}\build\out\work\application\build\software\30.o
 .bss.applies   0x00000000005b23d8        0x4 ${package_root}\build\out\work\application\build\software\30.o
 .bss.ack_status
                0x00000000005b23dc        0x4 ${package_root}\build\out\work\application\build\software\30.o
 .bss.ack_request
                0x00000000005b23e0        0x4 ${package_root}\build\out\work\application\build\software\30.o
 *fill*         0x00000000005b23e4        0x4 
 .bss.archive_classified
                0x00000000005b23e8        0x8 ${package_root}\build\out\work\application\build\software\31.o
 .bss.archive_species
                0x00000000005b23f0        0x4 ${package_root}\build\out\work\application\build\software\31.o
 .bss.archive_epoch
                0x00000000005b23f4        0x4 ${package_root}\build\out\work\application\build\software\31.o
 .bss.archive_ssd_qualified
                0x00000000005b23f8        0x4 ${package_root}\build\out\work\application\build\software\31.o
 .bss.archive_ready
                0x00000000005b23fc        0x4 ${package_root}\build\out\work\application\build\software\31.o
 .bss.class_source_timestamp
                0x00000000005b2400        0x8 ${package_root}\build\out\work\application\build\software\31.o
 .bss.class_applied
                0x00000000005b2408        0x4 ${package_root}\build\out\work\application\build\software\31.o
 .bss.class_source_sequence
                0x00000000005b240c        0x4 ${package_root}\build\out\work\application\build\software\31.o
 .bss.class_roi
                0x00000000005b2410       0x10 ${package_root}\build\out\work\application\build\software\31.o
 .bss.class_logits
                0x00000000005b2420       0x3c ${package_root}\build\out\work\application\build\software\31.o
 *fill*         0x00000000005b245c        0x4 
 .bss.confirmed_time
                0x00000000005b2460        0x8 ${package_root}\build\out\work\application\build\software\31.o
 .bss.class_time
                0x00000000005b2468        0x8 ${package_root}\build\out\work\application\build\software\31.o
 .bss.confirmed_sequence
                0x00000000005b2470        0x4 ${package_root}\build\out\work\application\build\software\31.o
 .bss.class_epoch
                0x00000000005b2474        0x4 ${package_root}\build\out\work\application\build\software\31.o
 .bss.class_policy
                0x00000000005b2478        0x4 ${package_root}\build\out\work\application\build\software\31.o
 .bss.class_ready
                0x00000000005b247c        0x4 ${package_root}\build\out\work\application\build\software\31.o
 .bss.handoff_ssd_score
                0x00000000005b2480        0x4 ${package_root}\build\out\work\application\build\software\31.o
 .bss.handoff_ssd_box
                0x00000000005b2484       0x10 ${package_root}\build\out\work\application\build\software\31.o
 *fill*         0x00000000005b2494        0x4 
 .bss.handoff_ssd_captured
                0x00000000005b2498        0x8 ${package_root}\build\out\work\application\build\software\31.o
 .bss.handoff_ssd_sequence
                0x00000000005b24a0        0x4 ${package_root}\build\out\work\application\build\software\31.o
 *fill*         0x00000000005b24a4        0x4 
 .bss.handoff_current
                0x00000000005b24a8       0x28 ${package_root}\build\out\work\application\build\software\31.o
 .bss.handoff_ready
                0x00000000005b24d0        0x4 ${package_root}\build\out\work\application\build\software\31.o
 .bss.candidate_history_next
                0x00000000005b24d4        0x4 ${package_root}\build\out\work\application\build\software\31.o
 .bss.candidate_history_count
                0x00000000005b24d8        0x4 ${package_root}\build\out\work\application\build\software\31.o
 *fill*         0x00000000005b24dc        0x4 
 .bss.candidate_history
                0x00000000005b24e0      0xf00 ${package_root}\build\out\work\application\build\software\31.o
 .bss.scores    0x00000000005b33e0      0x9c4 ${package_root}\build\out\work\application\build\software\31.o
 .bss.tvar      0x00000000005b3da4        0x4 ${package_root}\build\out\work\application\build\software\31.o
 .bss.tsum      0x00000000005b3da8        0x4 ${package_root}\build\out\work\application\build\software\31.o
 .bss.pixels    0x00000000005b3dac       0x40 ${package_root}\build\out\work\application\build\software\31.o
 .bss.sy        0x00000000005b3dec      0x100 ${package_root}\build\out\work\application\build\software\31.o
 .bss.sx        0x00000000005b3eec      0x100 ${package_root}\build\out\work\application\build\software\31.o
 .bss.oy        0x00000000005b3fec        0x4 ${package_root}\build\out\work\application\build\software\31.o
 .bss.ox        0x00000000005b3ff0        0x4 ${package_root}\build\out\work\application\build\software\31.o
 .bss.quality   0x00000000005b3ff4        0x4 ${package_root}\build\out\work\application\build\software\31.o
 .bss.detector_score
                0x00000000005b3ff8        0x4 ${package_root}\build\out\work\application\build\software\31.o
 .bss.box_now   0x00000000005b3ffc       0x10 ${package_root}\build\out\work\application\build\software\31.o
 *fill*         0x00000000005b400c        0x4 
 .bss.clear_until
                0x00000000005b4010        0x8 ${package_root}\build\out\work\application\build\software\31.o
 .bss.last_send
                0x00000000005b4018        0x8 ${package_root}\build\out\work\application\build\software\31.o
 .bss.search_time
                0x00000000005b4020        0x8 ${package_root}\build\out\work\application\build\software\31.o
 .bss.frame_time
                0x00000000005b4028        0x8 ${package_root}\build\out\work\application\build\software\31.o
 .bss.seed_time
                0x00000000005b4030        0x8 ${package_root}\build\out\work\application\build\software\31.o
 .bss.search_sequence
                0x00000000005b4038        0x4 ${package_root}\build\out\work\application\build\software\31.o
 .bss.source_sequence
                0x00000000005b403c        0x4 ${package_root}\build\out\work\application\build\software\31.o
 .bss.dirty     0x00000000005b4040        0x4 ${package_root}\build\out\work\application\build\software\31.o
 .bss.reason    0x00000000005b4044        0x4 ${package_root}\build\out\work\application\build\software\31.o
 .bss.cursor    0x00000000005b4048        0x4 ${package_root}\build\out\work\application\build\software\31.o
 .bss.processing
                0x00000000005b404c        0x4 ${package_root}\build\out\work\application\build\software\31.o
 .bss.seeded    0x00000000005b4050        0x4 ${package_root}\build\out\work\application\build\software\31.o
 .bss.visible   0x00000000005b4054        0x4 ${package_root}\build\out\work\application\build\software\31.o
 .bss.epoch     0x00000000005b4058        0x4 ${package_root}\build\out\work\application\build\software\31.o
 .bss.message_sequence
                0x00000000005b405c        0x4 ${package_root}\build\out\work\application\build\software\31.o
 .bss.serial    0x00000000005b4060        0x4 ${package_root}\build\out\work\application\build\software\31.o
 .bss.boot_id   0x00000000005b4064        0x4 ${package_root}\build\out\work\application\build\software\31.o
 .bss.hardware_config
                0x00000000005b4068       0x80 ${package_root}\build\out\work\application\build\software\32.o
 .bss.hdmi_start_error
                0x00000000005b40e8        0x4 ${package_root}\build\out\work\application\build\software\32.o
                0x00000000005b40e8                hdmi_start_error
 .bss.hdmi_read_error
                0x00000000005b40ec        0x4 ${package_root}\build\out\work\application\build\software\32.o
                0x00000000005b40ec                hdmi_read_error
 .bss.hdmi_last_status
                0x00000000005b40f0        0x4 ${package_root}\build\out\work\application\build\software\32.o
                0x00000000005b40f0                hdmi_last_status
 .bss.hdmi_read_started
                0x00000000005b40f4        0x4 ${package_root}\build\out\work\application\build\software\32.o
                0x00000000005b40f4                hdmi_read_started
 .bss.last_update
                0x00000000005b40f8        0x8 ${package_root}\build\out\work\application\build\software\33.o
 .bss.result_time
                0x00000000005b4100        0x8 ${package_root}\build\out\work\application\build\software\33.o
 .bss.latest    0x00000000005b4108      0x180 ${package_root}\build\out\work\application\build\software\33.o
 .bss.board_osd_result_sequence
                0x00000000005b4288        0x4 ${package_root}\build\out\work\application\build\software\33.o
                0x00000000005b4288                board_osd_result_sequence
 .bss.board_osd_class
                0x00000000005b428c        0x4 ${package_root}\build\out\work\application\build\software\33.o
                0x00000000005b428c                board_osd_class
 .bss.board_osd_visible
                0x00000000005b4290        0x4 ${package_root}\build\out\work\application\build\software\33.o
                0x00000000005b4290                board_osd_visible
 .bss.board_osd_commits
                0x00000000005b4294        0x4 ${package_root}\build\out\work\application\build\software\33.o
                0x00000000005b4294                board_osd_commits
 .bss.scan_target
                0x00000000005b4298        0x4 ${package_root}\build\out\work\application\build\software\34.o
 .bss.have_focused
                0x00000000005b429c        0x4 ${package_root}\build\out\work\application\build\software\34.o
 .bss.have_desired
                0x00000000005b42a0        0x4 ${package_root}\build\out\work\application\build\software\34.o
 .bss.hits      0x00000000005b42a4        0x4 ${package_root}\build\out\work\application\build\software\34.o
 .bss.scan_box  0x00000000005b42a8       0x10 ${package_root}\build\out\work\application\build\software\34.o
 .bss.desired   0x00000000005b42b8       0x10 ${package_root}\build\out\work\application\build\software\34.o
 .bss.previous  0x00000000005b42c8       0x10 ${package_root}\build\out\work\application\build\software\34.o
 .bss.blur_since
                0x00000000005b42d8        0x8 ${package_root}\build\out\work\application\build\software\34.o
 .bss.stable_until
                0x00000000005b42e0        0x8 ${package_root}\build\out\work\application\build\software\34.o
 .bss.recovery_wait
                0x00000000005b42e8        0x4 ${package_root}\build\out\work\application\build\software\34.o
 .bss.recovery_seen
                0x00000000005b42ec        0x4 ${package_root}\build\out\work\application\build\software\34.o
 .bss.scene_stable
                0x00000000005b42f0        0x4 ${package_root}\build\out\work\application\build\software\34.o
 .bss.have_reference
                0x00000000005b42f4        0x4 ${package_root}\build\out\work\application\build\software\34.o
 .bss.have_scene
                0x00000000005b42f8        0x4 ${package_root}\build\out\work\application\build\software\34.o
 .bss.scene_reference
                0x00000000005b42fc       0x40 ${package_root}\build\out\work\application\build\software\34.o
 .bss.scene_previous
                0x00000000005b433c       0x40 ${package_root}\build\out\work\application\build\software\34.o
 .bss.scene     0x00000000005b437c       0x40 ${package_root}\build\out\work\application\build\software\34.o
 .bss.tile_count
                0x00000000005b43bc       0x40 ${package_root}\build\out\work\application\build\software\34.o
 .bss.tile_sum  0x00000000005b43fc       0x40 ${package_root}\build\out\work\application\build\software\34.o
 .bss.local_wide
                0x00000000005b443c        0x4 ${package_root}\build\out\work\application\build\software\34.o
 .bss.blur_frames
                0x00000000005b4440        0x4 ${package_root}\build\out\work\application\build\software\34.o
 .bss.locked_mean
                0x00000000005b4444        0x4 ${package_root}\build\out\work\application\build\software\34.o
 .bss.locked_quality
                0x00000000005b4448        0x4 ${package_root}\build\out\work\application\build\software\34.o
 .bss.accepted  0x00000000005b444c        0x4 ${package_root}\build\out\work\application\build\software\34.o
 .bss.local_request
                0x00000000005b4450        0x4 ${package_root}\build\out\work\application\build\software\34.o
 *fill*         0x00000000005b4454        0x4 
 .bss.baseline_sum
                0x00000000005b4458        0x8 ${package_root}\build\out\work\application\build\software\34.o
 .bss.baseline_sequence
                0x00000000005b4460        0x4 ${package_root}\build\out\work\application\build\software\34.o
 .bss.baseline_count
                0x00000000005b4464        0x4 ${package_root}\build\out\work\application\build\software\34.o
 .bss.settle_after
                0x00000000005b4468        0x8 ${package_root}\build\out\work\application\build\software\34.o
 .bss.last_end  0x00000000005b4470        0x8 ${package_root}\build\out\work\application\build\software\34.o
 .bss.deadline  0x00000000005b4478        0x8 ${package_root}\build\out\work\application\build\software\34.o
 .bss.measure_sum
                0x00000000005b4480        0x8 ${package_root}\build\out\work\application\build\software\34.o
 .bss.measure_count
                0x00000000005b4488        0x4 ${package_root}\build\out\work\application\build\software\34.o
 .bss.measure_sequence
                0x00000000005b448c        0x4 ${package_root}\build\out\work\application\build\software\34.o
 .bss.settle_sequence
                0x00000000005b4490        0x4 ${package_root}\build\out\work\application\build\software\34.o
 .bss.coarse_best
                0x00000000005b4494        0x4 ${package_root}\build\out\work\application\build\software\34.o
 .bss.index_    0x00000000005b4498        0x4 ${package_root}\build\out\work\application\build\software\34.o
 .bss.phase     0x00000000005b449c        0x4 ${package_root}\build\out\work\application\build\software\34.o
 .bss.baseline  0x00000000005b44a0        0x4 ${package_root}\build\out\work\application\build\software\34.o
 .bss.best_quality
                0x00000000005b44a4        0x4 ${package_root}\build\out\work\application\build\software\34.o
 .bss.best      0x00000000005b44a8        0x4 ${package_root}\build\out\work\application\build\software\34.o
 .bss.original  0x00000000005b44ac        0x4 ${package_root}\build\out\work\application\build\software\34.o
 .bss.own_sequence
                0x00000000005b44b0        0x4 ${package_root}\build\out\work\application\build\software\34.o
 .bss.suspended
                0x00000000005b44b4        0x4 ${package_root}\build\out\work\application\build\software\34.o
 .bss.owns      0x00000000005b44b8        0x4 ${package_root}\build\out\work\application\build\software\34.o
 .bss.state     0x00000000005b44bc        0x4 ${package_root}\build\out\work\application\build\software\34.o
 .bss.texture_valid
                0x00000000005b44c0        0x4 ${package_root}\build\out\work\application\build\software\34.o
 .bss.quality   0x00000000005b44c4        0x4 ${package_root}\build\out\work\application\build\software\34.o
 .bss.frame_seq
                0x00000000005b44c8        0x4 ${package_root}\build\out\work\application\build\software\34.o
 .bss.count     0x00000000005b44cc        0x4 ${package_root}\build\out\work\application\build\software\34.o
 .bss.energy    0x00000000005b44d0        0x8 ${package_root}\build\out\work\application\build\software\34.o
 .bss.sum2      0x00000000005b44d8        0x8 ${package_root}\build\out\work\application\build\software\34.o
 .bss.sum       0x00000000005b44e0        0x8 ${package_root}\build\out\work\application\build\software\34.o
 .bss.last_track_sequence
                0x00000000005b44e8        0x4 ${package_root}\build\out\work\application\build\software\34.o
 *fill*         0x00000000005b44ec        0x4 
 .bss.last_track_capture
                0x00000000005b44f0        0x8 ${package_root}\build\out\work\application\build\software\34.o
 .bss.scan_deadline
                0x00000000005b44f8        0x8 ${package_root}\build\out\work\application\build\software\34.o
 .bss.last_poll
                0x00000000005b4500        0x8 ${package_root}\build\out\work\application\build\software\34.o
 .bss.frame_stamp
                0x00000000005b4508        0x8 ${package_root}\build\out\work\application\build\software\34.o
 .bss.frame_valid
                0x00000000005b4510        0x4 ${package_root}\build\out\work\application\build\software\34.o
 .bss.frame_generation
                0x00000000005b4514        0x4 ${package_root}\build\out\work\application\build\software\34.o
 .bss.roi_generation
                0x00000000005b4518        0x4 ${package_root}\build\out\work\application\build\software\34.o
 .bss.board_focus_trace
                0x00000000005b451c      0x100 ${package_root}\build\out\work\application\build\software\34.o
                0x00000000005b451c                board_focus_trace
 .bss.board_focus_diag
                0x00000000005b461c       0x30 ${package_root}\build\out\work\application\build\software\34.o
                0x00000000005b461c                board_focus_diag
 *(.gnu.linkonce.b.*)
 *(COMMON)
 COMMON         0x00000000005b464c    0x7a9ff ${package_root}\build\out\work\platform\bsp_core0\lib\liblwip4.a(memp.o)
                0x00000000005b464c                memp_memory_ARP_QUEUE_base
                0x00000000005b4e0c                memp_memory_TCP_SEG_base
                0x00000000005b8e4c                memp_memory_PBUF_POOL_base
                0x0000000000628e8c                memp_memory_FRAG_PBUF_base
                0x000000000062cecc                memp_memory_PBUF_base
                0x000000000062d30c                memp_memory_TCP_PCB_LISTEN_base
                0x000000000062d54c                memp_memory_REASSDATA_base
                0x000000000062d6cc                memp_memory_UDP_PCB_base
                0x000000000062d80c                memp_memory_TCP_PCB_base
 *fill*         0x000000000062f04b        0x1 
 COMMON         0x000000000062f04c        0x8 ${package_root}\build\out\work\platform\bsp_core0\lib\liblwip4.a(netif.o)
                0x000000000062f04c                netif_list
                0x000000000062f050                netif_default
 COMMON         0x000000000062f054        0x1 ${package_root}\build\out\work\platform\bsp_core0\lib\liblwip4.a(pbuf.o)
                0x000000000062f054                pbuf_free_ooseq_pending
 *fill*         0x000000000062f055        0x3 
 COMMON         0x000000000062f058       0xe0 ${package_root}\build\out\work\platform\bsp_core0\lib\liblwip4.a(stats.o)
                0x000000000062f058                lwip_stats
 COMMON         0x000000000062f138       0x18 ${package_root}\build\out\work\platform\bsp_core0\lib\liblwip4.a(tcp.o)
                0x000000000062f138                tcp_active_pcbs_changed
                0x000000000062f13c                tcp_active_pcbs
                0x000000000062f140                tcp_ticks
                0x000000000062f144                tcp_listen_pcbs
                0x000000000062f148                tcp_bound_pcbs
                0x000000000062f14c                tcp_tw_pcbs
 COMMON         0x000000000062f150        0x4 ${package_root}\build\out\work\platform\bsp_core0\lib\liblwip4.a(tcp_in.o)
                0x000000000062f150                tcp_input_pcb
 COMMON         0x000000000062f154        0x4 ${package_root}\build\out\work\platform\bsp_core0\lib\liblwip4.a(udp.o)
                0x000000000062f154                udp_pcbs
 COMMON         0x000000000062f158        0x4 ${package_root}\build\out\work\platform\bsp_core0\lib\liblwip4.a(xadapter.o)
                0x000000000062f158                phyaddrforemac
 COMMON         0x000000000062f15c        0x8 ${package_root}\build\out\work\platform\bsp_core0\lib\liblwip4.a(xemacpsif.o)
                0x000000000062f15c                mac_config
                0x000000000062f160                NetIf
 *fill*         0x000000000062f164    0xd0e9c 
 COMMON         0x0000000000700000   0x100000 ${package_root}\build\out\work\platform\bsp_core0\lib\liblwip4.a(xemacpsif_dma.o)
                0x0000000000700000                bd_space
 COMMON         0x0000000000800000     0x8018 ${package_root}\build\out\work\platform\bsp_core0\lib\liblwip4.a(xpqueue.o)
                0x0000000000800000                pq_queue
 COMMON         0x0000000000808018       0x18 ${package_root}\build\out\work\platform\bsp_core0\lib\liblwip4.a(ip.o)
                0x0000000000808018                ip_data
 COMMON         0x0000000000808030        0x4 ${package_root}\build\out\work\platform\bsp_core0\lib\libxil.a(xil_assert.o)
                0x0000000000808030                Xil_AssertStatus
 COMMON         0x0000000000808034        0xc ${package_root}\build\out\work\platform\bsp_core0\lib\libxil.a(xil_exception.o)
                0x0000000000808034                UndefinedExceptionAddr
                0x0000000000808038                PrefetchAbortAddr
                0x000000000080803c                DataAbortAddr
                0x0000000000808040                __bss_end = .
                0x0000000000168010                _SDA_BASE_ = (__sdata_start + ((__sbss_end - __sdata_start) / 0x2))
                0x000000000016101b                _SDA2_BASE_ = (__sdata2_start + ((__sbss2_end - __sdata2_start) / 0x2))

.heap           0x0000000000808040   0x200000
                0x0000000000808040                . = ALIGN (0x10)
                0x0000000000808040                _heap = .
                0x0000000000808040                HeapBase = .
                0x0000000000808040                _heap_start = .
                0x0000000000a08040                . = (. + _HEAP_SIZE)
 *fill*         0x0000000000808040   0x200000 
                0x0000000000a08040                _heap_end = .
                0x0000000000a08040                HeapLimit = .

.stack          0x0000000000a08040    0x21800
                0x0000000000a08040                . = ALIGN (0x10)
                0x0000000000a08040                _stack_end = .
                0x0000000000a28040                . = (. + _STACK_SIZE)
 *fill*         0x0000000000a08040    0x20000 
                0x0000000000a28040                . = ALIGN (0x10)
                0x0000000000a28040                _stack = .
                0x0000000000a28040                __stack = _stack
                0x0000000000a28040                . = ALIGN (0x10)
                0x0000000000a28040                _irq_stack_end = .
                0x0000000000a28440                . = (. + _IRQ_STACK_SIZE)
 *fill*         0x0000000000a28040      0x400 
                0x0000000000a28440                . = ALIGN (0x10)
                0x0000000000a28440                __irq_stack = .
                0x0000000000a28440                _supervisor_stack_end = .
                0x0000000000a28c40                . = (. + _SUPERVISOR_STACK_SIZE)
 *fill*         0x0000000000a28440      0x800 
                0x0000000000a28c40                . = ALIGN (0x10)
                0x0000000000a28c40                __supervisor_stack = .
                0x0000000000a28c40                _abort_stack_end = .
                0x0000000000a29040                . = (. + _ABORT_STACK_SIZE)
 *fill*         0x0000000000a28c40      0x400 
                0x0000000000a29040                . = ALIGN (0x10)
                0x0000000000a29040                __abort_stack = .
                0x0000000000a29040                _fiq_stack_end = .
                0x0000000000a29440                . = (. + _FIQ_STACK_SIZE)
 *fill*         0x0000000000a29040      0x400 
                0x0000000000a29440                . = ALIGN (0x10)
                0x0000000000a29440                __fiq_stack = .
                0x0000000000a29440                _undef_stack_end = .
                0x0000000000a29840                . = (. + _UNDEF_STACK_SIZE)
 *fill*         0x0000000000a29440      0x400 
                0x0000000000a29840                . = ALIGN (0x10)
                0x0000000000a29840                __undef_stack = .
                0x0000000000a29840                _end = .
START GROUP
LOAD ${package_root}\build\out\work\platform\bsp_core0\lib\liblwip4.a
LOAD ${package_root}\build\out\work\platform\bsp_core0\lib\libxil.a
LOAD ${vitis_install}/gnu/aarch32/nt/gcc-arm-none-eabi/bin//../aarch32-xilinx-eabi/usr/lib/thumb/v7-a+fp/hard\libm.a
LOAD ${vitis_install}/gnu/aarch32/nt/gcc-arm-none-eabi/bin//../aarch32-xilinx-eabi/usr/lib/thumb/v7-a+fp/hard\libgcc.a
LOAD ${vitis_install}/gnu/aarch32/nt/gcc-arm-none-eabi/bin//../aarch32-xilinx-eabi/usr/lib/thumb/v7-a+fp/hard\libc.a
END GROUP
START GROUP
LOAD ${vitis_install}/gnu/aarch32/nt/gcc-arm-none-eabi/bin//../aarch32-xilinx-eabi/usr/lib/thumb/v7-a+fp/hard\libgcc.a
LOAD ${vitis_install}/gnu/aarch32/nt/gcc-arm-none-eabi/bin//../aarch32-xilinx-eabi/usr/lib/thumb/v7-a+fp/hard\libc.a
END GROUP
LOAD ${vitis_install}/gnu/aarch32/nt/gcc-arm-none-eabi/bin//../aarch32-xilinx-eabi/usr/lib/thumb/v7-a+fp/hard/crtend.o
LOAD ${vitis_install}/gnu/aarch32/nt/gcc-arm-none-eabi/bin//../aarch32-xilinx-eabi/usr/lib/thumb/v7-a+fp/hard/crtn.o
OUTPUT(${package_root}\build\out\work\application\build\software\core0_hdmi.elf elf32-littlearm)
LOAD linker stubs

.comment        0x0000000000000000       0x43
 .comment       0x0000000000000000       0x12 ${vitis_install}/gnu/aarch32/nt/gcc-arm-none-eabi/bin//../aarch32-xilinx-eabi/usr/lib/thumb/v7-a+fp/hard/crtbegin.o
                                         0x13 (size before relaxing)
 .comment       0x0000000000000012       0x13 ${package_root}\build\out\work\application\build\software\0.o
 .comment       0x0000000000000012       0x13 ${package_root}\build\out\work\application\build\software\1.o
 .comment       0x0000000000000012       0x13 ${package_root}\build\out\work\application\build\software\2.o
 .comment       0x0000000000000012       0x13 ${package_root}\build\out\work\application\build\software\3.o
 .comment       0x0000000000000012       0x13 ${package_root}\build\out\work\application\build\software\4.o
 .comment       0x0000000000000012       0x13 ${package_root}\build\out\work\application\build\software\5.o
 .comment       0x0000000000000012       0x13 ${package_root}\build\out\work\application\build\software\6.o
 .comment       0x0000000000000012       0x13 ${package_root}\build\out\work\application\build\software\7.o
 .comment       0x0000000000000012       0x13 ${package_root}\build\out\work\application\build\software\8.o
 .comment       0x0000000000000012       0x13 ${package_root}\build\out\work\application\build\software\9.o
 .comment       0x0000000000000012       0x13 ${package_root}\build\out\work\application\build\software\10.o
 .comment       0x0000000000000012       0x13 ${package_root}\build\out\work\application\build\software\11.o
 .comment       0x0000000000000012       0x13 ${package_root}\build\out\work\application\build\software\12.o
 .comment       0x0000000000000012       0x13 ${package_root}\build\out\work\application\build\software\13.o
 .comment       0x0000000000000012       0x13 ${package_root}\build\out\work\application\build\software\15.o
 .comment       0x0000000000000012       0x13 ${package_root}\build\out\work\application\build\software\16.o
 .comment       0x0000000000000012       0x13 ${package_root}\build\out\work\application\build\software\17.o
 .comment       0x0000000000000012       0x13 ${package_root}\build\out\work\application\build\software\18.o
 .comment       0x0000000000000012       0x13 ${package_root}\build\out\work\application\build\software\19.o
 .comment       0x0000000000000012       0x13 ${package_root}\build\out\work\application\build\software\20.o
 .comment       0x0000000000000012       0x13 ${package_root}\build\out\work\application\build\software\21.o
 .comment       0x0000000000000012       0x13 ${package_root}\build\out\work\application\build\software\22.o
 .comment       0x0000000000000012       0x13 ${package_root}\build\out\work\application\build\software\23.o
 .comment       0x0000000000000012       0x13 ${package_root}\build\out\work\application\build\software\24.o
 .comment       0x0000000000000012       0x13 ${package_root}\build\out\work\application\build\software\25.o
 .comment       0x0000000000000012       0x13 ${package_root}\build\out\work\application\build\software\26.o
 .comment       0x0000000000000012       0x13 ${package_root}\build\out\work\application\build\software\27.o
 .comment       0x0000000000000012       0x13 ${package_root}\build\out\work\application\build\software\28.o
 .comment       0x0000000000000012       0x13 ${package_root}\build\out\work\application\build\software\29.o
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
 .comment       0x0000000000000043       0x32 ${package_root}\build\out\work\platform\bsp_core0\lib\libxil.a(xaxivdma_g.o)
 .comment       0x0000000000000043       0x32 ${package_root}\build\out\work\platform\bsp_core0\lib\libxil.a(xgpio_g.o)
 .comment       0x0000000000000043       0x32 ${package_root}\build\out\work\platform\bsp_core0\lib\libxil.a(sleep.o)
 .comment       0x0000000000000043       0x32 ${package_root}\build\out\work\platform\bsp_core0\lib\libxil.a(usleep.o)
 .comment       0x0000000000000043       0x32 ${package_root}\build\out\work\platform\bsp_core0\lib\libxil.a(_exit.o)
 .comment       0x0000000000000043       0x32 ${package_root}\build\out\work\platform\bsp_core0\lib\libxil.a(_sbrk.o)
 .comment       0x0000000000000043       0x32 ${package_root}\build\out\work\platform\bsp_core0\lib\libxil.a(close.o)
 .comment       0x0000000000000043       0x32 ${package_root}\build\out\work\platform\bsp_core0\lib\libxil.a(fstat.o)
 .comment       0x0000000000000043       0x32 ${package_root}\build\out\work\platform\bsp_core0\lib\libxil.a(getpid.o)
 .comment       0x0000000000000043       0x32 ${package_root}\build\out\work\platform\bsp_core0\lib\libxil.a(isatty.o)
 .comment       0x0000000000000043       0x32 ${package_root}\build\out\work\platform\bsp_core0\lib\libxil.a(kill.o)
 .comment       0x0000000000000043       0x32 ${package_root}\build\out\work\platform\bsp_core0\lib\libxil.a(lseek.o)
 .comment       0x0000000000000043       0x32 ${package_root}\build\out\work\platform\bsp_core0\lib\libxil.a(read.o)
 .comment       0x0000000000000043       0x32 ${package_root}\build\out\work\platform\bsp_core0\lib\libxil.a(write.o)
 .comment       0x0000000000000043       0x32 ${package_root}\build\out\work\platform\bsp_core0\lib\libxil.a(inbyte.o)
 .comment       0x0000000000000043       0x13 ${vitis_install}/gnu/aarch32/nt/gcc-arm-none-eabi/bin//../aarch32-xilinx-eabi/usr/lib/thumb/v7-a+fp/hard/crtend.o
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
