Ji-Shawn/Bird-detection-classification-tracking/build/receipts/arm_rebuild_20261103/core1_link_map.txt

Archive member included to satisfy reference by file (symbol)

${package_root}\build\out\work\platform\bsp_core1\lib\libxil.a(asm_vectors.o)
                              (_vector_table)
${package_root}\build\out\work\platform\bsp_core1\lib\libxil.a(boot.o)
                              ${package_root}\build\out\work\platform\bsp_core1\lib\libxil.a(asm_vectors.o) (_boot)
${package_root}\build\out\work\platform\bsp_core1\lib\libxil.a(outbyte.o)
                              ${package_root}\build\out\work\services\core1\build\18_xil_printf.o (outbyte)
${package_root}\build\out\work\platform\bsp_core1\lib\libxil.a(translation_table.o)
                              ${package_root}\build\out\work\platform\bsp_core1\lib\libxil.a(boot.o) (MMUTable)
${package_root}\build\out\work\platform\bsp_core1\lib\libxil.a(vectors.o)
                              ${package_root}\build\out\work\platform\bsp_core1\lib\libxil.a(asm_vectors.o) (FIQInterrupt)
${package_root}\build\out\work\platform\bsp_core1\lib\libxil.a(xil-crt0.o)
                              ${package_root}\build\out\work\platform\bsp_core1\lib\libxil.a(boot.o) (_start)
${package_root}\build\out\work\platform\bsp_core1\lib\libxil.a(xil_assert.o)
                              ${package_root}\build\out\work\services\core1\build\25_xsdps.o (Xil_Assert)
${package_root}\build\out\work\platform\bsp_core1\lib\libxil.a(xil_cache.o)
                              ${package_root}\build\out\work\services\core1\build\13_platform_port.o (Xil_DCacheInvalidateRange)
${package_root}\build\out\work\platform\bsp_core1\lib\libxil.a(xil_exception.o)
                              ${package_root}\build\out\work\platform\bsp_core1\lib\libxil.a(asm_vectors.o) (UndefinedExceptionAddr)
${package_root}\build\out\work\platform\bsp_core1\lib\libxil.a(xil_mmu.o)
                              ${package_root}\build\out\work\services\core1\build\9_main.o (Xil_SetTlbAttributes)
${package_root}\build\out\work\platform\bsp_core1\lib\libxil.a(xtime_l.o)
                              ${package_root}\build\out\work\services\core1\build\13_platform_port.o (XTime_GetTime)
${package_root}\build\out\work\platform\bsp_core1\lib\libxil.a(xuartps_hw.o)
                              ${package_root}\build\out\work\platform\bsp_core1\lib\libxil.a(outbyte.o) (XUartPs_SendByte)
${package_root}\build\out\work\platform\bsp_core1\lib\libxil.a(cpu_init.o)
                              ${package_root}\build\out\work\platform\bsp_core1\lib\libxil.a(xil-crt0.o) (__cpu_init)
${vitis_install}/gnu/aarch32/nt/gcc-arm-none-eabi/bin//../aarch32-xilinx-eabi/usr/lib/thumb/v7-a+fp/hard\libm.a(lib_a-cosf.o)
                              ${package_root}\build\out\work\services\core1\build\4_audio_worker.o (cosf)
${vitis_install}/gnu/aarch32/nt/gcc-arm-none-eabi/bin//../aarch32-xilinx-eabi/usr/lib/thumb/v7-a+fp/hard\libm.a(lib_a-math_errf.o)
                              ${vitis_install}/gnu/aarch32/nt/gcc-arm-none-eabi/bin//../aarch32-xilinx-eabi/usr/lib/thumb/v7-a+fp/hard\libm.a(lib_a-cosf.o) (__math_invalidf)
${vitis_install}/gnu/aarch32/nt/gcc-arm-none-eabi/bin//../aarch32-xilinx-eabi/usr/lib/thumb/v7-a+fp/hard\libm.a(lib_a-sf_ceil.o)
                              ${package_root}\build\out\work\services\core1\build\16_fusion_math.o (ceilf)
${vitis_install}/gnu/aarch32/nt/gcc-arm-none-eabi/bin//../aarch32-xilinx-eabi/usr/lib/thumb/v7-a+fp/hard\libm.a(lib_a-sf_exp.o)
                              ${package_root}\build\out\work\services\core1\build\15_tdoa_solver.o (expf)
${vitis_install}/gnu/aarch32/nt/gcc-arm-none-eabi/bin//../aarch32-xilinx-eabi/usr/lib/thumb/v7-a+fp/hard\libm.a(lib_a-sf_floor.o)
                              ${package_root}\build\out\work\services\core1\build\16_fusion_math.o (floorf)
${vitis_install}/gnu/aarch32/nt/gcc-arm-none-eabi/bin//../aarch32-xilinx-eabi/usr/lib/thumb/v7-a+fp/hard\libm.a(lib_a-sf_fmax.o)
                              ${package_root}\build\out\work\services\core1\build\16_fusion_math.o (fmaxf)
${vitis_install}/gnu/aarch32/nt/gcc-arm-none-eabi/bin//../aarch32-xilinx-eabi/usr/lib/thumb/v7-a+fp/hard\libm.a(lib_a-sf_fmin.o)
                              ${package_root}\build\out\work\services\core1\build\16_fusion_math.o (fminf)
${vitis_install}/gnu/aarch32/nt/gcc-arm-none-eabi/bin//../aarch32-xilinx-eabi/usr/lib/thumb/v7-a+fp/hard\libm.a(lib_a-sf_fpclassify.o)
                              ${vitis_install}/gnu/aarch32/nt/gcc-arm-none-eabi/bin//../aarch32-xilinx-eabi/usr/lib/thumb/v7-a+fp/hard\libm.a(lib_a-sf_fmax.o) (__fpclassifyf)
${vitis_install}/gnu/aarch32/nt/gcc-arm-none-eabi/bin//../aarch32-xilinx-eabi/usr/lib/thumb/v7-a+fp/hard\libm.a(lib_a-sf_lrint.o)
                              ${package_root}\build\out\work\services\core1\build\7_fft_q15.o (lrintf)
${vitis_install}/gnu/aarch32/nt/gcc-arm-none-eabi/bin//../aarch32-xilinx-eabi/usr/lib/thumb/v7-a+fp/hard\libm.a(lib_a-sincosf_data.o)
                              ${vitis_install}/gnu/aarch32/nt/gcc-arm-none-eabi/bin//../aarch32-xilinx-eabi/usr/lib/thumb/v7-a+fp/hard\libm.a(lib_a-cosf.o) (__inv_pio4)
${vitis_install}/gnu/aarch32/nt/gcc-arm-none-eabi/bin//../aarch32-xilinx-eabi/usr/lib/thumb/v7-a+fp/hard\libm.a(lib_a-sinf.o)
                              ${package_root}\build\out\work\services\core1\build\4_audio_worker.o (sinf)
${vitis_install}/gnu/aarch32/nt/gcc-arm-none-eabi/bin//../aarch32-xilinx-eabi/usr/lib/thumb/v7-a+fp/hard\libm.a(lib_a-wf_atan2.o)
                              ${package_root}\build\out\work\services\core1\build\15_tdoa_solver.o (atan2f)
${vitis_install}/gnu/aarch32/nt/gcc-arm-none-eabi/bin//../aarch32-xilinx-eabi/usr/lib/thumb/v7-a+fp/hard\libm.a(lib_a-wf_log10.o)
                              ${package_root}\build\out\work\services\core1\build\19_model_logmel32_pl.o (log10f)
${vitis_install}/gnu/aarch32/nt/gcc-arm-none-eabi/bin//../aarch32-xilinx-eabi/usr/lib/thumb/v7-a+fp/hard\libm.a(lib_a-wf_sqrt.o)
                              ${package_root}\build\out\work\services\core1\build\15_tdoa_solver.o (sqrtf)
${vitis_install}/gnu/aarch32/nt/gcc-arm-none-eabi/bin//../aarch32-xilinx-eabi/usr/lib/thumb/v7-a+fp/hard\libm.a(lib_a-w_sqrt.o)
                              ${package_root}\build\out\work\services\core1\build\3_audio_quality.o (sqrt)
${vitis_install}/gnu/aarch32/nt/gcc-arm-none-eabi/bin//../aarch32-xilinx-eabi/usr/lib/thumb/v7-a+fp/hard\libm.a(lib_a-ef_atan2.o)
                              ${vitis_install}/gnu/aarch32/nt/gcc-arm-none-eabi/bin//../aarch32-xilinx-eabi/usr/lib/thumb/v7-a+fp/hard\libm.a(lib_a-wf_atan2.o) (__ieee754_atan2f)
${vitis_install}/gnu/aarch32/nt/gcc-arm-none-eabi/bin//../aarch32-xilinx-eabi/usr/lib/thumb/v7-a+fp/hard\libm.a(lib_a-ef_log10.o)
                              ${vitis_install}/gnu/aarch32/nt/gcc-arm-none-eabi/bin//../aarch32-xilinx-eabi/usr/lib/thumb/v7-a+fp/hard\libm.a(lib_a-wf_log10.o) (__ieee754_log10f)
${vitis_install}/gnu/aarch32/nt/gcc-arm-none-eabi/bin//../aarch32-xilinx-eabi/usr/lib/thumb/v7-a+fp/hard\libm.a(lib_a-ef_sqrt.o)
                              ${vitis_install}/gnu/aarch32/nt/gcc-arm-none-eabi/bin//../aarch32-xilinx-eabi/usr/lib/thumb/v7-a+fp/hard\libm.a(lib_a-wf_sqrt.o) (__ieee754_sqrtf)
${vitis_install}/gnu/aarch32/nt/gcc-arm-none-eabi/bin//../aarch32-xilinx-eabi/usr/lib/thumb/v7-a+fp/hard\libm.a(lib_a-e_sqrt.o)
                              ${vitis_install}/gnu/aarch32/nt/gcc-arm-none-eabi/bin//../aarch32-xilinx-eabi/usr/lib/thumb/v7-a+fp/hard\libm.a(lib_a-w_sqrt.o) (__ieee754_sqrt)
${vitis_install}/gnu/aarch32/nt/gcc-arm-none-eabi/bin//../aarch32-xilinx-eabi/usr/lib/thumb/v7-a+fp/hard\libm.a(lib_a-sf_atan.o)
                              ${vitis_install}/gnu/aarch32/nt/gcc-arm-none-eabi/bin//../aarch32-xilinx-eabi/usr/lib/thumb/v7-a+fp/hard\libm.a(lib_a-ef_atan2.o) (atanf)
${vitis_install}/gnu/aarch32/nt/gcc-arm-none-eabi/bin//../aarch32-xilinx-eabi/usr/lib/thumb/v7-a+fp/hard\libm.a(lib_a-sf_exp2_data.o)
                              ${vitis_install}/gnu/aarch32/nt/gcc-arm-none-eabi/bin//../aarch32-xilinx-eabi/usr/lib/thumb/v7-a+fp/hard\libm.a(lib_a-sf_exp.o) (__exp2f_data)
${vitis_install}/gnu/aarch32/nt/gcc-arm-none-eabi/bin//../aarch32-xilinx-eabi/usr/lib/thumb/v7-a+fp/hard\libm.a(lib_a-sf_fabs.o)
                              ${vitis_install}/gnu/aarch32/nt/gcc-arm-none-eabi/bin//../aarch32-xilinx-eabi/usr/lib/thumb/v7-a+fp/hard\libm.a(lib_a-ef_atan2.o) (fabsf)
${vitis_install}/gnu/aarch32/nt/gcc-arm-none-eabi/bin//../aarch32-xilinx-eabi/usr/lib/thumb/v7-a+fp/hard\libm.a(lib_a-sf_log.o)
                              ${vitis_install}/gnu/aarch32/nt/gcc-arm-none-eabi/bin//../aarch32-xilinx-eabi/usr/lib/thumb/v7-a+fp/hard\libm.a(lib_a-ef_log10.o) (logf)
${vitis_install}/gnu/aarch32/nt/gcc-arm-none-eabi/bin//../aarch32-xilinx-eabi/usr/lib/thumb/v7-a+fp/hard\libm.a(lib_a-sf_nan.o)
                              ${vitis_install}/gnu/aarch32/nt/gcc-arm-none-eabi/bin//../aarch32-xilinx-eabi/usr/lib/thumb/v7-a+fp/hard\libm.a(lib_a-wf_log10.o) (nanf)
${vitis_install}/gnu/aarch32/nt/gcc-arm-none-eabi/bin//../aarch32-xilinx-eabi/usr/lib/thumb/v7-a+fp/hard\libm.a(lib_a-sf_log_data.o)
                              ${vitis_install}/gnu/aarch32/nt/gcc-arm-none-eabi/bin//../aarch32-xilinx-eabi/usr/lib/thumb/v7-a+fp/hard\libm.a(lib_a-sf_log.o) (__logf_data)
${vitis_install}/gnu/aarch32/nt/gcc-arm-none-eabi/bin//../aarch32-xilinx-eabi/usr/lib/thumb/v7-a+fp/hard\libgcc.a(_udivsi3.o)
                              ${package_root}\build\out\work\services\core1\build\4_audio_worker.o (__aeabi_uidiv)
${vitis_install}/gnu/aarch32/nt/gcc-arm-none-eabi/bin//../aarch32-xilinx-eabi/usr/lib/thumb/v7-a+fp/hard\libgcc.a(_divsi3.o)
                              ${package_root}\build\out\work\services\core1\build\7_fft_q15.o (__aeabi_idiv)
${vitis_install}/gnu/aarch32/nt/gcc-arm-none-eabi/bin//../aarch32-xilinx-eabi/usr/lib/thumb/v7-a+fp/hard\libgcc.a(_dvmd_tls.o)
                              ${vitis_install}/gnu/aarch32/nt/gcc-arm-none-eabi/bin//../aarch32-xilinx-eabi/usr/lib/thumb/v7-a+fp/hard\libgcc.a(_udivsi3.o) (__aeabi_idiv0)
${vitis_install}/gnu/aarch32/nt/gcc-arm-none-eabi/bin//../aarch32-xilinx-eabi/usr/lib/thumb/v7-a+fp/hard\libgcc.a(_arm_addsubdf3.o)
                              ${package_root}\build\out\work\services\core1\build\3_audio_quality.o (__aeabi_l2d)
${vitis_install}/gnu/aarch32/nt/gcc-arm-none-eabi/bin//../aarch32-xilinx-eabi/usr/lib/thumb/v7-a+fp/hard\libgcc.a(_arm_addsubsf3.o)
                              ${package_root}\build\out\work\services\core1\build\4_audio_worker.o (__aeabi_ul2f)
${vitis_install}/gnu/aarch32/nt/gcc-arm-none-eabi/bin//../aarch32-xilinx-eabi/usr/lib/thumb/v7-a+fp/hard\libgcc.a(_aeabi_ldivmod.o)
                              ${package_root}\build\out\work\services\core1\build\4_audio_worker.o (__aeabi_ldivmod)
${vitis_install}/gnu/aarch32/nt/gcc-arm-none-eabi/bin//../aarch32-xilinx-eabi/usr/lib/thumb/v7-a+fp/hard\libgcc.a(_aeabi_uldivmod.o)
                              ${package_root}\build\out\work\services\core1\build\4_audio_worker.o (__aeabi_uldivmod)
${vitis_install}/gnu/aarch32/nt/gcc-arm-none-eabi/bin//../aarch32-xilinx-eabi/usr/lib/thumb/v7-a+fp/hard\libgcc.a(_udivmoddi4.o)
                              ${vitis_install}/gnu/aarch32/nt/gcc-arm-none-eabi/bin//../aarch32-xilinx-eabi/usr/lib/thumb/v7-a+fp/hard\libgcc.a(_aeabi_ldivmod.o) (__udivmoddi4)
${vitis_install}/gnu/aarch32/nt/gcc-arm-none-eabi/bin//../aarch32-xilinx-eabi/usr/lib/thumb/v7-a+fp/hard\libc.a(lib_a-ctype_.o)
                              ${package_root}\build\out\work\services\core1\build\18_xil_printf.o (_ctype_)
${vitis_install}/gnu/aarch32/nt/gcc-arm-none-eabi/bin//../aarch32-xilinx-eabi/usr/lib/thumb/v7-a+fp/hard\libc.a(lib_a-errno.o)
                              ${vitis_install}/gnu/aarch32/nt/gcc-arm-none-eabi/bin//../aarch32-xilinx-eabi/usr/lib/thumb/v7-a+fp/hard\libm.a(lib_a-math_errf.o) (__errno)
${vitis_install}/gnu/aarch32/nt/gcc-arm-none-eabi/bin//../aarch32-xilinx-eabi/usr/lib/thumb/v7-a+fp/hard\libc.a(lib_a-exit.o)
                              ${package_root}\build\out\work\platform\bsp_core1\lib\libxil.a(xil-crt0.o) (exit)
${vitis_install}/gnu/aarch32/nt/gcc-arm-none-eabi/bin//../aarch32-xilinx-eabi/usr/lib/thumb/v7-a+fp/hard\libc.a(lib_a-fini.o)
                              ${package_root}\build\out\work\platform\bsp_core1\lib\libxil.a(xil-crt0.o) (__libc_fini_array)
${vitis_install}/gnu/aarch32/nt/gcc-arm-none-eabi/bin//../aarch32-xilinx-eabi/usr/lib/thumb/v7-a+fp/hard\libc.a(lib_a-impure.o)
                              ${vitis_install}/gnu/aarch32/nt/gcc-arm-none-eabi/bin//../aarch32-xilinx-eabi/usr/lib/thumb/v7-a+fp/hard\libc.a(lib_a-exit.o) (_global_impure_ptr)
${vitis_install}/gnu/aarch32/nt/gcc-arm-none-eabi/bin//../aarch32-xilinx-eabi/usr/lib/thumb/v7-a+fp/hard\libc.a(lib_a-init.o)
                              ${package_root}\build\out\work\platform\bsp_core1\lib\libxil.a(xil-crt0.o) (__libc_init_array)
${vitis_install}/gnu/aarch32/nt/gcc-arm-none-eabi/bin//../aarch32-xilinx-eabi/usr/lib/thumb/v7-a+fp/hard\libc.a(lib_a-malloc.o)
                              ${package_root}\build\out\work\services\core1\build\16_fusion_math.o (malloc)
${vitis_install}/gnu/aarch32/nt/gcc-arm-none-eabi/bin//../aarch32-xilinx-eabi/usr/lib/thumb/v7-a+fp/hard\libc.a(lib_a-mallocr.o)
                              ${vitis_install}/gnu/aarch32/nt/gcc-arm-none-eabi/bin//../aarch32-xilinx-eabi/usr/lib/thumb/v7-a+fp/hard\libc.a(lib_a-malloc.o) (_malloc_r)
${vitis_install}/gnu/aarch32/nt/gcc-arm-none-eabi/bin//../aarch32-xilinx-eabi/usr/lib/thumb/v7-a+fp/hard\libc.a(lib_a-memcmp.o)
                              ${package_root}\build\out\work\services\core1\build\23_ff.o (memcmp)
${vitis_install}/gnu/aarch32/nt/gcc-arm-none-eabi/bin//../aarch32-xilinx-eabi/usr/lib/thumb/v7-a+fp/hard\libc.a(lib_a-memcpy.o)
                              ${package_root}\build\out\work\services\core1\build\0_audio_eth_adapter.o (memcpy)
${vitis_install}/gnu/aarch32/nt/gcc-arm-none-eabi/bin//../aarch32-xilinx-eabi/usr/lib/thumb/v7-a+fp/hard\libc.a(lib_a-memmove.o)
                              ${package_root}\build\out\work\services\core1\build\4_audio_worker.o (memmove)
${vitis_install}/gnu/aarch32/nt/gcc-arm-none-eabi/bin//../aarch32-xilinx-eabi/usr/lib/thumb/v7-a+fp/hard\libc.a(lib_a-memset.o)
                              ${package_root}\build\out\work\services\core1\build\0_audio_eth_adapter.o (memset)
${vitis_install}/gnu/aarch32/nt/gcc-arm-none-eabi/bin//../aarch32-xilinx-eabi/usr/lib/thumb/v7-a+fp/hard\libc.a(lib_a-mlock.o)
                              ${vitis_install}/gnu/aarch32/nt/gcc-arm-none-eabi/bin//../aarch32-xilinx-eabi/usr/lib/thumb/v7-a+fp/hard\libc.a(lib_a-mallocr.o) (__malloc_lock)
${vitis_install}/gnu/aarch32/nt/gcc-arm-none-eabi/bin//../aarch32-xilinx-eabi/usr/lib/thumb/v7-a+fp/hard\libc.a(lib_a-sbrkr.o)
                              ${vitis_install}/gnu/aarch32/nt/gcc-arm-none-eabi/bin//../aarch32-xilinx-eabi/usr/lib/thumb/v7-a+fp/hard\libc.a(lib_a-mallocr.o) (_sbrk_r)
${vitis_install}/gnu/aarch32/nt/gcc-arm-none-eabi/bin//../aarch32-xilinx-eabi/usr/lib/thumb/v7-a+fp/hard\libc.a(lib_a-snprintf.o)
                              ${package_root}\build\out\work\services\core1\build\21_sd_writer.o (snprintf)
${vitis_install}/gnu/aarch32/nt/gcc-arm-none-eabi/bin//../aarch32-xilinx-eabi/usr/lib/thumb/v7-a+fp/hard\libc.a(lib_a-strchr.o)
                              ${package_root}\build\out\work\services\core1\build\23_ff.o (strchr)
${vitis_install}/gnu/aarch32/nt/gcc-arm-none-eabi/bin//../aarch32-xilinx-eabi/usr/lib/thumb/v7-a+fp/hard\libc.a(lib_a-strcmp.o)
                              ${package_root}\build\out\work\services\core1\build\21_sd_writer.o (strcmp)
${vitis_install}/gnu/aarch32/nt/gcc-arm-none-eabi/bin//../aarch32-xilinx-eabi/usr/lib/thumb/v7-a+fp/hard\libc.a(lib_a-strlen.o)
                              ${package_root}\build\out\work\services\core1\build\18_xil_printf.o (strlen)
${vitis_install}/gnu/aarch32/nt/gcc-arm-none-eabi/bin//../aarch32-xilinx-eabi/usr/lib/thumb/v7-a+fp/hard\libc.a(lib_a-svfprintf.o)
                              ${vitis_install}/gnu/aarch32/nt/gcc-arm-none-eabi/bin//../aarch32-xilinx-eabi/usr/lib/thumb/v7-a+fp/hard\libc.a(lib_a-snprintf.o) (_svfprintf_r)
${vitis_install}/gnu/aarch32/nt/gcc-arm-none-eabi/bin//../aarch32-xilinx-eabi/usr/lib/thumb/v7-a+fp/hard\libc.a(lib_a-__call_atexit.o)
                              ${vitis_install}/gnu/aarch32/nt/gcc-arm-none-eabi/bin//../aarch32-xilinx-eabi/usr/lib/thumb/v7-a+fp/hard\libc.a(lib_a-exit.o) (__call_exitprocs)
${vitis_install}/gnu/aarch32/nt/gcc-arm-none-eabi/bin//../aarch32-xilinx-eabi/usr/lib/thumb/v7-a+fp/hard\libc.a(lib_a-dtoa.o)
                              ${vitis_install}/gnu/aarch32/nt/gcc-arm-none-eabi/bin//../aarch32-xilinx-eabi/usr/lib/thumb/v7-a+fp/hard\libc.a(lib_a-svfprintf.o) (_dtoa_r)
${vitis_install}/gnu/aarch32/nt/gcc-arm-none-eabi/bin//../aarch32-xilinx-eabi/usr/lib/thumb/v7-a+fp/hard\libc.a(lib_a-freer.o)
                              ${vitis_install}/gnu/aarch32/nt/gcc-arm-none-eabi/bin//../aarch32-xilinx-eabi/usr/lib/thumb/v7-a+fp/hard\libc.a(lib_a-malloc.o) (_free_r)
${vitis_install}/gnu/aarch32/nt/gcc-arm-none-eabi/bin//../aarch32-xilinx-eabi/usr/lib/thumb/v7-a+fp/hard\libc.a(lib_a-localeconv.o)
                              ${vitis_install}/gnu/aarch32/nt/gcc-arm-none-eabi/bin//../aarch32-xilinx-eabi/usr/lib/thumb/v7-a+fp/hard\libc.a(lib_a-svfprintf.o) (_localeconv_r)
${vitis_install}/gnu/aarch32/nt/gcc-arm-none-eabi/bin//../aarch32-xilinx-eabi/usr/lib/thumb/v7-a+fp/hard\libc.a(lib_a-locale.o)
                              ${vitis_install}/gnu/aarch32/nt/gcc-arm-none-eabi/bin//../aarch32-xilinx-eabi/usr/lib/thumb/v7-a+fp/hard\libc.a(lib_a-localeconv.o) (__global_locale)
${vitis_install}/gnu/aarch32/nt/gcc-arm-none-eabi/bin//../aarch32-xilinx-eabi/usr/lib/thumb/v7-a+fp/hard\libc.a(lib_a-mbtowc_r.o)
                              ${vitis_install}/gnu/aarch32/nt/gcc-arm-none-eabi/bin//../aarch32-xilinx-eabi/usr/lib/thumb/v7-a+fp/hard\libc.a(lib_a-locale.o) (__ascii_mbtowc)
${vitis_install}/gnu/aarch32/nt/gcc-arm-none-eabi/bin//../aarch32-xilinx-eabi/usr/lib/thumb/v7-a+fp/hard\libc.a(lib_a-memchr.o)
                              ${vitis_install}/gnu/aarch32/nt/gcc-arm-none-eabi/bin//../aarch32-xilinx-eabi/usr/lib/thumb/v7-a+fp/hard\libc.a(lib_a-svfprintf.o) (memchr)
${vitis_install}/gnu/aarch32/nt/gcc-arm-none-eabi/bin//../aarch32-xilinx-eabi/usr/lib/thumb/v7-a+fp/hard\libc.a(lib_a-mprec.o)
                              ${vitis_install}/gnu/aarch32/nt/gcc-arm-none-eabi/bin//../aarch32-xilinx-eabi/usr/lib/thumb/v7-a+fp/hard\libc.a(lib_a-dtoa.o) (_Balloc)
${vitis_install}/gnu/aarch32/nt/gcc-arm-none-eabi/bin//../aarch32-xilinx-eabi/usr/lib/thumb/v7-a+fp/hard\libc.a(lib_a-reent.o)
                              ${vitis_install}/gnu/aarch32/nt/gcc-arm-none-eabi/bin//../aarch32-xilinx-eabi/usr/lib/thumb/v7-a+fp/hard\libc.a(lib_a-sbrkr.o) (errno)
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
                              ${vitis_install}/gnu/aarch32/nt/gcc-arm-none-eabi/bin//../aarch32-xilinx-eabi/usr/lib/thumb/v7-a+fp/hard\libc.a(lib_a-isattyr.o) (_isatty)
${package_root}\build\out\work\platform\bsp_core1\lib\libxil.a(kill.o)
                              ${vitis_install}/gnu/aarch32/nt/gcc-arm-none-eabi/bin//../aarch32-xilinx-eabi/usr/lib/thumb/v7-a+fp/hard\libc.a(lib_a-signalr.o) (_kill)
${package_root}\build\out\work\platform\bsp_core1\lib\libxil.a(lseek.o)
                              ${vitis_install}/gnu/aarch32/nt/gcc-arm-none-eabi/bin//../aarch32-xilinx-eabi/usr/lib/thumb/v7-a+fp/hard\libc.a(lib_a-lseekr.o) (_lseek)
${package_root}\build\out\work\platform\bsp_core1\lib\libxil.a(read.o)
                              ${vitis_install}/gnu/aarch32/nt/gcc-arm-none-eabi/bin//../aarch32-xilinx-eabi/usr/lib/thumb/v7-a+fp/hard\libc.a(lib_a-readr.o) (_read)
${package_root}\build\out\work\platform\bsp_core1\lib\libxil.a(write.o)
                              ${vitis_install}/gnu/aarch32/nt/gcc-arm-none-eabi/bin//../aarch32-xilinx-eabi/usr/lib/thumb/v7-a+fp/hard\libc.a(lib_a-writer.o) (_write)
${package_root}\build\out\work\platform\bsp_core1\lib\libxil.a(inbyte.o)
                              ${package_root}\build\out\work\platform\bsp_core1\lib\libxil.a(read.o) (inbyte)

Allocating common symbols
Common symbol       size              file

UndefinedExceptionAddr
                    0x4               ${package_root}\build\out\work\platform\bsp_core1\lib\libxil.a(xil_exception.o)
PrefetchAbortAddr   0x4               ${package_root}\build\out\work\platform\bsp_core1\lib\libxil.a(xil_exception.o)
DataAbortAddr       0x4               ${package_root}\build\out\work\platform\bsp_core1\lib\libxil.a(xil_exception.o)
Xil_AssertStatus    0x4               ${package_root}\build\out\work\platform\bsp_core1\lib\libxil.a(xil_assert.o)

Discarded input sections

 .text          0x0000000000000000        0x0 ${vitis_install}/gnu/aarch32/nt/gcc-arm-none-eabi/bin//../aarch32-xilinx-eabi/usr/lib/thumb/v7-a+fp/hard/crti.o
 .data          0x0000000000000000        0x0 ${vitis_install}/gnu/aarch32/nt/gcc-arm-none-eabi/bin//../aarch32-xilinx-eabi/usr/lib/thumb/v7-a+fp/hard/crti.o
 .bss           0x0000000000000000        0x0 ${vitis_install}/gnu/aarch32/nt/gcc-arm-none-eabi/bin//../aarch32-xilinx-eabi/usr/lib/thumb/v7-a+fp/hard/crti.o
 .data          0x0000000000000000        0x4 ${vitis_install}/gnu/aarch32/nt/gcc-arm-none-eabi/bin//../aarch32-xilinx-eabi/usr/lib/thumb/v7-a+fp/hard/crtbegin.o
 .rodata        0x0000000000000000       0x24 ${vitis_install}/gnu/aarch32/nt/gcc-arm-none-eabi/bin//../aarch32-xilinx-eabi/usr/lib/thumb/v7-a+fp/hard/crtbegin.o
 .text          0x0000000000000000        0x0 ${package_root}\build\out\work\services\core1\build\0_audio_eth_adapter.o
 .data          0x0000000000000000        0x0 ${package_root}\build\out\work\services\core1\build\0_audio_eth_adapter.o
 .bss           0x0000000000000000        0x0 ${package_root}\build\out\work\services\core1\build\0_audio_eth_adapter.o
 .text          0x0000000000000000        0x0 ${package_root}\build\out\work\services\core1\build\1_audio_health.o
 .data          0x0000000000000000        0x0 ${package_root}\build\out\work\services\core1\build\1_audio_health.o
 .bss           0x0000000000000000        0x0 ${package_root}\build\out\work\services\core1\build\1_audio_health.o
 .text          0x0000000000000000        0x0 ${package_root}\build\out\work\services\core1\build\2_audio_model_input.o
 .data          0x0000000000000000        0x0 ${package_root}\build\out\work\services\core1\build\2_audio_model_input.o
 .bss           0x0000000000000000        0x0 ${package_root}\build\out\work\services\core1\build\2_audio_model_input.o
 .text.audio_model_tensor_acquire
                0x0000000000000000      0x154 ${package_root}\build\out\work\services\core1\build\2_audio_model_input.o
 .text          0x0000000000000000        0x0 ${package_root}\build\out\work\services\core1\build\3_audio_quality.o
 .data          0x0000000000000000        0x0 ${package_root}\build\out\work\services\core1\build\3_audio_quality.o
 .bss           0x0000000000000000        0x0 ${package_root}\build\out\work\services\core1\build\3_audio_quality.o
 .text          0x0000000000000000        0x0 ${package_root}\build\out\work\services\core1\build\4_audio_worker.o
 .data          0x0000000000000000        0x0 ${package_root}\build\out\work\services\core1\build\4_audio_worker.o
 .bss           0x0000000000000000        0x0 ${package_root}\build\out\work\services\core1\build\4_audio_worker.o
 .text          0x0000000000000000        0x0 ${package_root}\build\out\work\services\core1\build\5_beamform.o
 .data          0x0000000000000000        0x0 ${package_root}\build\out\work\services\core1\build\5_beamform.o
 .bss           0x0000000000000000        0x0 ${package_root}\build\out\work\services\core1\build\5_beamform.o
 .text          0x0000000000000000        0x0 ${package_root}\build\out\work\services\core1\build\6_bird_frontend.o
 .data          0x0000000000000000        0x0 ${package_root}\build\out\work\services\core1\build\6_bird_frontend.o
 .bss           0x0000000000000000        0x0 ${package_root}\build\out\work\services\core1\build\6_bird_frontend.o
 .text          0x0000000000000000        0x0 ${package_root}\build\out\work\services\core1\build\7_fft_q15.o
 .data          0x0000000000000000        0x0 ${package_root}\build\out\work\services\core1\build\7_fft_q15.o
 .bss           0x0000000000000000        0x0 ${package_root}\build\out\work\services\core1\build\7_fft_q15.o
 .text          0x0000000000000000        0x0 ${package_root}\build\out\work\services\core1\build\8_gcc_phat.o
 .data          0x0000000000000000        0x0 ${package_root}\build\out\work\services\core1\build\8_gcc_phat.o
 .bss           0x0000000000000000        0x0 ${package_root}\build\out\work\services\core1\build\8_gcc_phat.o
 .text          0x0000000000000000        0x0 ${package_root}\build\out\work\services\core1\build\9_main.o
 .data          0x0000000000000000        0x0 ${package_root}\build\out\work\services\core1\build\9_main.o
 .bss           0x0000000000000000        0x0 ${package_root}\build\out\work\services\core1\build\9_main.o
 .text          0x0000000000000000        0x0 ${package_root}\build\out\work\services\core1\build\10_mel128.o
 .data          0x0000000000000000        0x0 ${package_root}\build\out\work\services\core1\build\10_mel128.o
 .bss           0x0000000000000000        0x0 ${package_root}\build\out\work\services\core1\build\10_mel128.o
 .text          0x0000000000000000        0x0 ${package_root}\build\out\work\services\core1\build\11_mel_table.o
 .data          0x0000000000000000        0x0 ${package_root}\build\out\work\services\core1\build\11_mel_table.o
 .bss           0x0000000000000000        0x0 ${package_root}\build\out\work\services\core1\build\11_mel_table.o
 .text          0x0000000000000000        0x0 ${package_root}\build\out\work\services\core1\build\12_noise_reduce.o
 .data          0x0000000000000000        0x0 ${package_root}\build\out\work\services\core1\build\12_noise_reduce.o
 .bss           0x0000000000000000        0x0 ${package_root}\build\out\work\services\core1\build\12_noise_reduce.o
 .text          0x0000000000000000        0x0 ${package_root}\build\out\work\services\core1\build\13_platform_port.o
 .data          0x0000000000000000        0x0 ${package_root}\build\out\work\services\core1\build\13_platform_port.o
 .bss           0x0000000000000000        0x0 ${package_root}\build\out\work\services\core1\build\13_platform_port.o
 .text.platform_mmio_read
                0x0000000000000000        0x8 ${package_root}\build\out\work\services\core1\build\13_platform_port.o
 .text          0x0000000000000000        0x0 ${package_root}\build\out\work\services\core1\build\14_shared_ring.o
 .data          0x0000000000000000        0x0 ${package_root}\build\out\work\services\core1\build\14_shared_ring.o
 .bss           0x0000000000000000        0x0 ${package_root}\build\out\work\services\core1\build\14_shared_ring.o
 .text          0x0000000000000000        0x0 ${package_root}\build\out\work\services\core1\build\15_tdoa_solver.o
 .data          0x0000000000000000        0x0 ${package_root}\build\out\work\services\core1\build\15_tdoa_solver.o
 .bss           0x0000000000000000        0x0 ${package_root}\build\out\work\services\core1\build\15_tdoa_solver.o
 .text          0x0000000000000000        0x0 ${package_root}\build\out\work\services\core1\build\16_fusion_math.o
 .data          0x0000000000000000        0x0 ${package_root}\build\out\work\services\core1\build\16_fusion_math.o
 .bss           0x0000000000000000        0x0 ${package_root}\build\out\work\services\core1\build\16_fusion_math.o
 .text.coeff    0x0000000000000000      0x148 ${package_root}\build\out\work\services\core1\build\16_fusion_math.o
 .text.probabilities
                0x0000000000000000       0x94 ${package_root}\build\out\work\services\core1\build\16_fusion_math.o
 .text.prepare_rgb_tables.part.0
                0x0000000000000000      0x15c ${package_root}\build\out\work\services\core1\build\16_fusion_math.o
 .text.classify_input
                0x0000000000000000      0x64c ${package_root}\build\out\work\services\core1\build\16_fusion_math.o
 .text.fusion_ssd_input
                0x0000000000000000      0x42c ${package_root}\build\out\work\services\core1\build\16_fusion_math.o
 .text.fusion_classify_input
                0x0000000000000000       0x70 ${package_root}\build\out\work\services\core1\build\16_fusion_math.o
 .text.fusion_image_inputs
                0x0000000000000000       0x48 ${package_root}\build\out\work\services\core1\build\16_fusion_math.o
 .text.fusion_make_roi
                0x0000000000000000      0x1a8 ${package_root}\build\out\work\services\core1\build\16_fusion_math.o
 .text.fusion_image_roi
                0x0000000000000000       0xe4 ${package_root}\build\out\work\services\core1\build\16_fusion_math.o
 .text.fusion_scores
                0x0000000000000000       0xf8 ${package_root}\build\out\work\services\core1\build\16_fusion_math.o
 .bss.rgb_tables_ready
                0x0000000000000000        0x4 ${package_root}\build\out\work\services\core1\build\16_fusion_math.o
 .bss.quantized_rgb
                0x0000000000000000      0x300 ${package_root}\build\out\work\services\core1\build\16_fusion_math.o
 .bss.normalized_rgb
                0x0000000000000000      0xc00 ${package_root}\build\out\work\services\core1\build\16_fusion_math.o
 .rodata        0x0000000000000000       0x18 ${package_root}\build\out\work\services\core1\build\16_fusion_math.o
 .text          0x0000000000000000        0x0 ${package_root}\build\out\work\services\core1\build\17_fusion_audio.o
 .data          0x0000000000000000        0x0 ${package_root}\build\out\work\services\core1\build\17_fusion_audio.o
 .bss           0x0000000000000000        0x0 ${package_root}\build\out\work\services\core1\build\17_fusion_audio.o
 .text.fusion_yield
                0x0000000000000000        0x4 ${package_root}\build\out\work\services\core1\build\17_fusion_audio.o
 .text          0x0000000000000000        0x0 ${package_root}\build\out\work\services\core1\build\18_xil_printf.o
 .data          0x0000000000000000        0x0 ${package_root}\build\out\work\services\core1\build\18_xil_printf.o
 .bss           0x0000000000000000        0x0 ${package_root}\build\out\work\services\core1\build\18_xil_printf.o
 .text          0x0000000000000000        0x0 ${package_root}\build\out\work\services\core1\build\19_model_logmel32_pl.o
 .data          0x0000000000000000        0x0 ${package_root}\build\out\work\services\core1\build\19_model_logmel32_pl.o
 .bss           0x0000000000000000        0x0 ${package_root}\build\out\work\services\core1\build\19_model_logmel32_pl.o
 .text          0x0000000000000000        0x0 ${package_root}\build\out\work\services\core1\build\20_logmel_pl.o
 .data          0x0000000000000000        0x0 ${package_root}\build\out\work\services\core1\build\20_logmel_pl.o
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
                0x0000000000000000       0xa4 ${package_root}\build\out\work\services\core1\build\28_xsdps_options.o
 .text.XSdPs_StartReadTransfer
                0x0000000000000000       0xc0 ${package_root}\build\out\work\services\core1\build\28_xsdps_options.o
 .text.XSdPs_StartWriteTransfer
                0x0000000000000000       0xc0 ${package_root}\build\out\work\services\core1\build\28_xsdps_options.o
 .text.XSdPs_CheckReadTransfer
                0x0000000000000000       0x74 ${package_root}\build\out\work\services\core1\build\28_xsdps_options.o
 .text.XSdPs_CheckWriteTransfer
                0x0000000000000000       0x74 ${package_root}\build\out\work\services\core1\build\28_xsdps_options.o
 .text          0x0000000000000000        0x0 ${package_root}\build\out\work\platform\bsp_core1\lib\libxil.a(asm_vectors.o)
 .data          0x0000000000000000        0x0 ${package_root}\build\out\work\platform\bsp_core1\lib\libxil.a(asm_vectors.o)
 .bss           0x0000000000000000        0x0 ${package_root}\build\out\work\platform\bsp_core1\lib\libxil.a(asm_vectors.o)
 .debug_line    0x0000000000000000       0x90 ${package_root}\build\out\work\platform\bsp_core1\lib\libxil.a(asm_vectors.o)
 .debug_info    0x0000000000000000       0x26 ${package_root}\build\out\work\platform\bsp_core1\lib\libxil.a(asm_vectors.o)
 .debug_abbrev  0x0000000000000000       0x14 ${package_root}\build\out\work\platform\bsp_core1\lib\libxil.a(asm_vectors.o)
 .debug_aranges
                0x0000000000000000       0x20 ${package_root}\build\out\work\platform\bsp_core1\lib\libxil.a(asm_vectors.o)
 .debug_str     0x0000000000000000       0x99 ${package_root}\build\out\work\platform\bsp_core1\lib\libxil.a(asm_vectors.o)
 .ARM.attributes
                0x0000000000000000       0x29 ${package_root}\build\out\work\platform\bsp_core1\lib\libxil.a(asm_vectors.o)
 .text          0x0000000000000000        0x0 ${package_root}\build\out\work\platform\bsp_core1\lib\libxil.a(boot.o)
 .data          0x0000000000000000        0x0 ${package_root}\build\out\work\platform\bsp_core1\lib\libxil.a(boot.o)
 .bss           0x0000000000000000        0x0 ${package_root}\build\out\work\platform\bsp_core1\lib\libxil.a(boot.o)
 .data          0x0000000000000000        0x0 ${package_root}\build\out\work\platform\bsp_core1\lib\libxil.a(outbyte.o)
 .bss           0x0000000000000000        0x0 ${package_root}\build\out\work\platform\bsp_core1\lib\libxil.a(outbyte.o)
 .text          0x0000000000000000        0x0 ${package_root}\build\out\work\platform\bsp_core1\lib\libxil.a(translation_table.o)
 .data          0x0000000000000000        0x0 ${package_root}\build\out\work\platform\bsp_core1\lib\libxil.a(translation_table.o)
 .bss           0x0000000000000000        0x0 ${package_root}\build\out\work\platform\bsp_core1\lib\libxil.a(translation_table.o)
 .data          0x0000000000000000        0x0 ${package_root}\build\out\work\platform\bsp_core1\lib\libxil.a(vectors.o)
 .bss           0x0000000000000000        0x0 ${package_root}\build\out\work\platform\bsp_core1\lib\libxil.a(vectors.o)
 .data          0x0000000000000000        0x0 ${package_root}\build\out\work\platform\bsp_core1\lib\libxil.a(xil-crt0.o)
 .bss           0x0000000000000000        0x0 ${package_root}\build\out\work\platform\bsp_core1\lib\libxil.a(xil-crt0.o)
 .got2          0x0000000000000000        0x0 ${package_root}\build\out\work\platform\bsp_core1\lib\libxil.a(xil-crt0.o)
 .data          0x0000000000000000        0x0 ${package_root}\build\out\work\platform\bsp_core1\lib\libxil.a(xil_cache.o)
 .bss           0x0000000000000000        0x0 ${package_root}\build\out\work\platform\bsp_core1\lib\libxil.a(xil_cache.o)
 .bss           0x0000000000000000        0x0 ${package_root}\build\out\work\platform\bsp_core1\lib\libxil.a(xil_exception.o)
 .data          0x0000000000000000        0x0 ${package_root}\build\out\work\platform\bsp_core1\lib\libxil.a(xil_mmu.o)
 .bss           0x0000000000000000        0x0 ${package_root}\build\out\work\platform\bsp_core1\lib\libxil.a(xil_mmu.o)
 .data          0x0000000000000000        0x0 ${package_root}\build\out\work\platform\bsp_core1\lib\libxil.a(xtime_l.o)
 .bss           0x0000000000000000        0x0 ${package_root}\build\out\work\platform\bsp_core1\lib\libxil.a(xtime_l.o)
 .data          0x0000000000000000        0x0 ${package_root}\build\out\work\platform\bsp_core1\lib\libxil.a(xuartps_hw.o)
 .bss           0x0000000000000000        0x0 ${package_root}\build\out\work\platform\bsp_core1\lib\libxil.a(xuartps_hw.o)
 .data          0x0000000000000000        0x0 ${package_root}\build\out\work\platform\bsp_core1\lib\libxil.a(cpu_init.o)
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
 .data          0x0000000000000000        0x0 ${package_root}\build\out\work\platform\bsp_core1\lib\libxil.a(kill.o)
 .bss           0x0000000000000000        0x0 ${package_root}\build\out\work\platform\bsp_core1\lib\libxil.a(kill.o)
 .data          0x0000000000000000        0x0 ${package_root}\build\out\work\platform\bsp_core1\lib\libxil.a(lseek.o)
 .bss           0x0000000000000000        0x0 ${package_root}\build\out\work\platform\bsp_core1\lib\libxil.a(lseek.o)
 .data          0x0000000000000000        0x0 ${package_root}\build\out\work\platform\bsp_core1\lib\libxil.a(read.o)
 .bss           0x0000000000000000        0x0 ${package_root}\build\out\work\platform\bsp_core1\lib\libxil.a(read.o)
 .data          0x0000000000000000        0x0 ${package_root}\build\out\work\platform\bsp_core1\lib\libxil.a(write.o)
 .bss           0x0000000000000000        0x0 ${package_root}\build\out\work\platform\bsp_core1\lib\libxil.a(write.o)
 .data          0x0000000000000000        0x0 ${package_root}\build\out\work\platform\bsp_core1\lib\libxil.a(inbyte.o)
 .bss           0x0000000000000000        0x0 ${package_root}\build\out\work\platform\bsp_core1\lib\libxil.a(inbyte.o)
 .text          0x0000000000000000        0x0 ${vitis_install}/gnu/aarch32/nt/gcc-arm-none-eabi/bin//../aarch32-xilinx-eabi/usr/lib/thumb/v7-a+fp/hard/crtend.o
 .data          0x0000000000000000        0x0 ${vitis_install}/gnu/aarch32/nt/gcc-arm-none-eabi/bin//../aarch32-xilinx-eabi/usr/lib/thumb/v7-a+fp/hard/crtend.o
 .bss           0x0000000000000000        0x0 ${vitis_install}/gnu/aarch32/nt/gcc-arm-none-eabi/bin//../aarch32-xilinx-eabi/usr/lib/thumb/v7-a+fp/hard/crtend.o
 .rodata        0x0000000000000000       0x24 ${vitis_install}/gnu/aarch32/nt/gcc-arm-none-eabi/bin//../aarch32-xilinx-eabi/usr/lib/thumb/v7-a+fp/hard/crtend.o
 .eh_frame      0x0000000000000000        0x4 ${vitis_install}/gnu/aarch32/nt/gcc-arm-none-eabi/bin//../aarch32-xilinx-eabi/usr/lib/thumb/v7-a+fp/hard/crtend.o
 .text          0x0000000000000000        0x0 ${vitis_install}/gnu/aarch32/nt/gcc-arm-none-eabi/bin//../aarch32-xilinx-eabi/usr/lib/thumb/v7-a+fp/hard/crtn.o
 .data          0x0000000000000000        0x0 ${vitis_install}/gnu/aarch32/nt/gcc-arm-none-eabi/bin//../aarch32-xilinx-eabi/usr/lib/thumb/v7-a+fp/hard/crtn.o
 .bss           0x0000000000000000        0x0 ${vitis_install}/gnu/aarch32/nt/gcc-arm-none-eabi/bin//../aarch32-xilinx-eabi/usr/lib/thumb/v7-a+fp/hard/crtn.o

Memory Configuration

Name             Origin             Length             Attributes
ps7_ddr_0        0x0000000008000000 0x0000000007f00000
ps7_ram_0        0x0000000000000000 0x0000000000030000
ps7_ram_1        0x00000000ffff0000 0x000000000000fe00
*default*        0x0000000000000000 0xffffffffffffffff

Linker script and memory map

LOAD ${vitis_install}/gnu/aarch32/nt/gcc-arm-none-eabi/bin//../aarch32-xilinx-eabi/usr/lib/thumb/v7-a+fp/hard/crti.o
LOAD ${vitis_install}/gnu/aarch32/nt/gcc-arm-none-eabi/bin//../aarch32-xilinx-eabi/usr/lib/thumb/v7-a+fp/hard/crtbegin.o
LOAD ${package_root}\build\out\work\services\core1\build\0_audio_eth_adapter.o
LOAD ${package_root}\build\out\work\services\core1\build\1_audio_health.o
LOAD ${package_root}\build\out\work\services\core1\build\2_audio_model_input.o
LOAD ${package_root}\build\out\work\services\core1\build\3_audio_quality.o
LOAD ${package_root}\build\out\work\services\core1\build\4_audio_worker.o
LOAD ${package_root}\build\out\work\services\core1\build\5_beamform.o
LOAD ${package_root}\build\out\work\services\core1\build\6_bird_frontend.o
LOAD ${package_root}\build\out\work\services\core1\build\7_fft_q15.o
LOAD ${package_root}\build\out\work\services\core1\build\8_gcc_phat.o
LOAD ${package_root}\build\out\work\services\core1\build\9_main.o
LOAD ${package_root}\build\out\work\services\core1\build\10_mel128.o
LOAD ${package_root}\build\out\work\services\core1\build\11_mel_table.o
LOAD ${package_root}\build\out\work\services\core1\build\12_noise_reduce.o
LOAD ${package_root}\build\out\work\services\core1\build\13_platform_port.o
LOAD ${package_root}\build\out\work\services\core1\build\14_shared_ring.o
LOAD ${package_root}\build\out\work\services\core1\build\15_tdoa_solver.o
LOAD ${package_root}\build\out\work\services\core1\build\16_fusion_math.o
LOAD ${package_root}\build\out\work\services\core1\build\17_fusion_audio.o
LOAD ${package_root}\build\out\work\services\core1\build\18_xil_printf.o
LOAD ${package_root}\build\out\work\services\core1\build\19_model_logmel32_pl.o
LOAD ${package_root}\build\out\work\services\core1\build\20_logmel_pl.o
LOAD ${package_root}\build\out\work\services\core1\build\21_sd_writer.o
LOAD ${package_root}\build\out\work\services\core1\build\22_sd_disk.o
LOAD ${package_root}\build\out\work\services\core1\build\23_ff.o
LOAD ${package_root}\build\out\work\services\core1\build\24_ffunicode.o
LOAD ${package_root}\build\out\work\services\core1\build\25_xsdps.o
LOAD ${package_root}\build\out\work\services\core1\build\26_xsdps_card.o
LOAD ${package_root}\build\out\work\services\core1\build\27_xsdps_host.o
LOAD ${package_root}\build\out\work\services\core1\build\28_xsdps_options.o
                0x0000000000020000                _STACK_SIZE = 0x20000
                0x0000000000200000                _HEAP_SIZE = 0x200000
                0x0000000000020000                _STACK_SIZE = DEFINED (_STACK_SIZE)?_STACK_SIZE:0x2000
                0x0000000000200000                _HEAP_SIZE = DEFINED (_HEAP_SIZE)?_HEAP_SIZE:0x2000
                0x0000000000000400                _ABORT_STACK_SIZE = DEFINED (_ABORT_STACK_SIZE)?_ABORT_STACK_SIZE:0x400
                0x0000000000000800                _SUPERVISOR_STACK_SIZE = DEFINED (_SUPERVISOR_STACK_SIZE)?_SUPERVISOR_STACK_SIZE:0x800
                0x0000000000000400                _IRQ_STACK_SIZE = DEFINED (_IRQ_STACK_SIZE)?_IRQ_STACK_SIZE:0x400
                0x0000000000000400                _FIQ_STACK_SIZE = DEFINED (_FIQ_STACK_SIZE)?_FIQ_STACK_SIZE:0x400
                0x0000000000000400                _UNDEF_STACK_SIZE = DEFINED (_UNDEF_STACK_SIZE)?_UNDEF_STACK_SIZE:0x400

.text           0x0000000008000000    0x16a68
 *(.vectors)
 .vectors       0x0000000008000000      0x12c ${package_root}\build\out\work\platform\bsp_core1\lib\libxil.a(asm_vectors.o)
                0x0000000008000000                _vector_table
 *(.boot)
 .boot          0x000000000800012c      0x2a8 ${package_root}\build\out\work\platform\bsp_core1\lib\libxil.a(boot.o)
                0x000000000800012c                _prestart
                0x000000000800012c                _boot
 *(.text)
 .text          0x00000000080003d4       0xa8 ${vitis_install}/gnu/aarch32/nt/gcc-arm-none-eabi/bin//../aarch32-xilinx-eabi/usr/lib/thumb/v7-a+fp/hard/crtbegin.o
 .text          0x000000000800047c       0x10 ${package_root}\build\out\work\platform\bsp_core1\lib\libxil.a(outbyte.o)
                0x000000000800047c                outbyte
 .text          0x000000000800048c       0x78 ${package_root}\build\out\work\platform\bsp_core1\lib\libxil.a(vectors.o)
                0x000000000800048c                FIQInterrupt
                0x00000000080004a0                IRQInterrupt
                0x00000000080004b4                UndefinedException
                0x00000000080004c8                SWInterrupt
                0x00000000080004dc                DataAbortInterrupt
                0x00000000080004f0                PrefetchAbortInterrupt
 .text          0x0000000008000504       0x74 ${package_root}\build\out\work\platform\bsp_core1\lib\libxil.a(xil-crt0.o)
                0x0000000008000518                _start
 .text          0x0000000008000578       0x70 ${package_root}\build\out\work\platform\bsp_core1\lib\libxil.a(xil_assert.o)
                0x0000000008000578                Xil_Assert
                0x00000000080005d4                Xil_AssertSetCallback
                0x00000000080005e4                XNullHandler
 .text          0x00000000080005e8      0x564 ${package_root}\build\out\work\platform\bsp_core1\lib\libxil.a(xil_cache.o)
                0x00000000080005e8                Xil_DCacheInvalidateLine
                0x0000000008000610                Xil_DCacheInvalidateRange
                0x000000000800068c                Xil_DCacheFlushLine
                0x00000000080006b4                Xil_DCacheFlushRange
                0x00000000080006f4                Xil_DCacheStoreLine
                0x000000000800071c                Xil_ICacheEnable
                0x0000000008000738                Xil_ICacheDisable
                0x0000000008000754                Xil_ICacheInvalidate
                0x000000000800077c                Xil_ICacheInvalidateLine
                0x00000000080007a4                Xil_ICacheInvalidateRange
                0x00000000080007ec                Xil_L1DCacheInvalidate
                0x00000000080008d4                Xil_DCacheInvalidate
                0x00000000080008f0                Xil_L1DCacheEnable
                0x0000000008000910                Xil_DCacheEnable
                0x0000000008000914                Xil_L1DCacheInvalidateLine
                0x000000000800092c                Xil_L1DCacheInvalidateRange
                0x0000000008000974                Xil_L1DCacheFlush
                0x0000000008000a04                Xil_DCacheFlush
                0x0000000008000a20                Xil_DCacheDisable
                0x0000000008000a38                Xil_L1DCacheDisable
                0x0000000008000a3c                Xil_L1DCacheFlushLine
                0x0000000008000a54                Xil_L1DCacheFlushRange
                0x0000000008000a9c                Xil_L1DCacheStoreLine
                0x0000000008000ab4                Xil_L1ICacheEnable
                0x0000000008000ad0                Xil_L1ICacheDisable
                0x0000000008000ad4                Xil_L1ICacheInvalidate
                0x0000000008000aec                Xil_L1ICacheInvalidateLine
                0x0000000008000b04                Xil_L1ICacheInvalidateRange
 .text          0x0000000008000b4c       0x70 ${package_root}\build\out\work\platform\bsp_core1\lib\libxil.a(xil_exception.o)
                0x0000000008000b50                Xil_DataAbortHandler
                0x0000000008000b54                Xil_PrefetchAbortHandler
                0x0000000008000b58                Xil_UndefinedExceptionHandler
                0x0000000008000b5c                Xil_ExceptionInit
                0x0000000008000b60                Xil_ExceptionRegisterHandler
                0x0000000008000b78                Xil_GetExceptionRegisterHandler
                0x0000000008000b98                Xil_ExceptionRemoveHandler
 .text          0x0000000008000bbc       0xd4 ${package_root}\build\out\work\platform\bsp_core1\lib\libxil.a(xil_mmu.o)
                0x0000000008000bbc                Xil_SetTlbAttributes
                0x0000000008000c00                Xil_EnableMMU
                0x0000000008000c24                Xil_DisableMMU
                0x0000000008000c4c                Xil_MemMap
 .text          0x0000000008000c90       0x4c ${package_root}\build\out\work\platform\bsp_core1\lib\libxil.a(xtime_l.o)
                0x0000000008000c90                XTime_SetTime
                0x0000000008000cb4                XTime_GetTime
 .text          0x0000000008000cdc       0x88 ${package_root}\build\out\work\platform\bsp_core1\lib\libxil.a(xuartps_hw.o)
                0x0000000008000cdc                XUartPs_SendByte
                0x0000000008000cf4                XUartPs_RecvByte
                0x0000000008000d10                XUartPs_ResetHw
 .text          0x0000000008000d64       0x3c ${package_root}\build\out\work\platform\bsp_core1\lib\libxil.a(cpu_init.o)
                0x0000000008000d64                __cpu_init
 .text          0x0000000008000da0      0x1dc ${vitis_install}/gnu/aarch32/nt/gcc-arm-none-eabi/bin//../aarch32-xilinx-eabi/usr/lib/thumb/v7-a+fp/hard\libm.a(lib_a-cosf.o)
                0x0000000008000da0                cosf
 .text          0x0000000008000f7c       0x94 ${vitis_install}/gnu/aarch32/nt/gcc-arm-none-eabi/bin//../aarch32-xilinx-eabi/usr/lib/thumb/v7-a+fp/hard\libm.a(lib_a-math_errf.o)
                0x0000000008000fac                __math_uflowf
                0x0000000008000fb8                __math_may_uflowf
                0x0000000008000fc4                __math_oflowf
                0x0000000008000fd0                __math_divzerof
                0x0000000008000ff4                __math_invalidf
 .text          0x0000000008001010       0xe8 ${vitis_install}/gnu/aarch32/nt/gcc-arm-none-eabi/bin//../aarch32-xilinx-eabi/usr/lib/thumb/v7-a+fp/hard\libm.a(lib_a-sf_exp.o)
                0x0000000008001010                expf
 .text          0x00000000080010f8       0x98 ${vitis_install}/gnu/aarch32/nt/gcc-arm-none-eabi/bin//../aarch32-xilinx-eabi/usr/lib/thumb/v7-a+fp/hard\libm.a(lib_a-sf_floor.o)
                0x00000000080010f8                floorf
 .text          0x0000000008001190       0x3c ${vitis_install}/gnu/aarch32/nt/gcc-arm-none-eabi/bin//../aarch32-xilinx-eabi/usr/lib/thumb/v7-a+fp/hard\libm.a(lib_a-sf_fmax.o)
                0x0000000008001190                fmaxf
 .text          0x00000000080011cc       0x3c ${vitis_install}/gnu/aarch32/nt/gcc-arm-none-eabi/bin//../aarch32-xilinx-eabi/usr/lib/thumb/v7-a+fp/hard\libm.a(lib_a-sf_fmin.o)
                0x00000000080011cc                fminf
 .text          0x0000000008001208       0x3c ${vitis_install}/gnu/aarch32/nt/gcc-arm-none-eabi/bin//../aarch32-xilinx-eabi/usr/lib/thumb/v7-a+fp/hard\libm.a(lib_a-sf_fpclassify.o)
                0x0000000008001208                __fpclassifyf
 .text          0x0000000008001244       0x9c ${vitis_install}/gnu/aarch32/nt/gcc-arm-none-eabi/bin//../aarch32-xilinx-eabi/usr/lib/thumb/v7-a+fp/hard\libm.a(lib_a-sf_lrint.o)
                0x0000000008001244                lrintf
 .text          0x00000000080012e0      0x1e4 ${vitis_install}/gnu/aarch32/nt/gcc-arm-none-eabi/bin//../aarch32-xilinx-eabi/usr/lib/thumb/v7-a+fp/hard\libm.a(lib_a-sinf.o)
                0x00000000080012e0                sinf
 .text          0x00000000080014c4        0x4 ${vitis_install}/gnu/aarch32/nt/gcc-arm-none-eabi/bin//../aarch32-xilinx-eabi/usr/lib/thumb/v7-a+fp/hard\libm.a(lib_a-wf_atan2.o)
                0x00000000080014c4                atan2f
 .text          0x00000000080014c8       0x60 ${vitis_install}/gnu/aarch32/nt/gcc-arm-none-eabi/bin//../aarch32-xilinx-eabi/usr/lib/thumb/v7-a+fp/hard\libm.a(lib_a-wf_log10.o)
                0x00000000080014c8                log10f
 .text          0x0000000008001528       0x44 ${vitis_install}/gnu/aarch32/nt/gcc-arm-none-eabi/bin//../aarch32-xilinx-eabi/usr/lib/thumb/v7-a+fp/hard\libm.a(lib_a-wf_sqrt.o)
                0x0000000008001528                sqrtf
 *fill*         0x000000000800156c        0x4 
 .text          0x0000000008001570       0x48 ${vitis_install}/gnu/aarch32/nt/gcc-arm-none-eabi/bin//../aarch32-xilinx-eabi/usr/lib/thumb/v7-a+fp/hard\libm.a(lib_a-w_sqrt.o)
                0x0000000008001570                sqrt
 .text          0x00000000080015b8      0x150 ${vitis_install}/gnu/aarch32/nt/gcc-arm-none-eabi/bin//../aarch32-xilinx-eabi/usr/lib/thumb/v7-a+fp/hard\libm.a(lib_a-ef_atan2.o)
                0x00000000080015b8                __ieee754_atan2f
 .text          0x0000000008001708       0xc0 ${vitis_install}/gnu/aarch32/nt/gcc-arm-none-eabi/bin//../aarch32-xilinx-eabi/usr/lib/thumb/v7-a+fp/hard\libm.a(lib_a-ef_log10.o)
                0x0000000008001708                __ieee754_log10f
 .text          0x00000000080017c8        0x8 ${vitis_install}/gnu/aarch32/nt/gcc-arm-none-eabi/bin//../aarch32-xilinx-eabi/usr/lib/thumb/v7-a+fp/hard\libm.a(lib_a-ef_sqrt.o)
                0x00000000080017c8                __ieee754_sqrtf
 .text          0x00000000080017d0        0x8 ${vitis_install}/gnu/aarch32/nt/gcc-arm-none-eabi/bin//../aarch32-xilinx-eabi/usr/lib/thumb/v7-a+fp/hard\libm.a(lib_a-e_sqrt.o)
                0x00000000080017d0                __ieee754_sqrt
 .text          0x00000000080017d8      0x1ac ${vitis_install}/gnu/aarch32/nt/gcc-arm-none-eabi/bin//../aarch32-xilinx-eabi/usr/lib/thumb/v7-a+fp/hard\libm.a(lib_a-sf_atan.o)
                0x00000000080017d8                atanf
 .text          0x0000000008001984       0x10 ${vitis_install}/gnu/aarch32/nt/gcc-arm-none-eabi/bin//../aarch32-xilinx-eabi/usr/lib/thumb/v7-a+fp/hard\libm.a(lib_a-sf_fabs.o)
                0x0000000008001984                fabsf
 .text          0x0000000008001994       0xd8 ${vitis_install}/gnu/aarch32/nt/gcc-arm-none-eabi/bin//../aarch32-xilinx-eabi/usr/lib/thumb/v7-a+fp/hard\libm.a(lib_a-sf_log.o)
                0x0000000008001994                logf
 .text          0x0000000008001a6c        0xc ${vitis_install}/gnu/aarch32/nt/gcc-arm-none-eabi/bin//../aarch32-xilinx-eabi/usr/lib/thumb/v7-a+fp/hard\libm.a(lib_a-sf_nan.o)
                0x0000000008001a6c                nanf
 .text          0x0000000008001a78      0x278 ${vitis_install}/gnu/aarch32/nt/gcc-arm-none-eabi/bin//../aarch32-xilinx-eabi/usr/lib/thumb/v7-a+fp/hard\libgcc.a(_udivsi3.o)
                0x0000000008001a78                __aeabi_uidiv
                0x0000000008001a78                __udivsi3
                0x0000000008001cd4                __aeabi_uidivmod
 .text          0x0000000008001cf0      0x2b0 ${vitis_install}/gnu/aarch32/nt/gcc-arm-none-eabi/bin//../aarch32-xilinx-eabi/usr/lib/thumb/v7-a+fp/hard\libgcc.a(_divsi3.o)
                0x0000000008001cf0                __divsi3
                0x0000000008001cf0                __aeabi_idiv
                0x0000000008001f84                __aeabi_idivmod
 .text          0x0000000008001fa0        0x4 ${vitis_install}/gnu/aarch32/nt/gcc-arm-none-eabi/bin//../aarch32-xilinx-eabi/usr/lib/thumb/v7-a+fp/hard\libgcc.a(_dvmd_tls.o)
                0x0000000008001fa0                __aeabi_idiv0
                0x0000000008001fa0                __aeabi_ldiv0
 .text          0x0000000008001fa4      0x378 ${vitis_install}/gnu/aarch32/nt/gcc-arm-none-eabi/bin//../aarch32-xilinx-eabi/usr/lib/thumb/v7-a+fp/hard\libgcc.a(_arm_addsubdf3.o)
                0x0000000008001fa4                __aeabi_drsub
                0x0000000008001fac                __aeabi_dsub
                0x0000000008001fac                __subdf3
                0x0000000008001fb0                __aeabi_dadd
                0x0000000008001fb0                __adddf3
                0x0000000008002228                __floatunsidf
                0x0000000008002228                __aeabi_ui2d
                0x0000000008002248                __floatsidf
                0x0000000008002248                __aeabi_i2d
                0x000000000800226c                __aeabi_f2d
                0x000000000800226c                __extendsfdf2
                0x00000000080022b0                __floatundidf
                0x00000000080022b0                __aeabi_ul2d
                0x00000000080022c0                __floatdidf
                0x00000000080022c0                __aeabi_l2d
 .text          0x000000000800231c      0x21c ${vitis_install}/gnu/aarch32/nt/gcc-arm-none-eabi/bin//../aarch32-xilinx-eabi/usr/lib/thumb/v7-a+fp/hard\libgcc.a(_arm_addsubsf3.o)
                0x000000000800231c                __aeabi_frsub
                0x0000000008002324                __subsf3
                0x0000000008002324                __aeabi_fsub
                0x0000000008002328                __aeabi_fadd
                0x0000000008002328                __addsf3
                0x0000000008002488                __aeabi_ui2f
                0x0000000008002488                __floatunsisf
                0x0000000008002490                __aeabi_i2f
                0x0000000008002490                __floatsisf
                0x00000000080024ac                __aeabi_ul2f
                0x00000000080024ac                __floatundisf
                0x00000000080024bc                __aeabi_l2f
                0x00000000080024bc                __floatdisf
 .text          0x0000000008002538       0xa0 ${vitis_install}/gnu/aarch32/nt/gcc-arm-none-eabi/bin//../aarch32-xilinx-eabi/usr/lib/thumb/v7-a+fp/hard\libgcc.a(_aeabi_ldivmod.o)
                0x0000000008002538                __aeabi_ldivmod
 .text          0x00000000080025d8       0x30 ${vitis_install}/gnu/aarch32/nt/gcc-arm-none-eabi/bin//../aarch32-xilinx-eabi/usr/lib/thumb/v7-a+fp/hard\libgcc.a(_aeabi_uldivmod.o)
                0x00000000080025d8                __aeabi_uldivmod
 .text          0x0000000008002608      0x108 ${vitis_install}/gnu/aarch32/nt/gcc-arm-none-eabi/bin//../aarch32-xilinx-eabi/usr/lib/thumb/v7-a+fp/hard\libgcc.a(_udivmoddi4.o)
                0x0000000008002608                __udivmoddi4
 .text          0x0000000008002710        0xc ${vitis_install}/gnu/aarch32/nt/gcc-arm-none-eabi/bin//../aarch32-xilinx-eabi/usr/lib/thumb/v7-a+fp/hard\libc.a(lib_a-errno.o)
                0x0000000008002710                __errno
 .text          0x000000000800271c       0x20 ${vitis_install}/gnu/aarch32/nt/gcc-arm-none-eabi/bin//../aarch32-xilinx-eabi/usr/lib/thumb/v7-a+fp/hard\libc.a(lib_a-exit.o)
                0x000000000800271c                exit
 .text          0x000000000800273c       0x2c ${vitis_install}/gnu/aarch32/nt/gcc-arm-none-eabi/bin//../aarch32-xilinx-eabi/usr/lib/thumb/v7-a+fp/hard\libc.a(lib_a-fini.o)
                0x000000000800273c                __libc_fini_array
 .text          0x0000000008002768       0x58 ${vitis_install}/gnu/aarch32/nt/gcc-arm-none-eabi/bin//../aarch32-xilinx-eabi/usr/lib/thumb/v7-a+fp/hard\libc.a(lib_a-init.o)
                0x0000000008002768                __libc_init_array
 .text          0x00000000080027c0      0x584 ${vitis_install}/gnu/aarch32/nt/gcc-arm-none-eabi/bin//../aarch32-xilinx-eabi/usr/lib/thumb/v7-a+fp/hard\libc.a(lib_a-mallocr.o)
                0x00000000080027c0                _malloc_r
 .text          0x0000000008002d44       0x68 ${vitis_install}/gnu/aarch32/nt/gcc-arm-none-eabi/bin//../aarch32-xilinx-eabi/usr/lib/thumb/v7-a+fp/hard\libc.a(lib_a-memcmp.o)
                0x0000000008002d44                memcmp
 *fill*         0x0000000008002dac       0x14 
 .text          0x0000000008002dc0      0x5e0 ${vitis_install}/gnu/aarch32/nt/gcc-arm-none-eabi/bin//../aarch32-xilinx-eabi/usr/lib/thumb/v7-a+fp/hard\libc.a(lib_a-memcpy.o)
                0x0000000008002dc0                memcpy
 .text          0x00000000080033a0       0xfc ${vitis_install}/gnu/aarch32/nt/gcc-arm-none-eabi/bin//../aarch32-xilinx-eabi/usr/lib/thumb/v7-a+fp/hard\libc.a(lib_a-memmove.o)
                0x00000000080033a0                memmove
 .text          0x000000000800349c       0xa8 ${vitis_install}/gnu/aarch32/nt/gcc-arm-none-eabi/bin//../aarch32-xilinx-eabi/usr/lib/thumb/v7-a+fp/hard\libc.a(lib_a-memset.o)
                0x000000000800349c                memset
 .text          0x0000000008003544        0x8 ${vitis_install}/gnu/aarch32/nt/gcc-arm-none-eabi/bin//../aarch32-xilinx-eabi/usr/lib/thumb/v7-a+fp/hard\libc.a(lib_a-mlock.o)
                0x0000000008003544                __malloc_lock
                0x0000000008003548                __malloc_unlock
 .text          0x000000000800354c       0x28 ${vitis_install}/gnu/aarch32/nt/gcc-arm-none-eabi/bin//../aarch32-xilinx-eabi/usr/lib/thumb/v7-a+fp/hard\libc.a(lib_a-sbrkr.o)
                0x000000000800354c                _sbrk_r
 .text          0x0000000008003574      0x110 ${vitis_install}/gnu/aarch32/nt/gcc-arm-none-eabi/bin//../aarch32-xilinx-eabi/usr/lib/thumb/v7-a+fp/hard\libc.a(lib_a-snprintf.o)
                0x0000000008003574                _snprintf_r
                0x00000000080035f8                snprintf
 .text          0x0000000008003684       0xd0 ${vitis_install}/gnu/aarch32/nt/gcc-arm-none-eabi/bin//../aarch32-xilinx-eabi/usr/lib/thumb/v7-a+fp/hard\libc.a(lib_a-strchr.o)
                0x0000000008003684                strchr
 *fill*         0x0000000008003754        0xc 
 .text          0x0000000008003760      0x2dc ${vitis_install}/gnu/aarch32/nt/gcc-arm-none-eabi/bin//../aarch32-xilinx-eabi/usr/lib/thumb/v7-a+fp/hard\libc.a(lib_a-strcmp.o)
                0x0000000008003768                strcmp
 *fill*         0x0000000008003a3c        0x4 
 .text          0x0000000008003a40       0xdc ${vitis_install}/gnu/aarch32/nt/gcc-arm-none-eabi/bin//../aarch32-xilinx-eabi/usr/lib/thumb/v7-a+fp/hard\libc.a(lib_a-strlen.o)
                0x0000000008003a40                strlen
 *fill*         0x0000000008003b1c        0x4 
 .text          0x0000000008003b20     0x1900 ${vitis_install}/gnu/aarch32/nt/gcc-arm-none-eabi/bin//../aarch32-xilinx-eabi/usr/lib/thumb/v7-a+fp/hard\libc.a(lib_a-svfprintf.o)
                0x0000000008003b20                _svfprintf_r
 .text          0x0000000008005420       0xa4 ${vitis_install}/gnu/aarch32/nt/gcc-arm-none-eabi/bin//../aarch32-xilinx-eabi/usr/lib/thumb/v7-a+fp/hard\libc.a(lib_a-__call_atexit.o)
                0x0000000008005420                __call_exitprocs
 *fill*         0x00000000080054c4        0x4 
 .text          0x00000000080054c8      0xe04 ${vitis_install}/gnu/aarch32/nt/gcc-arm-none-eabi/bin//../aarch32-xilinx-eabi/usr/lib/thumb/v7-a+fp/hard\libc.a(lib_a-dtoa.o)
                0x0000000008005600                _dtoa_r
 .text          0x00000000080062cc      0x2ac ${vitis_install}/gnu/aarch32/nt/gcc-arm-none-eabi/bin//../aarch32-xilinx-eabi/usr/lib/thumb/v7-a+fp/hard\libc.a(lib_a-freer.o)
                0x00000000080062cc                _malloc_trim_r
                0x0000000008006374                _free_r
 .text          0x0000000008006578       0x14 ${vitis_install}/gnu/aarch32/nt/gcc-arm-none-eabi/bin//../aarch32-xilinx-eabi/usr/lib/thumb/v7-a+fp/hard\libc.a(lib_a-localeconv.o)
                0x0000000008006578                __localeconv_l
                0x000000000800657c                _localeconv_r
                0x0000000008006584                localeconv
 .text          0x000000000800658c       0xb8 ${vitis_install}/gnu/aarch32/nt/gcc-arm-none-eabi/bin//../aarch32-xilinx-eabi/usr/lib/thumb/v7-a+fp/hard\libc.a(lib_a-locale.o)
                0x000000000800658c                _setlocale_r
                0x00000000080065e0                __locale_mb_cur_max
                0x00000000080065f0                setlocale
 .text          0x0000000008006644       0x3c ${vitis_install}/gnu/aarch32/nt/gcc-arm-none-eabi/bin//../aarch32-xilinx-eabi/usr/lib/thumb/v7-a+fp/hard\libc.a(lib_a-mbtowc_r.o)
                0x0000000008006644                _mbtowc_r
                0x000000000800665c                __ascii_mbtowc
 .text          0x0000000008006680       0xa0 ${vitis_install}/gnu/aarch32/nt/gcc-arm-none-eabi/bin//../aarch32-xilinx-eabi/usr/lib/thumb/v7-a+fp/hard\libc.a(lib_a-memchr.o)
                0x0000000008006680                memchr
 .text          0x0000000008006720      0xaa4 ${vitis_install}/gnu/aarch32/nt/gcc-arm-none-eabi/bin//../aarch32-xilinx-eabi/usr/lib/thumb/v7-a+fp/hard\libc.a(lib_a-mprec.o)
                0x0000000008006720                _Balloc
                0x000000000800676c                _Bfree
                0x0000000008006780                __multadd
                0x0000000008006828                __s2b
                0x00000000080068e0                __hi0bits
                0x0000000008006928                __lo0bits
                0x0000000008006980                __i2b
                0x00000000080069e0                __multiply
                0x0000000008006b54                __pow5mult
                0x0000000008006c10                __lshift
                0x0000000008006cfc                __mcmp
                0x0000000008006d3c                __mdiff
                0x0000000008006eb8                __ulp
                0x0000000008006f1c                __b2d
                0x0000000008006fe0                __d2b
                0x00000000080070a0                __ratio
                0x0000000008007100                _mprec_log10
                0x0000000008007128                __copybits
                0x0000000008007184                __any_on
 *fill*         0x00000000080071c4        0x4 
 .text          0x00000000080071c8       0x78 ${vitis_install}/gnu/aarch32/nt/gcc-arm-none-eabi/bin//../aarch32-xilinx-eabi/usr/lib/thumb/v7-a+fp/hard\libc.a(lib_a-s_frexp.o)
                0x00000000080071c8                frexp
 .text          0x0000000008007240       0x74 ${vitis_install}/gnu/aarch32/nt/gcc-arm-none-eabi/bin//../aarch32-xilinx-eabi/usr/lib/thumb/v7-a+fp/hard\libc.a(lib_a-strncpy.o)
                0x0000000008007240                strncpy
 .text          0x00000000080072b4      0xc78 ${vitis_install}/gnu/aarch32/nt/gcc-arm-none-eabi/bin//../aarch32-xilinx-eabi/usr/lib/thumb/v7-a+fp/hard\libc.a(lib_a-svfiprintf.o)
                0x00000000080072b4                __ssprint_r
                0x00000000080073c4                _svfiprintf_r
 .text          0x0000000008007f2c       0x34 ${vitis_install}/gnu/aarch32/nt/gcc-arm-none-eabi/bin//../aarch32-xilinx-eabi/usr/lib/thumb/v7-a+fp/hard\libc.a(lib_a-wctomb_r.o)
                0x0000000008007f2c                _wctomb_r
                0x0000000008007f44                __ascii_wctomb
 .text          0x0000000008007f60       0x50 ${vitis_install}/gnu/aarch32/nt/gcc-arm-none-eabi/bin//../aarch32-xilinx-eabi/usr/lib/thumb/v7-a+fp/hard\libc.a(lib_a-assert.o)
                0x0000000008007f60                __assert_func
                0x0000000008007fa4                __assert
 .text          0x0000000008007fb0       0x7c ${vitis_install}/gnu/aarch32/nt/gcc-arm-none-eabi/bin//../aarch32-xilinx-eabi/usr/lib/thumb/v7-a+fp/hard\libc.a(lib_a-callocr.o)
                0x0000000008007fb0                _calloc_r
 .text          0x000000000800802c       0x48 ${vitis_install}/gnu/aarch32/nt/gcc-arm-none-eabi/bin//../aarch32-xilinx-eabi/usr/lib/thumb/v7-a+fp/hard\libc.a(lib_a-fiprintf.o)
                0x000000000800802c                _fiprintf_r
                0x0000000008008048                fiprintf
 .text          0x0000000008008074      0x37c ${vitis_install}/gnu/aarch32/nt/gcc-arm-none-eabi/bin//../aarch32-xilinx-eabi/usr/lib/thumb/v7-a+fp/hard\libc.a(lib_a-reallocr.o)
                0x0000000008008074                _realloc_r
 .text          0x00000000080083f0      0xe74 ${vitis_install}/gnu/aarch32/nt/gcc-arm-none-eabi/bin//../aarch32-xilinx-eabi/usr/lib/thumb/v7-a+fp/hard\libc.a(lib_a-vfiprintf.o)
                0x0000000008008468                __sprint_r
                0x0000000008008480                _vfiprintf_r
                0x00000000080091d8                vfiprintf
 .text          0x0000000008009264       0xc4 ${vitis_install}/gnu/aarch32/nt/gcc-arm-none-eabi/bin//../aarch32-xilinx-eabi/usr/lib/thumb/v7-a+fp/hard\libc.a(lib_a-wsetup.o)
                0x0000000008009264                __swsetup_r
 .text          0x0000000008009328       0x10 ${vitis_install}/gnu/aarch32/nt/gcc-arm-none-eabi/bin//../aarch32-xilinx-eabi/usr/lib/thumb/v7-a+fp/hard\libc.a(lib_a-abort.o)
                0x0000000008009328                abort
 .text          0x0000000008009338      0x1bc ${vitis_install}/gnu/aarch32/nt/gcc-arm-none-eabi/bin//../aarch32-xilinx-eabi/usr/lib/thumb/v7-a+fp/hard\libc.a(lib_a-fflush.o)
                0x0000000008009338                __sflush_r
                0x0000000008009474                _fflush_r
                0x00000000080094a0                fflush
 .text          0x00000000080094f4      0x224 ${vitis_install}/gnu/aarch32/nt/gcc-arm-none-eabi/bin//../aarch32-xilinx-eabi/usr/lib/thumb/v7-a+fp/hard\libc.a(lib_a-findfp.o)
                0x00000000080094f8                _cleanup_r
                0x00000000080095e4                __sfmoreglue
                0x0000000008009614                __sfp
                0x00000000080096b8                _cleanup
                0x00000000080096d0                __sinit
                0x00000000080096d8                __sfp_lock_acquire
                0x00000000080096dc                __sfp_lock_release
                0x00000000080096e0                __sinit_lock_acquire
                0x00000000080096e4                __sinit_lock_release
                0x00000000080096e8                __fp_lock_all
                0x0000000008009700                __fp_unlock_all
 .text          0x0000000008009718       0xe4 ${vitis_install}/gnu/aarch32/nt/gcc-arm-none-eabi/bin//../aarch32-xilinx-eabi/usr/lib/thumb/v7-a+fp/hard\libc.a(lib_a-fputwc.o)
                0x0000000008009718                __fputwc
                0x000000000800979c                _fputwc_r
                0x00000000080097b8                fputwc
 .text          0x00000000080097fc      0x30c ${vitis_install}/gnu/aarch32/nt/gcc-arm-none-eabi/bin//../aarch32-xilinx-eabi/usr/lib/thumb/v7-a+fp/hard\libc.a(lib_a-fvwrite.o)
                0x00000000080097fc                __sfvwrite_r
 .text          0x0000000008009b08       0x80 ${vitis_install}/gnu/aarch32/nt/gcc-arm-none-eabi/bin//../aarch32-xilinx-eabi/usr/lib/thumb/v7-a+fp/hard\libc.a(lib_a-fwalk.o)
                0x0000000008009b08                _fwalk
                0x0000000008009b44                _fwalk_reent
 .text          0x0000000008009b88      0x144 ${vitis_install}/gnu/aarch32/nt/gcc-arm-none-eabi/bin//../aarch32-xilinx-eabi/usr/lib/thumb/v7-a+fp/hard\libc.a(lib_a-makebuf.o)
                0x0000000008009b88                __smakebuf_r
                0x0000000008009c70                __swhatbuf_r
 .text          0x0000000008009ccc      0x288 ${vitis_install}/gnu/aarch32/nt/gcc-arm-none-eabi/bin//../aarch32-xilinx-eabi/usr/lib/thumb/v7-a+fp/hard\libc.a(lib_a-signal.o)
                0x0000000008009ccc                _init_signal_r
                0x0000000008009cfc                _signal_r
                0x0000000008009d4c                _raise_r
                0x0000000008009da0                __sigtramp_r
                0x0000000008009e04                raise
                0x0000000008009e60                signal
                0x0000000008009eb0                _init_signal
                0x0000000008009eec                __sigtramp
 .text          0x0000000008009f54       0x30 ${vitis_install}/gnu/aarch32/nt/gcc-arm-none-eabi/bin//../aarch32-xilinx-eabi/usr/lib/thumb/v7-a+fp/hard\libc.a(lib_a-signalr.o)
                0x0000000008009f54                _kill_r
                0x0000000008009f80                _getpid_r
 .text          0x0000000008009f84       0x94 ${vitis_install}/gnu/aarch32/nt/gcc-arm-none-eabi/bin//../aarch32-xilinx-eabi/usr/lib/thumb/v7-a+fp/hard\libc.a(lib_a-stdio.o)
                0x0000000008009f84                __sread
                0x0000000008009fa8                __seofread
                0x0000000008009fac                __swrite
                0x0000000008009fec                __sseek
                0x000000000800a010                __sclose
 .text          0x000000000800a018       0xc0 ${vitis_install}/gnu/aarch32/nt/gcc-arm-none-eabi/bin//../aarch32-xilinx-eabi/usr/lib/thumb/v7-a+fp/hard\libc.a(lib_a-wbuf.o)
                0x000000000800a018                __swbuf_r
                0x000000000800a0c4                __swbuf
 .text          0x000000000800a0d8       0x78 ${vitis_install}/gnu/aarch32/nt/gcc-arm-none-eabi/bin//../aarch32-xilinx-eabi/usr/lib/thumb/v7-a+fp/hard\libc.a(lib_a-wcrtomb.o)
                0x000000000800a0d8                _wcrtomb_r
                0x000000000800a108                wcrtomb
 .text          0x000000000800a150       0x30 ${vitis_install}/gnu/aarch32/nt/gcc-arm-none-eabi/bin//../aarch32-xilinx-eabi/usr/lib/thumb/v7-a+fp/hard\libc.a(lib_a-writer.o)
                0x000000000800a150                _write_r
 .text          0x000000000800a180       0x28 ${vitis_install}/gnu/aarch32/nt/gcc-arm-none-eabi/bin//../aarch32-xilinx-eabi/usr/lib/thumb/v7-a+fp/hard\libc.a(lib_a-closer.o)
                0x000000000800a180                _close_r
 .text          0x000000000800a1a8       0x98 ${vitis_install}/gnu/aarch32/nt/gcc-arm-none-eabi/bin//../aarch32-xilinx-eabi/usr/lib/thumb/v7-a+fp/hard\libc.a(lib_a-fclose.o)
                0x000000000800a1a8                _fclose_r
                0x000000000800a230                fclose
 .text          0x000000000800a240       0x2c ${vitis_install}/gnu/aarch32/nt/gcc-arm-none-eabi/bin//../aarch32-xilinx-eabi/usr/lib/thumb/v7-a+fp/hard\libc.a(lib_a-fstatr.o)
                0x000000000800a240                _fstat_r
 .text          0x000000000800a26c       0x28 ${vitis_install}/gnu/aarch32/nt/gcc-arm-none-eabi/bin//../aarch32-xilinx-eabi/usr/lib/thumb/v7-a+fp/hard\libc.a(lib_a-isattyr.o)
                0x000000000800a26c                _isatty_r
 .text          0x000000000800a294       0x30 ${vitis_install}/gnu/aarch32/nt/gcc-arm-none-eabi/bin//../aarch32-xilinx-eabi/usr/lib/thumb/v7-a+fp/hard\libc.a(lib_a-lseekr.o)
                0x000000000800a294                _lseek_r
 .text          0x000000000800a2c4       0x30 ${vitis_install}/gnu/aarch32/nt/gcc-arm-none-eabi/bin//../aarch32-xilinx-eabi/usr/lib/thumb/v7-a+fp/hard\libc.a(lib_a-readr.o)
                0x000000000800a2c4                _read_r
 .text          0x000000000800a2f4        0x4 ${package_root}\build\out\work\platform\bsp_core1\lib\libxil.a(_exit.o)
                0x000000000800a2f4                _exit
 .text          0x000000000800a2f8       0x40 ${package_root}\build\out\work\platform\bsp_core1\lib\libxil.a(_sbrk.o)
                0x000000000800a2f8                _sbrk
 .text          0x000000000800a338        0x8 ${package_root}\build\out\work\platform\bsp_core1\lib\libxil.a(close.o)
                0x000000000800a338                _close
 .text          0x000000000800a340       0x10 ${package_root}\build\out\work\platform\bsp_core1\lib\libxil.a(fstat.o)
                0x000000000800a340                _fstat
 .text          0x000000000800a350       0x10 ${package_root}\build\out\work\platform\bsp_core1\lib\libxil.a(getpid.o)
                0x000000000800a350                getpid
                0x000000000800a358                _getpid
 .text          0x000000000800a360       0x10 ${package_root}\build\out\work\platform\bsp_core1\lib\libxil.a(isatty.o)
                0x000000000800a360                isatty
                0x000000000800a368                _isatty
 .text          0x000000000800a370       0x38 ${package_root}\build\out\work\platform\bsp_core1\lib\libxil.a(kill.o)
                0x000000000800a370                kill
                0x000000000800a38c                _kill
 .text          0x000000000800a3a8       0x30 ${package_root}\build\out\work\platform\bsp_core1\lib\libxil.a(lseek.o)
                0x000000000800a3a8                lseek
                0x000000000800a3c0                _lseek
 .text          0x000000000800a3d8       0x58 ${package_root}\build\out\work\platform\bsp_core1\lib\libxil.a(read.o)
                0x000000000800a3d8                read
                0x000000000800a42c                _read
 .text          0x000000000800a430       0x70 ${package_root}\build\out\work\platform\bsp_core1\lib\libxil.a(write.o)
                0x000000000800a430                write
                0x000000000800a49c                _write
 .text          0x000000000800a4a0        0xc ${package_root}\build\out\work\platform\bsp_core1\lib\libxil.a(inbyte.o)
                0x000000000800a4a0                inbyte
 *(.text.*)
 .text.audio_eth_adapter_pack
                0x000000000800a4ac       0x98 ${package_root}\build\out\work\services\core1\build\0_audio_eth_adapter.o
                0x000000000800a4ac                audio_eth_adapter_pack
 .text.audio_health_reset
                0x000000000800a544       0x10 ${package_root}\build\out\work\services\core1\build\1_audio_health.o
                0x000000000800a544                audio_health_reset
 .text.audio_health_update
                0x000000000800a554      0x148 ${package_root}\build\out\work\services\core1\build\1_audio_health.o
                0x000000000800a554                audio_health_update
 .text.audio_model_tensor_reset
                0x000000000800a69c       0xac ${package_root}\build\out\work\services\core1\build\2_audio_model_input.o
                0x000000000800a69c                audio_model_tensor_reset
 .text.audio_model_tensor_push
                0x000000000800a748       0xe0 ${package_root}\build\out\work\services\core1\build\2_audio_model_input.o
                0x000000000800a748                audio_model_tensor_push
 .text.audio_model_tensor_push_missing
                0x000000000800a828      0x144 ${package_root}\build\out\work\services\core1\build\2_audio_model_input.o
                0x000000000800a828                audio_model_tensor_push_missing
 *fill*         0x000000000800a96c        0x4 
 .text.audio_quality_measure
                0x000000000800a970      0x160 ${package_root}\build\out\work\services\core1\build\3_audio_quality.o
                0x000000000800a970                audio_quality_measure
 .text.reset_capture_history
                0x000000000800aad0       0xc8 ${package_root}\build\out\work\services\core1\build\4_audio_worker.o
 .text.audio_worker_init
                0x000000000800ab98       0xd8 ${package_root}\build\out\work\services\core1\build\4_audio_worker.o
                0x000000000800ab98                audio_worker_init
 .text.audio_worker_poll
                0x000000000800ac70      0xf6c ${package_root}\build\out\work\services\core1\build\4_audio_worker.o
                0x000000000800ac70                audio_worker_poll
 .text.beamform_set_channels
                0x000000000800bbdc       0x30 ${package_root}\build\out\work\services\core1\build\5_beamform.o
                0x000000000800bbdc                beamform_set_channels
 .text.beamform_reset
                0x000000000800bc0c       0x58 ${package_root}\build\out\work\services\core1\build\5_beamform.o
                0x000000000800bc0c                beamform_reset
 .text.beamform_set_direction
                0x000000000800bc64      0x144 ${package_root}\build\out\work\services\core1\build\5_beamform.o
                0x000000000800bc64                beamform_set_direction
 .text.beamform_delay_sum
                0x000000000800bda8      0x25c ${package_root}\build\out\work\services\core1\build\5_beamform.o
                0x000000000800bda8                beamform_delay_sum
 .text.biquad_step
                0x000000000800c004      0x104 ${package_root}\build\out\work\services\core1\build\6_bird_frontend.o
 .text.bird_frontend_reset
                0x000000000800c108       0x14 ${package_root}\build\out\work\services\core1\build\6_bird_frontend.o
                0x000000000800c108                bird_frontend_reset
 .text.bird_frontend_process_hop
                0x000000000800c11c      0x424 ${package_root}\build\out\work\services\core1\build\6_bird_frontend.o
                0x000000000800c11c                bird_frontend_process_hop
 .text.fft_q15_init.part.0
                0x000000000800c540       0x9c ${package_root}\build\out\work\services\core1\build\7_fft_q15.o
 .text.fft_q15_n.part.0
                0x000000000800c5dc      0x1f8 ${package_root}\build\out\work\services\core1\build\7_fft_q15.o
 .text.fft_q15_init
                0x000000000800c7d4       0x18 ${package_root}\build\out\work\services\core1\build\7_fft_q15.o
                0x000000000800c7d4                fft_q15_init
 .text.fft_q15  0x000000000800c7ec        0xc ${package_root}\build\out\work\services\core1\build\7_fft_q15.o
                0x000000000800c7ec                fft_q15
 .text.fft_q15_n
                0x000000000800c7f8       0x20 ${package_root}\build\out\work\services\core1\build\7_fft_q15.o
                0x000000000800c7f8                fft_q15_n
 .text.gcc_phat_4ch
                0x000000000800c818      0x634 ${package_root}\build\out\work\services\core1\build\8_gcc_phat.o
                0x000000000800c818                gcc_phat_4ch
 .text.record_yield
                0x000000000800ce4c        0x4 ${package_root}\build\out\work\services\core1\build\9_main.o
 .text.startup.main
                0x000000000800ce50       0x9c ${package_root}\build\out\work\services\core1\build\9_main.o
                0x000000000800ce50                main
 .text.audio_process_reset
                0x000000000800ceec       0xb8 ${package_root}\build\out\work\services\core1\build\10_mel128.o
                0x000000000800ceec                audio_process_reset
 .text.audio_process_hop
                0x000000000800cfa4      0x590 ${package_root}\build\out\work\services\core1\build\10_mel128.o
                0x000000000800cfa4                audio_process_hop
 .text.noise_gain_q15
                0x000000000800d534       0xcc ${package_root}\build\out\work\services\core1\build\12_noise_reduce.o
                0x000000000800d534                noise_gain_q15
 .text.platform_cache_flush
                0x000000000800d600        0x4 ${package_root}\build\out\work\services\core1\build\13_platform_port.o
                0x000000000800d600                platform_cache_flush
 .text.platform_cache_invalidate
                0x000000000800d604        0x4 ${package_root}\build\out\work\services\core1\build\13_platform_port.o
                0x000000000800d604                platform_cache_invalidate
 .text.platform_cycle_count
                0x000000000800d608       0x1c ${package_root}\build\out\work\services\core1\build\13_platform_port.o
                0x000000000800d608                platform_cycle_count
 .text.platform_mmio_write
                0x000000000800d624        0x8 ${package_root}\build\out\work\services\core1\build\13_platform_port.o
                0x000000000800d624                platform_mmio_write
 .text.av_ring_claim_ready
                0x000000000800d62c       0x44 ${package_root}\build\out\work\services\core1\build\14_shared_ring.o
                0x000000000800d62c                av_ring_claim_ready
 .text.av_ring_release_free
                0x000000000800d670       0x14 ${package_root}\build\out\work\services\core1\build\14_shared_ring.o
                0x000000000800d670                av_ring_release_free
 .text.av_ring_publish
                0x000000000800d684       0x9c ${package_root}\build\out\work\services\core1\build\14_shared_ring.o
                0x000000000800d684                av_ring_publish
 .text.solve_weighted
                0x000000000800d720      0x190 ${package_root}\build\out\work\services\core1\build\15_tdoa_solver.o
 .text.tdoa_to_direction
                0x000000000800d8b0      0x424 ${package_root}\build\out\work\services\core1\build\15_tdoa_solver.o
                0x000000000800d8b0                tdoa_to_direction
 .text.fusion_quant_audio
                0x000000000800dcd4       0xa8 ${package_root}\build\out\work\services\core1\build\16_fusion_math.o
                0x000000000800dcd4                fusion_quant_audio
 .text.fusion_audio_publish
                0x000000000800dd7c       0xb0 ${package_root}\build\out\work\services\core1\build\17_fusion_audio.o
                0x000000000800dd7c                fusion_audio_publish
 .text.getnum   0x000000000800de2c       0x64 ${package_root}\build\out\work\services\core1\build\18_xil_printf.o
 .text.outnum   0x000000000800de90      0x19c ${package_root}\build\out\work\services\core1\build\18_xil_printf.o
 *fill*         0x000000000800e02c        0x4 
 .text.xil_printf
                0x000000000800e030      0x4b4 ${package_root}\build\out\work\services\core1\build\18_xil_printf.o
                0x000000000800e030                xil_printf
 .text.transform
                0x000000000800e4e4      0x388 ${package_root}\build\out\work\services\core1\build\19_model_logmel32_pl.o
 .text.init     0x000000000800e86c      0x274 ${package_root}\build\out\work\services\core1\build\19_model_logmel32_pl.o
 .text.model_logmel32_reset
                0x000000000800eae0       0x8c ${package_root}\build\out\work\services\core1\build\19_model_logmel32_pl.o
                0x000000000800eae0                model_logmel32_reset
 .text.model_logmel32_set_capture_samples
                0x000000000800eb6c       0x4c ${package_root}\build\out\work\services\core1\build\19_model_logmel32_pl.o
                0x000000000800eb6c                model_logmel32_set_capture_samples
 .text.model_logmel32_push
                0x000000000800ebb8      0x3d0 ${package_root}\build\out\work\services\core1\build\19_model_logmel32_pl.o
                0x000000000800ebb8                model_logmel32_push
 .text.model_logmel32_ready
                0x000000000800ef88       0x10 ${package_root}\build\out\work\services\core1\build\19_model_logmel32_pl.o
                0x000000000800ef88                model_logmel32_ready
 .text.model_logmel32_tail_samples
                0x000000000800ef98       0x10 ${package_root}\build\out\work\services\core1\build\19_model_logmel32_pl.o
                0x000000000800ef98                model_logmel32_tail_samples
 .text.model_logmel32_data
                0x000000000800efa8        0xc ${package_root}\build\out\work\services\core1\build\19_model_logmel32_pl.o
                0x000000000800efa8                model_logmel32_data
 .text.model_logmel32_pcm
                0x000000000800efb4        0xc ${package_root}\build\out\work\services\core1\build\19_model_logmel32_pl.o
                0x000000000800efb4                model_logmel32_pcm
 .text.logmel_pl_frame
                0x000000000800efc0      0x300 ${package_root}\build\out\work\services\core1\build\20_logmel_pl.o
                0x000000000800efc0                logmel_pl_frame
 .text.error    0x000000000800f2c0       0xac ${package_root}\build\out\work\services\core1\build\21_sd_writer.o
 .text.next_name
                0x000000000800f36c       0x9c ${package_root}\build\out\work\services\core1\build\21_sd_writer.o
 .text.sd_writer_init
                0x000000000800f408      0x120 ${package_root}\build\out\work\services\core1\build\21_sd_writer.o
                0x000000000800f408                sd_writer_init
 .text.sd_writer_poll
                0x000000000800f528      0xb24 ${package_root}\build\out\work\services\core1\build\21_sd_writer.o
                0x000000000800f528                sd_writer_poll
 *fill*         0x000000000801004c        0x4 
 .text.cooperate
                0x0000000008010050      0x110 ${package_root}\build\out\work\services\core1\build\22_sd_disk.o
 .text.transfer
                0x0000000008010160      0x340 ${package_root}\build\out\work\services\core1\build\22_sd_disk.o
 .text.sd_disk_set_yield
                0x00000000080104a0      0x120 ${package_root}\build\out\work\services\core1\build\22_sd_disk.o
                0x00000000080104a0                sd_disk_set_yield
 .text.sd_disk_max_call_us
                0x00000000080105c0       0x10 ${package_root}\build\out\work\services\core1\build\22_sd_disk.o
                0x00000000080105c0                sd_disk_max_call_us
 .text.sd_disk_yield_count
                0x00000000080105d0       0x10 ${package_root}\build\out\work\services\core1\build\22_sd_disk.o
                0x00000000080105d0                sd_disk_yield_count
 .text.sd_disk_wait_event
                0x00000000080105e0      0x130 ${package_root}\build\out\work\services\core1\build\22_sd_disk.o
                0x00000000080105e0                sd_disk_wait_event
 .text.sd_disk_wait_events
                0x0000000008010710      0x140 ${package_root}\build\out\work\services\core1\build\22_sd_disk.o
                0x0000000008010710                sd_disk_wait_events
 .text.sd_disk_delay
                0x0000000008010850      0x100 ${package_root}\build\out\work\services\core1\build\22_sd_disk.o
                0x0000000008010850                sd_disk_delay
 .text.disk_status
                0x0000000008010950       0x44 ${package_root}\build\out\work\services\core1\build\22_sd_disk.o
                0x0000000008010950                disk_status
 *fill*         0x0000000008010994        0x4 
 .text.disk_initialize
                0x0000000008010998      0x1f0 ${package_root}\build\out\work\services\core1\build\22_sd_disk.o
                0x0000000008010998                disk_initialize
 .text.disk_read
                0x0000000008010b88       0x28 ${package_root}\build\out\work\services\core1\build\22_sd_disk.o
                0x0000000008010b88                disk_read
 .text.disk_write
                0x0000000008010bb0       0x2c ${package_root}\build\out\work\services\core1\build\22_sd_disk.o
                0x0000000008010bb0                disk_write
 .text.disk_ioctl
                0x0000000008010bdc       0xc4 ${package_root}\build\out\work\services\core1\build\22_sd_disk.o
                0x0000000008010bdc                disk_ioctl
 .text.get_ldnumber
                0x0000000008010ca0       0x58 ${package_root}\build\out\work\services\core1\build\23_ff.o
 .text.validate
                0x0000000008010cf8       0x60 ${package_root}\build\out\work\services\core1\build\23_ff.o
 .text.sync_window
                0x0000000008010d58       0x8c ${package_root}\build\out\work\services\core1\build\23_ff.o
 .text.get_fileinfo
                0x0000000008010de4      0x220 ${package_root}\build\out\work\services\core1\build\23_ff.o
 .text.dir_clear
                0x0000000008011004       0xa4 ${package_root}\build\out\work\services\core1\build\23_ff.o
 .text.sync_fs  0x00000000080110a8      0x124 ${package_root}\build\out\work\services\core1\build\23_ff.o
 .text.move_window
                0x00000000080111cc       0xb8 ${package_root}\build\out\work\services\core1\build\23_ff.o
 .text.put_fat.part.0
                0x0000000008011284      0x158 ${package_root}\build\out\work\services\core1\build\23_ff.o
 .text.get_fat.isra.0
                0x00000000080113dc      0x108 ${package_root}\build\out\work\services\core1\build\23_ff.o
 .text.remove_chain
                0x00000000080114e4       0xec ${package_root}\build\out\work\services\core1\build\23_ff.o
 .text.create_chain
                0x00000000080115d0      0x1f4 ${package_root}\build\out\work\services\core1\build\23_ff.o
 .text.dir_next
                0x00000000080117c4      0x138 ${package_root}\build\out\work\services\core1\build\23_ff.o
 .text.dir_read.constprop.0
                0x00000000080118fc      0x1c0 ${package_root}\build\out\work\services\core1\build\23_ff.o
 .text.dir_sdi  0x0000000008011abc      0x11c ${package_root}\build\out\work\services\core1\build\23_ff.o
 .text.dir_remove
                0x0000000008011bd8       0xcc ${package_root}\build\out\work\services\core1\build\23_ff.o
 .text.dir_find
                0x0000000008011ca4      0x27c ${package_root}\build\out\work\services\core1\build\23_ff.o
 .text.follow_path
                0x0000000008011f20      0x4ac ${package_root}\build\out\work\services\core1\build\23_ff.o
 .text.dir_register
                0x00000000080123cc      0x480 ${package_root}\build\out\work\services\core1\build\23_ff.o
 .text.check_fs
                0x000000000801284c      0x184 ${package_root}\build\out\work\services\core1\build\23_ff.o
 .text.mount_volume
                0x00000000080129d0      0x3a0 ${package_root}\build\out\work\services\core1\build\23_ff.o
 .text.f_mount  0x0000000008012d70       0x8c ${package_root}\build\out\work\services\core1\build\23_ff.o
                0x0000000008012d70                f_mount
 .text.f_open   0x0000000008012dfc      0x2ec ${package_root}\build\out\work\services\core1\build\23_ff.o
                0x0000000008012dfc                f_open
 .text.f_read   0x00000000080130e8      0x278 ${package_root}\build\out\work\services\core1\build\23_ff.o
                0x00000000080130e8                f_read
 .text.f_write  0x0000000008013360      0x2bc ${package_root}\build\out\work\services\core1\build\23_ff.o
                0x0000000008013360                f_write
 .text.f_sync   0x000000000801361c      0x120 ${package_root}\build\out\work\services\core1\build\23_ff.o
                0x000000000801361c                f_sync
 .text.f_close  0x000000000801373c       0x3c ${package_root}\build\out\work\services\core1\build\23_ff.o
                0x000000000801373c                f_close
 .text.f_opendir
                0x0000000008013778       0xd0 ${package_root}\build\out\work\services\core1\build\23_ff.o
                0x0000000008013778                f_opendir
 .text.f_closedir
                0x0000000008013848       0x54 ${package_root}\build\out\work\services\core1\build\23_ff.o
                0x0000000008013848                f_closedir
 .text.f_readdir
                0x000000000801389c       0xb8 ${package_root}\build\out\work\services\core1\build\23_ff.o
                0x000000000801389c                f_readdir
 .text.f_stat   0x0000000008013954       0x8c ${package_root}\build\out\work\services\core1\build\23_ff.o
                0x0000000008013954                f_stat
 .text.f_mkdir  0x00000000080139e0      0x25c ${package_root}\build\out\work\services\core1\build\23_ff.o
                0x00000000080139e0                f_mkdir
 .text.f_rename
                0x0000000008013c3c      0x224 ${package_root}\build\out\work\services\core1\build\23_ff.o
                0x0000000008013c3c                f_rename
 .text.ff_uni2oem
                0x0000000008013e60       0x6c ${package_root}\build\out\work\services\core1\build\24_ffunicode.o
                0x0000000008013e60                ff_uni2oem
 .text.ff_oem2uni
                0x0000000008013ecc       0x3c ${package_root}\build\out\work\services\core1\build\24_ffunicode.o
                0x0000000008013ecc                ff_oem2uni
 .text.ff_wtoupper
                0x0000000008013f08      0x11c ${package_root}\build\out\work\services\core1\build\24_ffunicode.o
                0x0000000008013f08                ff_wtoupper
 .text.XSdPs_CfgInitialize
                0x0000000008014024      0x160 ${package_root}\build\out\work\services\core1\build\25_xsdps.o
                0x0000000008014024                XSdPs_CfgInitialize
 .text.XSdPs_CardInitialize
                0x0000000008014184       0xdc ${package_root}\build\out\work\services\core1\build\25_xsdps.o
                0x0000000008014184                XSdPs_CardInitialize
 .text.XSdPs_ReadPolled
                0x0000000008014260       0xec ${package_root}\build\out\work\services\core1\build\25_xsdps.o
                0x0000000008014260                XSdPs_ReadPolled
 .text.XSdPs_WritePolled
                0x000000000801434c       0xc8 ${package_root}\build\out\work\services\core1\build\25_xsdps.o
                0x000000000801434c                XSdPs_WritePolled
 .text.XSdPs_Read
                0x0000000008014414       0x5c ${package_root}\build\out\work\services\core1\build\26_xsdps_card.o
                0x0000000008014414                XSdPs_Read
 .text.XSdPs_Write
                0x0000000008014470       0x5c ${package_root}\build\out\work\services\core1\build\26_xsdps_card.o
                0x0000000008014470                XSdPs_Write
 .text.XSdPs_IdentifyCard
                0x00000000080144cc       0xb0 ${package_root}\build\out\work\services\core1\build\26_xsdps_card.o
                0x00000000080144cc                XSdPs_IdentifyCard
 .text.XSdPs_SdCardInitialize
                0x000000000801457c       0x38 ${package_root}\build\out\work\services\core1\build\26_xsdps_card.o
                0x000000000801457c                XSdPs_SdCardInitialize
 .text.XSdPs_MmcCardInitialize
                0x00000000080145b4       0xb0 ${package_root}\build\out\work\services\core1\build\26_xsdps_card.o
                0x00000000080145b4                XSdPs_MmcCardInitialize
 .text.XSdPs_CheckCardDetect
                0x0000000008014664       0x44 ${package_root}\build\out\work\services\core1\build\26_xsdps_card.o
                0x0000000008014664                XSdPs_CheckCardDetect
 .text.XSdPs_CardReset
                0x00000000080146a8       0x20 ${package_root}\build\out\work\services\core1\build\26_xsdps_card.o
                0x00000000080146a8                XSdPs_CardReset
 .text.XSdPs_CardIfCond
                0x00000000080146c8       0x6c ${package_root}\build\out\work\services\core1\build\26_xsdps_card.o
                0x00000000080146c8                XSdPs_CardIfCond
 .text.XSdPs_CardOpCond
                0x0000000008014734      0x108 ${package_root}\build\out\work\services\core1\build\26_xsdps_card.o
                0x0000000008014734                XSdPs_CardOpCond
 .text.XSdPs_GetCardId
                0x000000000801483c       0xf4 ${package_root}\build\out\work\services\core1\build\26_xsdps_card.o
                0x000000000801483c                XSdPs_GetCardId
 .text.XSdPs_GetCsd
                0x0000000008014930       0xbc ${package_root}\build\out\work\services\core1\build\26_xsdps_card.o
                0x0000000008014930                XSdPs_GetCsd
 .text.XSdPs_CardSetVoltage18
                0x00000000080149ec       0x5c ${package_root}\build\out\work\services\core1\build\26_xsdps_card.o
                0x00000000080149ec                XSdPs_CardSetVoltage18
 .text.XSdPs_ResetConfig
                0x0000000008014a48       0x34 ${package_root}\build\out\work\services\core1\build\26_xsdps_card.o
                0x0000000008014a48                XSdPs_ResetConfig
 .text.XSdPs_HostConfig
                0x0000000008014a7c       0x34 ${package_root}\build\out\work\services\core1\build\26_xsdps_card.o
                0x0000000008014a7c                XSdPs_HostConfig
 .text.XSdPs_CheckResetDone
                0x0000000008014ab0       0x2c ${package_root}\build\out\work\services\core1\build\26_xsdps_card.o
                0x0000000008014ab0                XSdPs_CheckResetDone
 .text.XSdPs_SetupVoltageSwitch
                0x0000000008014adc       0x48 ${package_root}\build\out\work\services\core1\build\26_xsdps_card.o
                0x0000000008014adc                XSdPs_SetupVoltageSwitch
 .text.XSdPs_CheckBusHigh
                0x0000000008014b24       0x28 ${package_root}\build\out\work\services\core1\build\26_xsdps_card.o
                0x0000000008014b24                XSdPs_CheckBusHigh
 .text.XSdPs_Identify_UhsMode
                0x0000000008014b4c       0xc0 ${package_root}\build\out\work\services\core1\build\26_xsdps_card.o
                0x0000000008014b4c                XSdPs_Identify_UhsMode
 .text.XSdPs_SetTapDelay
                0x0000000008014c0c       0x40 ${package_root}\build\out\work\services\core1\build\26_xsdps_card.o
                0x0000000008014c0c                XSdPs_SetTapDelay
 .text.XSdPs_Change_SdBusSpeed
                0x0000000008014c4c       0xb0 ${package_root}\build\out\work\services\core1\build\26_xsdps_card.o
                0x0000000008014c4c                XSdPs_Change_SdBusSpeed
 .text.XSdPs_Change_MmcBusSpeed
                0x0000000008014cfc       0x58 ${package_root}\build\out\work\services\core1\build\26_xsdps_card.o
                0x0000000008014cfc                XSdPs_Change_MmcBusSpeed
 .text.XSdPs_AutoTuning
                0x0000000008014d54       0xb0 ${package_root}\build\out\work\services\core1\build\26_xsdps_card.o
                0x0000000008014d54                XSdPs_AutoTuning
 .text.XSdPs_SetupADMA2DescTbl
                0x0000000008014e04       0x14 ${package_root}\build\out\work\services\core1\build\26_xsdps_card.o
                0x0000000008014e04                XSdPs_SetupADMA2DescTbl
 .text.XSdPs_SetupADMA2DescTbl64Bit
                0x0000000008014e18      0x100 ${package_root}\build\out\work\services\core1\build\26_xsdps_card.o
                0x0000000008014e18                XSdPs_SetupADMA2DescTbl64Bit
 .text.XSdPs_DllReset
                0x0000000008014f18       0x54 ${package_root}\build\out\work\services\core1\build\26_xsdps_card.o
                0x0000000008014f18                XSdPs_DllReset
 .text.XSdPs_IdentifyEmmcMode
                0x0000000008014f6c       0xd0 ${package_root}\build\out\work\services\core1\build\26_xsdps_card.o
                0x0000000008014f6c                XSdPs_IdentifyEmmcMode
 .text.XSdPs_CheckEmmcTiming
                0x000000000801503c       0x58 ${package_root}\build\out\work\services\core1\build\26_xsdps_card.o
                0x000000000801503c                XSdPs_CheckEmmcTiming
 .text.XSdPs_SetClock
                0x0000000008015094       0x40 ${package_root}\build\out\work\services\core1\build\26_xsdps_card.o
                0x0000000008015094                XSdPs_SetClock
 .text.XSdPs_CheckVoltage18
                0x00000000080150d4       0x14 ${package_root}\build\out\work\services\core1\build\26_xsdps_card.o
                0x00000000080150d4                XSdPs_CheckVoltage18
 .text.XSdPs_SetupCmd
                0x00000000080150e8       0x58 ${package_root}\build\out\work\services\core1\build\26_xsdps_card.o
                0x00000000080150e8                XSdPs_SetupCmd
 .text.XSdPs_SendCmd
                0x0000000008015140       0x60 ${package_root}\build\out\work\services\core1\build\26_xsdps_card.o
                0x0000000008015140                XSdPs_SendCmd
 .text.XSdPs_SetTapDelay_SDR104
                0x00000000080151a0       0x20 ${package_root}\build\out\work\services\core1\build\27_xsdps_host.o
                0x00000000080151a0                XSdPs_SetTapDelay_SDR104
 .text.XSdPs_SetTapDelay_SDR50
                0x00000000080151c0       0x14 ${package_root}\build\out\work\services\core1\build\27_xsdps_host.o
                0x00000000080151c0                XSdPs_SetTapDelay_SDR50
 .text.XSdPs_SetTapDelay_DDR50
                0x00000000080151d4       0x50 ${package_root}\build\out\work\services\core1\build\27_xsdps_host.o
                0x00000000080151d4                XSdPs_SetTapDelay_DDR50
 .text.XSdPs_SetTapDelay_SDR25
                0x0000000008015224       0x50 ${package_root}\build\out\work\services\core1\build\27_xsdps_host.o
                0x0000000008015224                XSdPs_SetTapDelay_SDR25
 .text.XSdPs_Switch_Voltage
                0x0000000008015274       0x40 ${package_root}\build\out\work\services\core1\build\27_xsdps_host.o
                0x0000000008015274                XSdPs_Switch_Voltage
 .text.XSdPs_SetupTransfer
                0x00000000080152b4       0x7c ${package_root}\build\out\work\services\core1\build\27_xsdps_host.o
                0x00000000080152b4                XSdPs_SetupTransfer
 .text.XSdPs_Reset
                0x0000000008015330       0x1c ${package_root}\build\out\work\services\core1\build\27_xsdps_host.o
                0x0000000008015330                XSdPs_Reset
 .text.XSdPs_SetExecTuning
                0x000000000801534c       0x14 ${package_root}\build\out\work\services\core1\build\27_xsdps_host.o
                0x000000000801534c                XSdPs_SetExecTuning
 .text.XSdPs_SdModeInit
                0x0000000008015360      0x18c ${package_root}\build\out\work\services\core1\build\27_xsdps_host.o
                0x0000000008015360                XSdPs_SdModeInit
 .text.XSdPs_MmcModeInit
                0x00000000080154ec       0xc4 ${package_root}\build\out\work\services\core1\build\27_xsdps_host.o
                0x00000000080154ec                XSdPs_MmcModeInit
 .text.XSdPs_EmmcModeInit
                0x00000000080155b0      0x12c ${package_root}\build\out\work\services\core1\build\27_xsdps_host.o
                0x00000000080155b0                XSdPs_EmmcModeInit
 .text.XSdPs_DisableBusPower
                0x00000000080156dc       0x20 ${package_root}\build\out\work\services\core1\build\27_xsdps_host.o
                0x00000000080156dc                XSdPs_DisableBusPower
 .text.XSdPs_EnableBusPower
                0x00000000080156fc       0x14 ${package_root}\build\out\work\services\core1\build\27_xsdps_host.o
                0x00000000080156fc                XSdPs_EnableBusPower
 .text.XSdPs_SdCardEnum
                0x0000000008015710       0xb0 ${package_root}\build\out\work\services\core1\build\27_xsdps_host.o
                0x0000000008015710                XSdPs_SdCardEnum
 .text.XSdPs_MmcCardEnum
                0x00000000080157c0       0x8c ${package_root}\build\out\work\services\core1\build\27_xsdps_host.o
                0x00000000080157c0                XSdPs_MmcCardEnum
 .text.XSdPs_Execute_Tuning
                0x000000000801584c       0x40 ${package_root}\build\out\work\services\core1\build\27_xsdps_host.o
                0x000000000801584c                XSdPs_Execute_Tuning
 .text.XSdPs_EnableClock
                0x000000000801588c       0x48 ${package_root}\build\out\work\services\core1\build\27_xsdps_host.o
                0x000000000801588c                XSdPs_EnableClock
 .text.XSdPs_CalcBusSpeed
                0x00000000080158d4       0xf0 ${package_root}\build\out\work\services\core1\build\27_xsdps_host.o
                0x00000000080158d4                XSdPs_CalcBusSpeed
 .text.XSdPs_SetupReadDma
                0x00000000080159c4       0x64 ${package_root}\build\out\work\services\core1\build\27_xsdps_host.o
                0x00000000080159c4                XSdPs_SetupReadDma
 .text.XSdPs_SetupWriteDma
                0x0000000008015a28       0x64 ${package_root}\build\out\work\services\core1\build\27_xsdps_host.o
                0x0000000008015a28                XSdPs_SetupWriteDma
 .text.XSdPs_Setup32ADMA2DescTbl
                0x0000000008015a8c       0xc4 ${package_root}\build\out\work\services\core1\build\27_xsdps_host.o
                0x0000000008015a8c                XSdPs_Setup32ADMA2DescTbl
 .text.XSdPs_Setup64ADMA2DescTbl
                0x0000000008015b50       0xe8 ${package_root}\build\out\work\services\core1\build\27_xsdps_host.o
                0x0000000008015b50                XSdPs_Setup64ADMA2DescTbl
 .text.XSdPs_CalcClock
                0x0000000008015c38       0xe4 ${package_root}\build\out\work\services\core1\build\27_xsdps_host.o
                0x0000000008015c38                XSdPs_CalcClock
 .text.XSdPs_DllRstCtrl
                0x0000000008015d1c       0x40 ${package_root}\build\out\work\services\core1\build\27_xsdps_host.o
                0x0000000008015d1c                XSdPs_DllRstCtrl
 .text.XSdPs_ConfigTapDelay
                0x0000000008015d5c      0x114 ${package_root}\build\out\work\services\core1\build\27_xsdps_host.o
                0x0000000008015d5c                XSdPs_ConfigTapDelay
 .text.XSdPs_SetVoltage18
                0x0000000008015e70       0x34 ${package_root}\build\out\work\services\core1\build\27_xsdps_host.o
                0x0000000008015e70                XSdPs_SetVoltage18
 .text.XSdPs_ConfigPower
                0x0000000008015ea4       0x38 ${package_root}\build\out\work\services\core1\build\27_xsdps_host.o
                0x0000000008015ea4                XSdPs_ConfigPower
 .text.XSdPs_ConfigDma
                0x0000000008015edc       0x1c ${package_root}\build\out\work\services\core1\build\27_xsdps_host.o
                0x0000000008015edc                XSdPs_ConfigDma
 .text.XSdPs_ConfigInterrupt
                0x0000000008015ef8       0x24 ${package_root}\build\out\work\services\core1\build\27_xsdps_host.o
                0x0000000008015ef8                XSdPs_ConfigInterrupt
 .text.XSdPs_CmdTransfer
                0x0000000008015f1c       0xf0 ${package_root}\build\out\work\services\core1\build\27_xsdps_host.o
                0x0000000008015f1c                XSdPs_CmdTransfer
 .text.XSdps_CheckTransferDone
                0x000000000801600c       0x6c ${package_root}\build\out\work\services\core1\build\27_xsdps_host.o
                0x000000000801600c                XSdps_CheckTransferDone
 .text.XSdPs_CheckBusIdle
                0x0000000008016078       0x38 ${package_root}\build\out\work\services\core1\build\27_xsdps_host.o
                0x0000000008016078                XSdPs_CheckBusIdle
 .text.XSdPs_FrameCmd
                0x00000000080160b0      0x1c8 ${package_root}\build\out\work\services\core1\build\27_xsdps_host.o
                0x00000000080160b0                XSdPs_FrameCmd
 .text.XSdPs_Change_ClkFreq
                0x0000000008016278       0xa8 ${package_root}\build\out\work\services\core1\build\28_xsdps_options.o
                0x0000000008016278                XSdPs_Change_ClkFreq
 .text.XSdPs_SetBlkSize
                0x0000000008016320       0xc0 ${package_root}\build\out\work\services\core1\build\28_xsdps_options.o
                0x0000000008016320                XSdPs_SetBlkSize
 .text.XSdPs_Get_BusWidth
                0x00000000080163e0       0xf8 ${package_root}\build\out\work\services\core1\build\28_xsdps_options.o
                0x00000000080163e0                XSdPs_Get_BusWidth
 .text.XSdPs_Get_BusSpeed
                0x00000000080164d8       0xec ${package_root}\build\out\work\services\core1\build\28_xsdps_options.o
                0x00000000080164d8                XSdPs_Get_BusSpeed
 .text.XSdPs_Change_BusSpeed
                0x00000000080165c4       0xfc ${package_root}\build\out\work\services\core1\build\28_xsdps_options.o
                0x00000000080165c4                XSdPs_Change_BusSpeed
 .text.XSdPs_Get_Mmc_ExtCsd
                0x00000000080166c0       0xec ${package_root}\build\out\work\services\core1\build\28_xsdps_options.o
                0x00000000080166c0                XSdPs_Get_Mmc_ExtCsd
 .text.XSdPs_Set_Mmc_ExtCsd
                0x00000000080167ac       0x9c ${package_root}\build\out\work\services\core1\build\28_xsdps_options.o
                0x00000000080167ac                XSdPs_Set_Mmc_ExtCsd
 .text.XSdPs_Change_BusWidth
                0x0000000008016848      0x190 ${package_root}\build\out\work\services\core1\build\28_xsdps_options.o
                0x0000000008016848                XSdPs_Change_BusWidth
 .text.XSdPs_Select_Card
                0x00000000080169d8       0x7c ${package_root}\build\out\work\services\core1\build\28_xsdps_options.o
                0x00000000080169d8                XSdPs_Select_Card
 *fill*         0x0000000008016a54        0x4 
 .text.XSdPs_Select_Card.__stub
                0x0000000008016a58       0x10 linker stubs
 *(.gnu.linkonce.t.*)
 *(.plt)
 *(.gnu_warning)
 *(.gcc_execpt_table)
 *(.glue_7)
 .glue_7        0x0000000008016a68        0x0 linker stubs
 *(.glue_7t)
 .glue_7t       0x0000000008016a68        0x0 linker stubs
 *(.vfp11_veneer)
 .vfp11_veneer  0x0000000008016a68        0x0 linker stubs
 *(.ARM.extab)
 *(.gnu.linkonce.armextab.*)

.v4_bx          0x0000000008016a68        0x0
 .v4_bx         0x0000000008016a68        0x0 linker stubs

.iplt           0x0000000008016a68        0x0
 .iplt          0x0000000008016a68        0x0 ${vitis_install}/gnu/aarch32/nt/gcc-arm-none-eabi/bin//../aarch32-xilinx-eabi/usr/lib/thumb/v7-a+fp/hard/crtbegin.o

.init           0x0000000008016a68        0xc
 *(.init)
 .init          0x0000000008016a68        0x4 ${vitis_install}/gnu/aarch32/nt/gcc-arm-none-eabi/bin//../aarch32-xilinx-eabi/usr/lib/thumb/v7-a+fp/hard/crti.o
                0x0000000008016a68                _init
 .init          0x0000000008016a6c        0x8 ${vitis_install}/gnu/aarch32/nt/gcc-arm-none-eabi/bin//../aarch32-xilinx-eabi/usr/lib/thumb/v7-a+fp/hard/crtn.o

.fini           0x0000000008016a74        0xc
 *(.fini)
 .fini          0x0000000008016a74        0x4 ${vitis_install}/gnu/aarch32/nt/gcc-arm-none-eabi/bin//../aarch32-xilinx-eabi/usr/lib/thumb/v7-a+fp/hard/crti.o
                0x0000000008016a74                _fini
 .fini          0x0000000008016a78        0x8 ${vitis_install}/gnu/aarch32/nt/gcc-arm-none-eabi/bin//../aarch32-xilinx-eabi/usr/lib/thumb/v7-a+fp/hard/crtn.o

.rodata         0x0000000008016a80     0x133f
                0x0000000008016a80                __rodata_start = .
 *(.rodata)
 .rodata        0x0000000008016a80       0x20 ${package_root}\build\out\work\services\core1\build\4_audio_worker.o
 .rodata        0x0000000008016aa0       0x20 ${package_root}\build\out\work\services\core1\build\5_beamform.o
 .rodata        0x0000000008016ac0        0x8 ${vitis_install}/gnu/aarch32/nt/gcc-arm-none-eabi/bin//../aarch32-xilinx-eabi/usr/lib/thumb/v7-a+fp/hard\libm.a(lib_a-sf_lrint.o)
 .rodata        0x0000000008016ac8      0x140 ${vitis_install}/gnu/aarch32/nt/gcc-arm-none-eabi/bin//../aarch32-xilinx-eabi/usr/lib/thumb/v7-a+fp/hard\libm.a(lib_a-sincosf_data.o)
                0x0000000008016ac8                __inv_pio4
                0x0000000008016b28                __sincosf_table
 .rodata        0x0000000008016c08       0x18 ${vitis_install}/gnu/aarch32/nt/gcc-arm-none-eabi/bin//../aarch32-xilinx-eabi/usr/lib/thumb/v7-a+fp/hard\libm.a(lib_a-ef_atan2.o)
 .rodata        0x0000000008016c20       0x20 ${vitis_install}/gnu/aarch32/nt/gcc-arm-none-eabi/bin//../aarch32-xilinx-eabi/usr/lib/thumb/v7-a+fp/hard\libm.a(lib_a-sf_atan.o)
 .rodata        0x0000000008016c40      0x148 ${vitis_install}/gnu/aarch32/nt/gcc-arm-none-eabi/bin//../aarch32-xilinx-eabi/usr/lib/thumb/v7-a+fp/hard\libm.a(lib_a-sf_exp2_data.o)
                0x0000000008016c40                __exp2f_data
 .rodata        0x0000000008016d88      0x120 ${vitis_install}/gnu/aarch32/nt/gcc-arm-none-eabi/bin//../aarch32-xilinx-eabi/usr/lib/thumb/v7-a+fp/hard\libm.a(lib_a-sf_log_data.o)
                0x0000000008016d88                __logf_data
 .rodata        0x0000000008016ea8      0x101 ${vitis_install}/gnu/aarch32/nt/gcc-arm-none-eabi/bin//../aarch32-xilinx-eabi/usr/lib/thumb/v7-a+fp/hard\libc.a(lib_a-ctype_.o)
                0x0000000008016ea8                _ctype_
 *fill*         0x0000000008016fa9        0x3 
 .rodata        0x0000000008016fac        0x4 ${vitis_install}/gnu/aarch32/nt/gcc-arm-none-eabi/bin//../aarch32-xilinx-eabi/usr/lib/thumb/v7-a+fp/hard\libc.a(lib_a-impure.o)
                0x0000000008016fac                _global_impure_ptr
 .rodata        0x0000000008016fb0       0x20 ${vitis_install}/gnu/aarch32/nt/gcc-arm-none-eabi/bin//../aarch32-xilinx-eabi/usr/lib/thumb/v7-a+fp/hard\libc.a(lib_a-svfprintf.o)
 .rodata        0x0000000008016fd0      0x128 ${vitis_install}/gnu/aarch32/nt/gcc-arm-none-eabi/bin//../aarch32-xilinx-eabi/usr/lib/thumb/v7-a+fp/hard\libc.a(lib_a-mprec.o)
                0x0000000008016fe0                __mprec_tens
                0x00000000080170a8                __mprec_tinytens
                0x00000000080170d0                __mprec_bigtens
 .rodata        0x00000000080170f8       0x20 ${vitis_install}/gnu/aarch32/nt/gcc-arm-none-eabi/bin//../aarch32-xilinx-eabi/usr/lib/thumb/v7-a+fp/hard\libc.a(lib_a-svfiprintf.o)
 .rodata        0x0000000008017118       0x20 ${vitis_install}/gnu/aarch32/nt/gcc-arm-none-eabi/bin//../aarch32-xilinx-eabi/usr/lib/thumb/v7-a+fp/hard\libc.a(lib_a-vfiprintf.o)
 *(.rodata.*)
 .rodata.BIRD_LP_Q30
                0x0000000008017138       0x14 ${package_root}\build\out\work\services\core1\build\6_bird_frontend.o
 .rodata.BIRD_HP_Q30
                0x000000000801714c       0x14 ${package_root}\build\out\work\services\core1\build\6_bird_frontend.o
 .rodata.lag_limit
                0x0000000008017160        0x6 ${package_root}\build\out\work\services\core1\build\8_gcc_phat.o
 *fill*         0x0000000008017166        0x2 
 .rodata.pair_b
                0x0000000008017168        0x6 ${package_root}\build\out\work\services\core1\build\8_gcc_phat.o
 *fill*         0x000000000801716e        0x2 
 .rodata.pair_a
                0x0000000008017170        0x6 ${package_root}\build\out\work\services\core1\build\8_gcc_phat.o
 *fill*         0x0000000008017176        0x2 
 .rodata.main.str1.4
                0x0000000008017178       0x14 ${package_root}\build\out\work\services\core1\build\9_main.o
 .rodata.g_mel128_table
                0x000000000801718c      0x500 ${package_root}\build\out\work\services\core1\build\11_mel_table.o
                0x000000000801718c                g_mel128_table
 .rodata.mic_y  0x000000000801768c       0x10 ${package_root}\build\out\work\services\core1\build\15_tdoa_solver.o
 .rodata.mic_x  0x000000000801769c       0x10 ${package_root}\build\out\work\services\core1\build\15_tdoa_solver.o
 .rodata.pair_b
                0x00000000080176ac        0x6 ${package_root}\build\out\work\services\core1\build\15_tdoa_solver.o
 *fill*         0x00000000080176b2        0x2 
 .rodata.pair_a
                0x00000000080176b4        0x6 ${package_root}\build\out\work\services\core1\build\15_tdoa_solver.o
 *fill*         0x00000000080176ba        0x2 
 .rodata.outnum.str1.4
                0x00000000080176bc       0x11 ${package_root}\build\out\work\services\core1\build\18_xil_printf.o
 *fill*         0x00000000080176cd        0x3 
 .rodata.logmel_pl_frame.str1.4
                0x00000000080176d0       0x25 ${package_root}\build\out\work\services\core1\build\20_logmel_pl.o
 *fill*         0x00000000080176f5        0x3 
 .rodata.next_name.str1.4
                0x00000000080176f8       0x17 ${package_root}\build\out\work\services\core1\build\21_sd_writer.o
 *fill*         0x000000000801770f        0x1 
 .rodata.sd_writer_poll.str1.4
                0x0000000008017710       0x40 ${package_root}\build\out\work\services\core1\build\21_sd_writer.o
 .rodata.days.0
                0x0000000008017750        0xc ${package_root}\build\out\work\services\core1\build\21_sd_writer.o
 .rodata.follow_path.str1.4
                0x000000000801775c       0x13 ${package_root}\build\out\work\services\core1\build\23_ff.o
 *fill*         0x000000000801776f        0x1 
 .rodata.check_fs.str1.4
                0x0000000008017770        0x9 ${package_root}\build\out\work\services\core1\build\23_ff.o
 *fill*         0x0000000008017779        0x3 
 .rodata.ExCvt  0x000000000801777c       0x80 ${package_root}\build\out\work\services\core1\build\23_ff.o
 .rodata.LfnOfs
                0x00000000080177fc        0xd ${package_root}\build\out\work\services\core1\build\23_ff.o
 *fill*         0x0000000008017809        0x3 
 .rodata.cvt2.0
                0x000000000801780c       0xbc ${package_root}\build\out\work\services\core1\build\24_ffunicode.o
 .rodata.cvt1.1
                0x00000000080178c8      0x1f2 ${package_root}\build\out\work\services\core1\build\24_ffunicode.o
 *fill*         0x0000000008017aba        0x2 
 .rodata.uc437  0x0000000008017abc      0x100 ${package_root}\build\out\work\services\core1\build\24_ffunicode.o
 .rodata.XSdPs_CfgInitialize.str1.4
                0x0000000008017bbc       0x61 ${package_root}\build\out\work\services\core1\build\25_xsdps.o
 *fill*         0x0000000008017c1d        0x3 
 .rodata.XSdPs_Change_ClkFreq.str1.4
                0x0000000008017c20       0x69 ${package_root}\build\out\work\services\core1\build\28_xsdps_options.o
 .rodata.str1.4
                0x0000000008017c89       0x69 ${vitis_install}/gnu/aarch32/nt/gcc-arm-none-eabi/bin//../aarch32-xilinx-eabi/usr/lib/thumb/v7-a+fp/hard\libm.a(lib_a-wf_log10.o)
                                          0x1 (size before relaxing)
 *fill*         0x0000000008017c89        0x3 
 .rodata.str1.4
                0x0000000008017c8c       0x2e ${vitis_install}/gnu/aarch32/nt/gcc-arm-none-eabi/bin//../aarch32-xilinx-eabi/usr/lib/thumb/v7-a+fp/hard\libc.a(lib_a-svfprintf.o)
                                         0x42 (size before relaxing)
 *fill*         0x0000000008017cba        0x2 
 .rodata.str1.4
                0x0000000008017cbc       0x69 ${vitis_install}/gnu/aarch32/nt/gcc-arm-none-eabi/bin//../aarch32-xilinx-eabi/usr/lib/thumb/v7-a+fp/hard\libc.a(lib_a-dtoa.o)
                                         0x6d (size before relaxing)
 *fill*         0x0000000008017d25        0x3 
 .rodata.str1.4
                0x0000000008017d28        0xe ${vitis_install}/gnu/aarch32/nt/gcc-arm-none-eabi/bin//../aarch32-xilinx-eabi/usr/lib/thumb/v7-a+fp/hard\libc.a(lib_a-locale.o)
                                         0x12 (size before relaxing)
 *fill*         0x0000000008017d36        0x2 
 .rodata.str1.4
                0x0000000008017d38       0x46 ${vitis_install}/gnu/aarch32/nt/gcc-arm-none-eabi/bin//../aarch32-xilinx-eabi/usr/lib/thumb/v7-a+fp/hard\libc.a(lib_a-mprec.o)
                                         0x5a (size before relaxing)
 .rodata.str1.4
                0x0000000008017d7e       0x2f ${vitis_install}/gnu/aarch32/nt/gcc-arm-none-eabi/bin//../aarch32-xilinx-eabi/usr/lib/thumb/v7-a+fp/hard\libc.a(lib_a-svfiprintf.o)
 *fill*         0x0000000008017d7e        0x2 
 .rodata.str1.4
                0x0000000008017d80       0x3f ${vitis_install}/gnu/aarch32/nt/gcc-arm-none-eabi/bin//../aarch32-xilinx-eabi/usr/lib/thumb/v7-a+fp/hard\libc.a(lib_a-assert.o)
                                         0x43 (size before relaxing)
 .rodata.str1.4
                0x0000000008017dbf       0x2f ${vitis_install}/gnu/aarch32/nt/gcc-arm-none-eabi/bin//../aarch32-xilinx-eabi/usr/lib/thumb/v7-a+fp/hard\libc.a(lib_a-vfiprintf.o)
 *(.gnu.linkonce.r.*)
                0x0000000008017dbf                __rodata_end = .

.rodata1        0x0000000008017dbf        0x0
                0x0000000008017dbf                __rodata1_start = .
 *(.rodata1)
 *(.rodata1.*)
                0x0000000008017dbf                __rodata1_end = .

.sdata2         0x0000000008017dbf        0x0
                0x0000000008017dbf                __sdata2_start = .
 *(.sdata2)
 *(.sdata2.*)
 *(.gnu.linkonce.s2.*)
                0x0000000008017dbf                __sdata2_end = .

.sbss2          0x0000000008017dbf        0x0
                0x0000000008017dbf                __sbss2_start = .
 *(.sbss2)
 *(.sbss2.*)
 *(.gnu.linkonce.sb2.*)
                0x0000000008017dbf                __sbss2_end = .

.data           0x0000000008017dc0      0xa40
                0x0000000008017dc0                __data_start = .
 *(.data)
 .data          0x0000000008017dc0        0x4 ${package_root}\build\out\work\platform\bsp_core1\lib\libxil.a(xil_assert.o)
                0x0000000008017dc0                Xil_AssertWait
 .data          0x0000000008017dc4       0x38 ${package_root}\build\out\work\platform\bsp_core1\lib\libxil.a(xil_exception.o)
                0x0000000008017dc4                XExc_VectorTable
 *fill*         0x0000000008017dfc        0x4 
 .data          0x0000000008017e00      0x430 ${vitis_install}/gnu/aarch32/nt/gcc-arm-none-eabi/bin//../aarch32-xilinx-eabi/usr/lib/thumb/v7-a+fp/hard\libc.a(lib_a-impure.o)
                0x0000000008017e00                _impure_ptr
 .data          0x0000000008018230      0x410 ${vitis_install}/gnu/aarch32/nt/gcc-arm-none-eabi/bin//../aarch32-xilinx-eabi/usr/lib/thumb/v7-a+fp/hard\libc.a(lib_a-mallocr.o)
                0x0000000008018230                __malloc_av_
                0x0000000008018638                __malloc_sbrk_base
                0x000000000801863c                __malloc_trim_threshold
 .data          0x0000000008018640      0x16c ${vitis_install}/gnu/aarch32/nt/gcc-arm-none-eabi/bin//../aarch32-xilinx-eabi/usr/lib/thumb/v7-a+fp/hard\libc.a(lib_a-locale.o)
                0x0000000008018640                __global_locale
 *(.data.*)
 .data.audio_direction_probe_interval
                0x00000000080187ac        0x4 ${package_root}\build\out\work\services\core1\build\4_audio_worker.o
                0x00000000080187ac                audio_direction_probe_interval
 .data.steering_valid
                0x00000000080187b0        0x4 ${package_root}\build\out\work\services\core1\build\5_beamform.o
 .data.channel_mask
                0x00000000080187b4        0x1 ${package_root}\build\out\work\services\core1\build\5_beamform.o
 *fill*         0x00000000080187b5        0x3 
 .data.capture_samples
                0x00000000080187b8        0x4 ${package_root}\build\out\work\services\core1\build\19_model_logmel32_pl.o
 .data.slot     0x00000000080187bc        0x4 ${package_root}\build\out\work\services\core1\build\21_sd_writer.o
 .data.state    0x00000000080187c0        0x1 ${package_root}\build\out\work\services\core1\build\22_sd_disk.o
 *fill*         0x00000000080187c1        0x3 
 .data.config   0x00000000080187c4       0x3c ${package_root}\build\out\work\services\core1\build\22_sd_disk.o
 *(.gnu.linkonce.d.*)
 *(.jcr)
 *(.got)
 *(.got.plt)
                0x0000000008018800                __data_end = .

.tm_clone_table
                0x0000000008018800        0x0
 .tm_clone_table
                0x0000000008018800        0x0 ${vitis_install}/gnu/aarch32/nt/gcc-arm-none-eabi/bin//../aarch32-xilinx-eabi/usr/lib/thumb/v7-a+fp/hard/crtbegin.o
 .tm_clone_table
                0x0000000008018800        0x0 ${vitis_install}/gnu/aarch32/nt/gcc-arm-none-eabi/bin//../aarch32-xilinx-eabi/usr/lib/thumb/v7-a+fp/hard/crtend.o

.igot.plt       0x0000000008018800        0x0
 .igot.plt      0x0000000008018800        0x0 ${vitis_install}/gnu/aarch32/nt/gcc-arm-none-eabi/bin//../aarch32-xilinx-eabi/usr/lib/thumb/v7-a+fp/hard/crtbegin.o

.data1          0x0000000008018800        0x0
                0x0000000008018800                __data1_start = .
 *(.data1)
 *(.data1.*)
                0x0000000008018800                __data1_end = .

.got
 *(.got)

.ctors          0x0000000008018800        0x0
                0x0000000008018800                __CTOR_LIST__ = .
                0x0000000008018800                ___CTORS_LIST___ = .
 *crtbegin.o(.ctors)
 *(EXCLUDE_FILE(*crtend.o) .ctors)
 *(SORT_BY_NAME(.ctors.*))
 *(.ctors)
                0x0000000008018800                __CTOR_END__ = .
                0x0000000008018800                ___CTORS_END___ = .

.dtors          0x0000000008018800        0x0
                0x0000000008018800                __DTOR_LIST__ = .
                0x0000000008018800                ___DTORS_LIST___ = .
 *crtbegin.o(.dtors)
 *(EXCLUDE_FILE(*crtend.o) .dtors)
 *(SORT_BY_NAME(.dtors.*))
 *(.dtors)
                0x0000000008018800                __DTOR_END__ = .
                0x0000000008018800                ___DTORS_END___ = .

.fixup          0x0000000008018800        0x0
                0x0000000008018800                __fixup_start = .
 *(.fixup)
                0x0000000008018800                __fixup_end = .

.eh_frame       0x0000000008018800        0x0
 *(.eh_frame)
 .eh_frame      0x0000000008018800        0x0 ${vitis_install}/gnu/aarch32/nt/gcc-arm-none-eabi/bin//../aarch32-xilinx-eabi/usr/lib/thumb/v7-a+fp/hard/crtbegin.o

.eh_framehdr    0x0000000008018800        0x0
                0x0000000008018800                __eh_framehdr_start = .
 *(.eh_framehdr)
                0x0000000008018800                __eh_framehdr_end = .

.gcc_except_table
 *(.gcc_except_table)

.mmu_tbl        0x000000000801c000     0x4000
                0x000000000801c000                __mmu_tbl_start = .
 *(.mmu_tbl)
 .mmu_tbl       0x000000000801c000     0x4000 ${package_root}\build\out\work\platform\bsp_core1\lib\libxil.a(translation_table.o)
                0x000000000801c000                MMUTable
                0x0000000008020000                __mmu_tbl_end = .

.ARM.exidx      0x0000000008020000        0x8
                0x0000000008020000                __exidx_start = .
 *(.ARM.exidx*)
 .ARM.exidx     0x0000000008020000        0x8 ${vitis_install}/gnu/aarch32/nt/gcc-arm-none-eabi/bin//../aarch32-xilinx-eabi/usr/lib/thumb/v7-a+fp/hard\libgcc.a(_udivmoddi4.o)
 *(.gnu.linkonce.armexidix.*.*)
                0x0000000008020008                __exidx_end = .

.rel.dyn        0x0000000008020008        0x0
 .rel.iplt      0x0000000008020008        0x0 ${vitis_install}/gnu/aarch32/nt/gcc-arm-none-eabi/bin//../aarch32-xilinx-eabi/usr/lib/thumb/v7-a+fp/hard/crtbegin.o

.preinit_array  0x0000000008020008        0x0
                0x0000000008020008                __preinit_array_start = .
 *(SORT_BY_NAME(.preinit_array.*))
 *(.preinit_array)
                0x0000000008020008                __preinit_array_end = .

.init_array     0x0000000008020008        0x4
                0x0000000008020008                __init_array_start = .
 *(SORT_BY_NAME(.init_array.*))
 *(.init_array)
 .init_array    0x0000000008020008        0x4 ${vitis_install}/gnu/aarch32/nt/gcc-arm-none-eabi/bin//../aarch32-xilinx-eabi/usr/lib/thumb/v7-a+fp/hard/crtbegin.o
                0x000000000802000c                __init_array_end = .

.fini_array     0x000000000802000c        0x4
                0x000000000802000c                __fini_array_start = .
 *(SORT_BY_NAME(.fini_array.*))
 *(.fini_array)
 .fini_array    0x000000000802000c        0x4 ${vitis_install}/gnu/aarch32/nt/gcc-arm-none-eabi/bin//../aarch32-xilinx-eabi/usr/lib/thumb/v7-a+fp/hard/crtbegin.o
                0x0000000008020010                __fini_array_end = .

.ARM.attributes
                0x0000000008020010       0x33
                0x0000000008020010                __ARM.attributes_start = .
 *(.ARM.attributes)
 .ARM.attributes
                0x0000000008020010       0x21 ${vitis_install}/gnu/aarch32/nt/gcc-arm-none-eabi/bin//../aarch32-xilinx-eabi/usr/lib/thumb/v7-a+fp/hard/crti.o
 .ARM.attributes
                0x0000000008020031       0x33 ${vitis_install}/gnu/aarch32/nt/gcc-arm-none-eabi/bin//../aarch32-xilinx-eabi/usr/lib/thumb/v7-a+fp/hard/crtbegin.o
 .ARM.attributes
                0x0000000008020064       0x37 ${package_root}\build\out\work\services\core1\build\0_audio_eth_adapter.o
 .ARM.attributes
                0x000000000802009b       0x37 ${package_root}\build\out\work\services\core1\build\1_audio_health.o
 .ARM.attributes
                0x00000000080200d2       0x37 ${package_root}\build\out\work\services\core1\build\2_audio_model_input.o
 .ARM.attributes
                0x0000000008020109       0x37 ${package_root}\build\out\work\services\core1\build\3_audio_quality.o
 .ARM.attributes
                0x0000000008020140       0x37 ${package_root}\build\out\work\services\core1\build\4_audio_worker.o
 .ARM.attributes
                0x0000000008020177       0x37 ${package_root}\build\out\work\services\core1\build\5_beamform.o
 .ARM.attributes
                0x00000000080201ae       0x37 ${package_root}\build\out\work\services\core1\build\6_bird_frontend.o
 .ARM.attributes
                0x00000000080201e5       0x37 ${package_root}\build\out\work\services\core1\build\7_fft_q15.o
 .ARM.attributes
                0x000000000802021c       0x37 ${package_root}\build\out\work\services\core1\build\8_gcc_phat.o
 .ARM.attributes
                0x0000000008020253       0x37 ${package_root}\build\out\work\services\core1\build\9_main.o
 .ARM.attributes
                0x000000000802028a       0x37 ${package_root}\build\out\work\services\core1\build\10_mel128.o
 .ARM.attributes
                0x00000000080202c1       0x37 ${package_root}\build\out\work\services\core1\build\11_mel_table.o
 .ARM.attributes
                0x00000000080202f8       0x37 ${package_root}\build\out\work\services\core1\build\12_noise_reduce.o
 .ARM.attributes
                0x000000000802032f       0x37 ${package_root}\build\out\work\services\core1\build\13_platform_port.o
 .ARM.attributes
                0x0000000008020366       0x37 ${package_root}\build\out\work\services\core1\build\14_shared_ring.o
 .ARM.attributes
                0x000000000802039d       0x37 ${package_root}\build\out\work\services\core1\build\15_tdoa_solver.o
 .ARM.attributes
                0x00000000080203d4       0x37 ${package_root}\build\out\work\services\core1\build\16_fusion_math.o
 .ARM.attributes
                0x000000000802040b       0x37 ${package_root}\build\out\work\services\core1\build\17_fusion_audio.o
 .ARM.attributes
                0x0000000008020442       0x37 ${package_root}\build\out\work\services\core1\build\18_xil_printf.o
 .ARM.attributes
                0x0000000008020479       0x37 ${package_root}\build\out\work\services\core1\build\19_model_logmel32_pl.o
 .ARM.attributes
                0x00000000080204b0       0x37 ${package_root}\build\out\work\services\core1\build\20_logmel_pl.o
 .ARM.attributes
                0x00000000080204e7       0x37 ${package_root}\build\out\work\services\core1\build\21_sd_writer.o
 .ARM.attributes
                0x000000000802051e       0x37 ${package_root}\build\out\work\services\core1\build\22_sd_disk.o
 .ARM.attributes
                0x0000000008020555       0x37 ${package_root}\build\out\work\services\core1\build\23_ff.o
 .ARM.attributes
                0x000000000802058c       0x37 ${package_root}\build\out\work\services\core1\build\24_ffunicode.o
 .ARM.attributes
                0x00000000080205c3       0x37 ${package_root}\build\out\work\services\core1\build\25_xsdps.o
 .ARM.attributes
                0x00000000080205fa       0x37 ${package_root}\build\out\work\services\core1\build\26_xsdps_card.o
 .ARM.attributes
                0x0000000008020631       0x37 ${package_root}\build\out\work\services\core1\build\27_xsdps_host.o
 .ARM.attributes
                0x0000000008020668       0x37 ${package_root}\build\out\work\services\core1\build\28_xsdps_options.o
 .ARM.attributes
                0x000000000802069f       0x29 ${package_root}\build\out\work\platform\bsp_core1\lib\libxil.a(boot.o)
 .ARM.attributes
                0x00000000080206c8       0x3d ${package_root}\build\out\work\platform\bsp_core1\lib\libxil.a(outbyte.o)
 .ARM.attributes
                0x0000000008020705       0x29 ${package_root}\build\out\work\platform\bsp_core1\lib\libxil.a(translation_table.o)
 .ARM.attributes
                0x000000000802072e       0x3d ${package_root}\build\out\work\platform\bsp_core1\lib\libxil.a(vectors.o)
 .ARM.attributes
                0x000000000802076b       0x29 ${package_root}\build\out\work\platform\bsp_core1\lib\libxil.a(xil-crt0.o)
 .ARM.attributes
                0x0000000008020794       0x3d ${package_root}\build\out\work\platform\bsp_core1\lib\libxil.a(xil_assert.o)
 .ARM.attributes
                0x00000000080207d1       0x3d ${package_root}\build\out\work\platform\bsp_core1\lib\libxil.a(xil_cache.o)
 .ARM.attributes
                0x000000000802080e       0x3d ${package_root}\build\out\work\platform\bsp_core1\lib\libxil.a(xil_exception.o)
 .ARM.attributes
                0x000000000802084b       0x3d ${package_root}\build\out\work\platform\bsp_core1\lib\libxil.a(xil_mmu.o)
 .ARM.attributes
                0x0000000008020888       0x3d ${package_root}\build\out\work\platform\bsp_core1\lib\libxil.a(xtime_l.o)
 .ARM.attributes
                0x00000000080208c5       0x3d ${package_root}\build\out\work\platform\bsp_core1\lib\libxil.a(xuartps_hw.o)
 .ARM.attributes
                0x0000000008020902       0x29 ${package_root}\build\out\work\platform\bsp_core1\lib\libxil.a(cpu_init.o)
 .ARM.attributes
                0x000000000802092b       0x33 ${vitis_install}/gnu/aarch32/nt/gcc-arm-none-eabi/bin//../aarch32-xilinx-eabi/usr/lib/thumb/v7-a+fp/hard\libm.a(lib_a-cosf.o)
 .ARM.attributes
                0x000000000802095e       0x33 ${vitis_install}/gnu/aarch32/nt/gcc-arm-none-eabi/bin//../aarch32-xilinx-eabi/usr/lib/thumb/v7-a+fp/hard\libm.a(lib_a-math_errf.o)
 .ARM.attributes
                0x0000000008020991       0x33 ${vitis_install}/gnu/aarch32/nt/gcc-arm-none-eabi/bin//../aarch32-xilinx-eabi/usr/lib/thumb/v7-a+fp/hard\libm.a(lib_a-sf_exp.o)
 .ARM.attributes
                0x00000000080209c4       0x33 ${vitis_install}/gnu/aarch32/nt/gcc-arm-none-eabi/bin//../aarch32-xilinx-eabi/usr/lib/thumb/v7-a+fp/hard\libm.a(lib_a-sf_floor.o)
 .ARM.attributes
                0x00000000080209f7       0x33 ${vitis_install}/gnu/aarch32/nt/gcc-arm-none-eabi/bin//../aarch32-xilinx-eabi/usr/lib/thumb/v7-a+fp/hard\libm.a(lib_a-sf_fmax.o)
 .ARM.attributes
                0x0000000008020a2a       0x33 ${vitis_install}/gnu/aarch32/nt/gcc-arm-none-eabi/bin//../aarch32-xilinx-eabi/usr/lib/thumb/v7-a+fp/hard\libm.a(lib_a-sf_fmin.o)
 .ARM.attributes
                0x0000000008020a5d       0x33 ${vitis_install}/gnu/aarch32/nt/gcc-arm-none-eabi/bin//../aarch32-xilinx-eabi/usr/lib/thumb/v7-a+fp/hard\libm.a(lib_a-sf_fpclassify.o)
 .ARM.attributes
                0x0000000008020a90       0x33 ${vitis_install}/gnu/aarch32/nt/gcc-arm-none-eabi/bin//../aarch32-xilinx-eabi/usr/lib/thumb/v7-a+fp/hard\libm.a(lib_a-sf_lrint.o)
 .ARM.attributes
                0x0000000008020ac3       0x33 ${vitis_install}/gnu/aarch32/nt/gcc-arm-none-eabi/bin//../aarch32-xilinx-eabi/usr/lib/thumb/v7-a+fp/hard\libm.a(lib_a-sincosf_data.o)
 .ARM.attributes
                0x0000000008020af6       0x33 ${vitis_install}/gnu/aarch32/nt/gcc-arm-none-eabi/bin//../aarch32-xilinx-eabi/usr/lib/thumb/v7-a+fp/hard\libm.a(lib_a-sinf.o)
 .ARM.attributes
                0x0000000008020b29       0x33 ${vitis_install}/gnu/aarch32/nt/gcc-arm-none-eabi/bin//../aarch32-xilinx-eabi/usr/lib/thumb/v7-a+fp/hard\libm.a(lib_a-wf_atan2.o)
 .ARM.attributes
                0x0000000008020b5c       0x33 ${vitis_install}/gnu/aarch32/nt/gcc-arm-none-eabi/bin//../aarch32-xilinx-eabi/usr/lib/thumb/v7-a+fp/hard\libm.a(lib_a-wf_log10.o)
 .ARM.attributes
                0x0000000008020b8f       0x33 ${vitis_install}/gnu/aarch32/nt/gcc-arm-none-eabi/bin//../aarch32-xilinx-eabi/usr/lib/thumb/v7-a+fp/hard\libm.a(lib_a-wf_sqrt.o)
 .ARM.attributes
                0x0000000008020bc2       0x33 ${vitis_install}/gnu/aarch32/nt/gcc-arm-none-eabi/bin//../aarch32-xilinx-eabi/usr/lib/thumb/v7-a+fp/hard\libm.a(lib_a-w_sqrt.o)
 .ARM.attributes
                0x0000000008020bf5       0x33 ${vitis_install}/gnu/aarch32/nt/gcc-arm-none-eabi/bin//../aarch32-xilinx-eabi/usr/lib/thumb/v7-a+fp/hard\libm.a(lib_a-ef_atan2.o)
 .ARM.attributes
                0x0000000008020c28       0x33 ${vitis_install}/gnu/aarch32/nt/gcc-arm-none-eabi/bin//../aarch32-xilinx-eabi/usr/lib/thumb/v7-a+fp/hard\libm.a(lib_a-ef_log10.o)
 .ARM.attributes
                0x0000000008020c5b       0x33 ${vitis_install}/gnu/aarch32/nt/gcc-arm-none-eabi/bin//../aarch32-xilinx-eabi/usr/lib/thumb/v7-a+fp/hard\libm.a(lib_a-ef_sqrt.o)
 .ARM.attributes
                0x0000000008020c8e       0x33 ${vitis_install}/gnu/aarch32/nt/gcc-arm-none-eabi/bin//../aarch32-xilinx-eabi/usr/lib/thumb/v7-a+fp/hard\libm.a(lib_a-e_sqrt.o)
 .ARM.attributes
                0x0000000008020cc1       0x33 ${vitis_install}/gnu/aarch32/nt/gcc-arm-none-eabi/bin//../aarch32-xilinx-eabi/usr/lib/thumb/v7-a+fp/hard\libm.a(lib_a-sf_atan.o)
 .ARM.attributes
                0x0000000008020cf4       0x33 ${vitis_install}/gnu/aarch32/nt/gcc-arm-none-eabi/bin//../aarch32-xilinx-eabi/usr/lib/thumb/v7-a+fp/hard\libm.a(lib_a-sf_exp2_data.o)
 .ARM.attributes
                0x0000000008020d27       0x33 ${vitis_install}/gnu/aarch32/nt/gcc-arm-none-eabi/bin//../aarch32-xilinx-eabi/usr/lib/thumb/v7-a+fp/hard\libm.a(lib_a-sf_fabs.o)
 .ARM.attributes
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
 .ARM.attributes
                0x00000000080216da       0x33 ${vitis_install}/gnu/aarch32/nt/gcc-arm-none-eabi/bin//../aarch32-xilinx-eabi/usr/lib/thumb/v7-a+fp/hard\libc.a(lib_a-fvwrite.o)
 .ARM.attributes
                0x000000000802170d       0x33 ${vitis_install}/gnu/aarch32/nt/gcc-arm-none-eabi/bin//../aarch32-xilinx-eabi/usr/lib/thumb/v7-a+fp/hard\libc.a(lib_a-fwalk.o)
 .ARM.attributes
                0x0000000008021740       0x33 ${vitis_install}/gnu/aarch32/nt/gcc-arm-none-eabi/bin//../aarch32-xilinx-eabi/usr/lib/thumb/v7-a+fp/hard\libc.a(lib_a-makebuf.o)
 .ARM.attributes
                0x0000000008021773       0x33 ${vitis_install}/gnu/aarch32/nt/gcc-arm-none-eabi/bin//../aarch32-xilinx-eabi/usr/lib/thumb/v7-a+fp/hard\libc.a(lib_a-signal.o)
 .ARM.attributes
                0x00000000080217a6       0x33 ${vitis_install}/gnu/aarch32/nt/gcc-arm-none-eabi/bin//../aarch32-xilinx-eabi/usr/lib/thumb/v7-a+fp/hard\libc.a(lib_a-signalr.o)
 .ARM.attributes
                0x00000000080217d9       0x33 ${vitis_install}/gnu/aarch32/nt/gcc-arm-none-eabi/bin//../aarch32-xilinx-eabi/usr/lib/thumb/v7-a+fp/hard\libc.a(lib_a-stdio.o)
 .ARM.attributes
                0x000000000802180c       0x33 ${vitis_install}/gnu/aarch32/nt/gcc-arm-none-eabi/bin//../aarch32-xilinx-eabi/usr/lib/thumb/v7-a+fp/hard\libc.a(lib_a-wbuf.o)
 .ARM.attributes
                0x000000000802183f       0x33 ${vitis_install}/gnu/aarch32/nt/gcc-arm-none-eabi/bin//../aarch32-xilinx-eabi/usr/lib/thumb/v7-a+fp/hard\libc.a(lib_a-wcrtomb.o)
 .ARM.attributes
                0x0000000008021872       0x33 ${vitis_install}/gnu/aarch32/nt/gcc-arm-none-eabi/bin//../aarch32-xilinx-eabi/usr/lib/thumb/v7-a+fp/hard\libc.a(lib_a-writer.o)
 .ARM.attributes
                0x00000000080218a5       0x33 ${vitis_install}/gnu/aarch32/nt/gcc-arm-none-eabi/bin//../aarch32-xilinx-eabi/usr/lib/thumb/v7-a+fp/hard\libc.a(lib_a-closer.o)
 .ARM.attributes
                0x00000000080218d8       0x33 ${vitis_install}/gnu/aarch32/nt/gcc-arm-none-eabi/bin//../aarch32-xilinx-eabi/usr/lib/thumb/v7-a+fp/hard\libc.a(lib_a-fclose.o)
 .ARM.attributes
                0x000000000802190b       0x33 ${vitis_install}/gnu/aarch32/nt/gcc-arm-none-eabi/bin//../aarch32-xilinx-eabi/usr/lib/thumb/v7-a+fp/hard\libc.a(lib_a-fstatr.o)
 .ARM.attributes
                0x000000000802193e       0x33 ${vitis_install}/gnu/aarch32/nt/gcc-arm-none-eabi/bin//../aarch32-xilinx-eabi/usr/lib/thumb/v7-a+fp/hard\libc.a(lib_a-isattyr.o)
 .ARM.attributes
                0x0000000008021971       0x33 ${vitis_install}/gnu/aarch32/nt/gcc-arm-none-eabi/bin//../aarch32-xilinx-eabi/usr/lib/thumb/v7-a+fp/hard\libc.a(lib_a-lseekr.o)
 .ARM.attributes
                0x00000000080219a4       0x33 ${vitis_install}/gnu/aarch32/nt/gcc-arm-none-eabi/bin//../aarch32-xilinx-eabi/usr/lib/thumb/v7-a+fp/hard\libc.a(lib_a-readr.o)
 .ARM.attributes
                0x00000000080219d7       0x3d ${package_root}\build\out\work\platform\bsp_core1\lib\libxil.a(_exit.o)
 .ARM.attributes
                0x0000000008021a14       0x3d ${package_root}\build\out\work\platform\bsp_core1\lib\libxil.a(_sbrk.o)
 .ARM.attributes
                0x0000000008021a51       0x3d ${package_root}\build\out\work\platform\bsp_core1\lib\libxil.a(close.o)
 .ARM.attributes
                0x0000000008021a8e       0x3d ${package_root}\build\out\work\platform\bsp_core1\lib\libxil.a(fstat.o)
 .ARM.attributes
                0x0000000008021acb       0x3d ${package_root}\build\out\work\platform\bsp_core1\lib\libxil.a(getpid.o)
 .ARM.attributes
                0x0000000008021b08       0x3d ${package_root}\build\out\work\platform\bsp_core1\lib\libxil.a(isatty.o)
 .ARM.attributes
                0x0000000008021b45       0x3d ${package_root}\build\out\work\platform\bsp_core1\lib\libxil.a(kill.o)
 .ARM.attributes
                0x0000000008021b82       0x3d ${package_root}\build\out\work\platform\bsp_core1\lib\libxil.a(lseek.o)
 .ARM.attributes
                0x0000000008021bbf       0x3d ${package_root}\build\out\work\platform\bsp_core1\lib\libxil.a(read.o)
 .ARM.attributes
                0x0000000008021bfc       0x3d ${package_root}\build\out\work\platform\bsp_core1\lib\libxil.a(write.o)
 .ARM.attributes
                0x0000000008021c39       0x3d ${package_root}\build\out\work\platform\bsp_core1\lib\libxil.a(inbyte.o)
 .ARM.attributes
                0x0000000008021c76       0x33 ${vitis_install}/gnu/aarch32/nt/gcc-arm-none-eabi/bin//../aarch32-xilinx-eabi/usr/lib/thumb/v7-a+fp/hard/crtend.o
 .ARM.attributes
                0x0000000008021ca9       0x21 ${vitis_install}/gnu/aarch32/nt/gcc-arm-none-eabi/bin//../aarch32-xilinx-eabi/usr/lib/thumb/v7-a+fp/hard/crtn.o
                0x0000000008021cca                __ARM.attributes_end = .

.sdata          0x0000000008020010        0x0
                0x0000000008020010                __sdata_start = .
 *(.sdata)
 *(.sdata.*)
 *(.gnu.linkonce.s.*)
                0x0000000008020010                __sdata_end = .

.sbss           0x0000000008020010        0x0
                0x0000000008020010                __sbss_start = .
 *(.sbss)
 *(.sbss.*)
 *(.gnu.linkonce.sb.*)
                0x0000000008020010                __sbss_end = .

.tdata          0x0000000008020010        0x0
                0x0000000008020010                __tdata_start = .
 *(.tdata)
 *(.tdata.*)
 *(.gnu.linkonce.td.*)
                0x0000000008020010                __tdata_end = .

.tbss           0x0000000008020010        0x0
                0x0000000008020010                __tbss_start = .
 *(.tbss)
 *(.tbss.*)
 *(.gnu.linkonce.tb.*)
                0x0000000008020010                __tbss_end = .
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
