Ji-Shawn/Bird-detection-classification-tracking/build/receipts/arm_rebuild_20261103/fsbl_build.txt

${vitis_install}\gnu\aarch32\nt\gcc-arm-none-eabi\bin\arm-none-eabi-gcc.exe -mcpu=cortex-a9 -mfpu=vfpv3 -mfloat-abi=hard -O2 -g -DFSBL_DEBUG_INFO -I${package_root}\build\out\boot\fsbl -I${package_root}\build\out\work\application\build\fsbl -I${package_root}\build\out\work\application\build\fsbl\zynq_fsbl_bsp\ps7_cortexa9_0\include -c ${package_root}\build\out\work\application\build\fsbl\image_mover.c -o ${package_root}\build\out\boot\fsbl\image_mover.o
${vitis_install}\gnu\aarch32\nt\gcc-arm-none-eabi\bin\arm-none-eabi-gcc.exe -mcpu=cortex-a9 -mfpu=vfpv3 -mfloat-abi=hard -O2 -g -DFSBL_DEBUG_INFO -I${package_root}\build\out\boot\fsbl -I${package_root}\build\out\work\application\build\fsbl -I${package_root}\build\out\work\application\build\fsbl\zynq_fsbl_bsp\ps7_cortexa9_0\include -c ${package_root}\build\out\work\application\build\fsbl\main.c -o ${package_root}\build\out\boot\fsbl\main.o
${vitis_install}\gnu\aarch32\nt\gcc-arm-none-eabi\bin\arm-none-eabi-gcc.exe -mcpu=cortex-a9 -mfpu=vfpv3 -mfloat-abi=hard -O2 -g -DFSBL_DEBUG_INFO -I${package_root}\build\out\boot\fsbl -I${package_root}\build\out\work\application\build\fsbl -I${package_root}\build\out\work\application\build\fsbl\zynq_fsbl_bsp\ps7_cortexa9_0\include -c ${package_root}\build\out\work\application\build\fsbl\md5.c -o ${package_root}\build\out\boot\fsbl\md5.o
${vitis_install}\gnu\aarch32\nt\gcc-arm-none-eabi\bin\arm-none-eabi-gcc.exe -mcpu=cortex-a9 -mfpu=vfpv3 -mfloat-abi=hard -O2 -g -DFSBL_DEBUG_INFO -I${package_root}\build\out\boot\fsbl -I${package_root}\build\out\work\application\build\fsbl -I${package_root}\build\out\work\application\build\fsbl\zynq_fsbl_bsp\ps7_cortexa9_0\include -c ${package_root}\build\out\work\application\build\fsbl\nand.c -o ${package_root}\build\out\boot\fsbl\nand.o
${vitis_install}\gnu\aarch32\nt\gcc-arm-none-eabi\bin\arm-none-eabi-gcc.exe -mcpu=cortex-a9 -mfpu=vfpv3 -mfloat-abi=hard -O2 -g -DFSBL_DEBUG_INFO -I${package_root}\build\out\boot\fsbl -I${package_root}\build\out\work\application\build\fsbl -I${package_root}\build\out\work\application\build\fsbl\zynq_fsbl_bsp\ps7_cortexa9_0\include -c ${package_root}\build\out\work\application\build\fsbl\nor.c -o ${package_root}\build\out\boot\fsbl\nor.o
${vitis_install}\gnu\aarch32\nt\gcc-arm-none-eabi\bin\arm-none-eabi-gcc.exe -mcpu=cortex-a9 -mfpu=vfpv3 -mfloat-abi=hard -O2 -g -DFSBL_DEBUG_INFO -I${package_root}\build\out\boot\fsbl -I${package_root}\build\out\work\application\build\fsbl -I${package_root}\build\out\work\application\build\fsbl\zynq_fsbl_bsp\ps7_cortexa9_0\include -c ${package_root}\build\out\work\application\build\fsbl\pcap.c -o ${package_root}\build\out\boot\fsbl\pcap.o
${vitis_install}\gnu\aarch32\nt\gcc-arm-none-eabi\bin\arm-none-eabi-gcc.exe -mcpu=cortex-a9 -mfpu=vfpv3 -mfloat-abi=hard -O2 -g -DFSBL_DEBUG_INFO -I${package_root}\build\out\boot\fsbl -I${package_root}\build\out\work\application\build\fsbl -I${package_root}\build\out\work\application\build\fsbl\zynq_fsbl_bsp\ps7_cortexa9_0\include -c ${package_root}\build\out\work\application\build\fsbl\qspi.c -o ${package_root}\build\out\boot\fsbl\qspi.o
${vitis_install}\gnu\aarch32\nt\gcc-arm-none-eabi\bin\arm-none-eabi-gcc.exe -mcpu=cortex-a9 -mfpu=vfpv3 -mfloat-abi=hard -O2 -g -DFSBL_DEBUG_INFO -I${package_root}\build\out\boot\fsbl -I${package_root}\build\out\work\application\build\fsbl -I${package_root}\build\out\work\application\build\fsbl\zynq_fsbl_bsp\ps7_cortexa9_0\include -c ${package_root}\build\out\work\application\build\fsbl\rsa.c -o ${package_root}\build\out\boot\fsbl\rsa.o
${vitis_install}\gnu\aarch32\nt\gcc-arm-none-eabi\bin\arm-none-eabi-gcc.exe -mcpu=cortex-a9 -mfpu=vfpv3 -mfloat-abi=hard -O2 -g -DFSBL_DEBUG_INFO -I${package_root}\build\out\boot\fsbl -I${package_root}\build\out\work\application\build\fsbl -I${package_root}\build\out\work\application\build\fsbl\zynq_fsbl_bsp\ps7_cortexa9_0\include -c ${package_root}\build\out\work\application\build\fsbl\sd.c -o ${package_root}\build\out\boot\fsbl\sd.o
${vitis_install}\gnu\aarch32\nt\gcc-arm-none-eabi\bin\arm-none-eabi-gcc.exe -mcpu=cortex-a9 -mfpu=vfpv3 -mfloat-abi=hard -O2 -g -DFSBL_DEBUG_INFO -I${package_root}\build\out\boot\fsbl -I${package_root}\build\out\work\application\build\fsbl -I${package_root}\build\out\work\application\build\fsbl\zynq_fsbl_bsp\ps7_cortexa9_0\include -c ${package_root}\build\out\boot\fsbl\ps7_init.c -o ${package_root}\build\out\boot\fsbl\ps7_init.o
${vitis_install}\gnu\aarch32\nt\gcc-arm-none-eabi\bin\arm-none-eabi-gcc.exe -mcpu=cortex-a9 -mfpu=vfpv3 -mfloat-abi=hard -O2 -g -DFSBL_DEBUG_INFO -I${package_root}\build\out\boot\fsbl -I${package_root}\build\out\work\application\build\fsbl -I${package_root}\build\out\work\application\build\fsbl\zynq_fsbl_bsp\ps7_cortexa9_0\include -c ${package_root}\build\boot\fsbl_hooks.c -o ${package_root}\build\out\boot\fsbl\fsbl_hooks.o
${vitis_install}\gnu\aarch32\nt\gcc-arm-none-eabi\bin\arm-none-eabi-gcc.exe -mcpu=cortex-a9 -mfpu=vfpv3 -mfloat-abi=hard -O2 -g -DFSBL_DEBUG_INFO -I${package_root}\build\out\boot\fsbl -I${package_root}\build\out\work\application\build\fsbl -I${package_root}\build\out\work\application\build\fsbl\zynq_fsbl_bsp\ps7_cortexa9_0\include -c ${vivado_install}\data\embeddedsw\lib\sw_apps\zynq_fsbl\src\fsbl_handoff.S -o ${package_root}\build\out\boot\fsbl\fsbl_handoff.o
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
