Ji-Shawn/Bird-detection-classification-tracking/build/pl/readme.md

# FPGA 硬件构建导览

本目录把 `src/pl/` 中的硬件源码和 IP 配置创建为 Vivado 工程，并提供展开检查与完整实现入口。硬件模块按采集、推理、音频特征、视频增强和显示等功能组织，详见[硬件源码导览](../../src/pl/readme.md)。ARM 双核与 BOOT 的构建步骤见[构建总览](../readme.md)。

```text
build/pl/
├── readme.md              # 本说明
├── create_project.tcl     # 创建工程并生成 IP
├── check_pl.tcl           # RTL 展开检查
├── build_pl.tcl           # 完整综合、实现和时序检查
└── av_system.tcl          # 历史连线参考
```

输入源码位于 `src/pl/`，生成工程和结果位于 `build/out/pl/`。`build/reports/pl_*.rpt`、`pl_pins.tsv` 和 `pl_clocks.tsv` 对应 `board/firmware/` 中的当前发布 PL；最新源码重建证据单独放在 `build/reports/rebuild_20261103/`。所有命令从仓库根目录运行。

工具版本为 Vivado 2023.2，器件为 `xc7z020clg400-2`。在仓库根目录执行：
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
