Ji-Shawn/Bird-detection-classification-tracking/build/receipts/arm_rebuild_20261103/boot_verify.txt

M51_PORTABLE_BOOT_PASS 8 partitions, 388 assets, paired ELF/PL runtime, ready seed
