Ji-Shawn/Bird-detection-classification-tracking/skill/zynq_pl_accel/assets/validation_record.md

# 验证记录模板

状态：待填写。复制后填入实际事实；未执行项写“未执行”，不预置 PASS。

## 对象与目标

| 字段 | 实际记录 |
| --- | --- |
| 日期、操作者、审核者 | 待填写 |
| 任务与具体现象 | 待填写 |
| 验证层级 | 主机测试 / C 仿真 / RTL 仿真 / 综合 / 实现 / 板卡实测，按实际选择 |
| 仓库版本、工作区改动 | 待填写 |
| bit / ELF / 模型 / 输入 SHA256 | 待填写；无该对象则写不适用 |
| 硬件与工具版本 | 待填写 |
| 环境条件 | 时钟、电源、传感器/连接、编译参数等，按实际记录 |
| 比较标准与设定依据 | 待填写，实际执行前确定 |

## 方法与执行

输入来源、格式、shape、dtype、布局、量化参数：待填写。

参考结果来源与生成方法：待填写。

可复制命令及工作目录：待填写。记录环境变量时只保留与复现有关且可公开的值。

修改前失败或基线：待填写。假设及本次唯一关键改动：待填写。

## 结果

| 项目 | 结果 | 原始文件/行号 |
| --- | --- | --- |
| 执行返回码、比较数量 | 未执行 | 待填写 |
| mismatch / 最大误差 / 首错索引 | 未测 | 待填写 |
| 时延/吞吐/资源/时序（按任务选择） | 未测 | 待填写 |
| 测量方法、预热、次数、统计方式 | 未填写 | 待填写 |
| 边界用例与反例 | 未执行 | 待填写 |

结论：通过 / 失败 / 未完成，依据待填写。

结论范围：待填写。未覆盖的功能、硬件状态或输入：待填写。

新产生的风险与下一项实验：待填写。原始日志与结果文件不得仅保留截图或模型摘要。
