Ji-Shawn/Bird-detection-classification-tracking/build/reports/rebuild_20261103/session_journal.txt

#-----------------------------------------------------------
# Vivado v2023.2 (64-bit)
# SW Build 4029153 on Fri Oct 13 20:14:34 MDT 2023
# IP Build 4028589 on Sat Oct 14 00:45:43 MDT 2023
# SharedData Build 4025554 on Tue Oct 10 17:18:54 MDT 2023
# Start of session at: Tue Nov  3 00:53:38 2026
# Process ID: 74256
# Current directory: ${package_root}
# Command line: vivado.exe -mode batch -source build/pl/build_pl.tcl -log build/out/pl_rebuild_20261103.log -journal build/out/pl_rebuild_20261103.jou
# Log file: ${package_root}/build/out/pl_rebuild_20261103.log
# Journal file: ${package_root}\build/out/pl_rebuild_20261103.jou
# Running On: ${host}, OS: Windows, CPU Frequency: 2419 MHz, CPU Physical cores: 16, Host memory: 34124 MB
#-----------------------------------------------------------
source build/pl/build_pl.tcl
