Ji-Shawn/Bird-detection-classification-tracking/(commit log)

2026-11-02 继续整理结构
    [layer_comparisons.csv]
2026-11-02 修改reports内容
2026-11-03 加入模型训练python代码
2026-11-03 移除历史版本
    [layer_comparisons.csv]
2026-11-03 修改报告
